sssamuelll/analog-modular-synthesizer/docs/superpowers/specs/2026-10-12-case-suelo-design.md

# El suelo: el case sin tabla

**Fecha**: 2026-10-12 · **Estado**: **firmado el 12-10** (versión 2, después de la junta) en el acta 4 (https://claude.ai/artifact/7PvsQ3aUfGtEdt7jj936kV):
- D-T1: **patas de 10, las de hoy**;
- D-T2: **los tornillos del suelo, desde abajo**;
- el papel: «Arma el plan».

**Implementado el 2026-10-12** en la rama `docs/case-suelo`, del plan
`docs/superpowers/plans/2026-10-12-case-suelo.md`. Las cifras del §3.2 y del §5
son las de la implementación (enmienda al final de cada sección).

**Sucede a**: la D-S4 del papel de la persiana (`2026-10-11-case-persiana-design.md` §8), firmada «quitar» el 11-10 a las 23:00 (ficha `quitar_tabla` del acta 3) ·
**Base**: `main` en `38d2ac4` (12-10): la persiana (#412), sus deudas (#419) y el aire con el plano neutro y la potencia de la v5 (#421) ·
**Se apoya en**:
- `2026-09-05-fuente-v5-ladrillo-design.md`: D-V1, la fuente afuera; §6.3, el suelo abierto; §7, *«No se reabre la cascada»*;
- `2026-09-03-fuente-v4-liston-design.md` §8, que le exige al case *«las dos placas dentro del mismo recinto de acero, porque R lleva 230 V y C lleva los tres tabs contra la pared»*;
- `2026-08-30-techo-macizo-chapas-empotradas`, por la nariz y el talón con su pie sobre la tabla;
- `2026-08-28-costilla-pletina`, por el anillo y sus tres M5 del canto inferior ·
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
