sssamuelll/analog-modular-synthesizer/docs/superpowers/specs/2026-10-11-case-persiana-design.md

# La persiana: el case sin piel, y el costado que respira

**Fecha**: 2026-10-11 · **Estado**: **firmado el 11-10** (versión 2, después de la junta): D-S1 en conversación (*«he decidido C · La persiana»*), y de D-S2 a D-S11 y el papel en el acta, todas en la opción recomendada. **D-S4 en espera**: Samuel la firmó con la nota *«pero ojo, estoy pensando en quitar la tabla, creo que es algo que nos puede beneficiar, que opinas tu?»* (§8). **Implementado el 2026-10-12** en la rama `feat/case-persiana`, del plan `docs/superpowers/plans/2026-10-11-case-persiana.md` (PR #412).
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
