sssamuelll/analog-modular-synthesizer/case/cad/kondor_lattice.png

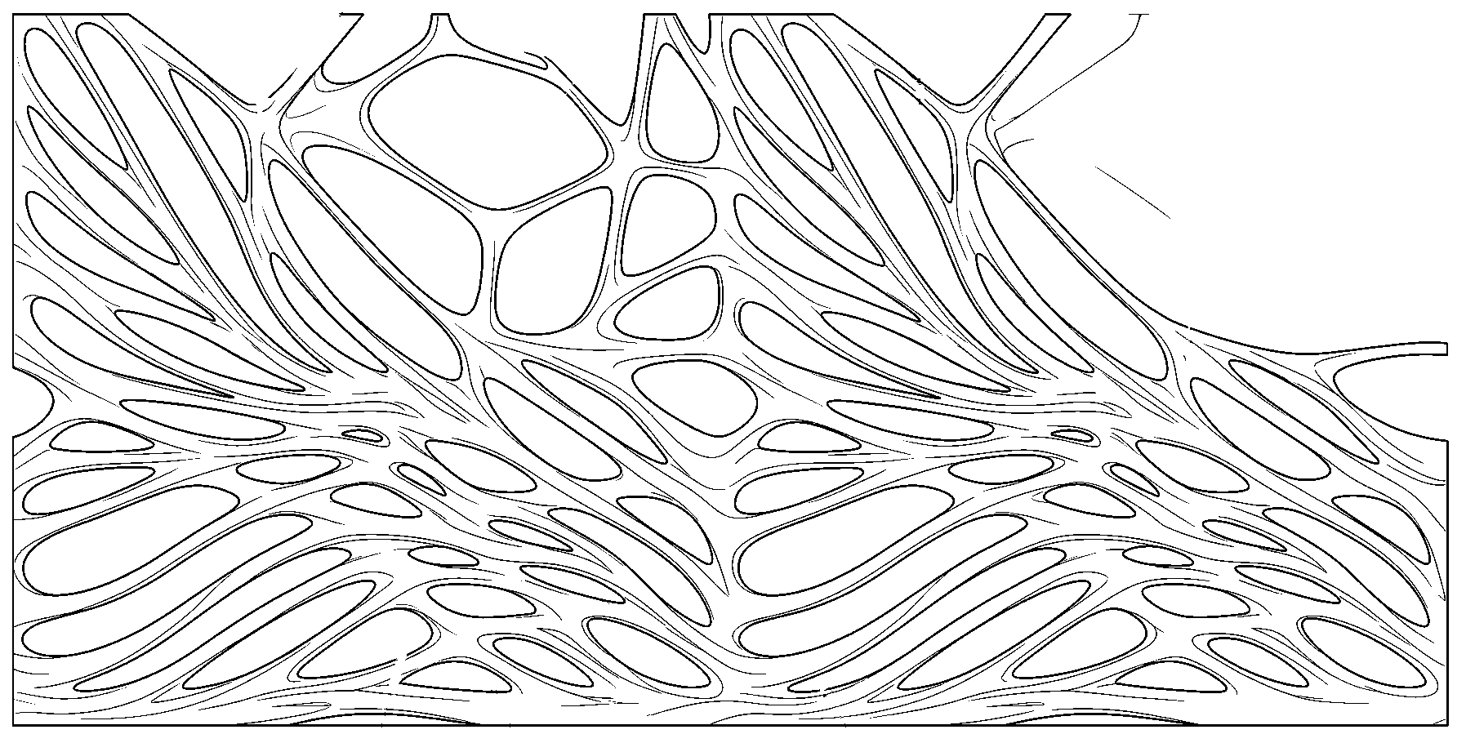
case/cad/kondor_lattice.png
