sssamuelll/analog-modular-synthesizer/case/renders/detalle-lateral.png

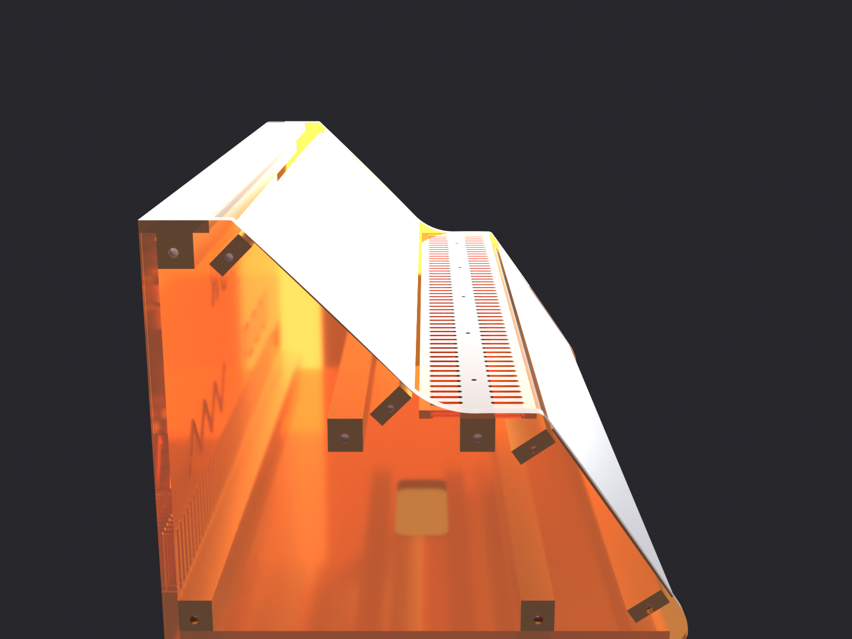
case/renders/detalle-lateral.png
