sssamuelll/analog-modular-synthesizer/case/renders/detalle-trasera-3q-izq.png

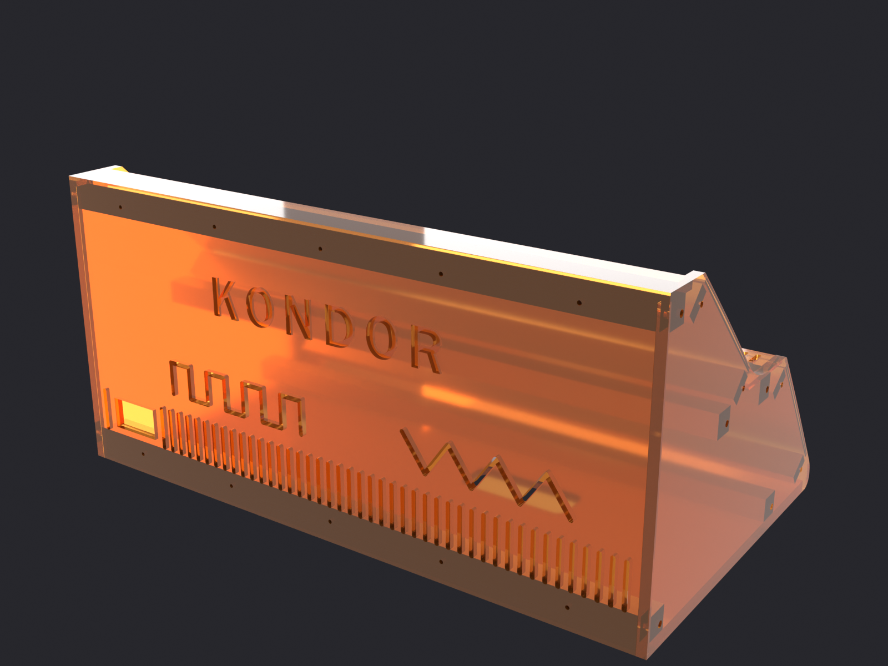
case/renders/detalle-trasera-3q-izq.png
