sssamuelll/analog-modular-synthesizer/case/renders/detalle-trasera-baja.png

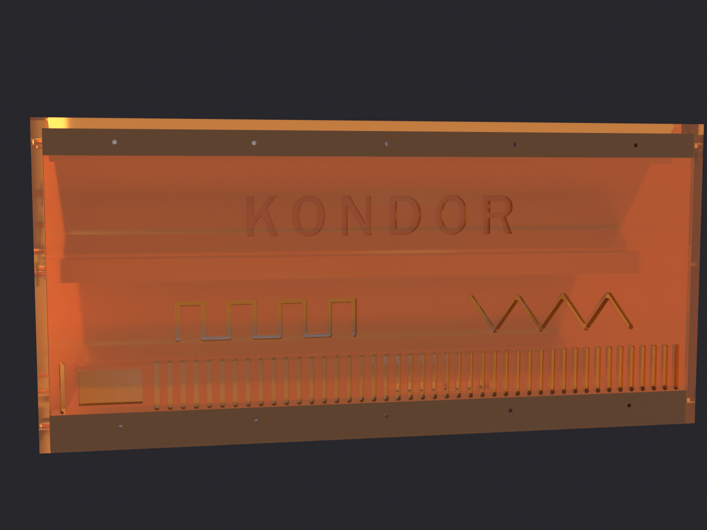
case/renders/detalle-trasera-baja.png
