sssamuelll/analog-modular-synthesizer/case/renders/detalle-trasera-centro.png

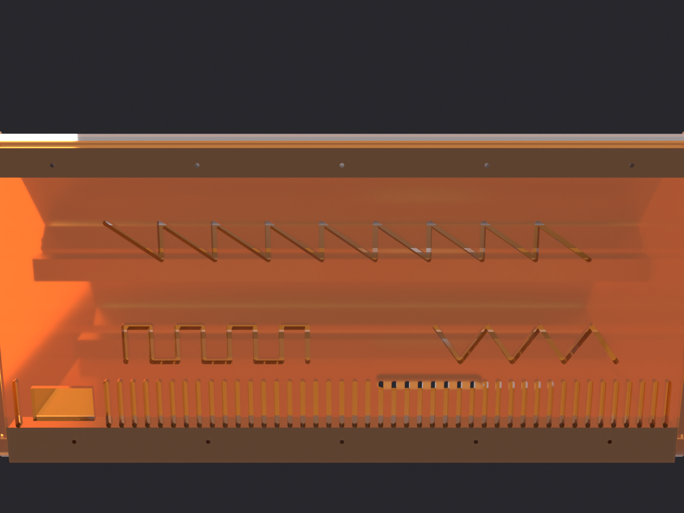
case/renders/detalle-trasera-centro.png
