sssamuelll/analog-modular-synthesizer/case/renders/detalle-trasera-elevada.png

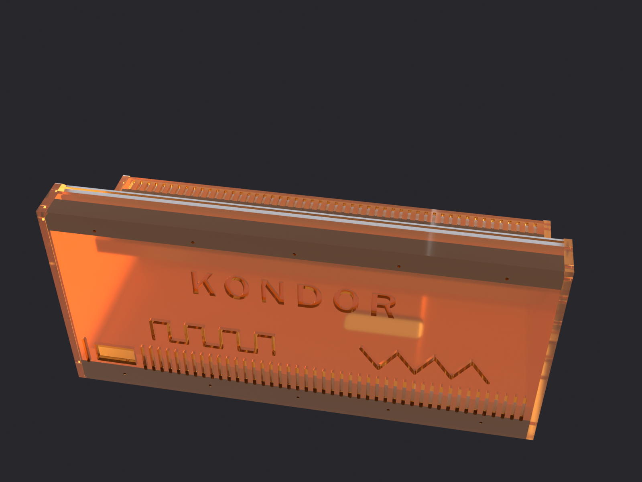
case/renders/detalle-trasera-elevada.png
