sssamuelll/analog-modular-synthesizer/case/renders/propuesta-diseno-2026-08-16.png

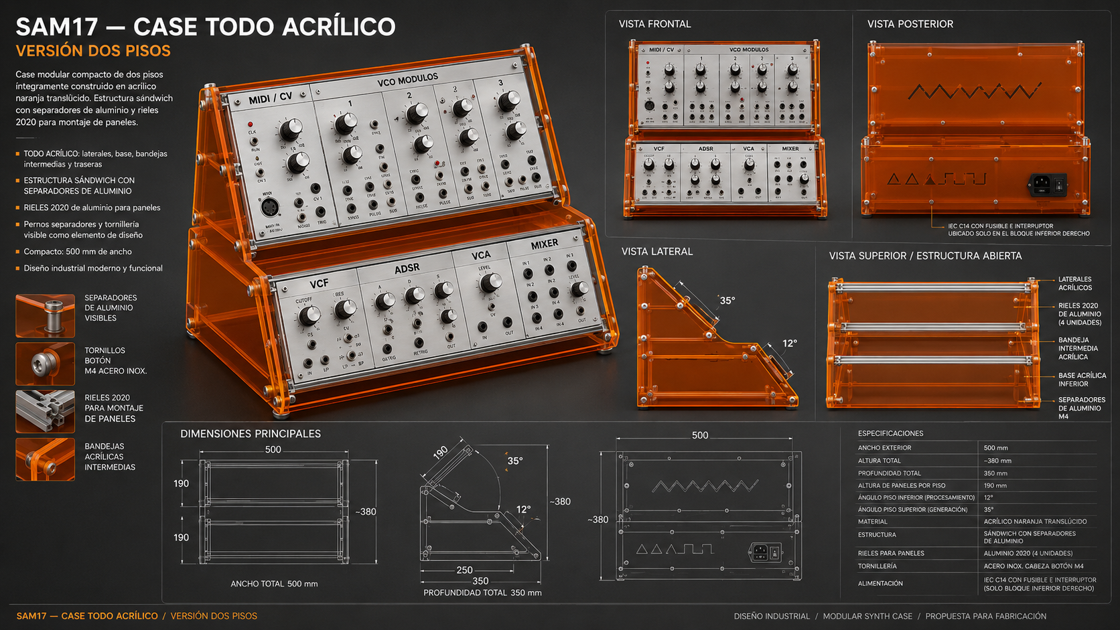
case/renders/propuesta-diseno-2026-08-16.png
