sssamuelll/analog-modular-synthesizer/case/renders/sam17-case-A.png

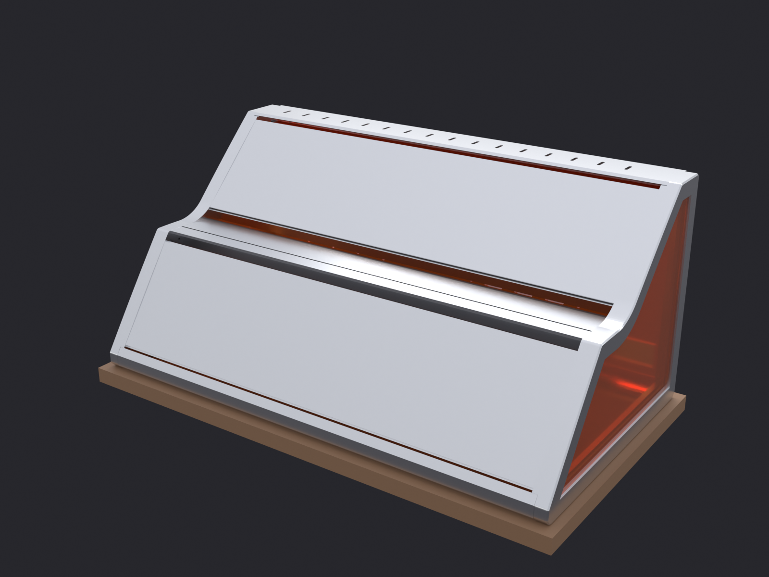
case/renders/sam17-case-A.png
