sssamuelll/analog-modular-synthesizer/case/renders/sam17-case-ahumado-trasera.png

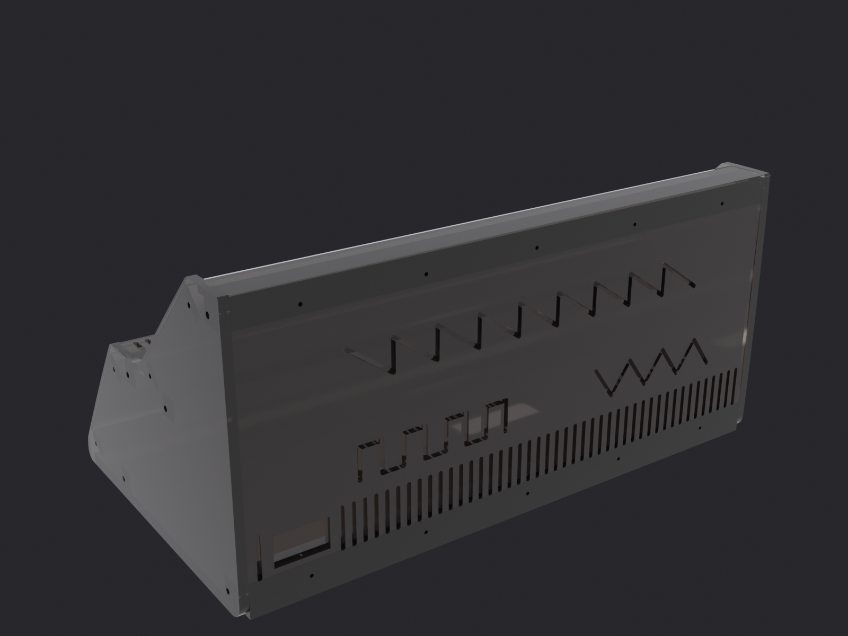
case/renders/sam17-case-ahumado-trasera.png
