sssamuelll/analog-modular-synthesizer/case/renders/sam17-case-ahumado.png

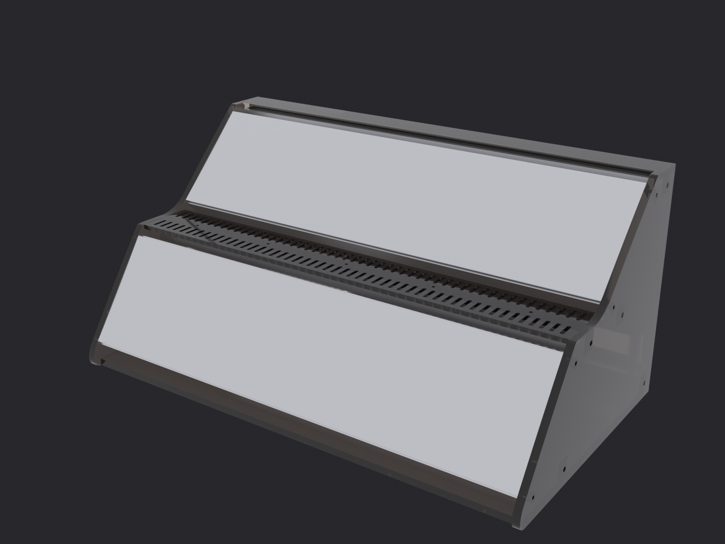
case/renders/sam17-case-ahumado.png
