sssamuelll/analog-modular-synthesizer/case/renders/sam17-case-trasera-A.png

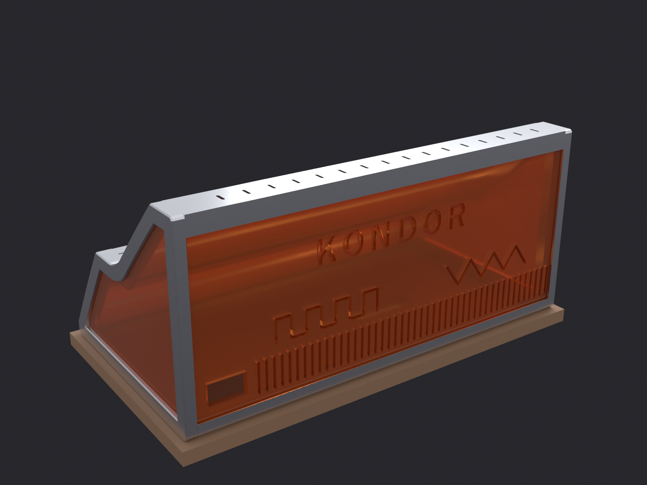
case/renders/sam17-case-trasera-A.png
