sssamuelll/analog-modular-synthesizer/case/renders/sam17-persiana-costado.png

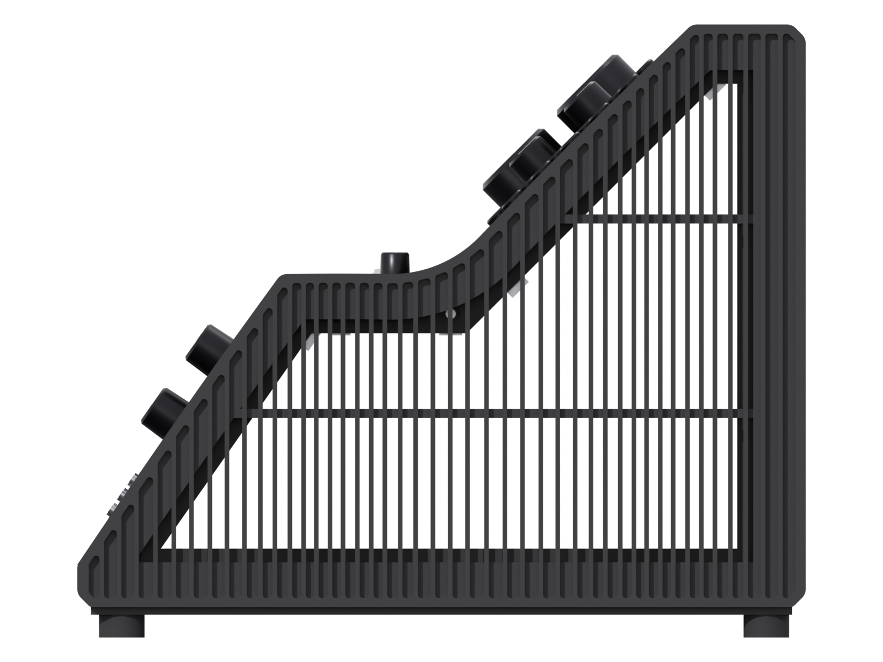
case/renders/sam17-persiana-costado.png
