sssamuelll/analog-modular-synthesizer/case/renders/sam17-persiana-lado.png

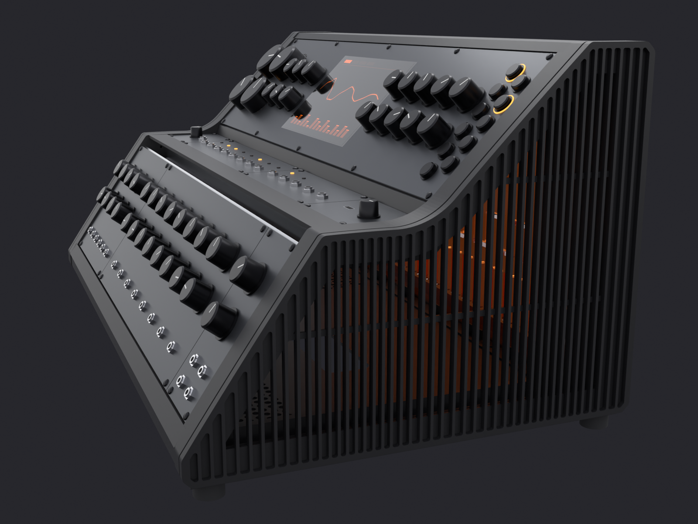
case/renders/sam17-persiana-lado.png
