sssamuelll/analog-modular-synthesizer/case/renders/sam17-persiana-noche.png

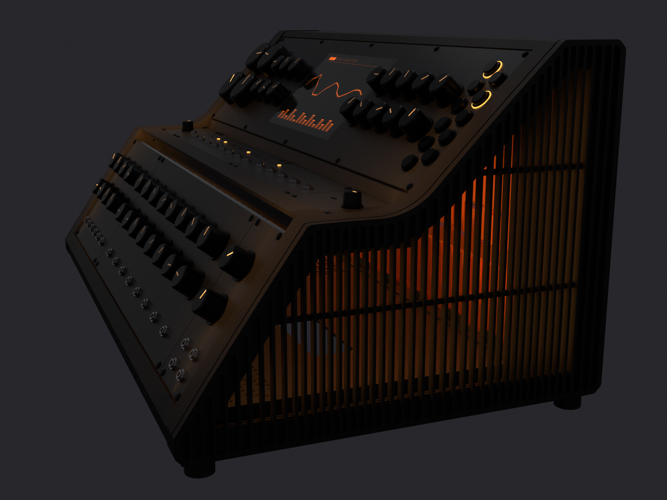
case/renders/sam17-persiana-noche.png
