sssamuelll/analog-modular-synthesizer/case/renders/sam17-persiana-trasera.png

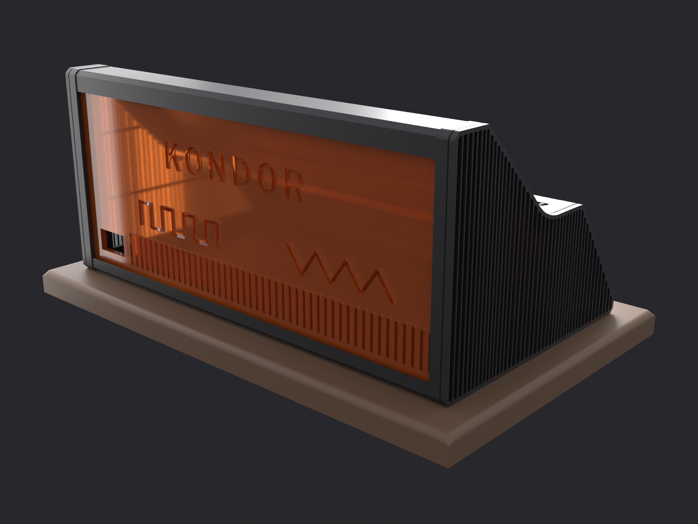
case/renders/sam17-persiana-trasera.png
