sssamuelll/analog-modular-synthesizer/case/renders/sam17-piel-cachete.png

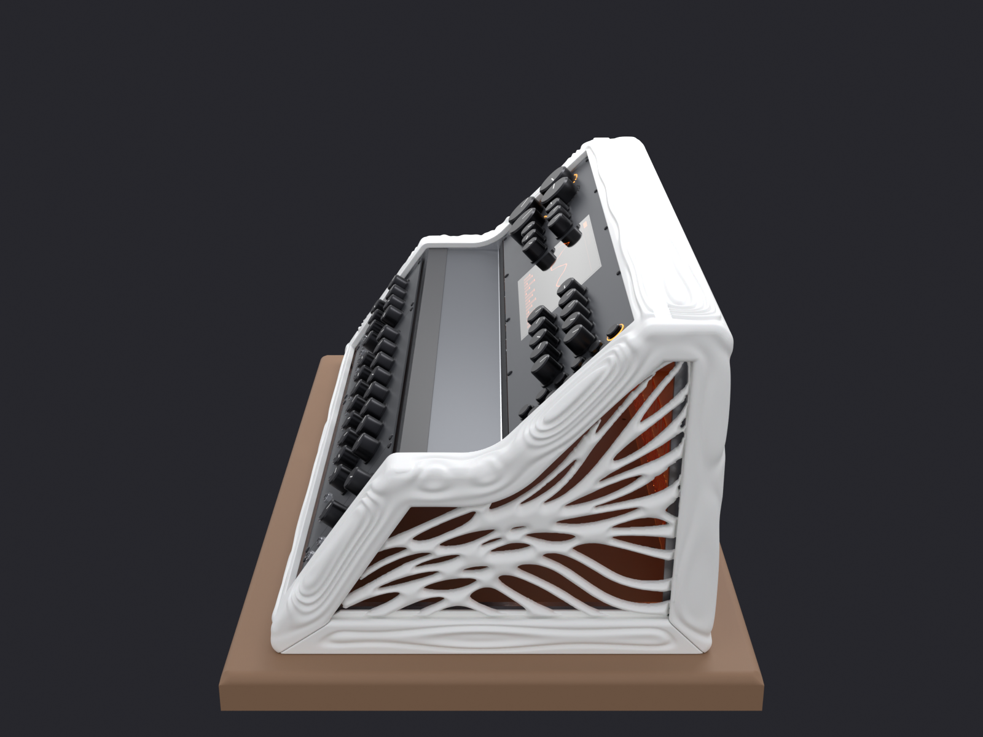
case/renders/sam17-piel-cachete.png
