sssamuelll/analog-modular-synthesizer/case/renders/sam17-piel-lado.png

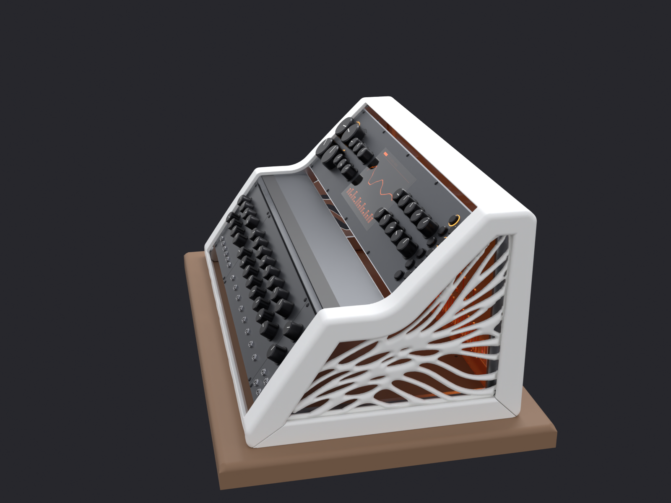
case/renders/sam17-piel-lado.png
