sssamuelll/analog-modular-synthesizer/case/renders/sam17-piel-trasera.png

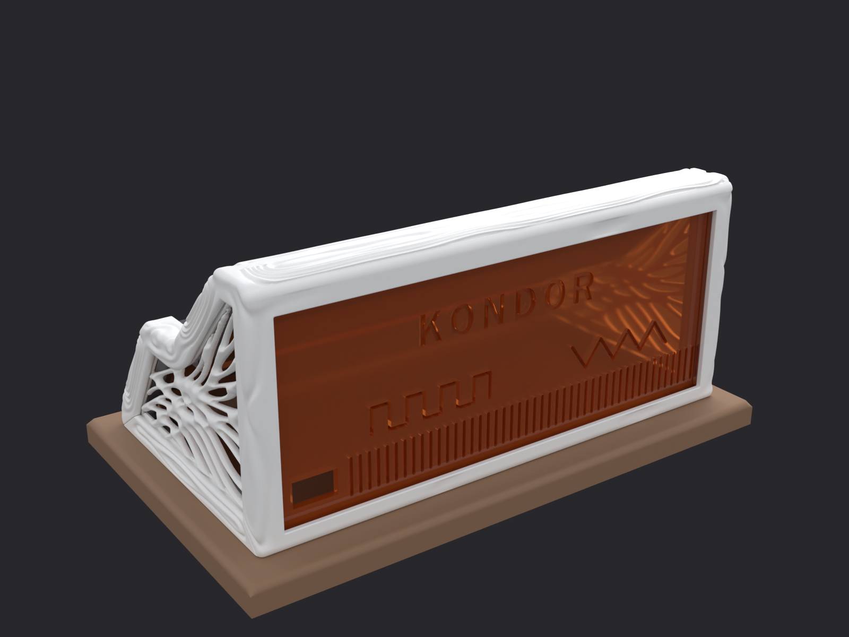
case/renders/sam17-piel-trasera.png
