sssamuelll/analog-modular-synthesizer/case/renders/sam17-piel.png

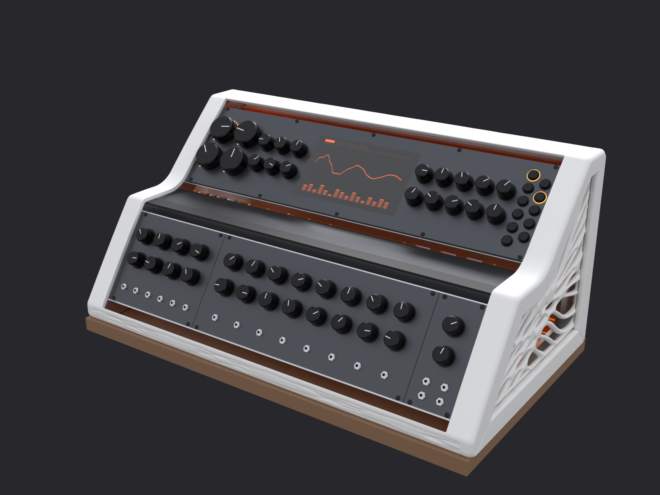
case/renders/sam17-piel.png
