sssamuelll/analog-modular-synthesizer/docs/images/case-piel-organica/concepto-1-ambar.jpg

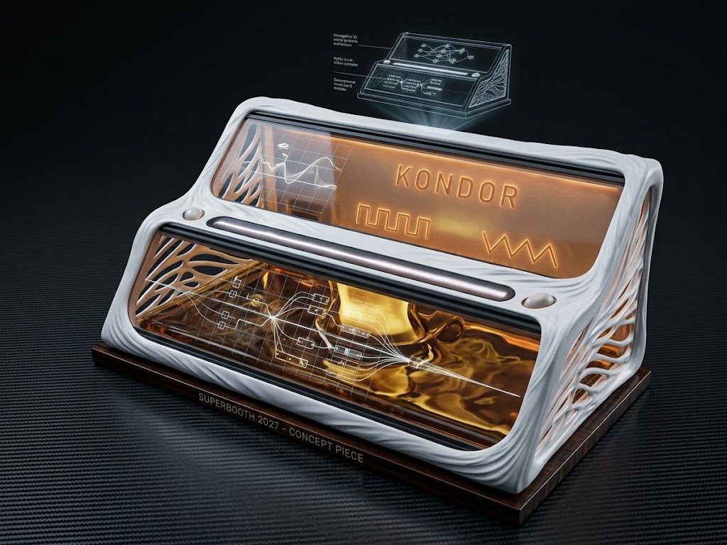
docs/images/case-piel-organica/concepto-1-ambar.jpg
