sssamuelll/analog-modular-synthesizer/docs/images/case-piel-organica/concepto-2-paneles.jpg

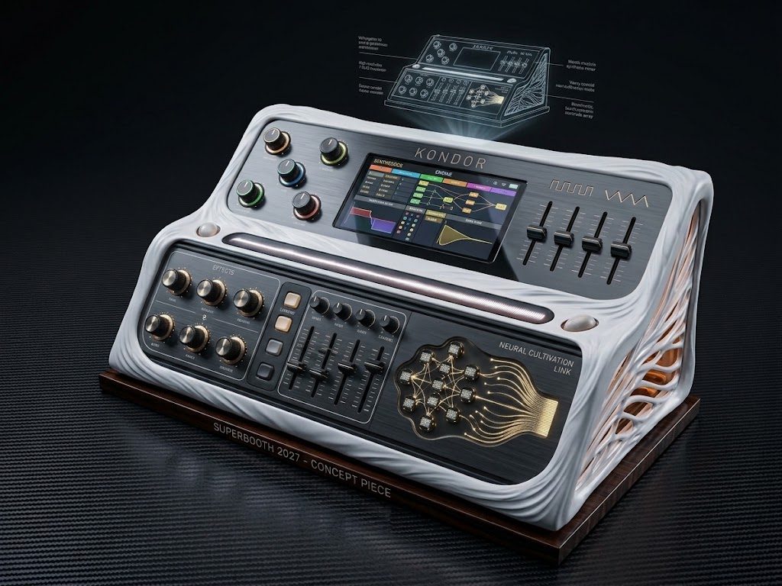
docs/images/case-piel-organica/concepto-2-paneles.jpg
