sssamuelll/analog-modular-synthesizer/docs/images/case-piel-organica/concepto-3-trasera.jpg

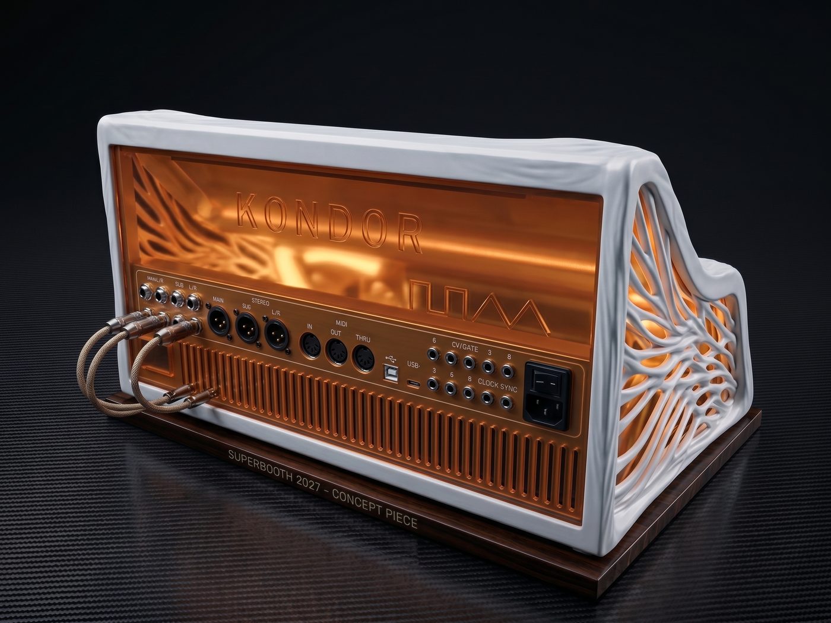
docs/images/case-piel-organica/concepto-3-trasera.jpg
