sssamuelll/analog-modular-synthesizer/docs/images/case-piel-organica/concepto-4-despiece.jpg

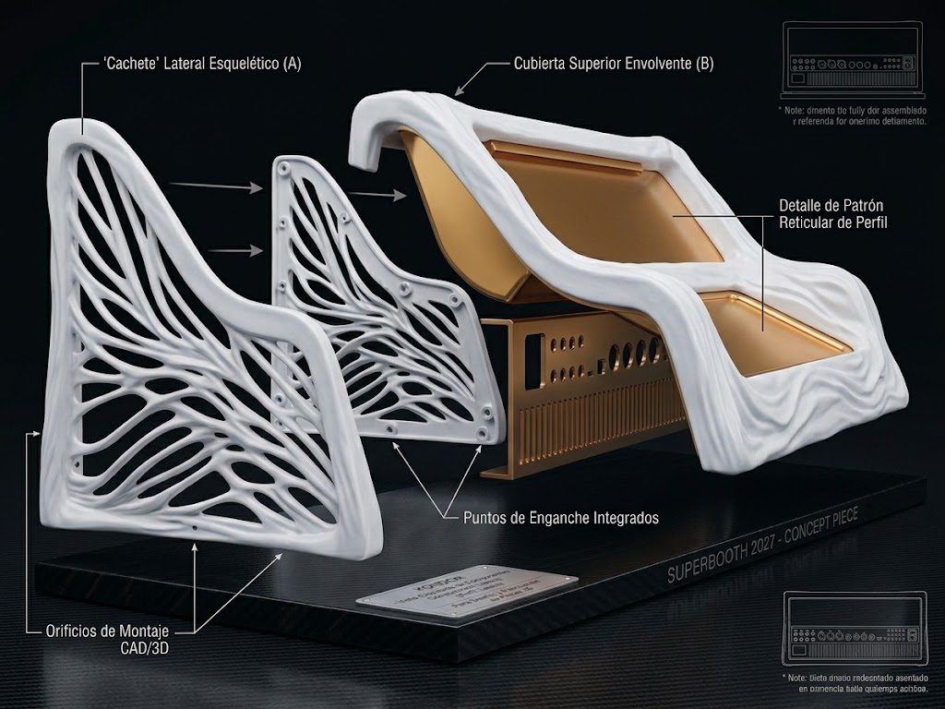
docs/images/case-piel-organica/concepto-4-despiece.jpg
