sssamuelll/analog-modular-synthesizer/docs/images/case-piel-organica/concepto-6-celosia-2d.jpg

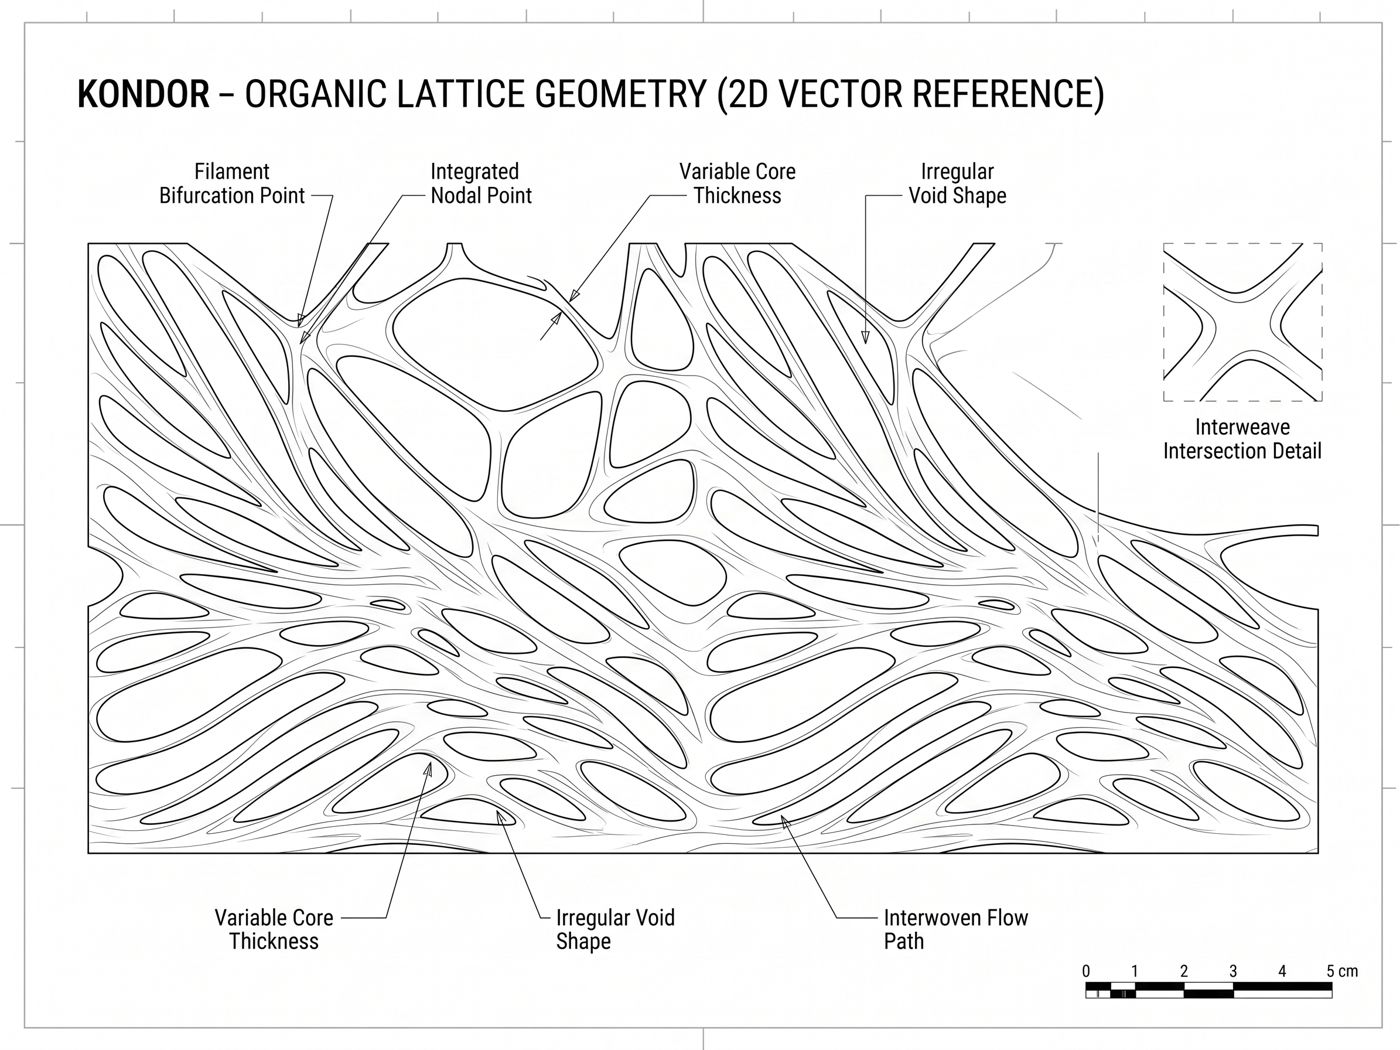
docs/images/case-piel-organica/concepto-6-celosia-2d.jpg
