sssamuelll/analog-modular-synthesizer/hardware/01-power-supply/pcb/sam17-power-3d-iso.png

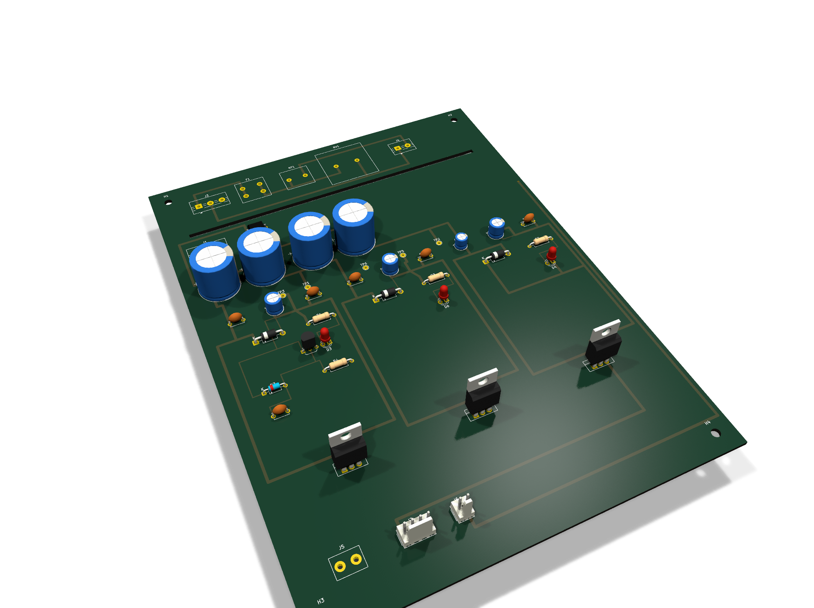
hardware/01-power-supply/pcb/sam17-power-3d-iso.png
