sssamuelll/analog-modular-synthesizer/hardware/03-vco/pcb/sam17-vco-3d-iso.png

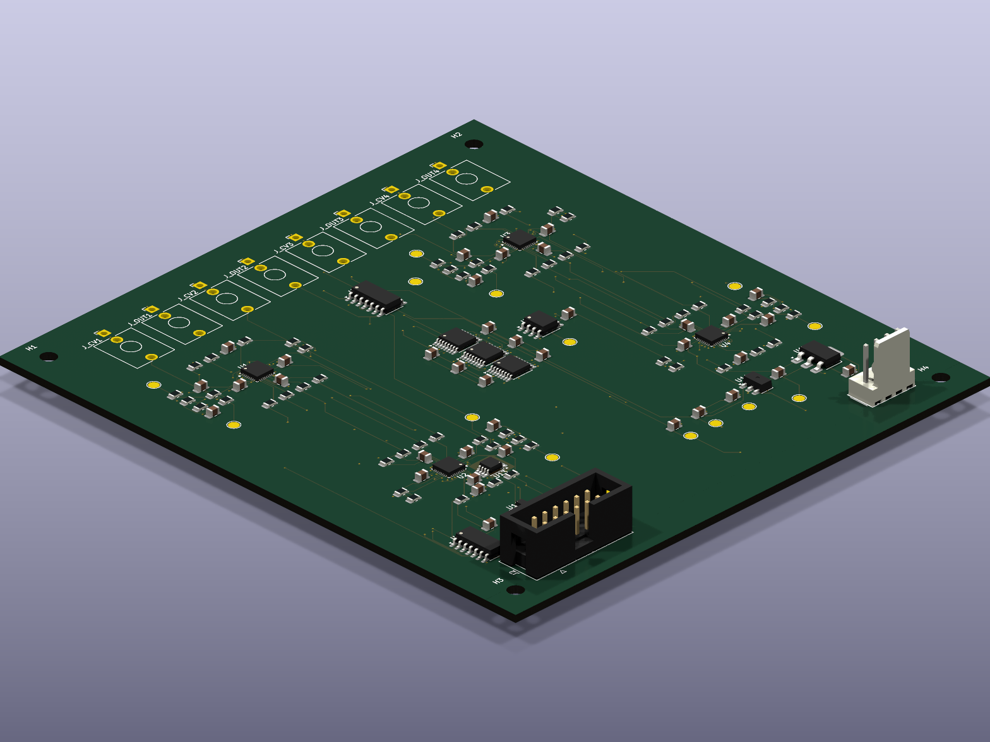
hardware/03-vco/pcb/sam17-vco-3d-iso.png
