sssamuelll/analog-modular-synthesizer/hardware/01-power-supply/v5/absmax.csv

victima | riel | fuente_fallo | v_pico_sin_tope_v | v_pico_con_tope_v | v_absmax_v | protector | hoja_victima | hoja_protector
U1 LT1963A (IN) | crudo +15.5V | THN 20-2413WI OVP (24.6V) o puente 36V | 38.59 | 18.11 | 20.0 | TI TPS26631 antes del LC (<=16.92V 14us) + Bourns SMBJ16A en U1 IN | docs/reference/datasheets/lt1963a-rev-g-2021-02.pdf p.2 | docs/reference/datasheets/tps2663.pdf p.6-8 + docs/reference/datasheets/bourns_smbj.pdf p.2
U2 LT3015 (IN) | crudo -15.5V | THN 20-2413WI OVP (-24.6V) | 24.60 | 24.60 | 33.0 | Margen nativo +-33V + Schottky inverso OUT-IN >= -0.3V | docs/reference/datasheets/lt3015-rev-b.pdf p.2 | docs/reference/datasheets/lt3015-rev-b.pdf p.2 Nota 10
U4,U5 LT3045 (IN) | cascada +13.1V | Fallo doble (THN+ en OVP y U1 en corto) | 24.60 | 18.11 | 22.0 | Tope M3 aguas arriba (TPS26631 + SMBJ16A) | docs/reference/datasheets/lt3045-rev-d.pdf p.2 | docs/reference/datasheets/tps2663.pdf p.6-8
U6,U7 LT3094 (IN) | cascada -12.9V | THN 20-2413WI- en OVP (-24.6V) con U2 regulando | 24.60 | 13.53 | 22.0 | Regulacion de U2 LT3015 (maximo del trim R7+RV3 sobre R8) | docs/reference/datasheets/lt3094-rev-b.pdf p.2 | docs/reference/datasheets/lt3015-rev-b.pdf p.1
U18 TPS709 (IN) | +24V_LDO | Transitorio de entrada recortado por D1 SMBJ26CA (V_C 42.1V) | 42.10 | 26.35 | 32.0 | R64 1k + D2 BZT52C24 (Vz max 25.6V y Zzt 70 ohm a 5 mA) | docs/reference/datasheets/tps709.pdf p.4 | docs/reference/datasheets/bourns_smbj.pdf p.2 + docs/reference/datasheets/diodes_bzt52.pdf p.2
Invitados rack +12V | rack+12 | THN 30-2422WI OVP (16.56V max) | 16.56 | 14.10 | 16.0 | Crowbar D-F6 (TL431BI -> MMBT3906 -> BT151-500R a 13.80V +-0.3V) | electrolitico 16V en modulo invitado | docs/reference/datasheets/nxp-bt151-500r.pdf p.2 + docs/reference/datasheets/tl431.pdf p.5
Invitados rack -12V | rack-12 | THN 30-2422WI OVP (16.56V max) | 16.56 | 14.10 | 16.0 | Crowbar D-F6 (TL431BI -> MMBT3906 -> BT151-500R a 13.80V +-0.3V) | electrolitico 16V en modulo invitado | docs/reference/datasheets/nxp-bt151-500r.pdf p.2 + docs/reference/datasheets/tl431.pdf p.5
Invitados rack +5V | rack+5 | Convertidor +5V rack en fallo | 6.75 | 6.11 | 6.3 | Crowbar D-F6 (TL431BI -> MMBT3906 -> BT151-500R a 5.81V +-0.3V) + Bourns SF-1206F | electrolitico 6.3V en modulo invitado | docs/reference/datasheets/nxp-bt151-500r.pdf p.2 + docs/reference/datasheets/bourns_sf1206f.pdf p.1
Cerebro digital +5V | digital+5 | URB2405YMD-20WR3 OVP (8.0V max) | 8.00 | 5.96 | 6.3 | Crowbar D-F6 digital (TL431BI -> MMBT3906 -> BT151-500R a 5.66V +-0.3V) | entrada 5V modulo 2 (electrolitico 6.3V / buck local) | docs/reference/datasheets/mornsun_urb_ymd20wr3.pdf p.2 + docs/reference/datasheets/tl431.pdf p.5
