sssamuelll/analog-modular-synthesizer/software/nucleo/fw/carga_j2.csv

fecha | firmware | placa | f_cpu_hz | cache | ciclos_por_giro | hilo_libre_permil | ranuras | periodo_us | transporte | regimen_cache | cuerpos_por_giro
2026-10-16 | b9f6d7d | NUCLEO-N657X0-Q | 64000000 | no | 21558 | 198 | 1 | 125 | ejecutor | caliente
2026-10-17 | 4b97dcf | NUCLEO-N657X0-Q | 64000000 | no | 20160 | 685 | 1 | 1000 | ejecutor | caliente
2026-10-17 | 4b97dcf | NUCLEO-N657X0-Q | 64000000 | icache | 16112 | 748 | 1 | 1000 | ejecutor | caliente
2026-10-20 | 1d62576 | NUCLEO-N657X0-Q | 800000000 | icache+dcache-mpu | 2354 |  | 3 | 125 | tic | caliente | 2307
2026-10-20 | 1d62576 | NUCLEO-N657X0-Q | 800000000 | icache+dcache-mpu | 2452 |  | 3 | 125 | tic | fria | 2353
2026-10-20 | 646a97a | NUCLEO-N657X0-Q | 800000000 | icache+dcache-mpu | 2354 |  | 3 | 125 | tic | caliente | 2307
2026-10-20 | 646a97a | NUCLEO-N657X0-Q | 800000000 | icache+dcache-mpu | 2419 |  | 3 | 125 | tic | fria | 2321
2026-10-20 | bba1b35 | NUCLEO-N657X0-Q | 800000000 | icache+dcache-mpu | 2331 |  | 3 | 125 | tic | caliente | 2285
2026-10-20 | bba1b35 | NUCLEO-N657X0-Q | 800000000 | icache+dcache-mpu | 2398 |  | 3 | 125 | tic | fria | 2300
