sssamuelll/analog-modular-synthesizer/case/renders/build/assembly_aluminio.stl

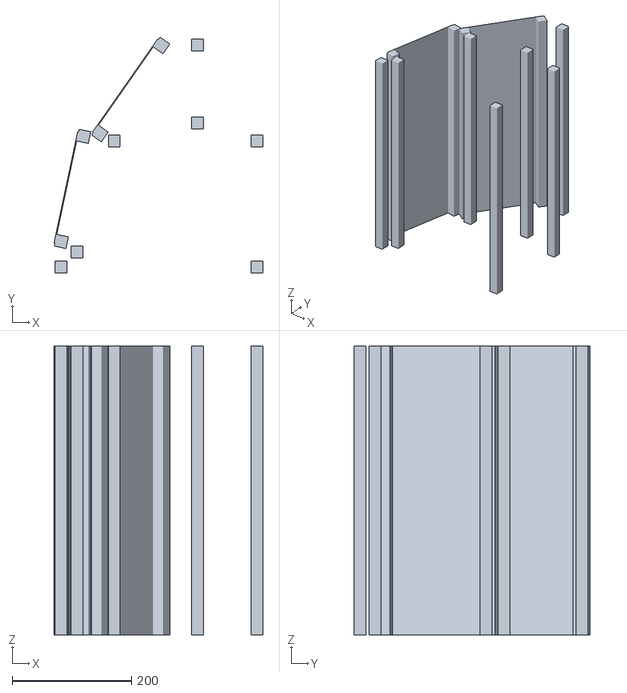
[picture p28: CAD file, 2026-08-16]
case/renders/build/assembly_aluminio.stl
350.0 x 394.7 x 484.0
