sssamuelll/analog-modular-synthesizer/case/plans/bandeja_base_2d.dxf

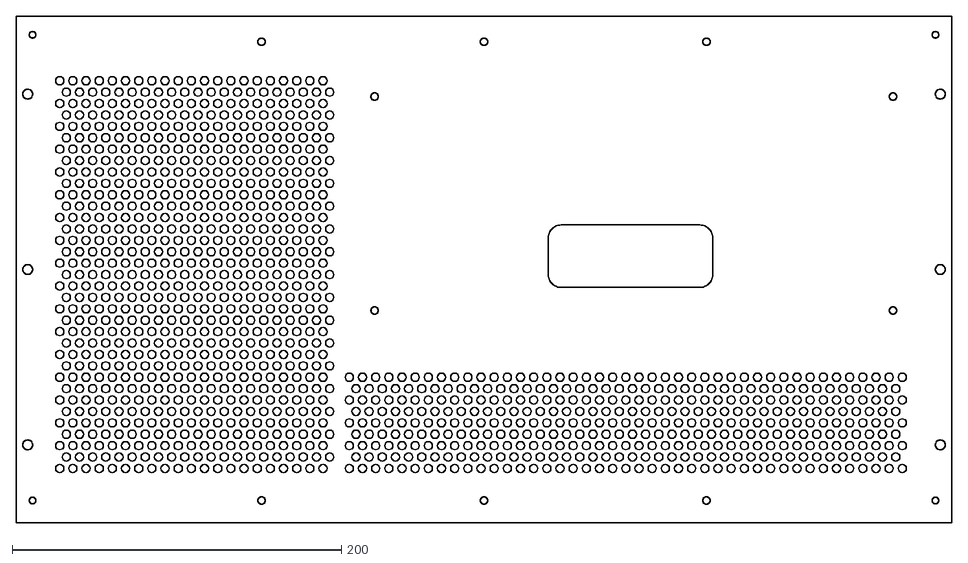
[picture p29: CAD file, 2026-10-12]
case/plans/bandeja_base_2d.dxf
568.6 x 307.8
