sssamuelll/analog-modular-synthesizer/case/plans/marco_ventana_2d.dxf

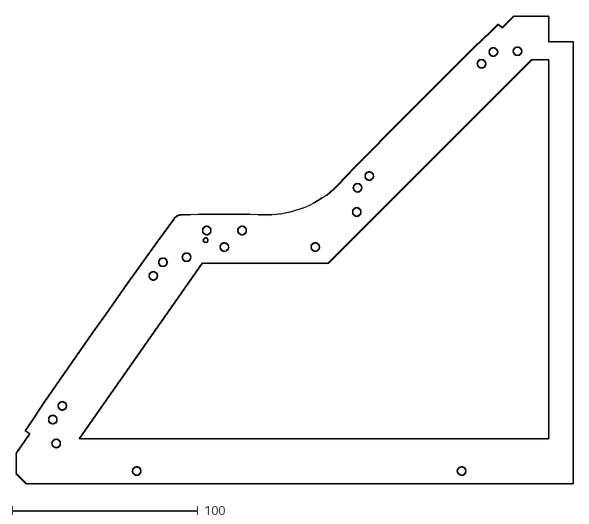
[picture p30: CAD file, 2026-10-12]
case/plans/marco_ventana_2d.dxf
300.1 x 251.9
