sssamuelll/analog-modular-synthesizer/case/plans/persiana_2d.dxf

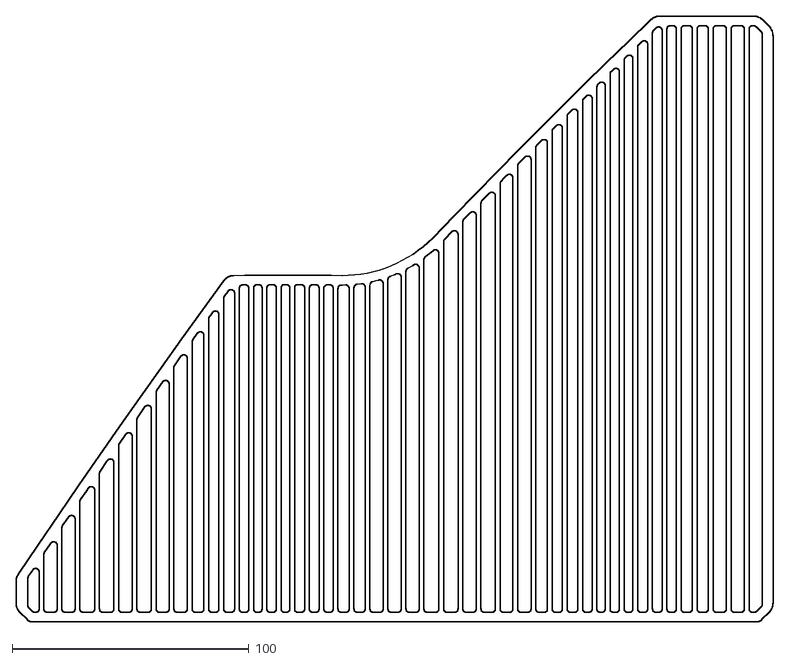
[picture p31: CAD file, 2026-10-12]
case/plans/persiana_2d.dxf
319.8 x 255.9
