sssamuelll/analog-modular-synthesizer/case/plans/costilla_dorso_2d.dxf

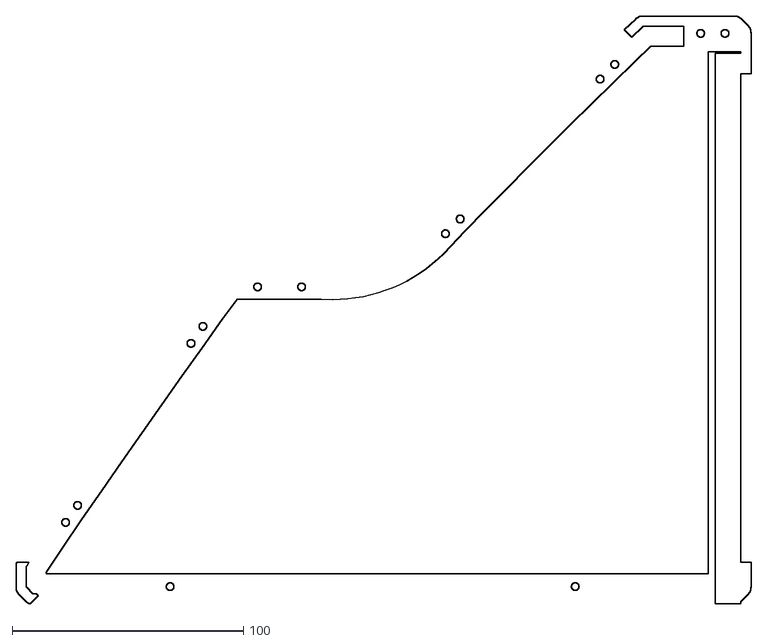
[picture p32: CAD file, 2026-10-12]
case/plans/costilla_dorso_2d.dxf
317.8 x 254.2
