sssamuelll/analog-modular-synthesizer/case/plans/persiana_dorso_2d.dxf

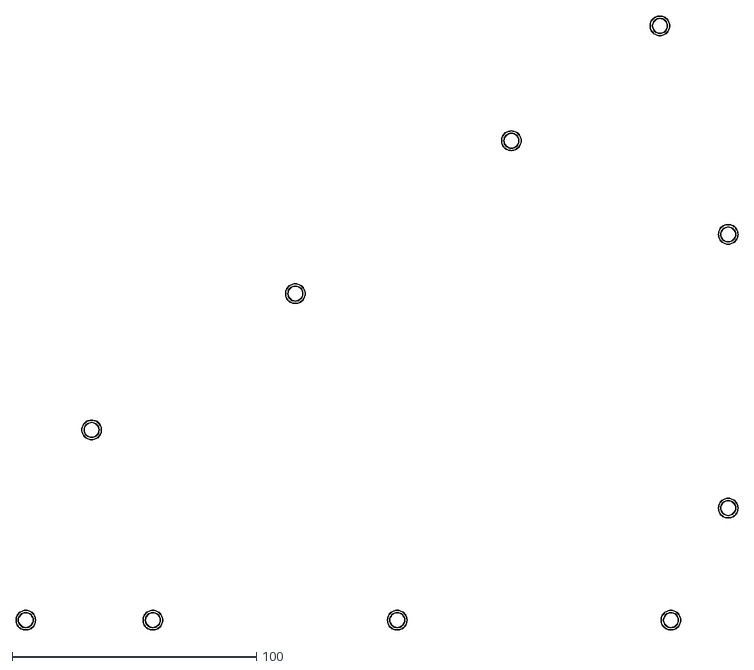
[picture p33: CAD file, 2026-10-12]
case/plans/persiana_dorso_2d.dxf
295.4 x 251.2
