sssamuelll/analog-modular-synthesizer/case/plans/nariz_2d.dxf

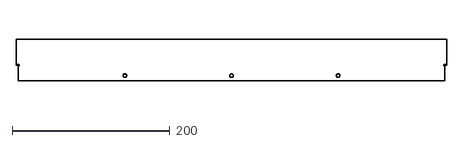
[picture p34: CAD file, 2026-10-12]
case/plans/nariz_2d.dxf
545.6 x 53.1
