sssamuelll/analog-modular-synthesizer/case/plans/miembro_alto_2d.dxf

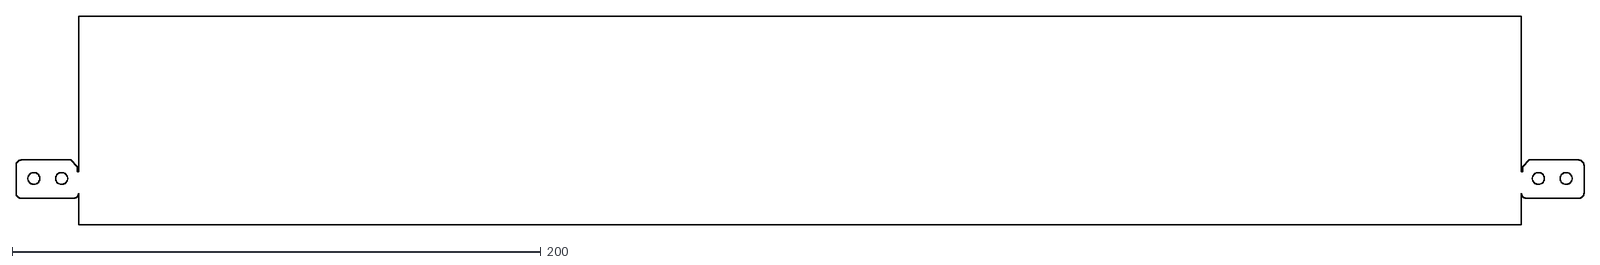
[picture p35: CAD file, 2026-10-12]
case/plans/miembro_alto_2d.dxf
593.0 x 78.9
