sssamuelll/analog-modular-synthesizer/case/plans/tapa_valle_2d.dxf

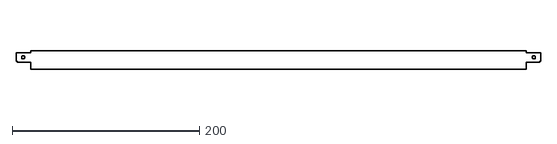
[picture p36: CAD file, 2026-09-01]
case/plans/tapa_valle_2d.dxf
560.0 x 20.0
