sssamuelll/analog-modular-synthesizer/case/plans/costado_2d.dxf

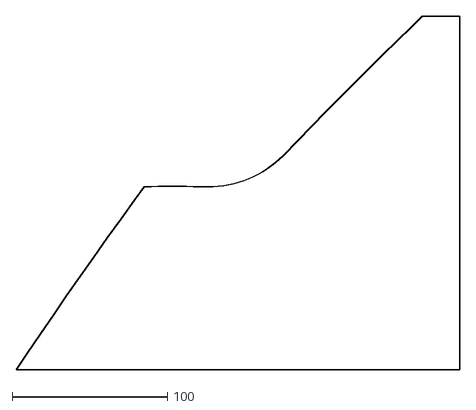
[picture p37: CAD file, 2026-09-01]
case/plans/costado_2d.dxf
285.3 x 227.2
