sssamuelll/analog-modular-synthesizer/case/plans/piel_trasera_2d.dxf

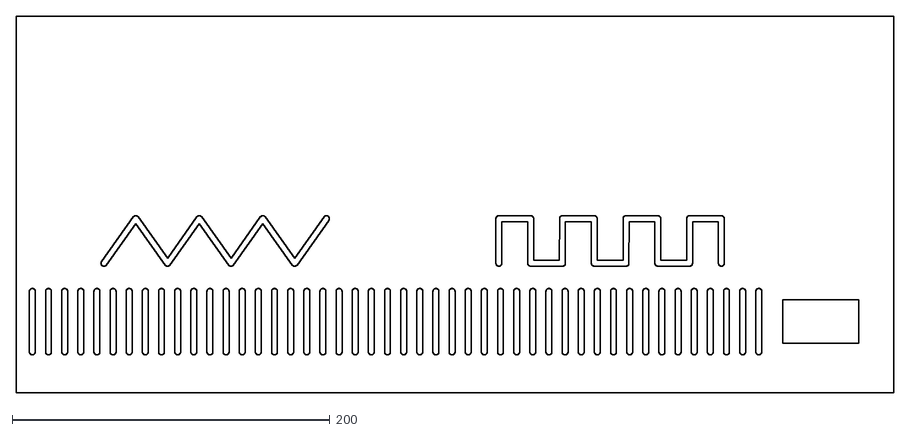
[picture p38: CAD file, 2026-08-31]
case/plans/piel_trasera_2d.dxf
552.3 x 237.2
