sssamuelll/analog-modular-synthesizer/case/plans/costilla_2d.dxf

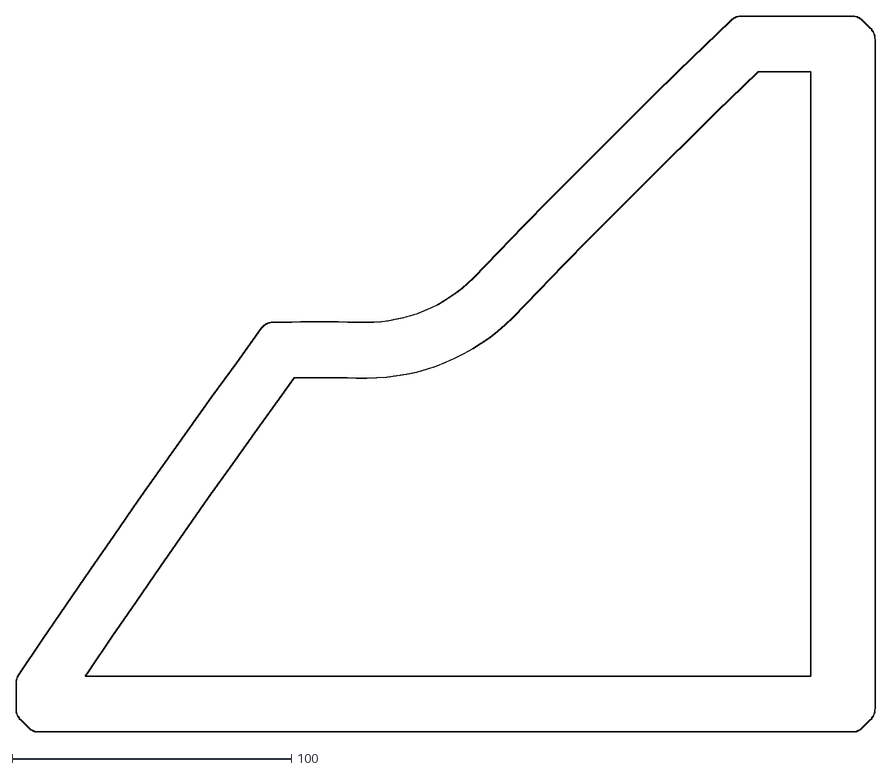
[picture p39: CAD file, 2026-08-31]
case/plans/costilla_2d.dxf
307.4 x 256.2
