sssamuelll/analog-modular-synthesizer/case/plans/kondor_cajeado_2d.dxf

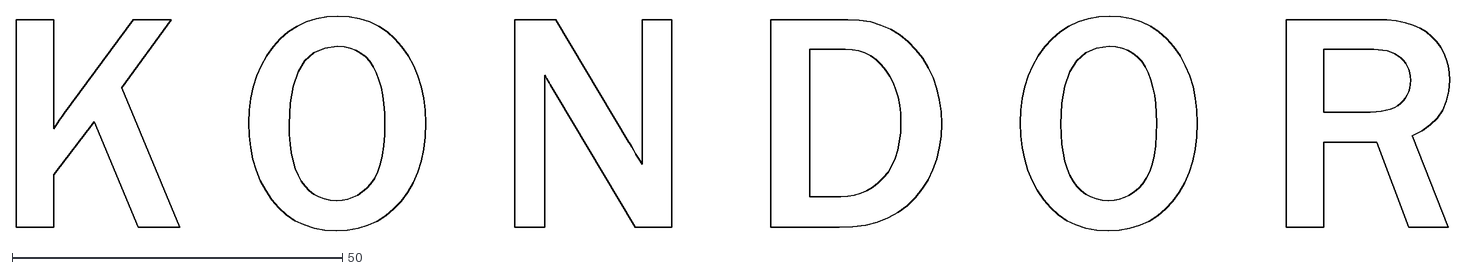
[picture p40: CAD file, 2026-08-30]
case/plans/kondor_cajeado_2d.dxf
216.9 x 32.4
