sssamuelll/analog-modular-synthesizer/case/plans/placa_cara_sup_2d.dxf

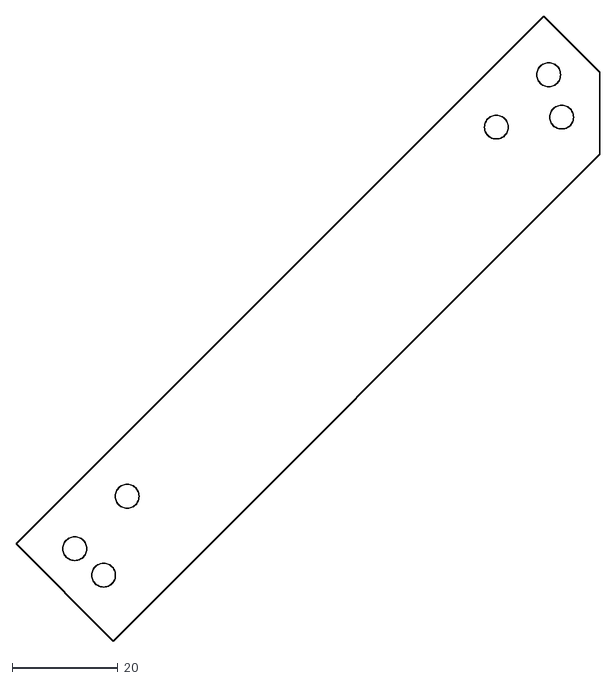
[picture p41: CAD file, 2026-08-29]
case/plans/placa_cara_sup_2d.dxf
110.4 x 118.2
