sssamuelll/analog-modular-synthesizer/case/plans/miembro_bajo_2d.dxf

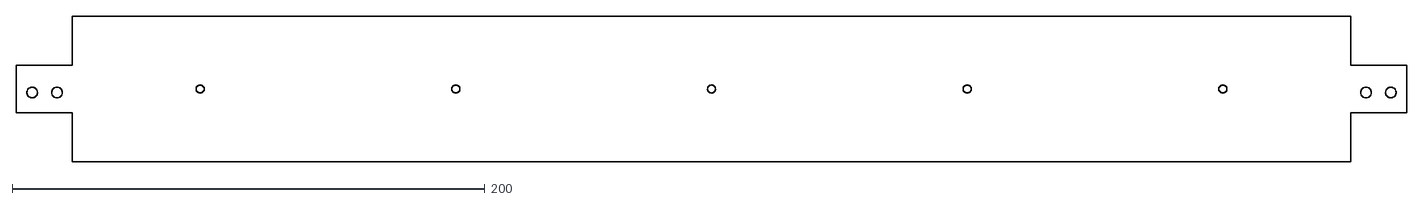
[picture p42: CAD file, 2026-08-29]
case/plans/miembro_bajo_2d.dxf
588.0 x 61.4
