sssamuelll/analog-modular-synthesizer/case/plans/escuadra_trasera_2d.dxf

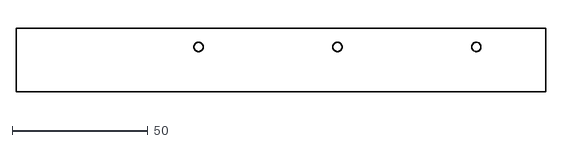
[picture p43: CAD file, 2026-08-29]
case/plans/escuadra_trasera_2d.dxf
194.7 x 23.2
