sssamuelll/analog-modular-synthesizer/case/plans/marco_trasera_sup_2d.dxf

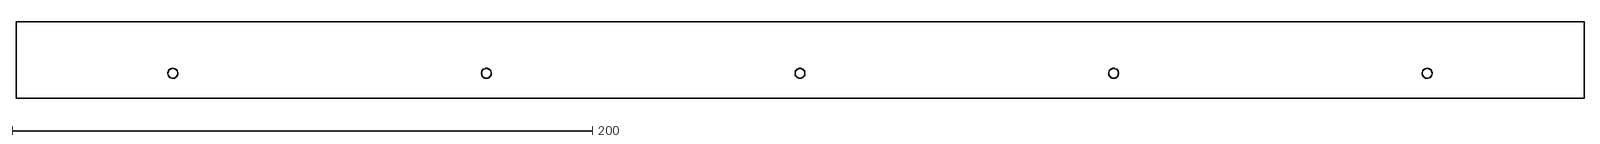
[picture p44: CAD file, 2026-08-29]
case/plans/marco_trasera_sup_2d.dxf
540.3 x 26.2
