sssamuelll/analog-modular-synthesizer/case/plans/chasis_cuerpo_2d.dxf

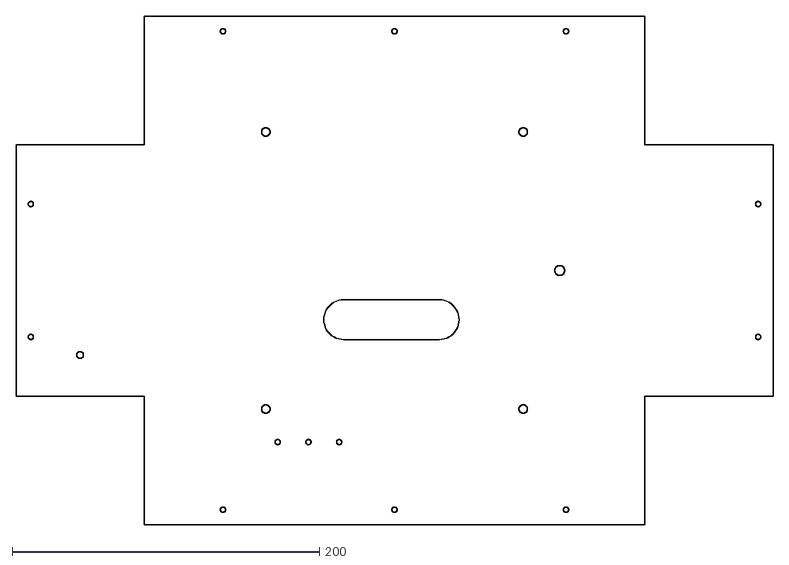
[picture p45: CAD file, 2026-08-21]
case/plans/chasis_cuerpo_2d.dxf
492.7 x 330.7
