sssamuelll/analog-modular-synthesizer/case/plans/chasis_tapa_2d.dxf

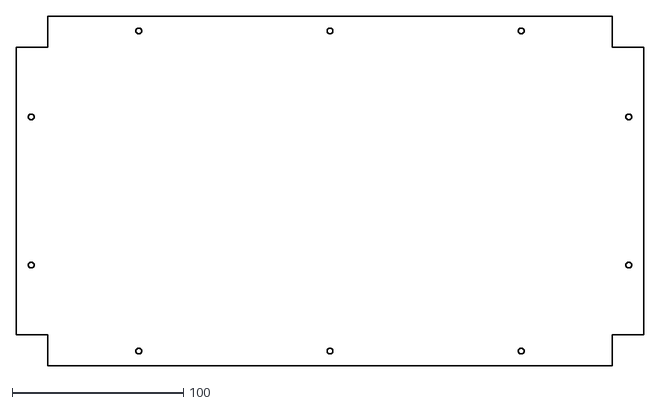
[picture p46: CAD file, 2026-08-19]
case/plans/chasis_tapa_2d.dxf
366.3 x 204.3
