sssamuelll/analog-modular-synthesizer/case/plans/piel_inferior_2d.dxf

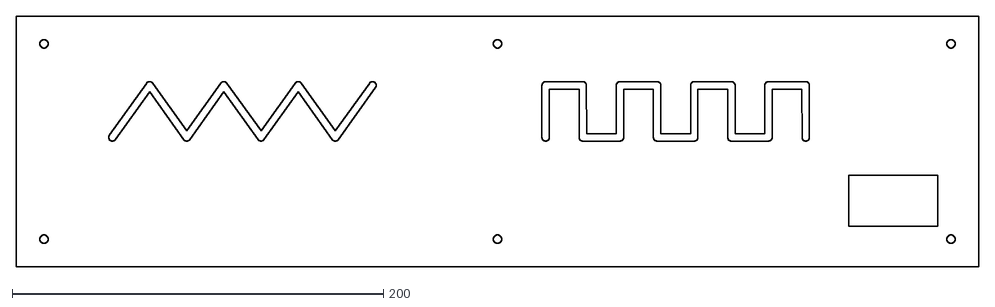
[picture p47: CAD file, 2026-08-18]
case/plans/piel_inferior_2d.dxf
518.3 x 135.1
