sssamuelll/analog-modular-synthesizer/case/plans/remate_sup_2d.dxf

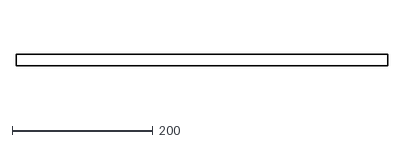
[picture p48: CAD file, 2026-08-18]
case/plans/remate_sup_2d.dxf
528.3 x 16.0
