sssamuelll/analog-modular-synthesizer/case/plans/bandeja_entrepiso_2d.dxf

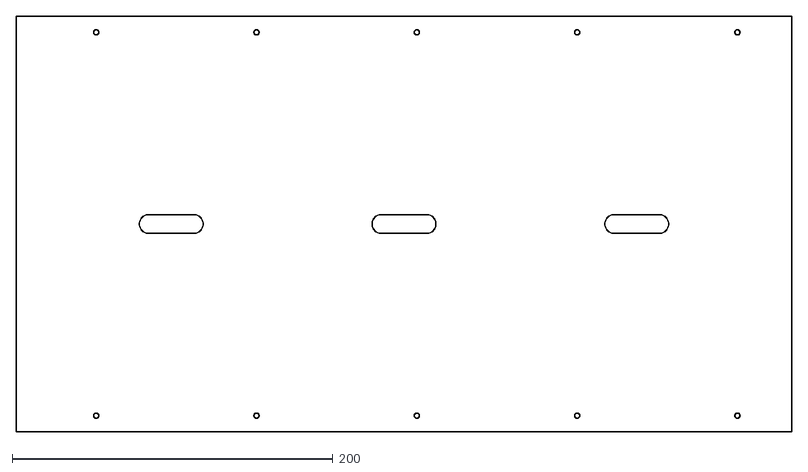
[picture p49: CAD file, 2026-08-16]
case/plans/bandeja_entrepiso_2d.dxf
484.0 x 259.1
