sssamuelll/analog-modular-synthesizer/case/plans/zocalo_2d.dxf

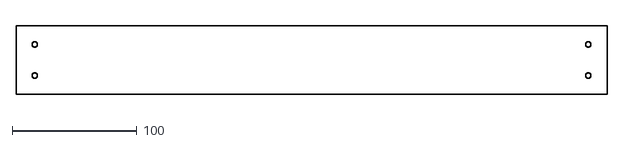
[picture p50: CAD file, 2026-08-16]
case/plans/zocalo_2d.dxf
474.0 x 55.0
