sssamuelll/analog-modular-synthesizer/case/plans/lienzo_2d.dxf

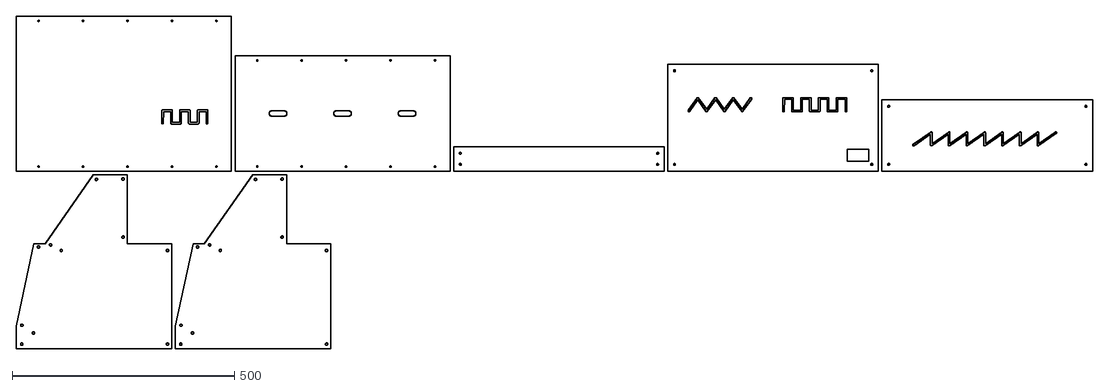
[picture p51: CAD file, 2026-08-16]
case/plans/lienzo_2d.dxf
2422.0 x 747.5
