sssamuelll/analog-modular-synthesizer/case/cad/piezas.scad

// Cada pieza del case por separado y con su NOMBRE, para el .blend de
// identificacion (renders/piezas.py). Samuel senala una pieza en Blender, lee su
// nombre en el Outliner y ese nombre es el del repo -- se acabo adivinar de que
// pieza habla una captura.
//
//   openscad -o build/piezas/<nombre>.stl -D 'PIEZA="<nombre>"' piezas.scad
//
// No es un artefacto de fabricacion: no lo exporta export.ps1 ni lo lee ninguna
// puerta. Los nombres son los de los modulos de sam17_case.scad.
include <params.scad>
use <sam17_case.scad>
PIEZA = "anillos";
au = ancho_total - 2*t_anillo;             // gemela de ancho_util (use<> no la exporta)

module rieles_3u() {
    cr = centros_rail();
    angs = [angulo_inferior, angulo_inferior, angulo_superior, angulo_superior];
    for (i = [0 : 3])
        translate([cr[i].x, cr[i].y, ancho_total/2])
            rotate([0, 0, -angs[i]]) rotate([90, 0, 0]) rail_er(au - 2*t_placa);
}
module rieles_1u() {
    for (c = centros_rail_1u())
        translate([c.x, c.y, ancho_total/2])
            rotate([0, 0, -90]) rotate([90, 0, 0]) rail_er(au - 2*t_placa);
}

if      (PIEZA == "anillos")           costillas();
else if (PIEZA == "rieles_3u")         rieles_3u();
else if (PIEZA == "rieles_1u")         rieles_1u();
else if (PIEZA == "paneles")           paneles();
else if (PIEZA == "placas_riel")       placas_riel();
else if (PIEZA == "clips_costado")     clips_costado();
else if (PIEZA == "escuadras_trasera") escuadras_trasera();
else if (PIEZA == "marcos_trasera")    marcos_trasera();
else if (PIEZA == "nariz")             nariz();
else if (PIEZA == "miembro_bajo")      miembro_bajo();
else if (PIEZA == "miembro_alto")      miembro_alto();
else if (PIEZA == "tapa_valle")        tapa_valle();
else if (PIEZA == "costados")          costados();
else if (PIEZA == "piel_trasera")      piel_trasera();
else if (PIEZA == "tabla")             bandeja_base();
else if (PIEZA == "paticas")           paticas();
else if (PIEZA == "chasis")            chasis();
else assert(false, str("PIEZA desconocida: ", PIEZA));
