sssamuelll/analog-modular-synthesizer/case/cad/sam17_case.scad

// sam17_case.scad — la consola del SAM17: anillos de aluminio, una persiana
// por costado y la trasera de acrilico (spec rev. 3 y la del 2026-10-11).
// Fuente de verdad dimensional: params.scad. Este fichero DIBUJA;
// clearance_budget.py DECIDE. Angulos desde la vertical.
//
//   openscad -o out.stl -D 'PART="assembly_persiana"' sam17_case.scad
//   openscad -o out.dxf -D 'PART="costilla_2d"'       sam17_case.scad

include <params.scad>
include <persiana_generada.scad>
PART = "assembly";
// $fn vive en params.scad: asi lo hereda TODO .scad que incluya params.
// Tenerlo aqui fue el bug del cupon pentagonal (ver nota en params.scad).

// ancho interior entre costados; Tasks 4-5 lo consumen como ancho_util.
// EL HUECO ENTRE COSTILLAS, no entre acrilicos, desde el 2026-08-26. Todo lo
// que vive dentro del case -- largueros, rieles, planchas -- va de cara interna
// a cara interna, y esas caras dejaron de ser el acrilico: son el ala de la
// costilla, que se le monta encima. Restar solo t_cheek dejaria 2*t_costilla de
// hueco fantasma y las planchas crecerian 6.3 mm para llenar un sitio ocupado.
//
// Y SE USA ESTA VARIABLE, no la resta a mano. Estuvo repetida en nueve sitios
// de este fichero, y con dos terminos la copia se desincroniza del original al
// primer cambio -- que es como esta cota llego a existir sin que nadie la
// mirara.
// LO QUE SE RESTA CAMBIO TRES VECES: el acrilico y la costilla hasta el
// 2026-08-27; el CASQUILLO y la costilla desde ese dia -- con el marco por
// fuera era el casquillo el que fijaba el hueco entre marco y riel --; y desde
// el 2026-08-28 SOLO EL ANILLO. El acrilico ya no aparece porque va DENTRO de
// la ventana: la pared del anillo es la unica pieza entre este hueco y el
// exterior.
//
// LA PLACA DE ANCLAJE SI ESTA DENTRO de este hueco, y por eso no se resta
// aqui: el riel mide ancho_util - 2*t_placa y muere contra ella.
//
// GEMELA de perfil()['ancho_util'] en clearance_budget.py -- si las dos se
// separan, la rejilla de agujeros del DXF se corre y lo canta
// agujeros_donde_toca().
ancho_util = ancho_total - 2*t_anillo;

// Las cotas visibles cuelgan de primitivas para que el empotramiento se mueva entero.
function rehundido_trasera() =
    rehundido_chapa + t_costilla + aire_labios - t_junta_asiento;
function ancho_bolsillo_trasera() = t_anillo - rehundido_acrilico;
function pared_trasera_u() = rehundido_trasera() + ancho_bolsillo_trasera();
function cara_anillo_trasera() =
    pared_trasera_u() + pared_rebaje_trasera + entrada_costado_trasero;
function radio_borde() = radio_chapa + rehundido_chapa;
function pie_z0() = t_anillo + hol_piel;
function muesca_pie() = rebaje_chapa - hol_chapa + hol_piel;
function chapa_z0() = pie_z0() - muesca_pie();
function chapa_largo_rebaje() = ancho_total - 2*chapa_z0();
function cajeado_brida_largo() = brida_largo + 2*hol_chapa;
function cajeado_brida_ancho() = brida_ancho + 2*hol_chapa;
function radio_cajeado_brida() = fresa_d/2;

// vertices del perfil lateral (X = fondo, Y = arriba) — misma numeracion
// que clearance_budget.perfil(): p0..p8
// Fondo del case. DERIVADO, no parametro: es la proyeccion de la hipotenusa
// mas el marco de remate (ver la nota larga en params.scad). Se calcula sin
// llamar a pts_perfil para no morderse la cola.
function fondo() = alto_cara_inf*sin(angulo_inferior) + paso_horizontal
                 + alto_cara_sup*sin(angulo_superior) + marco_remate;

function pts_perfil() =
    let (si = sin(angulo_inferior), ci = cos(angulo_inferior),
         ss = sin(angulo_superior), cs = cos(angulo_superior),
         ye = alto_frontal + alto_cara_inf*ci,        // y entrepiso
         x2 = alto_cara_inf*si,                       // fin cara inferior
         x3 = x2 + paso_horizontal,
         x4 = x3 + alto_cara_sup*ss,
         yt = ye + alto_cara_sup*cs,                  // alto total
         pf = fondo())
    [[0,0],[0,alto_frontal],[x2,ye],[x3,ye],[x4,yt],
     [pf,yt],[pf,0]];
// 7 puntos, no 9: el canto trasero es UN plano a plomo de toda la altura.
// La version anterior metia p5..p7 en una repisa escalonada entre
// prof_superior=250 y prof_inferior=350, y esa repisa era la que rompia la
// lectura de triangulo. Al colapsarla, p5=(fondo,yt) y p6=(fondo,0), o sea
// que el ANTIGUO P[8] (esquina trasera baja) es ahora P[6] -- ojo al leer
// codigo viejo. x4 = fin de la cara superior; de x4 a fondo() queda el
// marco de remate.

// puntos medios de riel por cara: centros sobre la cara a sus dos insets,
// retirados hacia dentro t_panel + rail_er_eje segun la normal.
//
// Los DOS insets de cada cara son distintos (ver la tabla de insets en
// params.scad): la punta redondeada del frente vacia 15 mm de cara y el pico
// del valle solo 2.6, asi que exigir el mismo inset en los dos extremos
// regalaria 12 mm de altura de piso sin comprar nada.
//
// SON CUATRO: dos por cara, como cualquier fila EUROrack. Los cuatro quedan
// fijos al marco por ambas puntas; ninguno funciona como eje o cierre manual.

// Semiextension del riel EUROrack ya girado con su cara. NO es un cuadrado:
// mide rail_er_alto a lo largo de la cara y rail_er_fondo hacia dentro, asi que
// cada eje del mundo recibe una mezcla distinta. Con el 2020 los dos daban lo
// mismo y bastaba r*(cos+sin) -- con la seccion real hay que separarlos, y ese
// atajo ya costo dos fallos en este case (x_ed en la Tarea 5, el techo del
// remate en el marco de 8).
function he_er_x(a) = rail_er_fondo/2*abs(cos(a)) + rail_er_alto/2*abs(sin(a));
function he_er_y(a) = rail_er_fondo/2*abs(sin(a)) + rail_er_alto/2*abs(cos(a));

function centros_rail() =
    let (P = pts_perfil(),
         // el eje del M5 de punta esta a rail_er_eje del panel, no a rail/2:
         // el riel es hondo y su taladro cae en su centroide
         off = rehundido_panel + t_panel + rail_er_eje,
         // [origen, fin, los s sobre la cara que llevan riel]
         caras = [[P[1], P[2], [inset_inf_frente,
                                alto_cara_inf - inset_inf_valle]],
                  [P[3], P[4], [inset_sup_valle,
                                alto_cara_sup - inset_sup_remate]]])
    [for (c = caras, s = c[2])
        let (d = (c[1]-c[0])/norm(c[1]-c[0]),      // unitario de la cara
             n = [d.y, -d.x])                       // normal hacia dentro
        c[0] + d*s + n*off];

// Los dos Z-Rails de la fila auxiliar KONDOR. Cruzan ancho_util exactamente como
// los cuatro 3U y se atornillan por sus puntas a la placa del valle. La
// separacion sale del panel, y el par va ARRIMADO AL FRENTE de la ventana del
// valle (2026-08-29): el primer riel recibe bajo su cara delantera los 2 mm de
// prolongacion maciza y la tira anti-ruido. Lo que sobre de ventana queda
// detras, bajo el vuelo de la cara de arriba, donde no se ve. Hasta hoy se
// centraban en la boca de la bahia, y la bahia murio ese dia (nota 1 de Samuel).
function centros_rail_1u() =
    let (P = pts_perfil(),
         xa = frente_kondor() + rail_er_alto/2,
         sep = alto_panel_1u - 2*inset_er,
         y = P[3].y - rehundido_panel - t_panel - rail_er_eje)
    [[xa, y], [xa + sep, y]];


// Tangente de la curva de un vertice: cuanto acrilico se come el redondeo a lo
// largo de cada arista. Es la misma cuenta que _arco hace por dentro, sacada
// aparte porque la tapa del valle necesita saber donde ACABA la curva del pico
// para no asomar por delante de ella.
function tangente(V, a, b, r) = _r_util(V, a, b, r) / tan(_ang(a, b) / 2);

// Extremos de la tapa del valle. DERIVADOS los dos:
//   delante  donde muere el redondeo del pico. Un milimetro mas y la plancha
//            asoma por delante de la curva del costado.
//   detras   holgura_rail por delante del riel del valle de la cara de arriba,
//            contra su ESQUINA girada (he_er_x), no contra su centro.
function x_valle() =
    let (P = pts_perfil(), cr = centros_rail(),
         dx_inf = rehundido_panel*cos(angulo_inferior),
         dx_sup = rehundido_panel*cos(angulo_superior))
    [P[2].x + tangente(P[2], P[1]-P[2], P[3]-P[2], radio_pico),
     cr[2].x - he_er_x(angulo_superior) - holgura_rail + dx_inf - dx_sup];

// largueros del esqueleto (2020) que no son railes de panel:
// base delantera, base trasera, valle, remate trasero.
// Centros [x, y]:
//
// JUNTO AL PLANO TRASERO QUEDAN DOS, no cinco (2026-08-21). Fueron creciendo
// uno por pieza: entrepiso trasero por la bandeja de entrepiso, repisa por la
// piel superior, remate superior por la tira de remate pegada de canto. Las
// tres piezas murieron, y los tres largueros sobrevivieron solo como filas de
// tornillo de la trasera. Con la trasera hecha UNA plancha de 8 esas filas no
// compran rigidez: una plancha continua atornillada arriba y abajo YA es el
// alma de cortante de esa cara, y mejor alma que cinco barras sueltas. Vano
// libre 211.73 mm sobre 8 mm de acrilico y 528 de ancho: 0.15 mm de flecha
// con 50 N en el centro. Quedan el de abajo (base trasera) y el de arriba
// (remate trasero).
//
// Y EL ENTREPISO DELANTERO SE RETIRA (2026-08-25). Era el CUARTO larguero
// -- centro [200.32, 131.58], holgura_rail detras de la esquina girada del
// riel del valle de la cara de arriba -- y el unico del case que no sostenia
// ninguna plancha: las seis filas de M3 van a base delantera, base trasera,
// valle y remate trasero. Su unico trabajo era atar los costados a media
// altura, y a esa MISMA altura (y = 131.58) ya esta el del valle, 75.14 mm
// por delante y encima con su tapa.
//
// Cruzaba el centro del volumen y se veia por el acrilico traslucido desde
// las dos ondas y desde el valle. Es lo mismo que ya tumbo tres largueros el
// 2026-08-21, aplicado al que quedaba: una barra que no es alma de nada.
//
// LO QUE CUESTA, medido sobre el contorno real de costado_2d y no estimado
// (placa circular empotrada de radio a, a = distancia del punto mas
// desasistido a su ancla mas cercana; D = E t^3/12(1-v^2), E = 3 GPa,
// v = 0.37, t = 8):
//
//   vano libre del costado      107.9 -> 119.2 mm  (solo M5; 111.3 contando
//                                                   los 4 M4 de riel)
//   flecha con 200 N             0.31 ->   0.38 mm
//   tension bajo la mano         6.35 ->   6.56 MPa   (fluencia 10, #106)
//   abrir los costados donde
//     estaba, con 200 N                     0.303 mm de separacion total
//
// El punto mas desasistido del costado NO era el suyo ni antes ni despues:
// esta en el canto trasero a media altura, donde ademas apoya la trasera.
// Se llevan 228 g y dos M5. Lo vigilo guarda_costado(), en check_dxf, hasta
// el 2026-10-11: la mejilla se fue con la persiana.
//
// LO QUE ESTE CALCULO NO CUBRE, y hay que decirlo: el racking del cajon
// entero. La spec §11 ya lista la rigidez del vano de 528 sin bulkhead
// central como HEURISTICA sin cerrar, y esto le quita una barra. Se cierra
// cargando el prototipo, no aqui.
//
// El SEPTIMO larguero, "zocalo superior", se retiro el 2026-08-17: Samuel
// pidio DOS nodos en la esquina de abajo y no tres -- uno para amarrar la
// estructura lateral con la vertical (base delantera) y otro solo para el
// riel del panel. Con el se fue la plancha del zocalo, que se habria quedado
// colgando de una sola fila de tornillos. El larguero habia nacido para dar
// a esa plancha un anclaje a rail DERECHO en vez de al de panel girado; sin
// plancha, el problema que resolvia deja de existir.
// centros_transversal() y sus tres accesores por nombre -- ct_base(),
// ct_valle() y ct_remate() -- MURIERON el 2026-08-28. Eran la lista de los
// TRES CENTROS de los 2020 comprados: un punto por larguero y nada mas. Los
// 2020 se sustituyeron por miembros de chapa el 2026-08-27, y desde ese dia la
// lista no la consumia ni el modelo ni un solo DXF -- solo sobrevivia porque
// bom() contaba sus elementos para decir "x3". Contar los miembros por el largo
// de una lista que ya no los describe es como contar sillas por las facturas
// viejas: el dia que entre o salga un miembro, el eco miente y nadie lo cantaba.
// Ahora los cuenta miembros_lista(), que son ellos mismos.
//
// LO QUE LLEVABA DENTRO Y NO SE PIERDE, porque sigue vivo unas lineas mas
// abajo: los DOS largueros traseros comparten X (miembro_x_trasera(), el plano
// trasero retirado t_piel) para que la trasera atornillada encima apoye en UN
// plano y no en dos parecidos -- si se separan, una de sus dos filas de M3 se
// atornilla al aire, y lo canta apoyo() en clearance_budget. La cadena del
// chasis del PSU (x_tr -> chasis -> lo que venga por delante) vive en
// _x_chasis_frente() del budget, con su propia nota. Y el larguero de `base
// delantera`, que era el cuarto punto de esta lista, se retiro el 2026-08-27.

// --- referencias de los tres miembros de chapa -------------------------
//
// Las cotas de los tres miembros de chapa, gemelas de _cajas_miembro() en
// clearance_budget.py. Sustituyeron a la geometria de los 2020 el 2026-08-27.
//
// Y LA LISTA DE LOS MIEMBROS, que es lo unico que puede contarlos. La consume
// bom() para decir cuantos hay: los nombres son los mismos que usan
// _cajas_miembro() en el budget y miembros() unas lineas mas abajo, o sea que
// anadir un cuarto miembro sin tocar esta lista deja los tres sitios en
// desacuerdo y el eco corto -- que es exactamente lo que pasaba mientras el
// numero salia de centros_transversal().
// DOS desde el 2026-08-29: la bahia -- la bandeja bajo la fila auxiliar que hacia de
// tercer miembro -- se fue por decision de Samuel ("en el valle solo irian los
// dos Z-rail de la fila"). Lo que ata los anillos a media altura son los seis
// rieles por sus placas, la tabla debajo y la trasera detras; el racking del
// conjunto sigue siendo #203 y se cierra cargando el prototipo.
function miembros_lista() = ["trasero alto", "talon"];
// LA CARA INTERIOR DE LA TRASERA. La trasera va DENTRO de las dos bandas
// (la del miembro alto arriba, la del talon abajo): su cara trasera contra la
// cara interior de las bandas, rehundida t_costilla del plano trasero -- como
// con el marco de la manana del 29, que es lo que la banda sustituye -- y de
// ahi t_piel hacia dentro. GEMELA de x_tr en clearance_budget.py.
function x_trasera_int() = trasera_x1() - t_piel;
function y_meseta() = pts_perfil()[5].y - marco_sup;

// LA VENTANA DEL VALLE: lo que queda libre entre los dos rieles 3U que miran al
// valle, y es donde vive la fila auxiliar KONDOR. Delante manda la envolvente
// CERRADA del riel inferior mas holgura: los paneles son fijos y se desmontan
// quitando tornillos, no giran sobre ellos. Detras manda la esquina cerrada del
// riel superior. GEMELA de _ventana_valle() en clearance_budget.py.
function ventana_valle() =
    [centros_rail()[1].x + he_er_x(angulo_inferior) + holgura_rail,
     x_valle()[1]];

// X historica del primer KONDOR. Rehundir el riel 3U inferior mueve el borde
// conservador de ventana_valle() en X, pero KONDOR solo baja: descontar esa
// componente evita arrastrar la fila y su apoyo lateralmente.
function frente_kondor() =
    ventana_valle()[0] - rehundido_panel*cos(angulo_inferior);

// EL TALON (2026-08-29, noche): la banda de abajo del plano trasero y su pie
// sobre la tabla. Sustituye al miembro trasero bajo: un angulo de la misma
// chapa, sin bridas ni rosca en el anillo -- se atornilla a la BASE por el
// pie, como la nariz --, que recibe la trasera en su banda y la asienta en
// su pie. GEMELO de _talon() en clearance_budget.py.
// EL TALON, la nariz de atras (2026-08-29, noche, 2): pie sobre la tabla del
// canto libre al pie del chaflan de P6, chaflan a 45 y labio vertical a ras
// del plano trasero. GEMELAS de _talon() en clearance_budget.py.
function talon_x_band()    = pts_perfil()[6].x - t_costilla;    // cara interior del labio
function talon_x_chaflan() = pts_perfil()[6].x - chaflan_nariz; // pie del chaflan
function talon_x_pie()     = talon_x_chaflan() - talon_pie;     // canto libre del pie
function talon_m4_x()      = talon_x_pie() + m4_pie_borde();
function centro_talon()    = [talon_x_chaflan() - talon_pie/2, talon_labio/2];
// Las pestanas lanzadas del pie: su cara hacia la trasera, y sus centros en
// z, a (2i+1)/2n del hueco entre anillos (los M4 van a 1/4, 1/2 y 3/4).
function talon_pestana_x() = x_trasera_int() - talon_pestana_aire;
function talon_pestana_z() =
    [for (i = [0 : talon_pestana_n - 1]) t_anillo + ancho_util*(2*i + 1)/(2*talon_pestana_n)];
// Bend deduction del doblez apretado de una pestana, y lo que su ventana
// mide en el desarrollo (alto + t - BD). GEMELAS de _bd_pestana().
function pestana_bd() = 2*(radio_doblez_pestana + t_costilla)
                        - PI/2*(radio_doblez_pestana + k_factor*t_costilla);
function talon_pestana_dev() = talon_pestana_alto + t_costilla - pestana_bd();
// Lo que mide una chapa que va entre las caras interiores de los anillos con
// hol_piel a cada lado: la nariz, el talon, el techo.
function entre_anillos() = ancho_util - 2*hol_piel;

// LA TRASERA CAPTURADA (2026-08-29, noche, 2). Como las mejillas: sus puntas
// dentro de un BOLSILLO fresado en la cara interior de cada anillo a lo largo
// del tramo trasero -- labio de rehundido_acrilico en el canto, rebaje_anillo
// de hondo, t_anillo - rehundido de ancho: los tres numeros del bolsillo del
// costado, girados --, su cara vista rehundida labio + junta, el canto de
// abajo sobre el pie del talon y el de arriba bajo la brida del techo. Sin un
// taladro. GEMELAS de _bolsillo_trasero(), _trasera() y _trasera_campo().
// DESDE EL TECHO MACIZO (2026-08-30) el labio ya NO es rehundido_acrilico: es
// rehundido_trasera(), derivado de la rendija del alero (4.5 contra 3). Es la
// unica cota de la trasera que deja de ser "la del costado, girada", y lo es
// porque la manda algo que el costado no tiene: por donde sale el aire. El
// bolsillo sigue midiendo 11 de ancho y 6 de hondo; solo se corre 1.5.
function trasera_x1() = pts_perfil()[6].x - rehundido_trasera() - t_junta_asiento;
function trasera_z0() = t_anillo - rebaje_anillo + hol_piel;
function trasera_au() = ancho_total - 2*trasera_z0();
function trasera_y0() = t_costilla;
// El canto de arriba muere 1.5 bajo la brida del techo: 0.5 de aire al fin
// del bolsillo, y el bolsillo se cierra 1.0 por debajo del canto de la brida
// (dos cosas en la misma cara del anillo no comparten arista).
function trasera_y1() = pts_perfil()[5].y - t_costilla - brida_ancho - 1.5;
function trasera_alto() = trasera_y1() - trasera_y0();
// El canto de abajo del labio (B) o de la banda (A) del techo: la coronacion
// de lo que se ve de la trasera por arriba.
function y_labio_techo() = remate_trasero_chaflan
    ? pts_perfil()[5].y - chaflan_nariz - techo_labio
    : pts_perfil()[5].y - banda_trasera;
// Lo que de la trasera se VE entre los dos labios: a esto se anclan la
// rejilla, las ondas, el IEC y KONDOR desde que no hay filas de M3.
function trasera_campo() = [chaflan_nariz + talon_labio, y_labio_techo()];
// El bolsillo, en x del mundo: [pared del fondo, cara interior del labio].
function bolsillo_trasero_x() =
    [pts_perfil()[6].x - pared_trasera_u(),
     pts_perfil()[6].x - rehundido_trasera()];
// Donde retrocede el rebaje del costado en el tramo trasero: la pared entre
// los dos bolsillos.
function rebaje_costado_trasero() = pared_trasera_u() + pared_rebaje_trasera;

// --- redondeo del contorno, radio POR VERTICE --------------------------
//
// Aqui estuvo un cierre morfologico global (`offset(-r) offset(2r) offset(-r)`)
// y no da la talla: un radio unico no puede a la vez COMERSE los 45 mm de
// cara frontal -- que Samuel quiere que se lean como punta redondeada -- y
// RESPETAR los 80 mm planos del valle. Con radio 14 el frente sigue siendo
// una cara recta; con el radio 31 que hace falta para borrarla, el valle se
// redondea entero y desaparece. Son requisitos opuestos sobre el mismo
// numero, asi que el numero tiene que dejar de ser uno.
//
// Esto emite el arco de cada esquina explicitamente. El radio pedido se
// RECORTA a lo que da de si la arista mas corta que llega al vertice, de
// modo que pedir un radio enorme no rompe nada: da el maximo redondeo
// posible, que es exactamente "punta redondeada".

// Angulo interior en V entre las aristas que van a los vecinos a y b.
function _ang(a, b) = let (u = a/norm(a), v = b/norm(b))
    acos(max(-1, min(1, u*v)));

// Radio efectivo: el pedido, o el que cabe si las dos tangentes no llegan a
// la mitad de su arista (si no, el arco de un vertice se comeria al vecino).
function _r_util(V, a, b, r) =
    let (g = _ang(a, b) / 2, lim = min(norm(a), norm(b)) / 2 * tan(g))
    min(r, lim * 0.999);

function _arco(V, a, b, r, n = 16) =
    let (u = a/norm(a), v = b/norm(b),
         g  = _ang(a, b) / 2,
         re = _r_util(V, a, b, r),
         t  = re / tan(g),                       // distancia tangente
         w  = (u + v) / norm(u + v),              // bisectriz interior
         C  = V + w * (re / sin(g)),              // centro del arco
         PA = V + u * t,
         aA = atan2(PA.y - C.y, PA.x - C.x),
         PB = V + v * t,
         aB = atan2(PB.y - C.y, PB.x - C.x),
         d  = ((aB - aA) + 540) % 360 - 180)      // giro corto, sirve para
    [for (i = [0:n]) C + re * [cos(aA + d*i/n),   // convexos y concavos
                               sin(aA + d*i/n)]];

// --- bombeo de las rectas (entasis) ------------------------------------
//
// "Las rectas no son completamente rectas, por poquito." Cada tramo recto
// entre dos arcos se cambia por una parabola muy plana que se abomba HACIA
// FUERA. La flecha es proporcional al largo del tramo (bombeo mm por cada
// 100 mm), no absoluta: una flecha fija se ve exagerada en un tramo corto y
// no se ve en uno largo.
//
// El "hacia fuera" se decide contra el CENTROIDE y no por el sentido de giro
// del poligono, que es una fuente de errores de signo silenciosos -- ya
// pasamos por uno con la rotacion de los railes.
function _suma(v, i = 0) = i >= len(v) ? [0, 0] : v[i] + _suma(v, i + 1);
function _centro(P) = _suma(P) / len(P);

function _bombear(A, B, C, n = 10) =
    let (d = B - A, L = norm(d))
    (bombeo <= 0 || L < 1) ? []
    : let (u = d / L,
           nl = [-u.y, u.x],
           M = (A + B) / 2,
           fuera = (nl * (M - C)) >= 0 ? nl : -nl,
           s = L / 100 * bombeo)                       // flecha en el centro
      [for (i = [1 : n-1])
          let (t = i / n)
          A + d*t + fuera * (s * 4*t*(1-t))];          // pico en t=0.5

// sin_bombeo = indices de vertice cuyo tramo SALIENTE se deja recto de
// verdad. El canto de abajo va aqui: es la cara de apoyo, y abombarla
// significa que el case descansa sobre el centro de cada costado en vez de
// sobre sus extremos.
function redondear(P, R, sin_bombeo = []) =
    let (n = len(P), C = _centro(P),
         arcos = [for (i = [0:n-1])
             R[i] <= 0 ? [P[i]]
                       : _arco(P[i], P[(i-1+n)%n] - P[i], P[(i+1)%n] - P[i],
                               R[i])])
    [for (i = [0:n-1]) each concat(
        arcos[i],
        search(i, sin_bombeo) != []
            ? []
            : _bombear(arcos[i][len(arcos[i]) - 1], arcos[(i+1)%n][0], C))];

// Radio por vertice del perfil, en el orden de pts_perfil(). Las dos esquinas
// del valle llevan radios DISTINTOS y opuestos a proposito (2026-08-17):
//
//   0 frente-abajo  PUNTA    1 arranque cara  PUNTA
//   2 valle-delante PICO     3 valle-detras   SUAVE
//   4 apex          REMATE   5 fondo-arriba   REMATE
//   6 fondo-abajo   normal
//
// El 2 es el vertice CONVEXO donde el tope del panel de abajo se encuentra
// con el valle: radio corto, para que se lea como pico. El 3 es el CONCAVO
// donde el valle arranca hacia la cara de arriba: radio largo, para que ese
// angulo entre blando. Son los dos extremos de la misma pieza y por eso no
// pueden compartir numero.
//
// radio_punta va deliberadamente sobredimensionado: _r_util lo recorta al
// maximo que permite la arista, y ese maximo ES la punta.
// Los vertices 4 y 5 compartieron radio_punta hasta el 2026-08-21. Ahi el radio
// efectivo no era el pedido sino el que cabia en la meseta (marco_remate/2), asi
// que ensanchar el techo lo volvia MAS redondo. Con radio_remate se pide un
// radio y sale ese: la punta de arriba se lee cuadrada a cualquier marco.
// Los vertices 5 y 6 -- los DOS del plano trasero -- pasan a radio_trasero = 0
// el 2026-08-24: esquina viva, para que la trasera y el remate del techo
// empotren a ras. OJO CON EL NOMBRE: desde el 2026-08-27 no hay tapa de remate
// -- esa plancha se integro como MESETA del miembro trasero alto --, asi que lo
// que empotra a ras contra esta esquina es esa meseta de chapa.
// Antes eran radio_remate (2) y radio_perfil (14), y ese 14 le
// dejaba a la trasera 14 mm de esquina colgando fuera de la silueta del
// costado. radio_perfil se quedo sin clientes y se borro. El porque completo,
// y que parte de la regla anti-fisura se sostiene y cual no, en params.scad.
//
// redondear() ya sabe tratar el 0: R[i] <= 0 devuelve el vertice pelado, sin
// arco. No hace falta tocarla.
// DESDE EL 2026-08-29 (nota 2 de Samuel: "en vez de una nariz curva, una nariz
// recta"): el vertice 0 no lleva radio sino CHAFLAN -- ver pts_contorno() --, y
// los vertices que llevan chapa empotrada usan radio_borde, concentrico con
// radio_chapa. Las salidas de los pies conservan radio_chapa. radio_punta
// y radio_remate murieron con esto; radio_trasero (0) murio la noche del 29,
// cuando el talon paso a doblar en P6 sobre la tabla.
function radios_perfil() = [0,            radio_borde(),
                            radio_pico,   radio_valle,
                            radio_borde(),
                            remate_trasero_chaflan ? 0 : radio_borde(),
                            0];

// EL CONTORNO DEL ANILLO NO ES pts_perfil(): el vertice 0 (frente-abajo) va
// CHAFLANADO a 45 -- chaflan_nariz sobre cada arista -- y un chaflan son dos
// vertices, cada uno con el radio de la chapa que dobla ahi. Se insertan AQUI
// y no en pts_perfil() porque medio fichero indexa P[1]..P[6] y correrlos uno
// es el mismo bug que costo el P[8] -> P[6]. Solo perfil_lateral() lo consume.
// GEMELO del chaflan que anillo_tiene_chaflan() relee del DXF en check_dxf.
// Y DESDE LA TRASERA CAPTURADA (2026-08-29, noche, 2) el vertice 6 (abajo-
// atras) va tambien a chaflan -- el talon es la nariz de atras -- y el 5
// (arriba-atras) con remate_trasero_chaflan. Cada chaflan son dos vertices
// con radio_chapa.
function pts_contorno() =
    let (P = pts_perfil(), c = chaflan_nariz, pf = P[6].x, yt = P[5].y)
    concat([[c, 0], [0, c]], [for (i = [1 : 4]) P[i]],
           remate_trasero_chaflan ? [[pf - c, yt], [pf, yt - c]] : [P[5]],
           [[pf, c], [pf - c, 0]]);
function radios_contorno() =
    concat([radio_chapa, radio_borde()],
           [for (i = [1 : 4]) radios_perfil()[i]],
           remate_trasero_chaflan ? [radio_borde(), radio_borde()] : [radios_perfil()[5]],
           [radio_borde(), radio_chapa]);
// Los tramos del contorno que van RECTOS: todos menos las tres caras de las
// filas ([2], [3], [4]), que conservan la entasis.
function tramos_rectos() = [for (i = [0 : len(pts_contorno()) - 1]) if (i < 2 || i > 4) i];

// Va DENTRO de perfil_lateral y no en cada pieza a proposito: las que salen de
// el (la costilla, la persiana; hasta el 2026-10-11 tambien costado_2d) restan
// sus agujeros DESPUES, de modo que el redondeo no toca los taladros.
// Si se aplicara al resultado de la resta, los M4 saldrian fuera de
// diametro -- el mismo tipo de fallo que el cupon pentagonal.
//
// Ningun otro modulo consume este contorno (las demas piezas usan
// pts_perfil() para coordenadas, no la silueta), asi que el radio no se
// propaga a bandejas ni pieles.
module perfil_lateral() {
    // TRES tramos van rectos de verdad, y la regla es una sola: EL CANTO QUE
    // APOYA CONTRA ALGO PLANO NO SE ABOMBA. Los que solo dibujan silueta
    // conservan la entasis, que es para lo que existe.
    //
    //   [6] canto de abajo   (P[6] -> P[0], 308.94 mm)  la cara de apoyo.
    //       Abombada, el aparato descansaria sobre el centro de cada costado
    //       en vez de sobre sus extremos, y con paticas en las esquinas eso
    //       es un balancin. Exento desde el principio.
    //   [5] canto trasero    (P[5] -> P[6], 256.18 mm)  contra la TRASERA.
    //   [4] meseta del techo (P[4] -> P[5],  50.00 mm)  contra la TAPA DE
    //       REMATE.
    //
    // Los dos ultimos entran el 2026-08-24, a peticion de Samuel: "siento que
    // no esta recta la linea de ese corte y preferiria que fuera recta para
    // que encaje a la perfeccion con la pieza trasera". Y no era percepcion.
    // Medido sobre el DXF que va al taller, el canto trasero SOBRESALIA
    // 1.1970 mm del plano trasero a media altura y enrasaba en las puntas
    // -- contra hol_piel = 0.15 mm de holgura de montaje de la trasera, o sea
    // OCHO VECES la junta. La meseta hacia lo mismo con 0.250 mm bajo la tapa
    // de remate.
    //
    // El canto trasero era ademas EL TRAMO MAS LARGO QUE TODAVIA SE ABOMBABA
    // (256.18 mm; el de abajo es mayor pero ya estaba exento), asi que se
    // llevaba la flecha mas grande del perfil. Lo que queda de entasis tras
    // esto es 0.779 mm en la cara del panel de abajo, que no apoya contra
    // nada.
    //
    // INDICES DEL CONTORNO, no del perfil (2026-08-29): el chaflan mete un
    // vertice antes, asi que los tres de arriba son [5], [6] y [7]. Y entran
    // dos mas: [0] el chaflan y [1] el frente vertical, que llevan encima la
    // NARIZ -- chapa plana, o sea "algo plano".
    polygon(redondear(pts_contorno(), radios_contorno(), tramos_rectos()));
}

// --- EL ANILLO DE PLETINA -------------------------------------------------
// La costilla es un anillo FRESADO desde el 2026-08-28: silueta por fuera,
// ventana por dentro, y por detras el rebaje donde asentaba el acrilico (vacio
// desde el 2026-10-11, que lo tapa la persiana). No
// tiene desarrollo, no tiene alivios, no tiene P3 que soldar: es una pieza.
//
// LO QUE SE FUE CON LA CHAPA, y conviene que quede escrito porque fueron dos
// dias de trabajo: la banda de ala_costilla (27) con su ventana, el ala de
// ala_doblez (16) doblada a 90 en los siete tramos, los seis alivios en V de
// los vertices convexos, el rip bisector de P3 y su soldadura, y el
// desarrollo plano que el DXF tenia que llevar porque un corte no dice de
// donde doblar. Nada de eso sobrevive a una pieza maciza: la cara vista sale
// del propio espesor y la esquina concava es un radio de fresa.
function retiro_rebaje() = cara_anillo - rebaje_anillo;

// La ventana se estrecha solo atras; la interseccion deja transiciones minimas.
// VISTA PREVIA: la spec no fija los puntos de enlace entre las caras de 20 y 22.
module ventana_anillo_2d(f = 0) {
    P = pts_perfil();
    intersection() {
        offset(delta = -cara_anillo + f) perfil_lateral();
        translate([-cara_anillo, -cara_anillo])
            square([P[6].x - cara_anillo_trasera() + f + cara_anillo,
                    P[5].y + 2*cara_anillo]);
    }
}

// Banda holgada alrededor de un tramo; el anillo redondeado recorta el resultado.
module mascara_tramo_rebaje(A, B, extra_a = -1, extra_b = -1) {
    d = (B - A)/norm(B - A);
    n = [d.y, -d.x];
    e = radio_borde() + rehundido_trasera();
    ea = extra_a < 0 ? e : extra_a;
    eb = extra_b < 0 ? e : extra_b;
    polygon([A - d*ea - n, B + d*eb - n,
             B + d*eb + n*(rehundido_trasera() + 1),
             A - d*ea + n*(rehundido_trasera() + 1)]);
}

// Solo se fresa donde una chapa queda a la vista.
module rebaje_chapa_2d() {
    P = pts_perfil();
    C = pts_contorno();
    d_sup = [sin(angulo_superior), cos(angulo_superior)];
    pf = P[6].x;
    yt = P[5].y;
    c = chaflan_nariz;
    intersection() {
        difference() {
            offset(delta = -rehundido_chapa) perfil_lateral();
            offset(delta = -rehundido_trasera()) perfil_lateral();
        }
        union() {
            mascara_tramo_rebaje(C[0], C[1], 0);                 // nariz, chaflan
            mascara_tramo_rebaje(C[1], P[1], -1, 0);             // nariz, frente
            mascara_tramo_rebaje(P[4] - d_sup*retorno_meseta, P[4], 0);
            mascara_tramo_rebaje(P[4], [pf - c, yt]);            // meseta
            mascara_tramo_rebaje([pf - c, yt], [pf, yt - c]);    // P5
            mascara_tramo_rebaje([pf, yt - c], [pf, y_labio_techo()], -1, 0);
            mascara_tramo_rebaje([pf, c + talon_labio], [pf, c], 0);
            mascara_tramo_rebaje([pf, c], [pf - c, 0], -1, 0);   // talon
        }
    }
}

module rect_redondeado_2d(w, h, r) {
    hull()
        for (x = [r, w - r], y = [r, h - r])
            translate([x, y]) circle(r = r);
}

// El cajeado da hol_chapa alrededor de la brida y usa el radio de la fresa.
module cajeado_brida_2d() {
    // hol_chapa alrededor de la huella: el canto de arriba del cajeado cae
    // en u = rehundido_chapa, justo donde muere el reborde, y el de abajo
    // 0.5 por encima del cierre del bolsillo (bolsillo_y_fin).
    // Y como la huella de la brida lleva su esquina de arriba-atras cortada a
    // 45 (paralela al chaflan de P5), el cajeado no pasa de u = rehundido_chapa
    // tampoco ahi: un rectangulo sin cortar se comia el reborde en el chaflan.
    intersection() {
        translate([brida_x_dob() - brida_largo - hol_chapa,
                   y_meseta() - brida_ancho - hol_chapa])
            rect_redondeado_2d(cajeado_brida_largo(), cajeado_brida_ancho(),
                               radio_cajeado_brida());
        offset(delta = -rehundido_chapa) perfil_lateral();
    }
}

// EL REBAJE DEL COSTADO, en planta: la silueta retirada cara - rebaje por
// los cuatro lados, salvo en el tramo trasero, donde retrocede a
// rebaje_costado_trasero (la pared con el bolsillo de la trasera). GEMELO de
// anillo_tiene_rebaje() en check_dxf.
module rebaje_2d() {
    P = pts_perfil();
    difference() {
        offset(delta = -retiro_rebaje()) perfil_lateral();
        translate([P[6].x - rebaje_costado_trasero(), -1]) square([100, 400]);
    }
}

// EL BOLSILLO DE LA TRASERA, en planta: CERRADO POR LOS DOS EXTREMOS. Abajo
// se cierra medio milimetro bajo el canto de la trasera (que apoya en el pie)
// y arriba medio milimetro sobre el otro canto, 1.0 por debajo de la brida
// del techo. La trasera entra al montar el segundo anillo, como los costados
// -- son las tres planchas que se montan una vez, con el case --: salir por
// el canto de arriba dejaba un agujero de 11 x 6 a la vista junto al techo, y
// salir por abajo obligaba a que toda la plancha pasara por la boca estrecha
// que deja el chaflan de P6 (el revisor del PR lo cazo con un booleano).
// Bajo bolsillo_y_paso (la coronacion de la pared de u = rehundido sobre el
// chaflan, mas 0.5) el bolsillo arranca en bolsillo_u_paso para no morder la
// cara del chaflan; la esquina de abajo-fuera de la plancha va a chaflan
// (chaflan_trasera_bajo) y libra ese escalon. Se fresa rebaje_anillo hondo
// desde la cara interior (profundidad en el pliego: la mitad de la del
// rebaje). GEMELO de _bolsillo_trasero() y de anillo_tiene_bolsillo_trasero().
function bolsillo_y_bot()  = trasera_y0() - 0.5;
function bolsillo_y_fin()  = trasera_y1() + 0.5;
function bolsillo_y_paso() = chaflan_nariz - rehundido_trasera() + 0.5;
function bolsillo_u_paso() = chaflan_nariz - bolsillo_y_bot() + 0.5;
module bolsillo_trasero_2d() {
    b = bolsillo_trasero_x();
    pf = pts_perfil()[6].x;
    polygon([[b[0], bolsillo_y_bot()], [pf - bolsillo_u_paso(), bolsillo_y_bot()],
             [pf - bolsillo_u_paso(), bolsillo_y_paso()], [b[1], bolsillo_y_paso()],
             [b[1], bolsillo_y_fin()], [b[0], bolsillo_y_fin()]]);
}

// EL CHAFLAN DE LA ARISTA DE ABAJO-FUERA DE LA TRASERA, a 45, por todo su
// largo: lo que hace falta para que su esquina libre el escalon del bolsillo
// con 0.5 (la pared de u = rehundido..bolsillo_u_paso bajo bolsillo_y_paso)
// EN EL PEOR SITIO DONDE LA PLANCHA PUEDE ESTAR: en el fondo del bolsillo
// (bolsillo_y_bot, donde descansa hasta que llega la tabla) y pegada al labio
// (u = rehundido, con la junta aplastada). El revisor del PR #244 cazo que la
// primera cuenta la media en su sitio nominal, donde no esta al montarla.
// No sale en el DXF (es una arista, no un contorno): va en el pliego. Escondido
// detras del labio del talon. GEMELO de la clave "chaflan_bajo" de _trasera().
function chaflan_trasera_bajo() =
    (bolsillo_u_paso() + 0.5 - rehundido_trasera())
    + (bolsillo_y_paso() - bolsillo_y_bot());

module anillo_2d() {
    difference() {
        perfil_lateral();
        ventana_anillo_2d();
    }
}

// El DXF de la CARA: contorno de la pieza y ventana. Va al corte del blank.
module costilla_2d() { anillo_2d(); }

// El DXF del DORSO: lo que se fresa por detras. El contorno del rebaje
// (profundidad t_anillo - rehundido, en el pliego) y los centros de las
// roscas ciegas a diametro de broca (profundidad en el pliego). Otro fichero
// porque un DXF 2D no sabe decir "a 11 mm" -- mismo caso que el cajeado
// KONDOR de la trasera.
// LAS DOS ROSCAS DE LA BRIDA VAN COMO AGUJERO, no como disco (2026-08-30). Las
// otras doce caen en cara lisa y se dibujan sumando un circulo, que es como se
// leen en una planta. Estas dos caen DENTRO del cajeado de la brida, y una
// union 2D se las traga: circulo lleno dentro de rectangulo lleno es el mismo
// rectangulo, y el DXF salia con doce agujeros donde el modelo pone catorce. Se
// restan, que ademas es lo que son -- un taladro en el SUELO del cajeado --, y
// asi su circunferencia queda dibujada y el taller la ve.
module costilla_dorso_2d() {
    difference() {
        union() {
            rebaje_2d();
            bolsillo_trasero_2d();
            rebaje_chapa_2d();
            cajeado_brida_2d();
            for (c = centros_rosca_ciega())
                translate(c[0]) circle(d = c[1]);
        }
        for (c = bridas_anillo())
            translate(c) circle(d = d_M4_rosca);
    }
}

// --- EL MARCO DE LA VENTANA Y LAS ROSCAS CIEGAS (2026-08-29, noche) -------
//
// El eje del M4 de cada riel cae a 15.90 de la silueta, o sea DENTRO del
// rebaje, donde el anillo solo tiene 3 mm de labio: por ahi el tornillo sale
// por la cara vista. Asi que el riel muere contra una pletina apoyada en la
// franja interior y es la pletina la que va al anillo, con dos M4 a rosca
// ciega por riel. Fueron TRES PLACAS por costado, una por fila -- "la placa
// es el marco de la fila" (Samuel, 28-08) -- mas dos clips en el suelo y una
// escuadra en la trasera para retener el acrilico hacia dentro donde no
// habia placa. Desde esta noche son UNA pieza: el MARCO DE LA VENTANA, la
// misma pletina de t_placa corrida por los siete tramos del anillo, con el
// contorno de la ventana por dentro (marco_fondo desde la silueta) y el
// canto exterior donde toca en cada tramo:
//
//   las tres filas          a la silueta: el canto visto de 6 que se lee
//                           como el borde de aluminio de la fila
//   frente, meseta y cola   retirados bajo la chapa empotrada
//   suelo                   retirado solo bajo los pies, que siguen a ras
//   trasera                 retirado t_anillo + 0.5: por debajo corre el
//                           bolsillo de la trasera (2026-08-29, noche, 2) y
//                           la pata apoya en la pared entre bolsillos; entra
//                           marco_fondo_trasera, no marco_fondo
//                           (guarda_trasera_capturada, guarda_marco_ventana)
//
// Y UNA MUESCA sobre la brida del miembro alto, en la esquina trasera-alta:
// la brida apoya en la cara del anillo y el marco vive en esa misma franja,
// asi que se aparta. Todo se comprueba en la envolvente estatica cerrada.
//
// TODO ESTO ES GEMELO de _marco_ventana(), _roscas_marco(), _bridas() y
// _centros_rosca_ciega() en clearance_budget.py, y quien las cruza es
// taladros_anillo() y taladros_marco_ventana() en check_dxf releyendo los DXF.

function retiro_marco_pie() = t_costilla + hol_piel;
function retiro_marco_chapa() = rehundido_chapa + t_costilla + hol_piel;
function retiro_marco() = retiro_marco_chapa();
// La pata trasera arranca sobre la pared entre bolsillos: t_anillo + 0.5
// (2026-08-29, noche, 2). Fue t_piel + t_costilla + tol + 0.5 con la trasera
// atornillada a la banda.
function retiro_marco_trasera() = pared_trasera_u() + hol_costado;

// Cuanto se retira una pata del vertice i: la TANGENTE de su redondeo si el
// vertice es convexo -- ahi el contorno se mete hacia dentro y una esquina
// apoyada en la recta se saldria de la silueta -- y CERO si es concavo. El
// perfil se recorre en sentido HORARIO: convexo es producto vectorial < 0.
function retiro_vertice(i) =
    let (P = pts_perfil(), m = len(P),
         A = P[(i + m - 1) % m], V = P[i], B = P[(i + 1) % m],
         cruz = (V.x - A.x)*(B.y - V.y) - (V.y - A.y)*(B.x - V.x))
    cruz < 0 ? tangente(V, A - V, B - V, radios_perfil()[i]) : 0;

// LAS TRES PATAS DE LAS FILAS, que son las que recogen rieles: [nombre, A, u,
// n, s0, s1, ejes]. A es el vertice de arranque del tramo; un punto de la
// pata es A + u*s + n*b. `ejes` lleva, por cada riel, [s del eje, punto, si
// lleva sus dos roscas ciegas]. La cara de abajo cede retiro_placa_inf en P1
// (ahi el canto exterior va retirado bajo la nariz y la pata sigue) y el
// valle se alarga hasta cubrir el cajeado de su segundo riel, pasado P3.
function patas_filas() =
    let (P = pts_perfil(), cr = centros_rail(), c1u = centros_rail_1u())
    [for (t = [["cara_inf", 1, 2, [0, 1], retiro_placa_inf],
               ["valle",    2, 3, [],     0],
               ["cara_sup", 3, 4, [2, 3], retiro_placa_sup]])
        let (A = P[t[1]], B = P[t[2]], L = norm(B - A),
             u = (B - A)/L, n = [u.y, -u.x],
             tres = len(t[3]) > 0,
             centros = tres ? [for (i = t[3]) cr[i]] : c1u,
             // EL SEGUNDO KONDOR NO LLEVA ROSCAS y no es un olvido: radio_valle
             // vale 54 y curva la franja del valle, y una broca puesta ahi
             // sale por la pared del rebaje.
             ejes = [for (k = [0 : len(centros) - 1])
                        [(centros[k] - A)*u, centros[k], tres || k == 0]],
             s0 = retiro_vertice(t[1]) + t[4],
             // EN CADA ESQUINA LA PATA ACABA DONDE MANDA LA MAS RETIRADA DE
             // LAS DOS: la tangente del redondeo, o el retiro de la pata
             // VECINA si es mayor. Gemelo de ini()/fin() en el budget, que lo
             // hacia desde siempre; aqui faltaba y no se notaba porque el
             // retiro del marco (1.65) era menor que la tangente de P4
             // (2.2782). Con la chapa empotrada el retiro sube a 2.65 y pasa a
             // mandar: sin esto, la pata de la cara de arriba seguia 0.37 mas
             // alla de donde empieza la franja retirada de la meseta, y las
             // dos roscas de su riel de arriba salian 0.37 corridas respecto
             // a lo que el presupuesto dice.
             vecino = t[0] == "cara_sup" ? retiro_marco_chapa() : 0,
             s1v = L - max(retiro_vertice(t[2]), vecino),
             s1 = tres ? s1v
                       : max(s1v, max([for (e = ejes) e[0]])
                                  + 2*d_M4_paso))
        [t[0], A, u, n, s0, s1, ejes]];
function pata(nombre) = [for (q = patas_filas()) if (q[0] == nombre) q][0];

// La pata del suelo del marco, de P6 al chaflan: [A, u, n, s0, s1]. Arranca
// donde manda la pata trasera (retiro_marco_trasera tras P6) y acaba en el
// retiro del chaflan. Lleva DOS roscas ciegas, a rosca_suelo_retiro de cada
// extremo: el trabajo que hacian las de los clips. GEMELA de la pata "suelo"
// de _marco_ventana() y de las "marco suelo" de _roscas_marco().
function pata_suelo() =
    let (P = pts_perfil(), A = P[6], B = [chaflan_nariz, 0], L = norm(B - A),
         u = (B - A)/L, n = [u.y, -u.x])
    [A, u, n, max(retiro_vertice(6), retiro_marco_trasera()),
     L - retiro_marco_pie()];
function roscas_suelo() =
    let (q = pata_suelo())
    [for (s = [q[3] + rosca_suelo_retiro, q[4] - rosca_suelo_retiro])
        q[0] + q[1]*s + q[2]*dist_rosca_ciega];

// Las dos roscas ciegas de cada riel quedan a no menos de sep_rosca_riel de su
// eje, a lo largo del tramo, y a dist_rosca_ciega de la silueta. Doce por
// anillo: diez de las filas y dos en la pata del suelo (roscas_suelo). Si el
// par a +-sep_rosca_riel no cabe a 1.6 D de un extremo, LAS DOS ROSCAS pasan
// al lado interior: la mas cercana conserva sep_rosca_riel y entre ambas
// quedan 2 D. Nunca se arriman al riel para salvar el canto (#242). GEMELA de
// _roscas_marco().
function ss_roscas_riel(q, e) =
    let (canto = 1.6*d_M4_paso,
         paso_par = 2*d_M4_paso,
         lo = q[4] + canto,
         hi = q[5] - canto,
         a = e[0] - sep_rosca_riel,
         b = e[0] + sep_rosca_riel)
    a < lo ? [b, b + paso_par]
           : b > hi ? [a - paso_par, a]
                    : [a, b];
function roscas_marco() =
    concat([for (q = patas_filas(), e = q[6], s = ss_roscas_riel(q, e))
                if (e[2]) q[1] + q[2]*s + q[3]*dist_rosca_ciega],
           roscas_suelo());
// Los seis pasos M4 de riel (con cajeado por el lado del anillo).
function ejes_marco() = [for (q = patas_filas(), e = q[6]) e[1]];

// La brida de extremo del miembro alto: sus dos M4 en el cajeado de la meseta.
// Regla de chapa: el agujero no entra en la zona del doblez (setback + 2t +
// radio). Dobla del EXTREMO DE LA BANDA, en el plano trasero, y apoya en el
// SUELO DEL CAJEADO (2026-08-30; apoyaba en la cara del anillo): queda fuera
// de la envolvente estática del panel fijo, con el marco muescado
// encima. En y no se mueve: dobla del extremo del labio, que muere donde la
// rendija manda, y su canto de arriba queda en y_meseta() como siempre.
function brida_raiz() = radio_doblez_costilla + 3*t_costilla + d_M4_paso/2;
// EL M4 DE DENTRO NO CAE SOBRE EL BOLSILLO DE LA TRASERA (2026-08-29, noche,
// 2): el bolsillo corre por la cara interior hasta u = t_anillo y la rosca
// quiere 1.6 D de broca de su pared (1.6 y no 1.5 para no vivir del
// redondeo). Manda la mayor de las dos reglas. GEMELA de _bridas().
// (Se probo max(raiz, t_anillo + 1.6 D - t) cuando el bolsillo pasaba por
// debajo de la brida; con el bolsillo cerrado arriba vuelve a ser la raiz.)
function brida_s_in() = brida_raiz();
function brida_x_dob() = pts_perfil()[6].x - rehundido_chapa - t_costilla;
function brida_xs() = [brida_x_dob() - brida_s_in(),
                       brida_x_dob() - brida_largo + 1.5*d_M4_paso];
function bridas_anillo() =
    let (P = pts_perfil()) [for (x = brida_xs()) [x, P[5].y - dist_rosca_ciega]];

// [centro, diametro de broca] de cada rosca ciega de la cara interior: CATORCE
// por anillo, doce del marco y dos de la brida. Las de la TABLA no estan: van
// en el CANTO inferior del anillo y un DXF de la cara no sabe dibujar un
// taladro que entra por el canto (pliego). La de la pestana del valle
// tampoco: se rosca en los 6 mm del marco (ruling R3).
function centros_rosca_ciega() =
    concat([for (c = roscas_marco()) [c, d_M4_rosca]],
           [for (c = bridas_anillo()) [c, d_M4_rosca]]);

// El M3 con el que la pestana de la banda del valle se atornilla al marco, a
// diametro de broca y de lado a lado -- 6 mm de pletina dan rosca de sobra.
function m3_pestana() = [pv_x(), pts_perfil()[3].y - pv_a()];
function roscas_marco_m3() = [[m3_pestana(), d_M3_rosca]];

// LA MUESCA DE LA BRIDA: [x_min, y_min]; todo lo que quede a x >= x_min e
// y >= y_min se corta del marco. GEMELA de _muesca_brida().
function muesca_brida() =
    [brida_x_dob() - brida_largo - hol_chapa,
     y_meseta() - brida_ancho - hol_chapa];

// Las bandas que retiran el canto exterior del marco de la silueta, una por
// tramo bajo chapa: [A, B, s0, s1, retiro], con s en mm desde A. Pasarse de
// largo por las puntas es a proposito: en una esquina entre dos tramos
// retirados manda el retiro mayor, y la banda que se pasa se lo come.
function bandas_marco() =
    let (P = pts_perfil(), C = pts_contorno(), r = retiro_marco_chapa(),
         rp = retiro_marco_pie(),
         s0_inf = retiro_vertice(1) + retiro_placa_inf,
         L_sup = norm(P[4] - P[3]))
    [[C[0], C[1], -5, norm(C[1] - C[0]) + 5, r],                 // chaflan
     [C[1], P[1], -5, norm(P[1] - C[1]), r],                      // frente
     [P[1], P[2], -5, s0_inf, r],                                 // cara de abajo, bajo la nariz
     [P[3], P[4], L_sup - (retorno_meseta + 1), L_sup + 5, r],    // cola, bajo el retorno
     [P[4], P[5], -5, norm(P[5] - P[4]) + 5, r],                  // meseta
     [P[5], P[6], -5, norm(P[6] - P[5]) + 5, retiro_marco_trasera()],  // trasera
     [P[6], C[0], -5, norm(C[0] - P[6]) + 5, rp]];                // suelo
module banda_marco_2d(b) {
    A = b[0]; B = b[1]; u = (B - A)/norm(B - A); n = [u.y, -u.x];
    polygon([A + u*b[2] - n*5, A + u*b[3] - n*5,
             A + u*b[3] + n*b[4], A + u*b[2] + n*b[4]]);
}

// La pletina sin taladros: la silueta menos las bandas de retiro, menos la
// ventana a marco_fondo, menos la muesca de la brida.
//
// EL CANTO INTERIOR ES RECTO: marco_fondo desde las ARISTAS del perfil
// (pts_perfil, sin redondear), no desde la silueta redondeada. Da lo mismo
// en las esquinas convexas -- el offset hacia dentro de un redondeo convexo
// es una esquina viva igual --, pero en P3, el rincon concavo de radio 54,
// el offset de la silueta sube en arco y dejaba el paso del segundo riel KONDOR
// a 6.26 del canto (check_dxf lo cazo). Con las aristas rectas el marco es
// mas hondo en ese rincon -- entra 9 mas alla de la ventana en vez de 6, sin
// consecuencia -- y el paso se queda a 10.
module marco_contorno_2d() {
    difference() {
        perfil_lateral();
        for (b = bandas_marco()) banda_marco_2d(b);
        // la ventana del marco: marco_fondo por dentro, salvo la pata trasera,
        // que entra marco_fondo_trasera (sin tornillo y mas estrecha desde el
        // bolsillo, necesita el ancho)
        difference() {
            offset(delta = -marco_fondo) polygon(pts_perfil());
            translate([pts_perfil()[6].x - marco_fondo_trasera, -1]) square([100, 400]);
        }
        translate(muesca_brida()) square([100, 100]);
    }
}

// EL DXF DEL MARCO: contorno y taladros de PASO. Doce M4 al anillo, seis M4
// de riel y la rosca M3 de la pestana. La brida del miembro alto NO lo
// atraviesa: ahi el marco lleva la muesca y la brida va directa al anillo.
// EL CAJEADO NO SE
// DIBUJA: un DXF 2D no sabe decir "a 2.5 mm de profundidad" -- va como NOTA
// DE MECANIZADO en el pliego (Ø8 x prof_cajeado_riel en cada paso M4 de
// riel, por la cara que mira al anillo: el lado espejado comparte contorno y
// se cajea por la otra cara). Lo relee taladros_marco_ventana() en check_dxf.
module marco_ventana_2d() {
    difference() {
        marco_contorno_2d();
        for (c = roscas_marco())  translate(c) circle(d = d_M4_paso + kerf);
        for (c = ejes_marco())    translate(c) circle(d = d_M4_paso + kerf);
        for (r = roscas_marco_m3()) translate(r[0]) circle(d = r[1]);
    }
}

// El marco en 3D, sobre la cara interior del anillo, con el cajeado de cada
// riel por el lado del anillo. ORDEN DE MONTAJE OBLIGADO: primero los seis
// rieles al marco (la cabeza queda en el cajeado, del lado que despues mira
// al anillo), despues el marco al anillo desde dentro. Al reves no se puede.
// (Hasta el 2026-10-11 el costado iba antes, asentado en el rebaje: el marco
// lo pisaba.)
module marco_ventana() {
    translate([0, 0, t_anillo]) difference() {
        linear_extrude(t_placa) marco_ventana_2d();
        for (c = ejes_marco())
            translate(concat(c, [-0.1]))
                cylinder(h = prof_cajeado_riel + 0.1, d = d_cajeado_riel);
    }
}

// Dos marcos: uno por costado, espejados.
module marcos_ventana() {
    for (m = [0, 1])
        translate([0, 0, m ? ancho_total : 0])
            mirror([0, 0, m])
                marco_ventana();
}

// --- LA NARIZ: la banda del frente (2026-08-29) --------------------------
//
// Lo que se veia desnudo por delante y por abajo era el riel del frente de la
// fila de abajo y el hueco abierto entre anillos, de la tabla al canto del
// panel: 19 mm de frente vertical mas los 12.5 de cara de abajo que quedan por
// debajo de la cara del riel, sin nada que los cierre (nota 2 de Samuel). La
// nariz es una banda de la MISMA chapa que los marcos de la trasera
// (t_costilla), doblada sobre la nariz del anillo -- que desde hoy es RECTA:
// chaflan a 45 abajo y esquina de radio_chapa arriba, como el marco lateral de
// la referencia de Samuel -- y con un pie hacia dentro sobre la tabla, por
// donde se atornilla desde dentro con tres M4. Ningun tornillo en la cara
// vista.
//
// HASTA DONDE SUBE lo manda la envolvente fija de la cara de abajo: en las
// puntas las dos viven en la misma rebanada de z, asi que la banda acaba
// hol_piel por debajo del arranque de la placa (que a su vez se retira
// retiro_placa_inf para dejarle sitio). DESDE EL 2026-10-11 (ficha 6) TAPA LA
// CARA DEL RIEL: retiro_placa_inf pasa a 11.9 y la nariz sube hasta pisar 1 mm
// de ella, a 1 mm del panel, y la rendija se cierra. Lo mide
// guarda_labio_chapas() en clearance_budget.py. Hasta entonces se quedaba
// debajo del riel, con una linea de sombra de ~2 mm: era la regla del barrido,
// de cuando las filas giraban.
//
// GEMELA de _nariz(), _cajas_nariz() y bbox_desarrollo_nariz() en
// clearance_budget.py; los taladros los cruza taladros_nariz() en check_dxf.
function nariz_s_top() = pata("cara_inf")[4] - hol_piel;
function nariz_largo() = ancho_util - 2*hol_piel;
// El contorno EXTERIOR en el plano del perfil, del pie hacia arriba: pie sobre
// la tabla, chaflan, frente vertical y el tramo de cara de abajo.
function nariz_contorno() =
    let (c = chaflan_nariz, P = pts_perfil(),
         d = [sin(angulo_inferior), cos(angulo_inferior)])
    [[c + nariz_pie, 0], [c, 0], [0, c], P[1], P[1] + d*nariz_s_top()];
// Desarrollo: cada tramo por su cara exterior menos un BD por doblez -- dos a
// 45 en el chaflan y uno de angulo_inferior en P1.
function nariz_desarrollo() =
    let (c = chaflan_nariz)
    nariz_pie + c*sqrt(2) + (alto_frontal - c) + nariz_s_top()
    - 2*doblez_bd(45) - doblez_bd(angulo_inferior);
// Los tres M4 del pie: a m4_pie_borde() del canto libre del pie (x del perfil)
// y a un cuarto, medio y tres cuartos del hueco entre anillos (z del mundo).
// Era 1.5 D; con D-T2 (papel del suelo) el M4 rosca en una tuerca CLS prensada
// en el pie, y la tuerca pide pem_borde al canto. GEMELA de _m4_pie_borde().
function m4_pie_borde() = max(1.5*d_M4_paso, pem_borde);
function nariz_m4_x() = chaflan_nariz + nariz_pie - m4_pie_borde();
function nariz_m4_z() = [for (f = [0.25, 0.5, 0.75]) t_anillo + ancho_util*f];

// Un tramo de chapa entre dos puntos del contorno, con el espesor hacia
// DENTRO: el perfil se recorre en sentido horario y el interior queda a la
// derecha de cada arista.
module tramo_chapa(A, B) {
    d = (B - A)/norm(B - A);
    r = [d.y, -d.x];
    polygon([A, B, B + r*t_costilla, A + r*t_costilla]);
}

function cruz_2d(a, b) = a.x*b.y - a.y*b.x;
function normal_derecha(A, B) =
    let (d = (B - A)/norm(B - A)) [d.y, -d.x];
function cruce_rectas(P, d, Q, e) =
    abs(cruz_2d(d, e)) < 0.000001
    ? (P + Q)/2
    : P + d*(cruz_2d(Q - P, e)/cruz_2d(d, e));
function polilinea_rehundida(C, u) =
    [for (i = [0 : len(C) - 1])
        i == 0
        ? C[i] + normal_derecha(C[i], C[i + 1])*u
        : i == len(C) - 1
          ? C[i] + normal_derecha(C[i - 1], C[i])*u
          : let (d0 = (C[i] - C[i - 1])/norm(C[i] - C[i - 1]),
                 d1 = (C[i + 1] - C[i])/norm(C[i + 1] - C[i]),
                 q0 = C[i] + normal_derecha(C[i - 1], C[i])*u,
                 q1 = C[i] + normal_derecha(C[i], C[i + 1])*u)
            cruce_rectas(q0, d0, q1, d1)];

module chapa_polilinea_3d(C, retiro, z0, largo) {
    R = polilinea_rehundida(C, retiro);
    translate([0, 0, z0])
        linear_extrude(largo)
            for (i = [0 : len(R) - 2]) tramo_chapa(R[i], R[i + 1]);
}

module nariz() {
    C = nariz_contorno();
    difference() {
        union() {
            // El pie queda a ras; la muesca nace del salto axial hasta el rebaje.
            chapa_polilinea_3d([C[0], C[1]], 0, pie_z0(), entre_anillos());
            chapa_polilinea_3d([C[1], C[2], C[3]], rehundido_chapa,
                               chapa_z0(), chapa_largo_rebaje());
            // La cola bajo el panel no se ve ni entra en el rebaje del anillo.
            chapa_polilinea_3d([C[3], C[4]], 0, pie_z0(), entre_anillos());
        }
        for (z = nariz_m4_z())
            translate([nariz_m4_x(), -0.1, z])
                rotate([-90, 0, 0])
                    cylinder(d = d_M4_paso + kerf, h = t_costilla + 0.2);
    }
}

// El DXF: el desarrollo plano, con el CANTO LIBRE DEL PIE en y = 0 -- un canto
// libre no se mueve al plegar, asi que los M4 caen a 1.5 D de el sin que los
// dobleces entren en la cuenta. Las lineas de plegado van en el pliego.
// LA MUESCA DEL PIE, en el desarrollo (2026-08-30). El blank mide lo que entra
// en rebaje; el PIE tiene que salir de el mas estrecho, porque apoya a ras en
// la tabla entre las caras de los anillos. Asi que se corta muesca_pie() en
// cada punta, desde el canto libre del pie hasta la LINEA DE DOBLEZ -- que no
// esta a "largo del pie" del canto sino a largo - BD/2, la misma linea que ya
// cota el PLIEGO --, con un alivio de Ø2 a caballo de esa linea en la esquina
// interior, como el de las pestanas: sin el, el doblez rasga desde la esquina.
// El parametro s dice hacia donde crece el desarrollo desde el canto del pie:
// +1 en la nariz (el pie en y = 0), -1 en el talon (el pie en y = d).
module muesca_pie_2d(largo, y_pie, s, largo_pie_local) {
    m = muesca_pie();
    y_doblez = y_pie + s*(largo_pie_local - doblez_bd(45)/2);
    for (x0 = [0, largo - m]) {
        // el rectangulo, del canto libre a la linea de doblez
        translate([x0, min(y_pie, y_doblez)]) square([m, abs(y_doblez - y_pie)]);
        // y el alivio, centrado en la esquina interior sobre esa linea
        translate([x0 == 0 ? m : largo - m, y_doblez])
            circle(d = alivio_pestana + kerf, $fn = 24);
    }
}

module nariz_2d() {
    largo = chapa_largo_rebaje();
    difference() {
        square([largo, nariz_desarrollo()]);
        // el pie va en y = 0 y el desarrollo crece hacia +y
        muesca_pie_2d(largo, 0, +1, nariz_pie);
        // D-T2 (papel del suelo): tuerca CLS-M4 prensada en el pie; el M4 entra desde abajo.
        for (z = nariz_m4_z())
            translate([z - chapa_z0(), m4_pie_borde()])
                circle(d = pem_cls_m4 + kerf);
    }
}

// --- LA SECCION DEL ANILLO, y el cupon que se corta de ella --------------
// EL UNICO PLANO QUE DICE LAS PROFUNDIDADES (#237). Los dos ficheros del anillo
// son vistas de planta: costilla_2d lleva la silueta y la ventana, y
// costilla_dorso_2d el contorno del rebaje. Entre los dos cierran las cotas EN
// EL PLANO -- cara_anillo y rebaje_anillo, y las cruzan anillo_tiene_ventana()
// y anillo_tiene_rebaje() releyendo los ficheros --, pero ninguno de los dos
// sabe decir "14 de pletina", "11 de profundidad de rebaje" ni "1.5 x 45": eso
// es justamente lo que un DXF de planta no puede escribir. Hasta hoy esas tres
// cotas solo vivian en params.scad y en la prosa del pliego.
//
// Se dibuja con la CARA VISTA ABAJO (y = 0) y la pletina creciendo hacia y+,
// que es como se lee montada: lo que se ve del case es el canto de abajo.
//
// LAS DOS ARISTAS DE LA CARA VAN CHAFLANADAS, no una: costilla() aplica sus
// seis rodajas con offset(-f) sobre la silueta Y offset(-cara + f) sobre la
// ventana. Dibujar una sola aqui mandaria fresar un cupon que no es el perfil.
// EL CUPON GANA EL REBAJE DE CHAPA Y SU REBORDE (2026-08-30). Hasta hoy la
// seccion tenia ocho vertices y describia el anillo de antes; el PLIEGO y el
// RFQ ya prometen que la muestra valida el rebaje de 4.5 x 3 y el reborde de
// 1 x 3, que es LA COTA DELICADA de la pieza entera -- una pared de 1 mm de
// ancho por 3 de alto, y la unica que se ve. Un hold point que no puede medir
// lo que dice medir es peor que no tenerlo: aprueba una muestra que no prueba
// nada. Doce vertices: los ocho de siempre mas la muesca del rebaje, que deja
// el reborde entre ella y el canto.
module seccion_anillo_2d() {
    c = chaflan_anillo;
    W = cara_anillo;
    T = t_anillo;
    R = rehundido_acrilico;
    B = rebaje_anillo;
    u0 = rehundido_chapa;          // donde muere el reborde
    u1 = rehundido_trasera();      // el suelo del rebaje
    z0 = T - rebaje_chapa;         // el fondo del rebaje, desde la cara vista
    polygon([[c, 0], [W - c, 0], [W, c], [W, R], [W - B, R], [W - B, T],
             [u1, T], [u1, z0], [u0, z0], [u0, T],
             [0, T], [0, c]]);
}

// LOS BOLSILLOS DE LA PERSIANA (2026-10-11): por la cara de FUERA del anillo,
// que ahora tapa la persiana, uno por taco. El localizador a d_taco (H7, en el
// pliego); la colisa, alargada en x; los demas con holgura. Debajo, el asiento
// del iman (fino en el tramo de atras: detras esta el bolsillo de la trasera).
// Lo vigilan guarda_tacos_persiana() (cotas) y anillo_tiene_bolsillos() (DXF).
function alto_iman_anillo_de(tipo) = tipo == "fino" ? alto_iman_fino : alto_iman_anillo;
module bolsillo_taco_2d(tipo)
    if (tipo == "colisa")
        hull() for (dx = [-(colisa_taco - d_taco)/2, (colisa_taco - d_taco)/2])
            translate([dx, 0]) circle(d = d_taco, $fn = 48);
    else circle(d = tipo == "loc" ? d_taco : d_bolsillo_taco, $fn = 48);
module bolsillo_taco(tipo) {
    translate([0, 0, -0.1]) linear_extrude(hondo_bolsillo_taco + 0.1) bolsillo_taco_2d(tipo);
    translate([0, 0, hondo_bolsillo_taco - 0.01])
        cylinder(d = d_iman + 0.1, h = alto_iman_anillo_de(tipo) + 0.11, $fn = 32);
}
// El DXF de la CARA DE FUERA: lo que se fresa por delante. Cada bolsillo con
// el asiento del iman dibujado dentro (como agujero, para que su circunferencia
// salga en el fichero); las profundidades van en el pliego.
module costilla_bolsillos_2d()
    for (t = tacos_persiana) translate([t[0], t[1]]) difference() {
        bolsillo_taco_2d(t[2]);
        circle(d = d_iman + 0.1, $fn = 32);
    }

module costilla() {
    n = 6;
    difference() {
        union() {
            for (i = [0 : n-1])
                let (f = chaflan_anillo * (1 - (i + 0.5)/n))
                translate([0, 0, i*chaflan_anillo/n])
                    linear_extrude(chaflan_anillo/n + 0.01)
                        difference() {
                            offset(delta = -f) perfil_lateral();
                            ventana_anillo_2d(f);
                        }
            translate([0, 0, chaflan_anillo])
                linear_extrude(t_anillo - chaflan_anillo) anillo_2d();
        }
        // el rebaje, por detras
        translate([0, 0, rehundido_acrilico])
            linear_extrude(t_anillo) rebaje_2d();
        // EL BOLSILLO DE LA TRASERA (2026-08-29, noche, 2), por detras, en el
        // tramo trasero: rebaje_anillo de hondo desde la cara interior,
        // cerrado por los dos extremos.
        translate([0, 0, t_anillo - rebaje_anillo])
            linear_extrude(rebaje_anillo + 0.1)
                bolsillo_trasero_2d();
        // El rebaje de chapa y el cajeado comparten suelo a 3 de la cara interior.
        translate([0, 0, t_anillo - rebaje_chapa])
            linear_extrude(rebaje_chapa + 0.1) {
                rebaje_chapa_2d();
                cajeado_brida_2d();
            }
        // los bolsillos de la persiana, por la cara de fuera (z = 0)
        for (t = tacos_persiana) translate([t[0], t[1], 0]) bolsillo_taco(t[2]);
    }
}

// El plegado de la chapa de LOS TRES MIEMBROS. Se llamo cost_bd() hasta el
// 2026-08-28 y la formula es la MISMA -- setback por dos menos el arco de la
// fibra neutra --, con los mismos parametros: es el mismo material y el mismo
// radio. Cambia el nombre y nada mas, porque la costilla dejo de plegarse y el
// nombre viejo prometia una pieza que ya no se dobla.
function miembro_bd() = 2*(radio_doblez_costilla + t_costilla)
                        - PI/2*(radio_doblez_costilla + k_factor*t_costilla);

// --- LA BRIDA DE EXTREMO, en el desarrollo ------------------------------
// Lo que la lengueta sobresale del recorte una vez descontado su doblez, y
// donde cae en el blank un punto que en la pieza montada esta a profundidad d
// del pliegue. Misma pareja de cuentas que pv_vuelo()/pv_desarrollo() para la
// pestana del valle, con los parametros de ESTA chapa.
// Bend deduction de un doblez a cualquier angulo (grados) en esta chapa. A 90
// da lo mismo que miembro_bd(): SB = (r + t)*tan(a/2), BA = a*(r + k*t).
// GEMELA de _bd_angulo() en clearance_budget.py.
function doblez_bd(a) = 2*(radio_doblez_costilla + t_costilla)*tan(a/2)
                        - a*PI/180*(radio_doblez_costilla + k_factor*t_costilla);
function brida_vuelo_dsr() = brida_largo - miembro_bd();
function brida_dsr(d) = miembro_bd() - d;

// La lengueta tumbada: un rectangulo pegado a cada punta del recorte, dentro
// de la banda del alma. Se dobla sobre una linea PERPENDICULAR al canto del
// anillo -- por eso su largo corre a lo largo del canto -- y lleva relieve en
// las dos esquinas, que en el desarrollo es el propio hueco entre bandas.
module brida_2d(y_centro, ancho, vuelo = 0) {
    v = vuelo > 0 ? vuelo : brida_vuelo_dsr();
    for (lado = [0, 1])
        translate([lado ? chapa_largo_rebaje() : -v, y_centro - ancho/2])
            rect_redondeado_2d(v, ancho, min(radio_brida, v/2));
}

// Sus dos M4 de paso: uno a brida_raiz() del pliegue (regla de chapa) y otro
// a 1.5 D del canto libre. dy desplaza la fila respecto al centro de la banda.
module brida_agujeros_2d(y_centro, dy) {
    for (lado = [0, 1], d = [brida_s_in(), brida_largo - 1.5*d_M4_paso])
        translate([lado ? chapa_largo_rebaje() - brida_dsr(d) : brida_dsr(d),
                   y_centro + dy])
            circle(d = d_M4_paso + kerf);
}

// El solido de una brida: chapa plana contra la cara que la recibe.
module brida_3d(x0, y0, ancho_x, ancho_y, z0, largo) {
    for (z = [z0, z0 + largo - t_costilla])
        translate([x0, y0, z])
            linear_extrude(t_costilla)
                rect_redondeado_2d(ancho_x, ancho_y, radio_brida);
}

// --- EL TECHO Y EL TALON (2026-08-29, noche, 2) -------------------------
//
// El TECHO (miembro alto) es la meseta del pico al canto con su retorno en
// el pico, y por detras baja de dos maneras, que se escogieron mirando --
// B, el 2026-08-30 -- (remate_trasero_chaflan): A, la banda plana de banda_trasera sobre una
// esquina de radio_chapa (la de #241); B, un chaflan de chaflan_nariz sobre
// P6... sobre P5, a chaflan como P0 y P6, y un labio vertical de techo_labio.
// Sin canal: en una sola chapa el labio no puede tapar el canto del
// acrilico Y tener un retorno detras, y el bolsillo de los anillos ya
// retiene la trasera en las dos direcciones por los lados. Sus dos bridas
// doblan del extremo del labio (o de la banda) como siempre; en B suben junto
// a la tira del chaflan y llevan un RELIEVE (un corte en la linea del
// doblez). Lo que aguanta solo lo mide guarda_miembro_alto(): es lo que puso
// techo_labio en 18.
//
// El TALON es la nariz de atras: pie sobre la tabla (tres M4 desde dentro),
// chaflan a 45 sobre P6 y labio vertical de talon_labio a ras del plano
// trasero, que tapa el canto de abajo de la trasera. Y talon_pestana_n
// PESTANAS lanzadas del pie, dobladas hacia arriba detras de la trasera: su
// tope hacia dentro, y estructura (guarda_trasera_flexion).
// Ni bridas ni rosca en el anillo. Lo mide guarda_talon().
//
// Los desarrollos son para el taller; los solidos, para colisiones y render.

// Desarrollo del techo, tumbado y macizo: el labio (o la banda) abajo con su canto
// libre en y = 0, el chaflan (B), la meseta y el retorno arriba, con un BD
// por doblez. Las bridas salen de las puntas del labio, con su relieve. La
// salida de aire queda bajo el alero, no atraviesa la meseta.
function techo_cara_alto() = remate_trasero_chaflan ? techo_labio + chaflan_nariz
                                                    : banda_trasera;
function techo_y_meseta0() = remate_trasero_chaflan
    ? techo_labio + chaflan_nariz*sqrt(2) - 2*doblez_bd(45)
    : banda_trasera - miembro_bd();
function techo_meseta_dev() = remate_trasero_chaflan ? prof_sup - chaflan_nariz : prof_sup;
module miembro_alto_2d() {
    retorno = retorno_meseta - doblez_bd(90 - angulo_superior);
    y_meseta0 = techo_y_meseta0();
    desarrollo = y_meseta0 + techo_meseta_dev() + retorno;
    largo = chapa_largo_rebaje();
    vuelo = brida_vuelo_dsr();
    y_brida = techo_cara_alto() - t_costilla - brida_ancho;
    difference() {
        union() {
            square([largo, desarrollo]);
            for (lado = [0, 1])
                translate([lado ? largo : -vuelo, y_brida])
                    rect_redondeado_2d(vuelo, brida_ancho,
                                       min(radio_brida, vuelo/2));
        }
        brida_agujeros_2d(techo_cara_alto(), -dist_rosca_ciega);
        // EL RELIEVE de la brida (B): la brida sube por encima del labio, junto
        // a la tira del chaflan, y un corte de corte_pestana en la linea del
        // doblez la suelta de ella para que no la arrastre al plegar. Y SU
        // ESQUINA DE ARRIBA VA A CHAFLAN: apoya en la cara del anillo, que en
        // P5 esta cortada a 45 (u + v = chaflan), y lo que quede fuera de esa
        // linea seria brida en el aire. Gemelo del poligono de _bridas().
        if (remate_trasero_chaflan)
            for (lado = [0, 1]) {
                s = lado ? 1 : -1;
                x0 = lado ? largo : 0;
                translate([x0 - (lado ? 0 : corte_pestana), techo_labio])
                    square([corte_pestana, chaflan_nariz - t_costilla + corte_pestana]);
                polygon([[x0, techo_cara_alto() - chaflan_nariz + t_costilla],
                         [x0, techo_cara_alto() - t_costilla + 0.01],
                         [x0 + s*(chaflan_nariz - 2*t_costilla), techo_cara_alto() - t_costilla + 0.01]]);
            }
    }
}

// El contorno exterior del talon en el plano del perfil, del labio hacia el
// pie -- en ese orden el interior queda a la derecha de cada tramo, que es
// lo que tramo_chapa() necesita. GEMELO del contorno de _talon().
function talon_contorno() =
    let (c = chaflan_nariz, pf = pts_perfil()[6].x)
    [[pf, c + talon_labio], [pf, c], [pf - c, 0], [pf - c - talon_pie, 0]];
// Desarrollo: labio + chaflan + pie menos los dos dobleces a 45.
function talon_desarrollo() =
    talon_labio + chaflan_nariz*sqrt(2) + talon_pie - 2*doblez_bd(45);

// Desarrollo del talon: el labio abajo (su canto libre en y = 0), el chaflan,
// el pie arriba con su canto libre en y = desarrollo. Los tres M4 del pie a
// 1.5 D de ese canto, en las mismas z que los de la nariz, y las ventanas de
// las pestanas: un corte en U (tres lados de kerf) que deja la linea del
// doblez sin cortar, hacia el canto libre del pie, con un taladro de alivio
// en cada esquina del corte, a caballo de la linea del doblez.
module talon_2d() {
    d = talon_desarrollo();
    largo = chapa_largo_rebaje();
    difference() {
        square([largo, d]);
        // el pie va en y = d y el desarrollo crece hacia -y
        muesca_pie_2d(largo, d, -1, talon_pie);
        // D-T2 (papel del suelo): tuerca CLS-M4 prensada en el pie; el M4 entra desde abajo.
        for (z = nariz_m4_z())
            translate([z - chapa_z0(), d - m4_pie_borde()])
                circle(d = pem_cls_m4 + kerf);
        // el corte en U, de corte_pestana de ancho, POR FUERA de la pestana:
        // la pestana mide talon_pestana_ancho x su desarrollo, y el corte la
        // rodea por los dos lados y por el fondo, dejando el doblez sin cortar
        for (zc = talon_pestana_z()) {
            zb = zc - chapa_z0();       // el blank arranca en el rebaje, no en la cara
            ym = d - (talon_pestana_x() - talon_x_pie());
            dv = talon_pestana_dev();
            w  = talon_pestana_ancho;
            k  = corte_pestana;
            translate([zb - w/2 - k, ym]) square([k, dv + k]);
            translate([zb + w/2, ym]) square([k, dv + k]);
            translate([zb - w/2 - k, ym + dv]) square([w + 2*k, k]);
            // el alivio: un taladro a caballo de la linea del doblez en cada
            // esquina del corte, centrado en el propio corte
            for (s = [-1, 1])
                translate([zb + s*(w/2 + k/2), ym])
                    circle(d = alivio_pestana + kerf, $fn = 24);
        }
    }
}

function miembros_z0() = chapa_z0();
function techo_contorno() =
    let (P = pts_perfil(), d = [sin(angulo_superior), cos(angulo_superior)],
         pf = P[6].x, yt = P[5].y, c = chaflan_nariz)
    remate_trasero_chaflan
    ? [P[4] - d*retorno_meseta, P[4], [pf - c, yt],
       [pf, yt - c], [pf, y_labio_techo()]]
    : [P[4] - d*retorno_meseta, P[4], P[5],
       [pf, yt - banda_trasera]];
function techo_contorno_rehundido() =
    polilinea_rehundida(techo_contorno(), rehundido_chapa);

module miembro_alto() {
    P = pts_perfil();
    y1 = y_meseta();
    z0 = miembros_z0();
    pf = P[6].x;
    yt = P[5].y;
    c = chaflan_nariz;
    // Retorno, meseta, chaflan y labio forman una sola piel, retirada 1 mm.
    chapa_polilinea_3d(techo_contorno(), rehundido_chapa,
                       z0, chapa_largo_rebaje());
    // las dos bridas, planas contra la franja de la MESETA del anillo, de
    // t_costilla bajo la meseta hacia abajo. Con el techo en chaflan (B) su
    // esquina de arriba-atras va cortada a 45 como la del anillo: lo que
    // quedara fuera de u + v = chaflan seria brida en el aire (y asomaba por
    // el chaflan en el render). Gemelo del poligono de _bridas().
    // En y la brida NO se mueve con el rehundido: dobla del extremo del labio,
    // que sigue muriendo en y_labio_techo(), y su canto de arriba queda donde
    // hoy (y_meseta). Subirla hol_chapa metia el cajeado en el reborde.
    // EN z LA BRIDA ARRANCA DONDE ARRANCA EL TECHO, no en el suelo del
    // cajeado: es el MISMO BLANK -- la brida es el vuelo de la punta, doblado
    // 90 sobre el canto --, asi que su cara exterior y el canto del techo son
    // el mismo plano por construccion. Con z0 en el suelo del cajeado (11) y
    // el canto del techo en 11.5, la brida asomaba 0.5 mm por fuera de su
    // propia chapa, y se veia en el primer plano de la esquina. Dentro del
    // cajeado sigue: 11.5..13 contra un cajeado de 11..14. No apoya en el
    // suelo, y no tiene que hacerlo -- la posicionan sus dos M4, como el
    // rebaje posiciona al techo (§4.1: "el suelo no posiciona").
    difference() {
        brida_3d(brida_x_dob() - brida_largo, y1 - brida_ancho,
                 brida_largo,
                 brida_ancho, chapa_z0(), chapa_largo_rebaje());
        // El corte a 45 sigue al chaflan de la CHAPA, no al del anillo: la
        // brida muere hol_chapa dentro de la pared del cajeado (u = 1.5). Con
        // el corte en el contorno del anillo asomaba una lasca en el chaflan.
        if (remate_trasero_chaflan)
            translate([0, 0, -1])
                linear_extrude(ancho_total + 2)
                    difference() {
                        translate([-10, -10]) square([pf + 20, yt + 20]);
                        offset(delta = -(rehundido_chapa + hol_chapa))
                            perfil_lateral();
                    }
    }
}

module talon() {
    C = talon_contorno();
    difference() {
        union() {
            chapa_polilinea_3d([C[0], C[1], C[2]], rehundido_chapa,
                               chapa_z0(), chapa_largo_rebaje());
            chapa_polilinea_3d([C[2], C[3]], 0, pie_z0(), entre_anillos());
        }
        for (z = nariz_m4_z())
            translate([talon_m4_x(), -0.1, z])
                rotate([-90, 0, 0])
                    cylinder(h = t_costilla + 0.2, d = d_M4_paso + kerf);
        // las ventanas de las pestanas, en el pie
        for (zc = talon_pestana_z())
            translate([talon_pestana_x() - talon_pestana_dev(), -0.1,
                       zc - talon_pestana_ancho/2])
                cube([talon_pestana_dev(), t_costilla + 0.2, talon_pestana_ancho]);
    }
    // las pestanas, de pie detras de la trasera
    for (zc = talon_pestana_z())
        translate([talon_pestana_x() - t_costilla, t_costilla,
                   zc - talon_pestana_ancho/2])
            cube([t_costilla, talon_pestana_alto, talon_pestana_ancho]);
}

module miembros() {
    miembro_alto();
    talon();
}

module rail_2020(largo) { cube([rail, largo, rail], center = true); }

// Riel EUROrack. Los ejes locales no son intercambiables como en el 2020: tras
// el rotate([0,0,-a]) rotate([90,0,0]) de rails(), la X local acaba sobre la
// NORMAL INTERIOR de la cara (o sea el fondo del riel) y la Z local sobre la
// direccion de la cara (su alto). Verificado con las dos matrices a mano.
module rail_er(largo) { cube([rail_er_fondo, largo, rail_er_alto], center = true); }

// --- planchas rectangulares del cuerpo (cada una con SU espesor) ------
// Agujeros M3 contra la RETICULA de los miembros de chapa, repartidos a ~paso.
// Fueron tuercas T en la ranura de los largueros 2020 hasta el 2026-08-27:
// alli el reparto daba igual porque la ranura era corrida. Ahora no.
//
// IBA DESCENTRADA y nadie la miraba: arrancaba en paso/2 y avanzaba de paso en
// paso hasta donde llegara, o sea que sobre 528.32 dejaba 50.00 de orilla a la
// izquierda y 78.32 a la derecha. 28 mm de diferencia en la pieza que carga el
// transformador. El paso ahora se estira para caber un numero entero de veces,
// que es lo que el codigo viejo QUERIA decir con ese paso/2 de arranque:
// orillas iguales y valiendo medio paso.
// Cuantos tornillos caben en un largo con el paso nominal. Se saca aparte
// porque la tabla la necesita para su propia fila y no puede usar
// fila_agujeros(): sus agujeros van ALARGADOS, no redondos.
// Sin largo, la fila de M5 de la tabla, que se reparte en el fondo del CUERPO
// y no en el de la tabla (10-10): el vuelo es cota de mirar, y medida en la
// tabla un vuelo de 40 subia la fila de 3 a 4 tornillos y movia las roscas
// ciegas del anillo.
function n_agujeros(largo = 0, paso = reticula_paso) =
    max(1, round((largo == 0 ? fondo() : largo)/paso));

module fila_agujeros(largo, y, paso = reticula_paso, d = d_M3_paso) {
    n = max(1, round(largo/paso));
    e = largo/n;                       // paso real, <= paso pedido + pico
    for (i = [0 : n-1])
        translate([e*(i + 0.5), y]) circle(d = d + kerf);
}

module plancha(l, a) square([l, a]);   // l = ancho_util, a = fondo local
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
