sssamuelll/analog-modular-synthesizer/hardware/01-power-supply/schematics/sam17-power.pdf

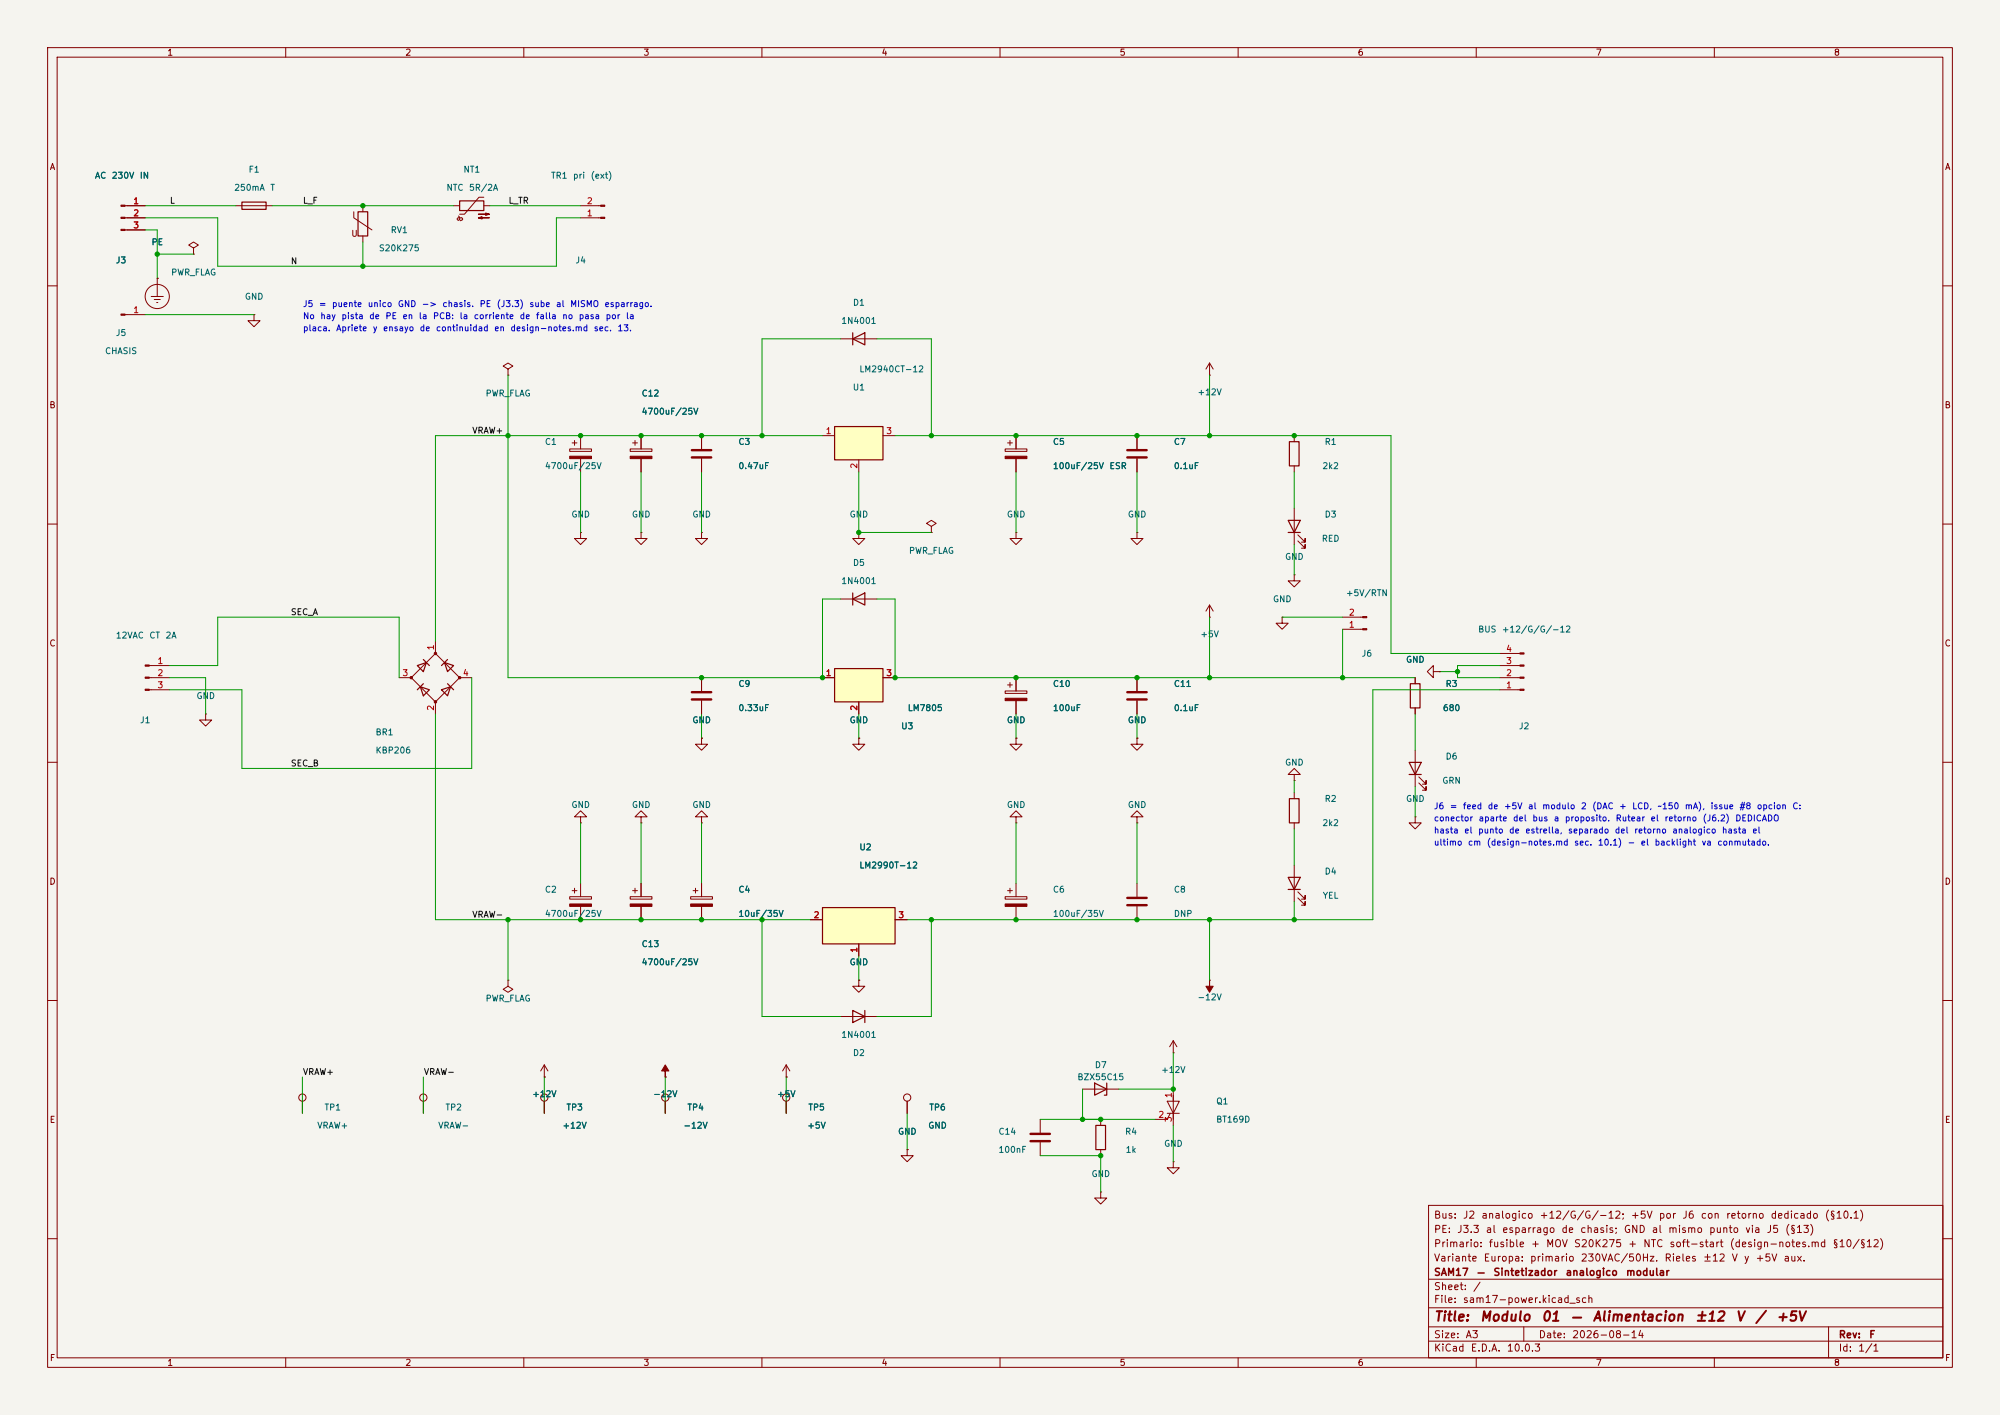
[picture p52: page 1]

No hay pista de PE en la PCB: la corriente de falla no pasa por la

J6 = feed de +5V al modulo 2 (DAC + LCD, ~150 mA), issue #8 opcion C:
conector aparte del bus a proposito. Rutear el retorno (J6.2) DEDICADO

Bus: J2 analogico +12/G/G/-12; +5V por J6 con retorno dedicado (§10.1)
PE: J3.3 al esparrago de chasis; GND al mismo punto via J5 (§13)
Variante Europa: primario 230VAC/50Hz. Rieles ±12 V y +5V aux. Primario: fusible + MOV S20K275 + NTC soft-start (design-notes.md §10/§12)

Size: A3 | Rev: F | F Date: 2026-08-14
KiCad E.D.A. 10.0.3 | Id: 1/1
