sssamuelll/analog-modular-synthesizer/hardware/01-power-supply/v5/schematics/sam17-power-v5.pdf

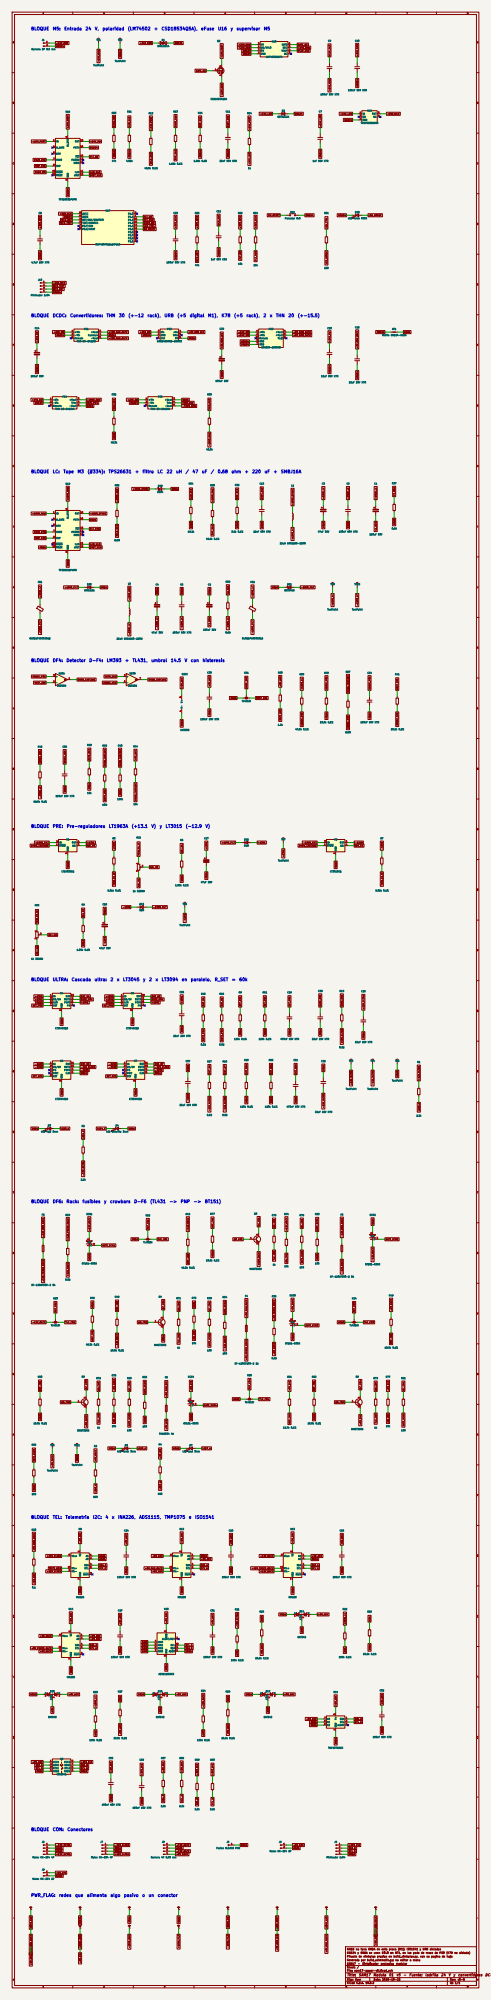
[picture p53: page 1]

FLT 15 PGTH 16 PGOOD 17 OUT 18 U16

dVdT 10 ILIM 11 MODE 12 SHDN 13

FLT 15 PGTH 16 PGOOD 17 OUT 18 U19

BLOQUE PRE: Pre-reguladores LT1963A (+13.1 V) y LT3015 (-12.9 V)

BLOQUE DF6: Rack: fusibles y crowbars D-F6 (TL431 -> PNP -> BT151)

PWR_FLAG: redes que alimenta algo pasivo o un conector

GNDD no toca GNDA en esta placa (M1): ISO1541 y URB aislados
GND24 y GNDA se unen SOLO en NT1, en los pads de masa de PS3 (K78 no aislado)
Generado por build_schematic.py: no editar a mano Pinouts de simbolos propios en build_simbolos.py, con su pagina de hoja

SAM17 - Sintetizador analogico modular
Sheet: /
File: sam17-power-v5.kicad_sch
Title: SAM17 Modulo 01 v5 - Fuente: ladrillo 24 V y convertidores DC-DC

Size: User | Rev: v5-B
