sssamuelll/analog-modular-synthesizer/hardware/01-power-supply/pcb/sam17-power.pdf

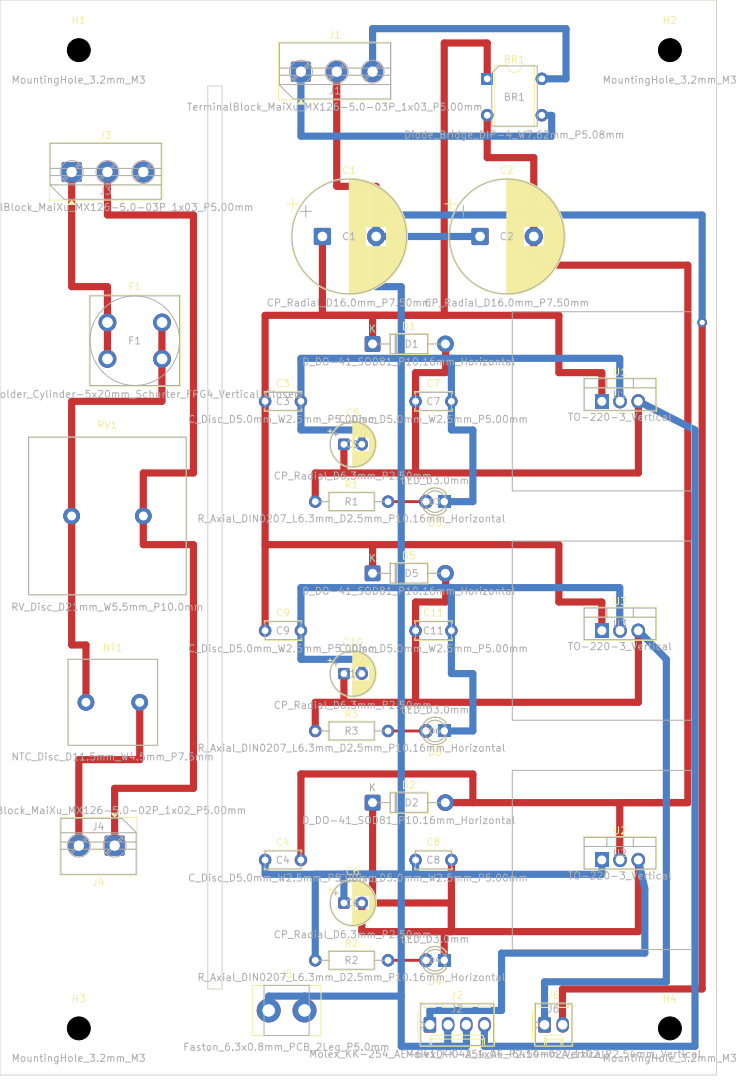
[picture p60: page 1]
