sssamuelll/analog-modular-synthesizer/hardware/01-power-supply/v3/schematics/sam17-power-v3.pdf

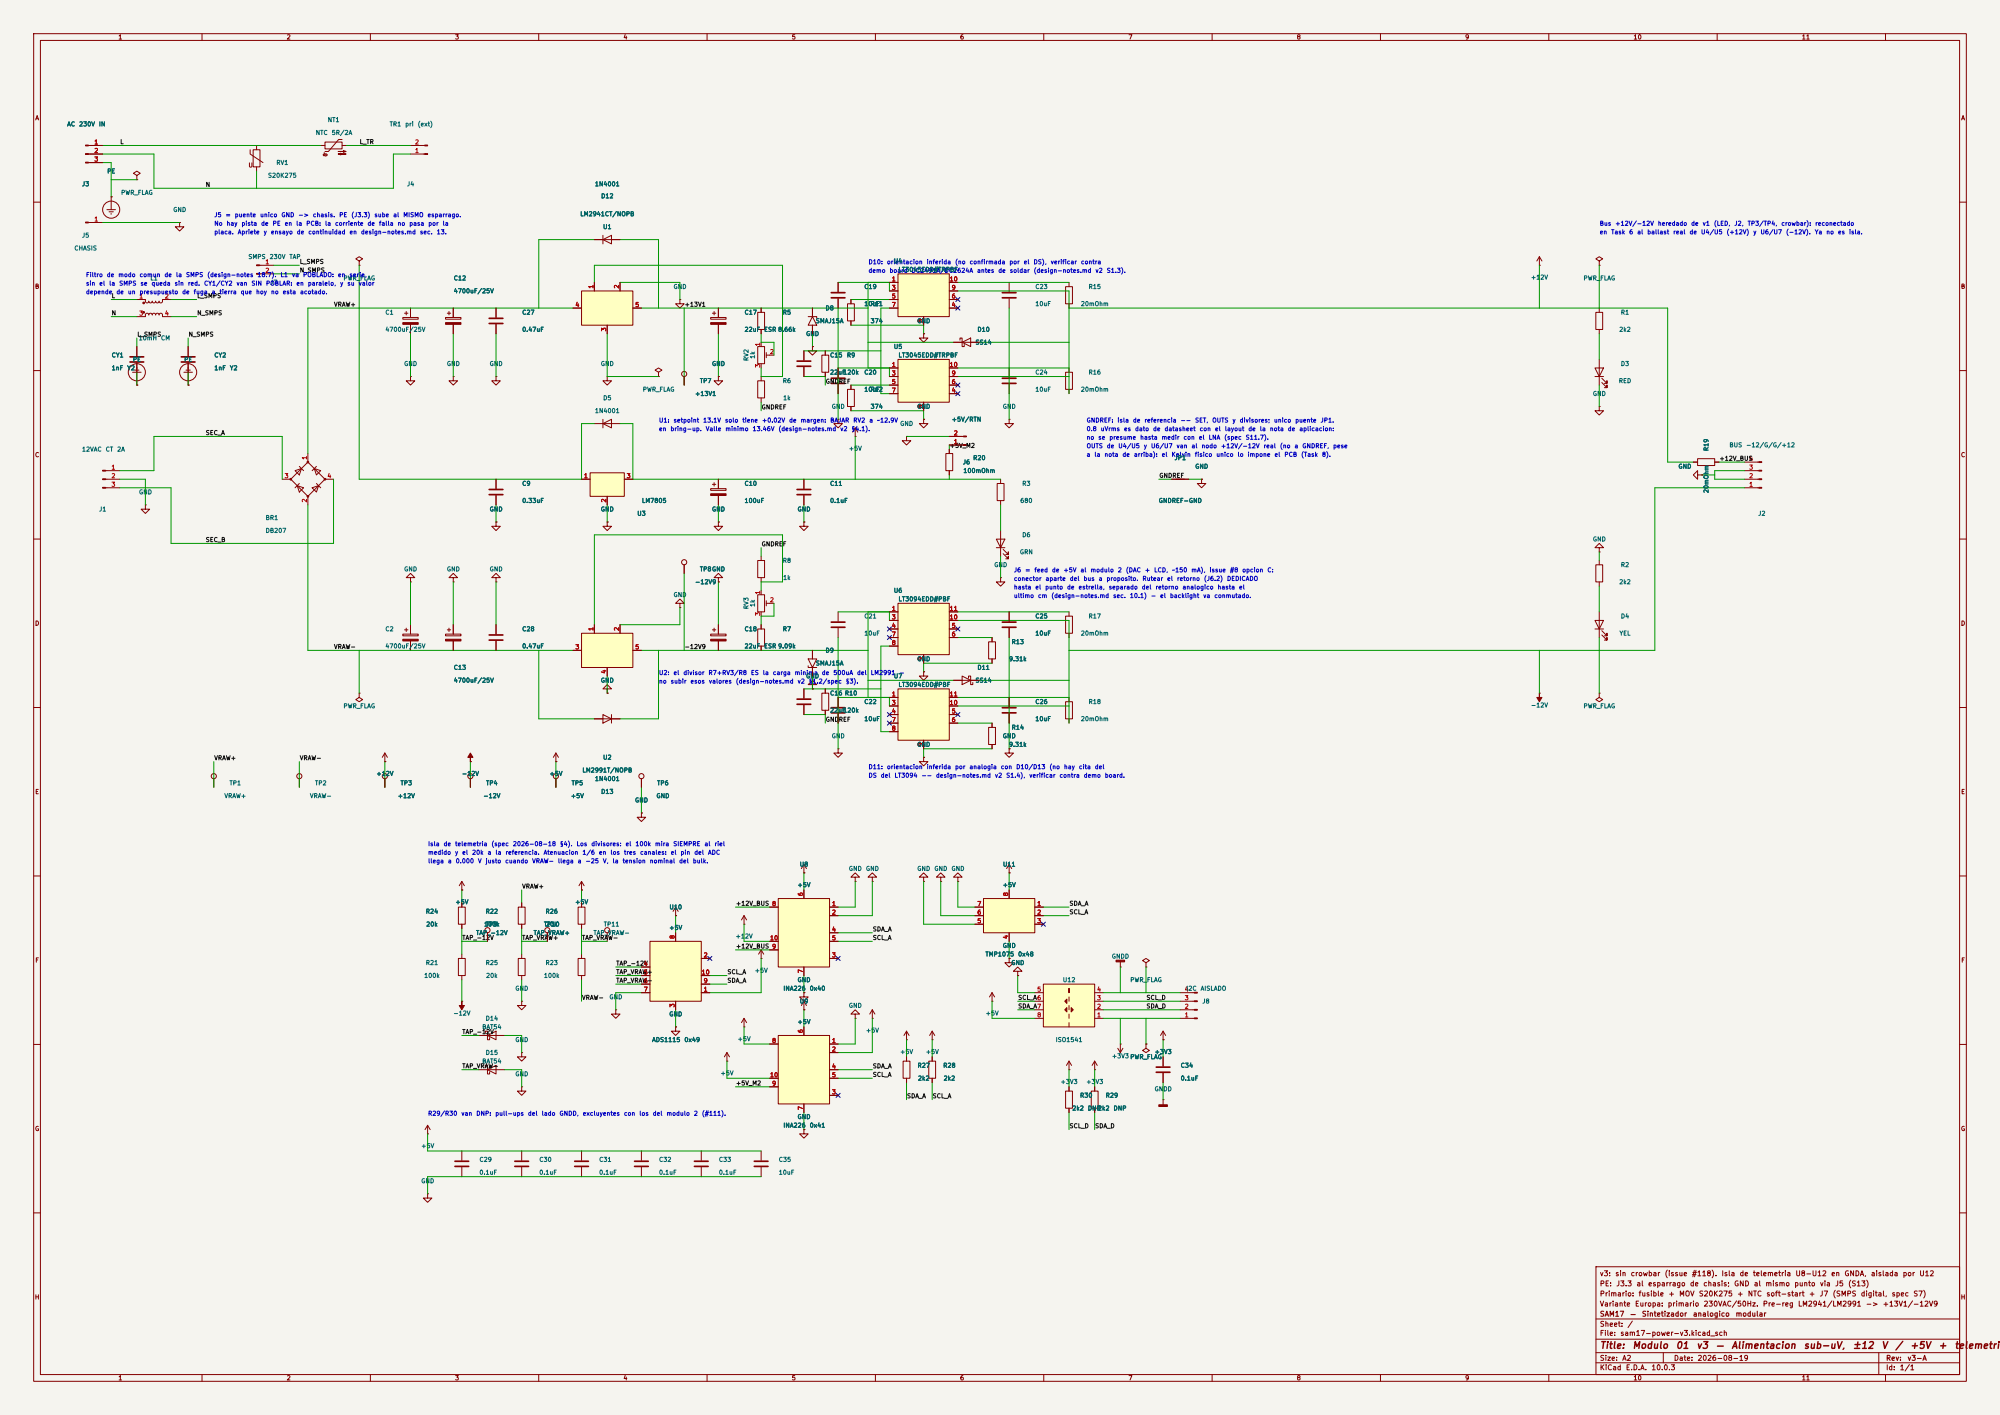
[picture p68: page 1]

ultimo cm (design-notes.md sec. 10.1) - el backlight va conmutado. OUTS de U4/U5 y U6/U7 van al nodo +12V/-12V real (no a GNDREF, pese No hay pista de PE en la PCB: la corriente de falla no pasa por la

depende de un presupuesto de fuga a tierra que hoy no esta acotado.

U1: setpoint 13.1V solo tiene +0.02V de margen: BAJAR RV2 a ~12.9V

0.8 uVrms es dato de datasheet con el layout de la nota de aplicacion: J6 = feed de +5V al modulo 2 (DAC + LCD, ~150 mA), issue #8 opcion C: DS del LT3094 -- design-notes.md v2 S1.4), verificar contra demo board.

conector aparte del bus a proposito. Rutear el retorno (J6.2) DEDICADO

no subir esos valores (design-notes.md v2 §1.2/spec §3).

D11: orientacion inferida por analogia con D10/D13 (no hay cita del

Isla de telemetria (spec 2026-08-18 §4). Los divisores: el 100k mira SIEMPRE al riel medido y el 20k a la referencia. Atenuacion 1/6 en los tres canales: el pin del ADC

llega a 0.000 V justo cuando VRAW- llega a -25 V, la tension nominal del bulk.

R29/R30 van DNP: pull-ups del lado GNDD, excluyentes con los del modulo 2 (#111).

v3: sin crowbar (issue #118). Isla de telemetria U8-U12 en GNDA, aislada por U12
PE: J3.3 al esparrago de chasis; GND al mismo punto via J5 (S13)
Primario: fusible + MOV S20K275 + NTC soft-start + J7 (SMPS digital, spec S7)
Variante Europa: primario 230VAC/50Hz. Pre-reg LM2941/LM2991 -> +13V1/-12V9
SAM17 — Sintetizador analogico modular
Sheet: /
File: sam17-power-v3.kicad_sch
Title: Modulo 01 v3 — Alimentacion sub-uV, ±12 V / +5V + telemetria

Size: A2 | Rev: v3-A
KiCad E.D.A. 10.0.3 | Id: 1/1
