sssamuelll/analog-modular-synthesizer/hardware/03-vco/kicad/sam17-vco.kicad_pcb

## KiCad design hardware/03-vco/kicad/sam17-vco.kicad_pcb (2026-08-22)

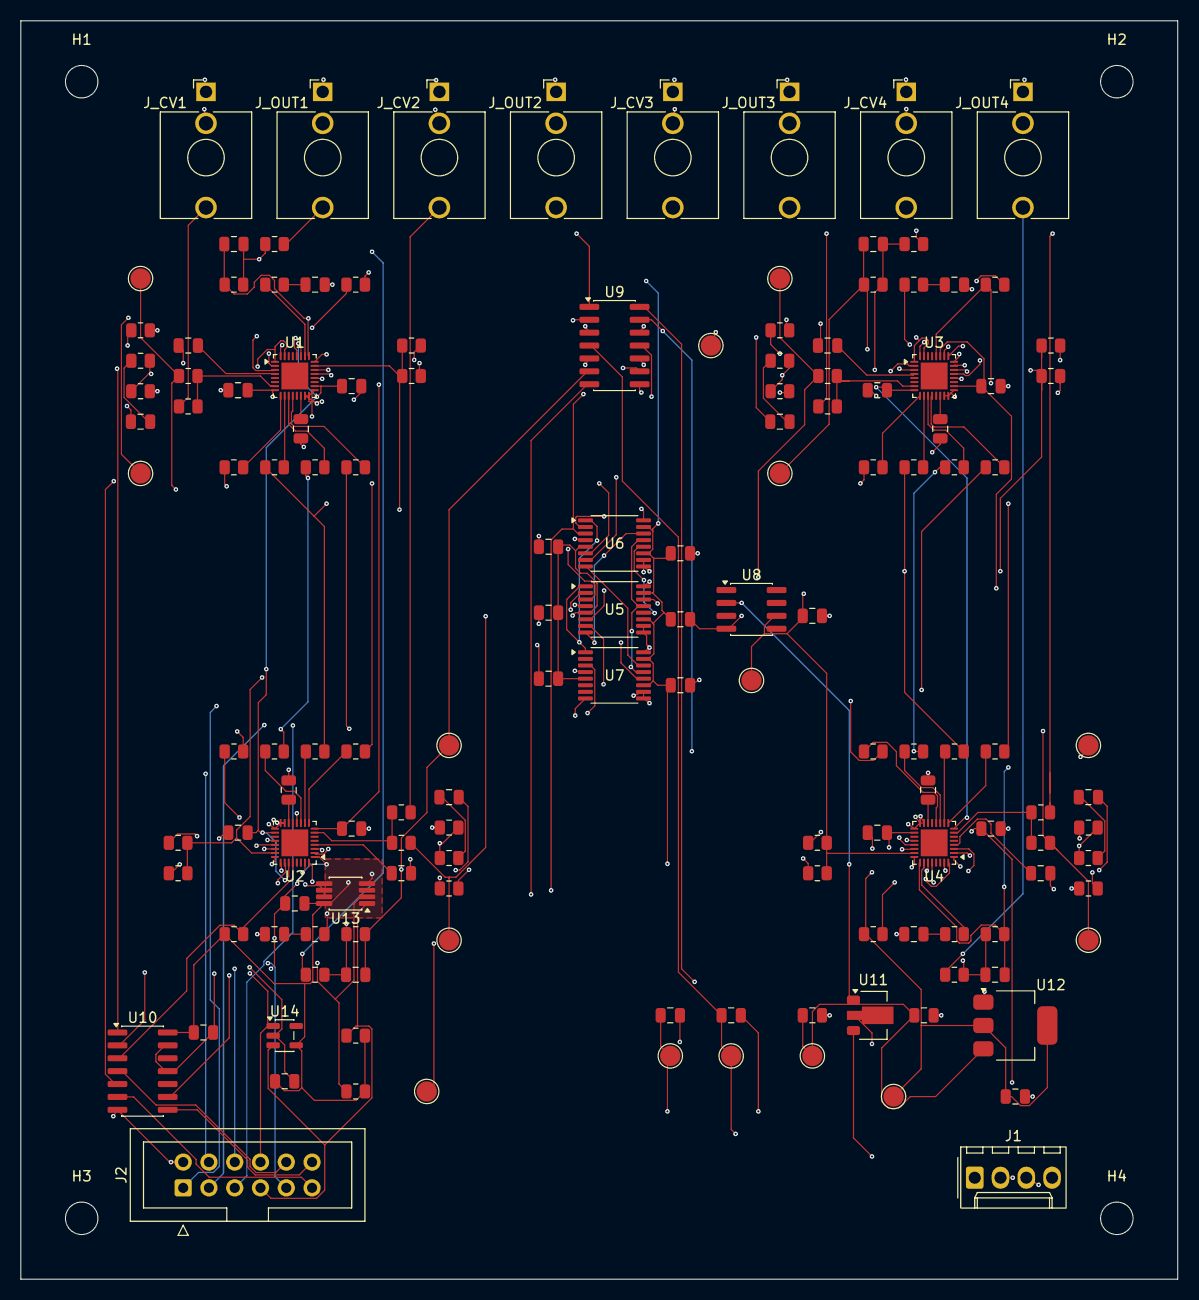
[picture p69: board sam17-vco.kicad_pcb from above]

Board: 4 copper layers, 114.0 x 124.0 mm, 148 parts (0 on the bottom side), 112 nets.

Parts:
C8, C9, C10, C11, C12, C13, C14, C15, C16, C17, C18, C19, C20, C21, C22, C23, C24, C25, C26, C27, C28, C29, C30: C_0805_2012Metric
C_AC1A, C_AC1B, C_AC2A, C_AC2B, C_AC3A, C_AC3B, C_AC4A, C_AC4B: C_0805_2012Metric
C_BW1, C_BW2, C_BW3, C_BW4: C_0805_2012Metric
C_IV1, C_IV2, C_IV3, C_IV4: C_0805_2012Metric
C_TCAP1, C_TCAP2, C_TCAP3, C_TCAP4: C_0805_2012Metric
H1, H2, H3, H4: MountingHole_3.2mm_M3
J1: Molex_KK-254_AE-6410-04A_1x04_P2.54mm_Vertical
J2: IDC-Header_2x06_P2.54mm_Vertical
J_CV1, J_CV2, J_CV3, J_CV4: Jack_3.5mm_QingPu_WQP-PJ398SM_Vertical_CircularHo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; Jack_3.5mm_QingPu_WQP-PJ398SM_Vertical_CircularHoles
J_OUT1, J_OUT2, J_OUT3, J_OUT4: Jack_3.5mm_QingPu_WQP-PJ398SM_Vertical_CircularHo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; Jack_3.5mm_QingPu_WQP-PJ398SM_Vertical_CircularHoles
R_BW1, R_BW2, R_BW3, R_BW4: R_0805_2012Metric
R_CVIN1, R_CVIN2, R_CVIN3, R_CVIN4: R_0805_2012Metric
R_I2C1, R_I2C2: R_0805_2012Metric
R_IV1, R_IV2, R_IV3, R_IV4: R_0805_2012Metric
R_LIN1, R_LIN2, R_LIN3, R_LIN4: R_0805_2012Metric
R_MIX1A, R_MIX1B, R_MIX1C, R_MIX1D, R_MIX2A, R_MIX2B, R_MIX2C, R_MIX2D, R_MIX3A, R_MIX3B, R_MIX3C, R_MIX3D, R_MIX4A, R_MIX4B, R_MIX4C, R_MIX4D: R_0805_2012Metric
R_OUT1, R_OUT2, R_OUT3, R_OUT4: R_0805_2012Metric
R_PITCH1, R_PITCH2, R_PITCH3, R_PITCH4: R_0805_2012Metric
R_SCALE1, R_SCALE2, R_SCALE3, R_SCALE4: R_0805_2012Metric
R_SIN402_1, R_SIN402_2, R_SIN402_3, R_SIN402_4, R_SIN475A_1, R_SIN475A_2, R_SIN475A_3, R_SIN475A_4, R_SIN475B_1, R_SIN475B_2, R_SIN475B_3, R_SIN475B_4: R_0805_2012Metric
R_SQ1, R_SQ2, R_SQ3, R_SQ4: R_0805_2012Metric
TP1, TP2, TP3, TP4, TP5, TP6, TP7, TP8, TP9, TP10, TP11, TP12, TP13, TP14, TP15: TestPoint_Pad_D2.0mm
U1, U2, U3, U4: QFN-32-1EP_4x4mm_P0.4mm_EP2.65x2.65mm
U5, U6, U7: TSSOP-16_4.4x5mm_P0.65mm
U8: SOIC-8_3.9x4.9mm_P1.27mm
U9, U10: SOIC-14_3.9x8.7mm_P1.27mm
U11: SOT-89-3
U12: SOT-223-3_TabPin2
U13: VSSOP-8_3x3mm_P0.65mm
U14: SOT-23-5

Connections:
+3V3_LOC: C9.1, C13.1, C15.1, C17.1, C18.1, C19.1, C20.1, R_I2C1.2, R_I2C2.2, R_SQ1.2, R_SQ2.2, R_SQ3.2, R_SQ4.2, TP4.1, U5.11, U5.15, U6.11, U6.15, U7.11, U7.15, U10.14, U12.2, U13.8, U14.4
+5V_LOC: C8.1, C10.1, C12.1, C14.1, C16.1, C21.1, C22.1, C23.1, C24.1, TP3.1, U1.18, U1.27, U2.18, U2.27, U3.18, U3.27, U4.18, U4.27, U5.5, U6.5, U7.5, U8.2, U11.1, U12.3
+12V: C25.1, J1.1, TP1.1, U9.4, U11.3
-12V: C26.1, C27.1, C28.1, C29.1, C30.1, J1.4, TP2.1, U1.8, U2.8, U3.8, U4.8, U9.11
CVIN_1: J_CV1.T, R_CVIN1.1
CVIN_2: J_CV2.T, R_CVIN2.1
CVIN_3: J_CV3.T, R_CVIN3.1
CVIN_4: J_CV4.T, R_CVIN4.1
CV_PITCH_1: R_PITCH1.1, TP6.1, U5.3
CV_PITCH_2: R_PITCH2.1, TP7.1, U5.2
CV_PITCH_3: R_PITCH3.1, TP8.1, U5.6
CV_PITCH_4: R_PITCH4.1, TP9.1, U5.7
DAC_LINK_12: U5.8, U6.14
DAC_LINK_23: U6.8, U7.14
GNDA: C8.2, C9.2, C10.2, C11.2, C12.2, C13.2, C14.2, C15.2, C16.2, C17.2, C21.2, C22.2, C23.2, C24.2, C25.2, C26.2, C27.2, C28.2, C29.2, C30.2, C_BW1.2, C_BW2.2, C_BW3.2, C_BW4.2, C_TCAP1.2, C_TCAP2.2, C_TCAP3.2, C_TCAP4.2, J1.2, J1.3, J_CV1.S, J_CV1.TN, J_CV2.S, J_CV2.TN, J_CV3.S, J_CV3.TN, J_CV4.S, J_CV4.TN, J_OUT1.S, J_OUT2.S, J_OUT3.S, J_OUT4.S, R_SIN475A_1.2, R_SIN475A_2.2, R_SIN475A_3.2, R_SIN475A_4.2, R_SIN475B_1.2, R_SIN475B_2.2, R_SIN475B_3.2, R_SIN475B_4.2, TP14.1, U1.15, U1.16, U1.17, U1.20, U2.15, U2.16, U2.17, U2.20, U3.15, U3.16, U3.17, U3.20, U4.15, U4.16, U4.17, U4.20, U5.4, U5.9, U5.10, U5.16, U6.4, U6.9, U6.10, U6.16, U7.4, U7.9, U7.10, U7.16, U8.4, U9.3, U9.5, U9.10, U9.12, U11.2, U12.1
GNDD: C18.2, C19.2, C20.2, J2.2, J2.6, TP15.1, U10.7, U10.11, U10.13, U13.4, U13.5, U13.6, U13.7, U14.2
I2C_SCL: J2.8, R_I2C2.1, U13.2, U14.1
I2C_SDA: J2.7, R_I2C1.1, U13.1, U14.3
IVO_1: C_IV1.2, R_IV1.2, R_OUT1.1, U9.1
IVO_2: C_IV2.2, R_IV2.2, R_OUT2.1, U9.7
IVO_3: C_IV3.2, R_IV3.2, R_OUT3.1, U9.8
IVO_4: C_IV4.2, R_IV4.2, R_OUT4.1, U9.14
MIXO_1: C_IV1.1, R_IV1.1, TP10.1, U1.25, U9.2
MIXO_2: C_IV2.1, R_IV2.1, TP11.1, U2.25, U9.6
MIXO_3: C_IV3.1, R_IV3.1, TP12.1, U3.25, U9.9
MIXO_4: C_IV4.1, R_IV4.1, TP13.1, U4.25, U9.13
MIX_PULSE: R_MIX1C.1, R_MIX2C.1, R_MIX3C.1, R_MIX4C.1, U6.7
MIX_SAW: R_MIX1B.1, R_MIX2B.1, R_MIX3B.1, R_MIX4B.1, U6.2
MIX_SINE: R_MIX1D.1, R_MIX2D.1, R_MIX3D.1, R_MIX4D.1, U7.3
MIX_TRI: R_MIX1A.1, R_MIX2A.1, R_MIX3A.1, R_MIX4A.1, U6.6
N2M_1: C_AC1A.2, R_SIN402_1.1
N2M_2: C_AC2A.2, R_SIN402_2.1
N2M_3: C_AC3A.2, R_SIN402_3.1
N2M_4: C_AC4A.2, R_SIN402_4.1
N2_1: R_SIN402_1.2, R_SIN475A_1.1, U1.2
N2_2: R_SIN402_2.2, R_SIN475A_2.1, U2.2
N2_3: R_SIN402_3.2, R_SIN475A_3.1, U3.2
N2_4: R_SIN402_4.2, R_SIN475A_4.1, U4.2
N3_1: R_SIN475B_1.1, U1.3
N3_2: R_SIN475B_2.1, U2.3
N3_3: R_SIN475B_3.1, U3.3
N3_4: R_SIN475B_4.1, U4.3
N4_1: C_AC1B.2, U1.4
N4_2: C_AC2B.2, U2.4
N4_3: C_AC3B.2, U3.4
N4_4: C_AC4B.2, U4.4
N7_1: R_CVIN1.2, R_PITCH1.2, U1.7
N7_2: R_CVIN2.2, R_PITCH2.2, U2.7
N7_3: R_CVIN3.2, R_PITCH3.2, U3.7
N7_4: R_CVIN4.2, R_PITCH4.2, U4.7
N9_1: R_MIX1A.2, U1.9
N9_2: R_MIX2A.2, U2.9
N9_3: R_MIX3A.2, U3.9
N9_4: R_MIX4A.2, U4.9
N10_1: R_MIX1B.2, U1.10
N10_2: R_MIX2B.2, U2.10
N10_3: R_MIX3B.2, U3.10
N10_4: R_MIX4B.2, U4.10
N11_1: R_MIX1C.2, U1.11
N11_2: R_MIX2C.2, U2.11
N11_3: R_MIX3C.2, U3.11
N11_4: R_MIX4C.2, U4.11
N12_1: R_MIX1D.2, U1.12
N12_2: R_MIX2D.2, U2.12
N12_3: R_MIX3D.2, U3.12
N12_4: R_MIX4D.2, U4.12
N14_1: C_TCAP1.1, U1.14
N14_2: C_TCAP2.1, U2.14
N14_3: C_TCAP3.1, U3.14
N14_4: C_TCAP4.1, U4.14
N21_1: R_LIN1.2, U1.21
N21_2: R_LIN2.2, U2.21
N21_3: R_LIN3.2, U3.21
N21_4: R_LIN4.2, U4.21
N22_1: R_SCALE1.2, U1.22
N22_2: R_SCALE2.2, U2.22
N22_3: R_SCALE3.2, U3.22
N22_4: R_SCALE4.2, U4.22
N26M_1: C_BW1.1, R_BW1.2
N26M_2: C_BW2.1, R_BW2.2
N26M_3: C_BW3.1, R_BW3.2
N26M_4: C_BW4.1, R_BW4.2
N26_1: R_BW1.1, U1.26
N26_2: R_BW2.1, U2.26
N26_3: R_BW3.1, U3.26
N26_4: R_BW4.1, U4.26
PWM_CV: U1.32, U2.32, U3.32, U4.32, U6.3
SINEO_1: C_AC1B.1, U1.24
SINEO_2: C_AC2B.1, U2.24
SINEO_3: C_AC3B.1, U3.24
SINEO_4: C_AC4B.1, U4.24
SPI_CS3: J2.5, U5.13, U6.13, U7.13
SPI_MISO: J2.4, U7.8
SPI_MOSI: J2.3, U5.14
SPI_SCLK: J2.1, U5.12, U6.12, U7.12
SQ_1: R_SQ1.1, U1.28, U10.1
SQ_2: R_SQ2.1, U2.28, U10.3
SQ_3: R_SQ3.1, U3.28, U10.5
SQ_4: R_SQ4.1, U4.28, U10.9
TRI_1: C_AC1A.1, U1.1, U1.31
TRI_2: C_AC2A.1, U2.1, U2.31
TRI_3: C_AC3A.1, U3.1, U3.31
TRI_4: C_AC4A.1, U4.1, U4.31
TUNE_OUT_1: J2.9, U10.2
TUNE_OUT_2: J2.10, U10.4
TUNE_OUT_3: J2.11, U10.6
TUNE_OUT_4: J2.12, U10.8
VOICE_OUT_1: J_OUT1.T, R_OUT1.2
VOICE_OUT_2: J_OUT2.T, R_OUT2.2
VOICE_OUT_3: J_OUT3.T, R_OUT3.2
VOICE_OUT_4: J_OUT4.T, R_OUT4.2
VREF_2V5: C11.1, R_LIN1.1, R_LIN2.1, R_LIN3.1, R_LIN4.1, R_SCALE1.1, R_SCALE2.1, R_SCALE3.1, R_SCALE4.1, TP5.1, U1.23, U2.23, U3.23, U4.23, U5.1, U6.1, U7.1, U8.6
