sssamuelll/analog-modular-synthesizer/hardware/02-midi-cv/kicad/sam17-midicv.kicad_pcb

## KiCad design hardware/02-midi-cv/kicad/sam17-midicv.kicad_pcb (2026-08-15)

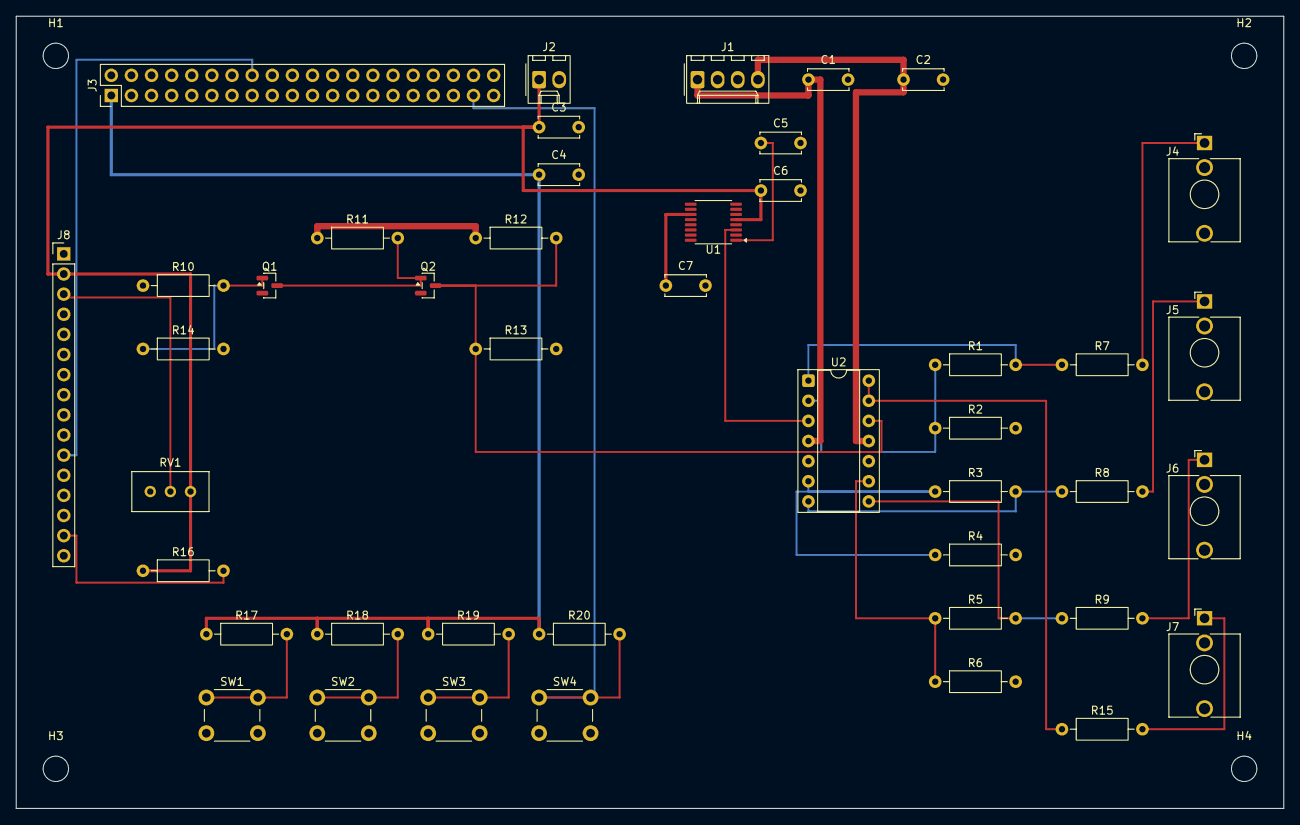
[picture p70: board sam17-midicv.kicad_pcb from above]

Board: 2 copper layers, 160.0 x 100.0 mm, 48 parts (0 on the bottom side), 41 nets.

Parts:
C1, C2, C3, C4, C5, C6, C7: C_Disc_D5.0mm_W2.5mm_P5.00mm
H1, H2, H3, H4: MountingHole_3.2mm_M3
J1: Molex_KK-254_AE-6410-04A_1x04_P2.54mm_Vertical
J2: Molex_KK-254_AE-6410-02A_1x02_P2.54mm_Vertical
J3: PinHeader_2x20_P2.54mm_Vertical
J4, J5, J6, J7: Jack_3.5mm_QingPu_WQP-PJ398SM_Vertical_CircularHo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; Jack_3.5mm_QingPu_WQP-PJ398SM_Vertical_CircularHoles
J8: PinHeader_1x16_P2.54mm_Vertical
Q1, Q2: SOT-23
R1, R2, R3, R4, R5, R6, R7, R8, R9, R10, R11, R12, R13, R14, R15, R16, R17, R18, R19, R20: R_Axial_DIN0207_L6.3mm_D2.5mm_P10.16mm_Horizontal
RV1: Potentiometer_Bourns_3296W_Vertical
SW1, SW2, SW3, SW4: SW_PUSH_6mm
U1: TSSOP-16_4.4x5mm_P0.65mm
U2: DIP-14_W7.62mm_Socket

Connections:
+3V3: C4.1, C7.1, J3.1, R17.1, R18.1, R19.1, R20.1, U1.11
+5V: C3.1, C6.1, J2.1, J8.2, R16.1, RV1.1, U1.5
+12V: C1.1, J1.1, R11.1, R12.1, U2.4
-12V: C2.1, J1.4, U2.11
BTN_BACK: J3.36, R19.2, SW3.1
BTN_DOWN: J3.11, R18.2, SW2.1
BTN_ENTER: J3.37, R20.2, SW4.1
BTN_UP: J3.7, R17.2, SW1.1
CV1: J4.S, R7.2
CV2: J5.S, R8.2
CV3: J6.S, R9.2
DAC_A: U1.3, U2.3
DAC_B: U1.2, U2.5
DAC_C: U1.6, U2.10
DAC_RESET: J3.31, U1.15
GATE_12: Q2.3, R12.2, R13.1, U2.12
GATE_G: Q1.1, R10.2, R14.1
GATE_INV: Q1.3, Q2.1, R11.2
GATE_IO: J3.13, R10.1
GATE_OUT: J7.S, R15.2
GATE_OUT_B: R15.1, U2.13, U2.14
GNDA: C1.2, C2.2, C5.2, C6.2, C7.2, J1.2, J1.3, J4.T, J5.T, J6.T, J7.T, R2.2, R4.2, R6.2, U1.4, U1.9, U1.10, U1.16
GNDD: C3.2, C4.2, J2.2, J3.6, J3.9, J3.14, J3.20, J3.25, J3.30, J3.34, J3.39, J8.1, J8.5, J8.16, Q1.2, Q2.2, R13.2, R14.2, RV1.3, SW1.2, SW2.2, SW3.2, SW4.2
LCD_BLA: J8.15, R16.2
LCD_D4: J3.16, J8.11
LCD_D5: J3.12, J8.12
LCD_D6: J3.10, J8.13
LCD_D7: J3.8, J8.14
LCD_EN: J3.18, J8.6
LCD_RS: J3.22, J8.4
LCD_VO: J8.3, RV1.2
unnamed: R1.2, R7.1, U2.1
unnamed: R3.2, R8.1, U2.7
unnamed: R5.2, R9.1, U2.8
unnamed: R1.1, R2.1, U2.2
unnamed: R3.1, R4.1, U2.6
unnamed: R5.1, R6.1, U2.9
SCLK: J3.23, U1.12
SDIN: J3.19, U1.14
SPI_CE1: J3.26, U1.13
VREF: C5.1, U1.1
