sssamuelll/analog-modular-synthesizer/hardware/01-power-supply/kicad/sam17-power.kicad_pcb

## KiCad design hardware/01-power-supply/kicad/sam17-power.kicad_pcb (2026-08-14)

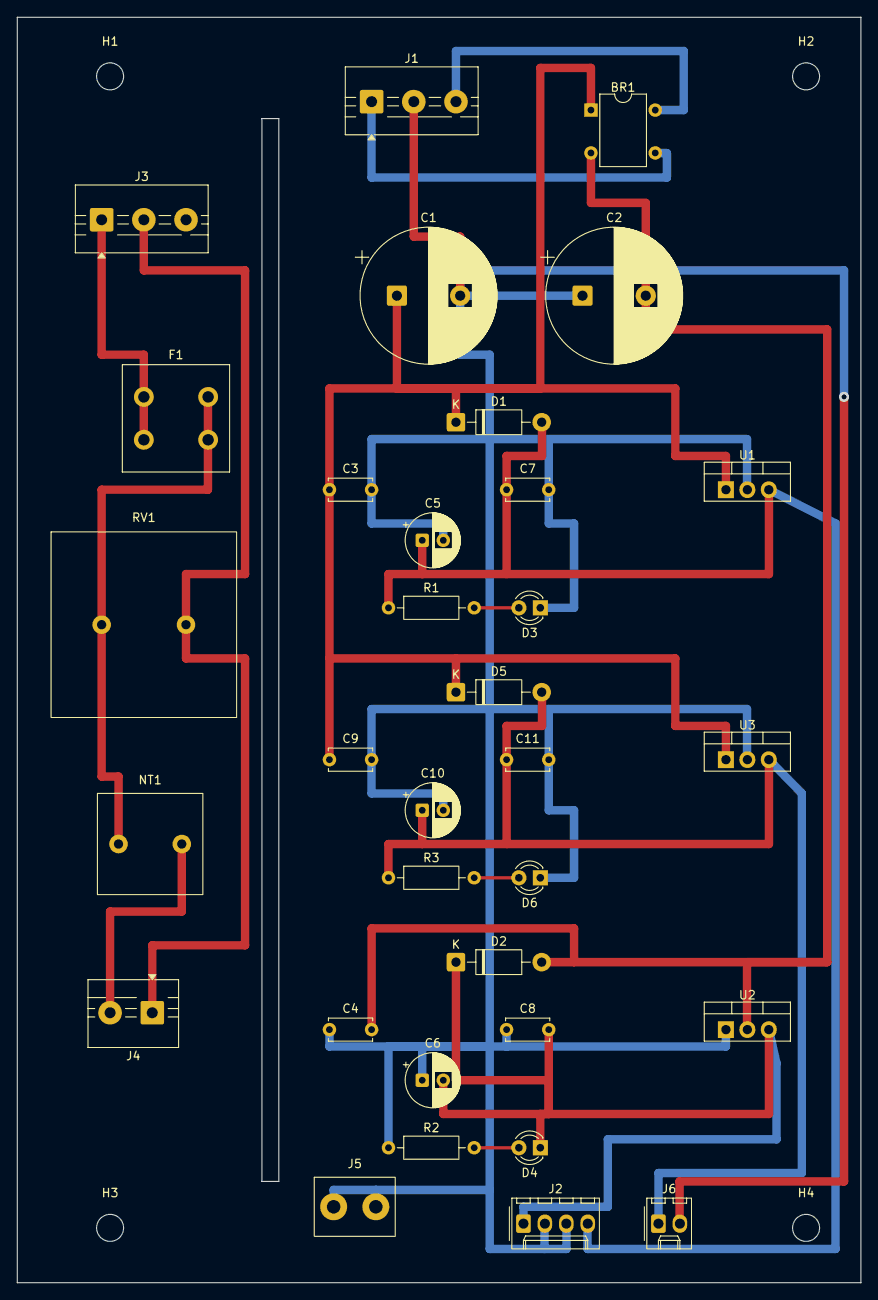
[picture p71: board sam17-power.kicad_pcb from above]

Board: 2 copper layers, 100.0 x 150.0 mm, 37 parts (0 on the bottom side), 15 nets.

Parts:
BR1: Diode_Bridge_DIP-4_W7.62mm_P5.08mm
C1, C2: CP_Radial_D16.0mm_P7.50mm
C3, C4, C7, C8, C9, C11: C_Disc_D5.0mm_W2.5mm_P5.00mm
C5, C6, C10: CP_Radial_D6.3mm_P2.50mm
D1, D2, D5: D_DO-41_SOD81_P10.16mm_Horizontal
D3, D4, D6: LED_D3.0mm
F1: Fuseholder_Cylinder-5x20mm_Schurter_FPG4_Vertical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; Fuseholder_Cylinder-5x20mm_Schurter_FPG4_Vertical_Closed
H1, H2, H3, H4: MountingHole_3.2mm_M3
J1, J3: TerminalBlock_MaiXu_MX126-5.0-03P_1x03_P5.00mm
J2: Molex_KK-254_AE-6410-04A_1x04_P2.54mm_Vertical
J4: TerminalBlock_MaiXu_MX126-5.0-02P_1x02_P5.00mm
J5: Faston_6.3x0.8mm_PCB_2Leg_P5.0mm
J6: Molex_KK-254_AE-6410-02A_1x02_P2.54mm_Vertical
NT1: NTC_Disc_D11.5mm_W4.5mm_P7.5mm
R1, R2, R3: R_Axial_DIN0207_L6.3mm_D2.5mm_P10.16mm_Horizontal
RV1: RV_Disc_D21mm_W5.5mm_P10.0mm
U1, U2, U3: TO-220-3_Vertical

Connections:
+5V: C10.1, C11.1, D5.2, J6.1, R3.1, U3.3
+12V: C5.1, C7.1, D1.2, J2.4, R1.1, U1.3
-12V: C6.2, C8.2, D2.1, D4.1, J2.1, U2.3
/L: F1.1, J3.1
/L_F: F1.2, NT1.1, RV1.1
/L_TR: J4.2, NT1.2
/N: J3.2, J4.1, RV1.2
/SEC_A: BR1.3, J1.1
/SEC_B: BR1.4, J1.3
/VRAW+: BR1.1, C1.1, C3.1, C9.1, D1.1, D5.1, U1.1, U3.1
/VRAW-: BR1.2, C2.2, C4.2, D2.2, U2.2
GND: C1.2, C2.1, C3.2, C4.1, C5.2, C6.1, C7.2, C8.1, C9.2, C10.2, C11.2, D3.1, D6.1, J1.2, J2.2, J2.3, J5.1, J6.2, R2.1, U1.2, U2.1, U3.2
unnamed: D3.2, R1.2
unnamed: D4.2, R2.2
unnamed: D6.2, R3.2
