sssamuelll/analog-modular-synthesizer/hardware/01-power-supply/v5/kicad/sam17-power-v5.kicad_pcb

## KiCad design hardware/01-power-supply/v5/kicad/sam17-power-v5.kicad_pcb (2026-10-23)

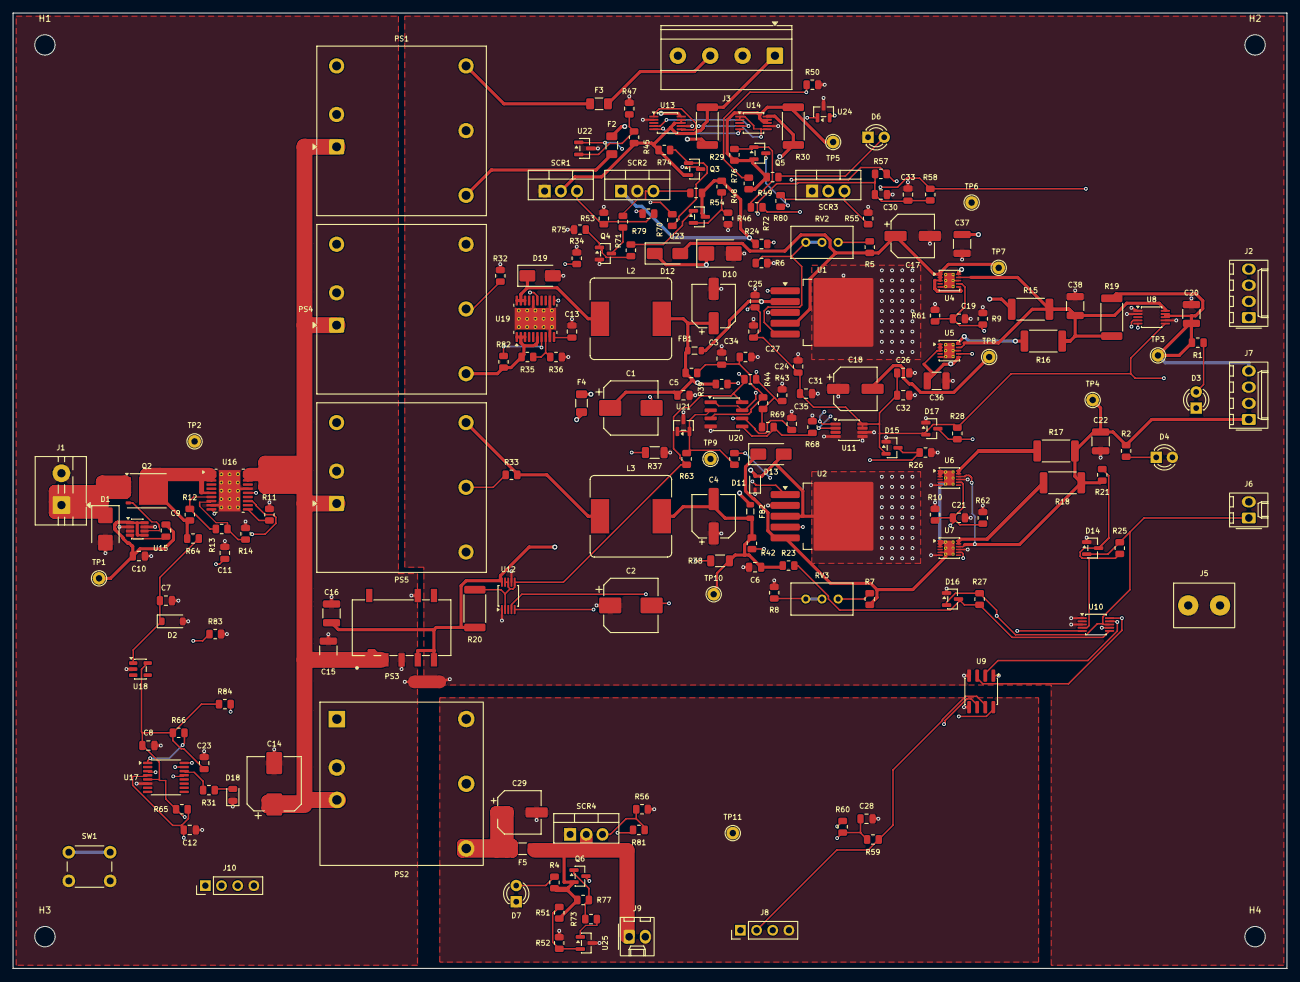
[picture p72: board sam17-power-v5.kicad_pcb from above]

Board: 4 copper layers, 200.0 x 150.0 mm, 212 parts (0 on the bottom side), 101 nets.

Parts:
C1, C2: 220uF 35V; CP_Elec_8x10
C3, C4, C17, C18: 47uF 35V; CP_Elec_6.3x7.7
C5, C6, C9, C10, C23, C24, C25, C26, C27, C28, C30, C31, C32, C33, C34, C35: 100nF 50V X7R; C_0805_2012Metric
C7: 1uF 50V X7R; C_0805_2012Metric
C8: 4.7uF 25V X7R; C_0805_2012Metric
C11, C13: 22nF 50V X7R; C_0805_2012Metric
C12: 1nF 50V C0G; C_0805_2012Metric
C14: 100uF 50V; CP_Elec_8x10
C15: 10uF 50V X7R; C_1210_3225Metric
C16, C20, C22, C36, C37, C38: 22uF 25V X7R; C_1210_3225Metric
C19, C21: 470nF 50V X7R; C_0805_2012Metric
C29: 100uF 25V; CP_Elec_6.3x7.7
D1: SMBJ26CA; D_SMB
D2: BZT52C24; D_SOD-123
D3: LED rojo 3mm; LED_D3.0mm
D4: LED amarillo 3mm; LED_D3.0mm
D6: LED verde 3mm; LED_D3.0mm
D7: LED azul 3mm; LED_D3.0mm
D10: SMBJ16A; D_SMB
D11: BAT54WS; D_SOD-323
D12, D13: S1M; D_SMA
D14, D15, D16, D17: BAT54S; SOT-23
D18: LED verde 0805; LED_0805_2012Metric
D19: SS34; D_SMA
F2, F3: SF-1206F300-2 3A; Fuse_1206_3216Metric
F4: SF-1206F200-2 2A; Fuse_1206_3216Metric
F5: 0466004 4A; Fuse_1206_3216Metric
FB1, FB2: BLM21PG600SN1D; L_0805_2012Metric
H1, H2, H3, H4: MountingHole_3.2mm_M3
J1: Bornera 2P 5.0 mm; TerminalBlock_MaiXu_MX126-5.0-02P_1x02_P5.00mm
J2, J7: Molex KK-254 4P; Molex_KK-254_AE-6410-04A_1x04_P2.54mm_Vertical
J3: Bornera 4P 5.08 mm; TerminalBlock_Phoenix_MKDS-1,5-4-5.08_1x04_P5.08mm_Horizont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
J5: Faston 6.3x0.8 PCB; Faston_6.3x0.8mm_PCB_2Leg_P5.0mm
J6, J9: Molex KK-254 2P; Molex_KK-254_AE-6410-02A_1x02_P2.54mm_Vertical
J8, J10: PinHeader 1x04; PinHeader_1x04_P2.54mm_Vertical
L2, L3: 22uH SRR1260-220M; L_Bourns_SRR1260
NT1: NetTie GND24-GNDA; NetTie-2_SMD_Pad2.0mm
PS1: THN 30-2422WI; Converter_DCDC_TRACO_THL30-xxxxWI_THT
PS2: URB2405YMD-20WR3; Converter_DCDC_Mornsun_URB_YMD-20WR3_Horizontal_THT
PS3: K7805T-1000R3; Converter_DCDC_Mornsun_K78_T-1000R3_SMD
PS4, PS5: THN 20-2413WI; Converter_DCDC_TRACO_THL30-xxxxWI_THT
Q2: CSD18534Q5A; TDSON-8-1
Q3, Q4, Q5, Q6: MMBT3906; SOT-23
R1, R2, R57, R58, R59, R60: 2.2k; R_0805_2012Metric
R3, R4: 680; R_0805_2012Metric
R5: 9.31k 0.1%; R_0805_2012Metric
R6, R8: 1.00k 0.1%; R_0805_2012Metric
R7: 9.09k 0.1%; R_0805_2012Metric
R9, R10, R61, R62: 120k 0.1%; R_0805_2012Metric
R11: 4.02k; R_0805_2012Metric
R12, R35: 49.9k 0.1%; R_0805_2012Metric
R13: 1.62k 0.1%; R_0805_2012Metric
R14: 1.96k 0.1%; R_0805_2012Metric
R15, R16, R17, R18, R19, R29, R30: 0.02; R_2512_6332Metric
R20: 0.1; R_2512_6332Metric
R21, R22, R23, R24: 100k 0.1%; R_0805_2012Metric
R25, R26, R27, R28: 20.0k 0.1%; R_0805_2012Metric
R31: 220; R_0805_2012Metric
R32, R33: 45.3k; R_0805_2012Metric
R34: 18.2k; R_0805_2012Metric
R36: 3.9k 0.1%; R_0805_2012Metric
R37, R38: 0.68; R_1206_3216Metric
R39: 47.5k 0.1%; R_0805_2012Metric
R40, R47, R48, R50, R52: 10.0k 0.1%; R_0805_2012Metric
R41: 10.2k 0.1%; R_0805_2012Metric
R42: 59.0k 0.1%; R_0805_2012Metric
R43: 100k; R_0805_2012Metric
R44, R66, R68, R74, R75, R76, R77, R84: 10k; R_0805_2012Metric
R45, R46: 45.3k 0.1%; R_0805_2012Metric
R49: 13.3k 0.1%; R_0805_2012Metric
R51: 12.7k 0.1%; R_0805_2012Metric
R53, R54, R55, R56, R78, R79, R80, R81: 100; R_0805_2012Metric
R63: 1.2k; R_0805_2012Metric
R64, R70, R71, R72, R73: 1k; R_0805_2012Metric
R65, R83: 47k; R_0805_2012Metric
R67, R82: 6.8M; R_0805_2012Metric
R69: 10M; R_0805_2012Metric
RV2, RV3: 1k 3296W; Potentiometer_Bourns_3296W_Vertical
SCR1, SCR2, SCR3, SCR4: BT151-500R; TO-220-3_Vertical
SW1: Pulsador 6x6; SW_PUSH_6mm
TP1, TP2, TP3, TP4, TP5, TP6, TP7, TP8, TP9, TP10, TP11: TestPoint; TestPoint_THTPad_D2.0mm_Drill1.0mm
U1: LT1963AEQ; TO-263-5_TabPin3
U2: LT3015EQ; TO-263-5_TabPin3
U4, U5: LT3045EDD; DFN-10-1EP_3x3mm_P0.5mm_EP1.65x2.38mm_ThermalVias
U6, U7: LT3094EDD; DFN-12-1EP_3x3mm_P0.45mm_EP1.65x2.38mm_ThermalVias
U8, U12, U13, U14: INA226; TSSOP-10_3x3mm_P0.5mm
U9: ISO1541; SOIC-8_3.9x4.9mm_P1.27mm
U10: ADS1115IDGS; TSSOP-10_3x3mm_P0.5mm
U11: TMP1075DGK; VSSOP-8_3x3mm_P0.65mm
U15: LM74502DDFR; SOT-23-8
U16, U19: TPS26631PWPR; HTSSOP-20-1EP_4.4x6.5mm_P0.65mm_EP3.4x6.5mm_Mask2.96x2.96mm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
U17: MSP430FR2111IPW16; TSSOP-16_4.4x5mm_P0.65mm
U18: TPS70933DBVR; SOT-23-5
U20: LM393B; SOIC-8_3.9x4.9mm_P1.27mm
U21, U22, U23, U24, U25: TL431BI; SOT-23

Connections:
+3V3_DIG: C28.1, J8.1, R59.1, R60.1, U9.8
+3V3_MCU: C8.1, C23.1, J10.1, R65.1, R66.1, R84.1, U17.5, U18.5
+5V_AUX: C24.1, C25.1, C26.1, C27.1, C30.1, C31.1, C32.1, C33.1, D14.2, D15.2, D16.2, D17.2, J6.1, R20.2, R25.2, R27.2, R28.2, R44.1, R57.1, R58.1, R63.1, U8.6, U9.1, U10.8, U11.7, U11.8, U12.2, U12.6, U12.8, U12.9, U13.1, U13.6, U14.1, U14.2, U14.6, U20.8
+5V_DIG: F5.2, J9.1, Q6.2, R4.1, R51.1, R77.1, SCR4.2
+5V_FUSED_RACK: F4.2, R30.1, U14.10
+5V_RACK: J3.4, Q5.2, R3.1, R30.2, R49.1, R76.1, SCR3.2, TP5.1, U14.8, U14.9
+5V_RAW_DIG: C29.1, F5.1, PS2.4
+5V_RAW_RACK: C16.1, F4.1, PS3.4, PS3.5, R20.1, U12.10
+12V_FUSED_RACK: F2.2, R29.1, U13.10
+12V_RACK: J3.1, Q3.2, R29.2, R45.1, R74.1, SCR1.2, U13.8, U13.9
+12V_RAW_RACK: F2.1, PS1.3
+12V_ULTRA: C20.1, J2.4, J7.4, R1.1, R19.2, TP3.1, U8.8, U8.9
+13V1: C17.1, C36.1, D12.2, R5.1, TP7.1, U1.4, U4.1, U4.2, U4.3, U4.6, U5.1, U5.2, U5.3, U5.6
+15V5_EFUSE: D19.1, L2.1, U19.18, U19.19, U19.20
+15V5_FILT: D10.1, D12.1, FB1.2, U1.2
+15V5_LC: C1.1, C3.1, C5.1, FB1.1, L2.2, R22.1, R39.1, TP9.1
+15V5_RAW: PS4.3, R35.1, R82.1, U19.1, U19.2, U19.3, U19.6
+24V_LDO: C7.1, D2.1, R64.2, U18.1
+24V_PROT: Q2.5, R12.1, R64.1, U16.1, U16.2, U16.3, U16.6
+24V_RAW: C9.2, C10.1, D1.1, J1.1, Q2.1, Q2.2, Q2.3, TP1.1, U15.1, U15.5, U15.8
+24V_SW: C14.1, C15.1, PS1.1, PS2.3, PS3.1, PS3.2, PS4.1, PS5.1, U16.18, U16.19, U16.20
-12V9: C18.2, C37.2, D13.1, R7.1, TP8.1, U2.5, U6.1, U6.2, U6.3, U6.5, U6.13, U7.1, U7.2, U7.3, U7.5, U7.13
-12V_RACK: F3.2, J3.3, R24.1, R48.2, R54.2, SCR2.1, U23.3
-12V_RAW_RACK: F3.1, PS1.5
-12V_ULTRA: C22.2, J2.1, J7.1, R2.2, R17.2, R18.2, R21.1, TP4.1, U6.10, U7.10
-15V5_FILT: D11.2, D13.2, FB2.2, U2.3
-15V5_LC: C4.2, C6.2, FB2.1, L3.2, R23.1, R38.2, R42.2, TP10.1
-15V5_RAW: L3.1, PS5.5, R33.2
ADJ_U1: R6.1, RV2.2, RV2.3, U1.5
ADJ_U2: R8.1, RV3.2, RV3.3, U2.4
AIN0: D14.3, R21.2, R25.1, U10.4
AIN1: D15.3, R22.2, R26.1, U10.5
AIN2: D16.3, R23.2, R27.1, U10.6
AIN3: D17.3, R24.2, R28.1, U10.7
C1_NEG: C1.2, R37.1
C2_NEG: C2.2, R38.1
DVDT_U16: C11.1, U16.10
DVDT_U19: C13.1, U19.10
FLT_M5: R66.2, U16.15, U17.1
FLT_U19: R84.2, U17.16, U19.15
GATE_Q2: Q2.4, U15.6
GATE_SCR1: R53.1, R78.2, SCR1.3
GATE_SCR2: R54.1, R79.2, SCR2.3
GATE_SCR3: R55.1, R80.2, SCR3.3
GATE_SCR4: R56.1, R81.2, SCR4.3
GND24: C7.2, C8.2, C10.2, C11.2, C12.2, C14.2, C15.2, C16.2, C23.2, D1.2, D2.2, D18.1, J1.2, J10.4, NT1.1, PS1.2, PS2.2, PS3.3, PS3.7, PS4.2, PS5.2, R11.2, R14.2, R83.2, SW1.2, TP2.1, U15.2, U15.7, U16.9, U16.16, U16.21, U17.6, U18.2
GNDA: C2.1, C3.2, C4.1, C5.2, C6.1, C13.2, C17.2, C18.1, C19.2, C20.2, C21.2, C22.1, C24.2, C25.2, C26.2, C27.2, C30.2, C31.2, C32.2, C33.2, C34.2, C35.2, C36.2, C37.1, C38.2, D3.1, D4.2, D6.1, D10.2, D11.1, D14.1, D15.1, D16.1, D17.1, D19.2, J2.2, J2.3, J3.2, J5.1, J6.2, J7.2, J7.3, NT1.2, PS1.4, PS4.5, PS5.3, Q4.2, R6.2, R8.2, R9.2, R10.2, R26.2, R32.2, R34.2, R36.2, R37.2, R40.2, R43.2, R46.1, R47.2, R50.2, R53.2, R55.2, R61.2, R62.2, R68.2, R75.1, SCR1.1, SCR2.2, SCR3.1, TP6.1, U1.3, U2.2, U4.5, U4.8, U4.11, U5.5, U5.8, U5.11, U6.6, U6.9, U7.6, U7.9, U8.1, U8.2, U8.7, U9.4, U10.1, U10.3, U11.4, U11.5, U11.6, U12.1, U12.7, U13.2, U13.7, U14.7, U19.9, U19.12, U19.16, U19.21, U20.4, U21.3, U22.3, U24.3
GNDD: C28.2, C29.2, D7.1, J8.4, J9.2, PS2.6, R52.2, R56.2, SCR4.1, TP11.1, U9.5, U25.3
ILIM_U16: R11.1, U16.11
ILIM_U19: R34.1, U19.11
LED3_A: D3.2, R1.2
LED4_K: D4.1, R2.1
LED6_A: D6.2, R3.2
LED7_A: D7.2, R4.2
LED_ANODE: D18.2, R31.2
LED_CTRL: R31.1, U17.14
MCU_RST: C12.1, J10.3, R65.2, U17.4
MCU_TEST: J10.2, U17.3
OUTS_POS: C38.1, R15.2, R16.2, R19.1, U4.9, U5.9, U8.10
OUT_U4: R15.1, U4.10
OUT_U5: R16.1, U5.10
OUT_U6: R17.1, U6.11, U6.12
OUT_U7: R18.1, U7.11, U7.12
OVP_U16: R13.2, R14.1, U16.8
OVP_U19: R35.2, R36.1, U19.8
QB_CB1: Q3.1, R70.1, R74.2
QB_CB2: Q4.1, R71.1, R75.2
QB_CB3: Q5.1, R72.1, R76.2
QB_CB4: Q6.1, R73.1, R77.2
QC_CB1: Q3.3, R78.1
QC_CB2: Q4.3, R79.1
QC_CB3: Q5.3, R80.1
QC_CB4: Q6.3, R81.1
REF0_NEG: R68.1, R69.2, U20.5
REF_CB1: R45.2, R47.1, U22.2
REF_CB2: R46.2, R48.1, U23.2
REF_CB3: R49.2, R50.1, U24.2
REF_CB4: R51.2, R52.1, U25.2
SCL_A: R58.2, U8.5, U9.3, U10.10, U11.2, U12.5, U13.5, U14.5
SCL_D: J8.3, R60.2, U9.6
SDA_A: R57.2, U8.4, U9.2, U10.9, U11.1, U12.4, U13.4, U14.4
SDA_D: J8.2, R59.2, U9.7
SENSE_NEG: C35.1, R41.2, R42.1, U20.6
SENSE_POS: C34.1, R39.2, R40.1, R67.2, U20.3
SET_NEG: C21.1, R10.1, R62.1, U6.8, U7.8
SET_POS: C19.1, R9.1, R61.1, U4.7, U5.7
SHDN_CASCADE: R43.1, R44.2, R67.1, R69.1, U1.1, U2.1, U20.1, U20.7
SHDN_M5: R83.1, U16.13, U17.15
SW_RESET: SW1.1, U17.13
TLK_CB1: R70.2, U22.1
TLK_CB2: R71.2, U23.1
TLK_CB3: R72.2, U24.1
TLK_CB4: R73.2, U25.1
TRIM_PS4: PS4.4, R32.1
TRIM_PS5: PS5.4, R33.1
TRIM_U1_HI: R5.2, RV2.1
TRIM_U2_HI: R7.2, RV3.1
UVLO_U16: R12.2, R13.1, U16.7
UVLO_U19: R82.2, U19.7
VCAP_U15: C9.1, U15.4
VREF_2V5: R41.1, R63.2, U20.2, U21.1, U21.2
