sssamuelll/analog-modular-synthesizer/hardware/01-power-supply/v3/kicad/sam17-power-v3.kicad_pcb

## KiCad design hardware/01-power-supply/v3/kicad/sam17-power-v3.kicad_pcb (2026-09-03, an earlier design)

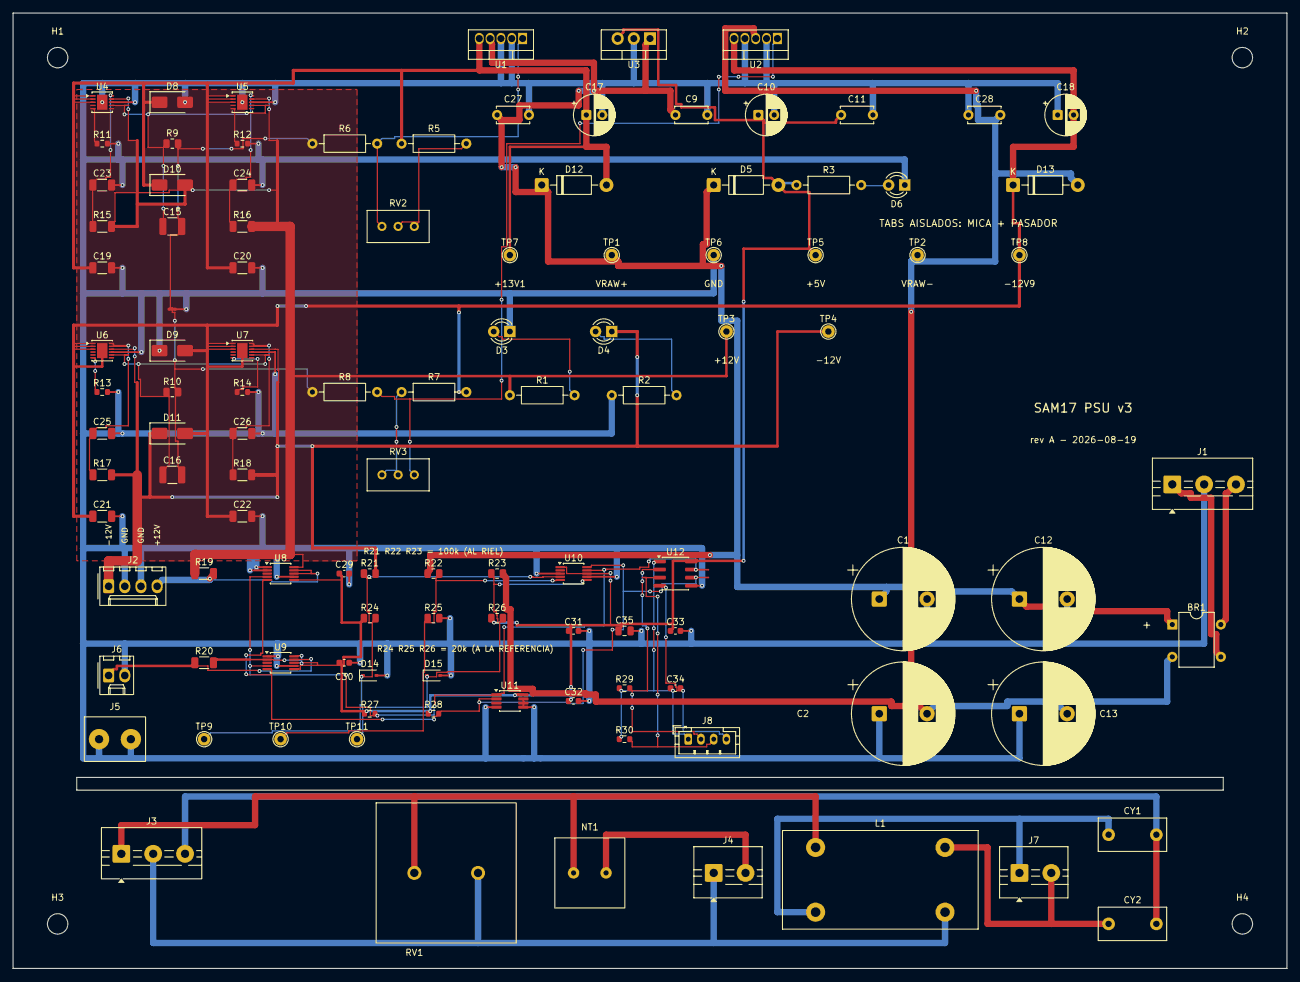
[picture p73: board sam17-power-v3.kicad_pcb from above]

Board: 2 copper layers, 200.0 x 150.0 mm, 113 parts (0 on the bottom side), 45 nets.

Parts:
BR1: DB207; Diode_Bridge_DIP-4_W7.62mm_P5.08mm
C1, C2, C12, C13: 4700uF/25V electrolitico; CP_Radial_D16.0mm_P7.50mm
C9: 0.33uF ceramico; C_Disc_D5.0mm_W2.5mm_P5.00mm
C10: 100uF/25V electrolitico; CP_Radial_D6.3mm_P2.50mm
C11: 0.1uF ceramico; C_Disc_D5.0mm_W2.5mm_P5.00mm
C15, C16: 22 uF X7R baja fuga 25 V 1210; C_1210_3225Metric
C17, C18: 22 uF; CP_Radial_D6.3mm_P2.50mm
C19, C20, C21, C22, C23, C24, C25, C26: 10 uF X7R 50 V; C_1206_3216Metric
C27, C28: 0.47 uF ceramico; C_Disc_D5.0mm_W2.5mm_P5.00mm
C29, C30, C31, C32, C33, C34: 0.1uF X7R 50V; C_0603_1608Metric
C35: 10uF X7R 25V; C_0805_2012Metric
CY1, CY2: 1 nF clase Y2; C_Disc_D10.5mm_W5.0mm_P7.50mm
D3: LED rojo 3mm; LED_D3.0mm
D4: LED amarillo 3mm; LED_D3.0mm
D5, D12, D13: 1N4001; D_DO-41_SOD81_P10.16mm_Horizontal
D6: LED verde 3mm; LED_D3.0mm
D8, D9: SMAJ15A; D_SMA
D10, D11: SS14; D_SMA
D14, D15: BAT54; D_SOD-323
H1, H2, H3, H4: MountingHole_3.2mm_M3
J1, J3: Barrier block 3 pos; TerminalBlock_MaiXu_MX126-5.0-03P_1x03_P5.00mm
J2: Molex KK-254 4 pos; Molex_KK-254_AE-6410-04A_1x04_P2.54mm_Vertical
J4, J7: Barrier block 2 pos; TerminalBlock_MaiXu_MX126-5.0-02P_1x02_P5.00mm
J5: Vogt 3866A.68 faston 6.3x0.8 PCB; Faston_6.3x0.8mm_PCB_2Leg_P5.0mm
J6: Molex KK-254 2 pos; Molex_KK-254_AE-6410-02A_1x02_P2.54mm_Vertical
J8: JST-PH 4 pos; JST_PH_B4B-PH-K_1x04_P2.00mm_Vertical
JP1: Net tie GNDREF<->GND; NetTie-2_SMD_Pad0.5mm
L1: Choke de modo comun 10 mH / >=0.5 A / 250 VAC; L_CommonMode_Toroid_Vertical_L30.5mm_W15.2mm_Px10.16mm_Py20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
NT1: Ametherm SL10 5R002; NTC_Disc_D10.0mm_W4.0mm_P5.1mm
R1, R2: 2.2k 1/4W; R_Axial_DIN0207_L6.3mm_D2.5mm_P10.16mm_Horizontal
R3: 680R 1/4W; R_Axial_DIN0207_L6.3mm_D2.5mm_P10.16mm_Horizontal
R5: 8.66k 1% 1/4W; R_Axial_DIN0207_L6.3mm_D2.5mm_P10.16mm_Horizontal
R6, R8: 1k 1% 1/4W; R_Axial_DIN0207_L6.3mm_D2.5mm_P10.16mm_Horizontal
R7: 9.09k 1% 1/4W; R_Axial_DIN0207_L6.3mm_D2.5mm_P10.16mm_Horizontal
R9, R10: 120k 1% 100ppm 0805; R_0805_2012Metric
R11, R12: 374 ohm 1%; R_0603_1608Metric
R13, R14: 9.31k 1%; R_0603_1608Metric
R15, R16, R17, R18, R19: 20 mOhm 1%; R_1206_3216Metric
R20: 100 mOhm 1%; R_1206_3216Metric
R21, R22, R23: 100k 0.1% 25 ppm/°C; R_0805_2012Metric
R24, R25, R26: 20k 0.1% 25 ppm/°C; R_0805_2012Metric
R27, R28: 2.2k 1/4W; R_0603_1608Metric
R29, R30: 2.2k 1/4W — DNP; R_0603_1608Metric
RV1: S20K275 / V275LA20A; RV_Disc_D21mm_W5.5mm_P10.0mm
RV2, RV3: 3296W-1-102; Potentiometer_Bourns_3296W_Vertical
TP1, TP2, TP3, TP4, TP5, TP6, TP7, TP8, TP9, TP10, TP11: Punto de prueba; TestPoint_THTPad_D2.0mm_Drill1.0mm
U1: LM2941CT/NOPB; TO-220-5_Vertical
U2: LM2991T/NOPB; TO-220-5_Vertical
U3: LM7805; TO-220-3_Vertical
U4, U5: LT3045EDD#TRPBF; DFN-10-1EP_3x3mm_P0.5mm_EP1.65x2.38mm
U6, U7: LT3094EDD#PBF; DFN-12-1EP_3x3mm_P0.45mm_EP1.65x2.38mm
U8, U9: INA226AIDGSR — monitor I/V I2C 16 bits; MSOP-10_3x3mm_P0.5mm
U10: ADS1115IDGSR — ADC 16 bits 4 canales I2C; MSOP-10_3x3mm_P0.5mm
U11: TMP1075DGKR — sensor de temperatura I2C; VSSOP-8_3x3mm_P0.65mm
U12: ISO1541D — aislador I2C bidireccional; SOIC-8_3.9x4.9mm_P1.27mm

Connections:
+3V3: C34.1, J8.1, R29.1, R30.1, U12.1
+5V: C10.1, C11.1, C29.1, C30.1, C31.1, C32.1, C33.1, C35.1, D5.2, R3.1, R20.2, R24.1, R26.1, R27.1, R28.1, TP5.1, U3.3, U8.6, U9.2, U9.6, U9.8, U9.10, U10.1, U10.8, U11.8, U12.8
+12V: D10.2, R1.1, R15.2, R16.2, R19.1, TP3.1, U4.9, U5.9, U8.10
-12V: D4.1, D11.1, J2.1, R17.2, R18.2, R21.2, TP4.1, U6.10, U7.10
/+5V_M2: J6.1, R20.1, U9.9
/+12V_BUS: J2.4, R19.2, U8.8, U8.9
/+13V1: C17.1, C19.1, C20.1, D8.1, D10.1, D12.2, R5.1, TP7.1, U1.5, U4.1, U4.2, U4.3, U5.1, U5.2, U5.3
/-12V9: C18.2, C21.1, C22.1, D9.2, D11.2, D13.1, R7.2, TP8.1, U2.5, U6.1, U6.2, U6.3, U6.13, U7.1, U7.2, U7.3, U7.13
/GNDREF: C15.2, C16.2, JP1.1, R6.1, R8.1, R9.2, R10.2
/L: J3.1, L1.1, NT1.1, RV1.1
/L_SMPS: CY1.1, J7.1, L1.2
/L_TR: J4.2, NT1.2
/N: J3.2, J4.1, L1.3, RV1.2
/N_SMPS: CY2.1, J7.2, L1.4
/SCL_A: R28.2, U8.5, U9.5, U10.10, U11.2, U12.6
/SCL_D: J8.3, R30.2, U12.3
/SDA_A: R27.2, U8.4, U9.4, U10.9, U11.1, U12.7
/SDA_D: J8.2, R29.2, U12.2
/SEC_A: BR1.3, J1.1
/SEC_B: BR1.4, J1.3
/TAP_-12V: D14.1, R21.1, R24.2, TP9.1, U10.4
/TAP_VRAW+: R22.2, R25.1, TP10.1, U10.5
/TAP_VRAW-: D15.1, R23.1, R26.2, TP11.1, U10.6
/VRAW+: BR1.1, C1.1, C9.1, C12.1, C27.1, D5.1, D12.1, R22.1, TP1.1, U1.4, U3.1
/VRAW-: BR1.2, C2.2, C13.2, C28.2, D13.2, R23.2, TP2.1, U2.3
GND: C1.2, C2.1, C9.2, C10.2, C11.2, C12.2, C13.1, C17.2, C18.1, C19.2, C20.2, C21.2, C22.2, C23.2, C24.2, C25.2, C26.2, C27.2, C28.1, C29.2, C30.2, C31.2, C32.2, C33.2, C35.2, D3.1, D6.1, D8.2, D9.1, D14.2, D15.2, J1.2, J2.2, J2.3, J5.1, J6.2, JP1.2, R2.1, R11.2, R12.2, R13.2, R14.2, R25.2, TP6.1, U1.2, U1.3, U2.2, U2.4, U3.2, U4.8, U4.11, U5.8, U5.11, U6.9, U7.9, U8.1, U8.2, U8.7, U9.1, U9.7, U10.3, U10.7, U11.4, U11.5, U11.6, U11.7, U12.5
GNDD: C34.2, J8.4, U12.4
unnamed: C25.1, R17.1, U6.11, U6.12
unnamed: C26.1, R18.1, U7.11, U7.12
unnamed: D3.2, R1.2
unnamed: D4.2, R2.2
unnamed: D6.2, R3.2
unnamed: R5.2, RV2.1, RV2.2
unnamed: R7.1, RV3.2, RV3.3
unnamed: R6.2, RV2.3, U1.1
unnamed: R8.2, RV3.1, U2.1
unnamed: R11.1, U4.5
unnamed: C23.1, R15.1, U4.10
unnamed: C15.1, R9.1, U4.7, U5.7
unnamed: R12.1, U5.5
unnamed: C24.1, R16.1, U5.10
unnamed: R13.1, U6.6
unnamed: C16.1, R10.1, U6.8, U7.8
unnamed: R14.1, U7.6
PE: CY1.2, CY2.2, J3.3
