sssamuelll/analog-modular-synthesizer/software/nucleo/modelo/src/motor.rs

//! Motor de eventos del transporte por tic sobre la maquina REAL de `core`.
//!
//! Una CPU con prioridades de NVIC (menor numero = mas urgente) y pasos atomicos (secciones
//! PRIMASK); seis ranuras con `Transporte`, `Triple`, `Anillo<8>`, `Subida` y la politica
//! `maestro_j2::Ranura` sin tocar. El hardware (SPI, GPDMA, TIM7) es un modelo con las cifras
//! medidas de `fw/EN-PLACA.md`; lo ESTIMADO se dice donde se usa.
//!
//! Portado de `docs/superpowers/juntas/2026-10-17-j2-transporte/sim/junta3/src/motor.rs` sin
//! las candidatas del papel v3 que la tercera pasada rompio (el permiso de escalada por
//! ranura, el reloj que redondeaba el intervalo entre entradas, `SUCIA` como fila de
//! `Vencida`) ni el supervisor: aqui el tic, el planificador y la recuperacion hacen lo que
//! hacen hoy en `fw/src/j2_tic.rs`.

use sam17_nucleo_core::buzones_j2::{codigo, Anillo, Lectura as LecSubida, Subida, Triple};
use sam17_nucleo_core::escaladas_j2::Presupuesto;
use sam17_nucleo_core::maestro_j2::{
    plazo_us, Accion, Evento, Ranura as Politica, Tsize, Umbrales,
};
use sam17_nucleo_core::supervisor_j2::{Supervisor, Vista};
use sam17_nucleo_core::transporte_j2::{
    tics_de_plazo, Aviso, Entrada, Estado, Lectura, Reloj64, RelojDelTic, Salida, Transporte,
};
use std::cmp::Reverse;
use std::collections::{BinaryHeap, VecDeque};

pub const N: usize = 6;
/// Golpes de P2: cada uno, una lista de tramos (ns, atomico).
pub type Golpes = Vec<Vec<(u64, bool)>>;
pub const PERIODO_NS: u64 = 125_000;
/// Ciclos del nucleo a 800 MHz por cuenta del TIM7, que cuenta microsegundos (`lanzar`).
const CICLOS_POR_CUENTA: u32 = 800;

/// ciclos de CPU a 800 MHz -> ns
pub fn cy(c: u64) -> u64 {
    (c as f64 * 1.25).round() as u64
}

pub fn ms(x: u64) -> u64 {
    x * 1_000_000
}

/// Quien autoriza la escalada del GPDMA1.
#[derive(Clone, Copy, Debug, PartialEq)]
pub enum Escaladas {
    /// Escala siempre, como `fw` antes de K1.
    Siempre,
    /// K1: `e` escaladas como mucho en `ventana_ns` del reloj del tic.
    K1 { e: usize, ventana_ns: u64 },
    /// El presupuesto retirado, de referencia: `e` en `ventana` entradas del tic.
    V2 { e: usize, ventana: u64 },
}

#[derive(Clone)]
pub struct Cfg {
    pub f_sck: u64,
    pub eps_ns: u64,
    pub msg: [u16; N],
    pub active: [bool; N],
    pub cold: bool,
    pub t_canal_ns: u64,
    /// Las cotas de `Vencida` y `Reiniciando`, en periodos del tic.
    pub cotas: (u16, u16),
    pub susp_ns: u64,
    pub pat: Option<fn(usize, u64) -> u16>,
    pub gap_ns: u64,
    pub plan_extra_ns: u64,
    /// El supervisor del hub (K5): su ventana `W`, su periodo `P_s` y el IWDG. ESTIMADOS.
    pub sup_w_ns: u64,
    pub feed_period_ns: u64,
    pub iwdg_ns: u64,
    pub escaladas: Escaladas,
    /// Parar la corrida cuando el IWDG reinicia el chip: lo de despues no existe.
    pub para_al_reiniciar: bool,
}

impl Cfg {
    pub fn base() -> Cfg {
        Cfg {
            f_sck: 6_250_000,
            eps_ns: 1_500, // ESTIMADO: arranque del SPI + latencia de DMA; nadie lo ha medido
            msg: [25; N],
            active: [true; N],
            cold: false,
            t_canal_ns: 25_000,
            cotas: (200, 100), // papel v3: 25 ms + 12,5 ms, ESTIMADO
            susp_ns: 600,
            pat: None,
            gap_ns: 2_000,
            plan_extra_ns: 0,
            sup_w_ns: 55_000_000, // mayor que el mayor hueco de sello, ~50 ms (papel v3, §2.11)
            feed_period_ns: 5_000_000,
            iwdg_ns: 60_000_000,
            // ESTIMADOS: el barrido los recorre.
            escaladas: Escaladas::K1 {
                e: 3,
                ventana_ns: 1_000_000_000,
            },
            para_al_reiniciar: false,
        }
    }
}

#[derive(Default, Clone)]
pub struct HwSlot {
    pub in_flight: bool,
    pub frame_end: Option<u64>,
    pub hung: bool,
    pub gen: u64,
    pub chan_stuck: bool,
    pub bad: bool,
    pub poison_next: bool,
    pub stuck_next: Option<bool>,
    pub suspf_at: Option<u64>,
    pub cstart: u64,
    /// CR.EN del canal (IDLEF cuando es false)
    pub ch_en: bool,
    /// el SPI quedo esperando datos: solo lo limpia su reset por RCC
    pub spi_hung: bool,
}

pub struct SlotW {
    pub on: bool,
    pub tic: Transporte,
    pub rx_actual: u8,
    pub largo: u16,
    pub hw: HwSlot,
    pub pol: Politica,
    pub buzon: Triple,
    pub meta: [(u8, u16); 3],
    pub anillo: Anillo<8>,
    pub ring_occ: usize,
    pub ring_max: usize,
    pub ring_lost: u32,
    pub subida: Subida,
    pub largo_subida: u16,
    pub rec_pedida: bool,
    pub rec_en_curso: bool,
    pub rec_hecha: bool,
    pub rec_t_hecha: u64,
    /// El incidente que pide el planificador, y el de la recuperacion en curso o hecha (K4).
    pub rec_inc_pedido: u32,
    pub rec_inc: u32,
    pub sucia: bool,
    pub sellos: u64,
    pub sin_bajada: u32,
    pub errores_dma: u32,
    pub muertas: u32,
    pub recuperaciones: u32,
    pub giros: u32,
    pub plazos: u32,
    /// Plazos ajenos que declaro la escalada de otra ranura.
    pub colateral: u32,
    pub composes: u64,
    pub last_valid: u64,
    pub max_gap: u64,
    pub inicio_susp: u64,
    pub scratch: Option<(Estado, Salida)>,
    pub prog_ok: bool,
    pub arm_sin_prog: u32,
    pub last_seal_t: u64,
    pub t_venc: u64,
    /// Una `HECHA` de antes del ultimo vencimiento devolvio la ranura (K4 no esta).
    pub hecho_rancio: u32,
    pub identidad: bool,
    pub id_pend: Option<bool>,
}

#[derive(Clone, Copy, Debug)]
pub enum Fx {
    None,
    TicEntry,
    TicRead(usize),
    TicClose(usize),
    TicArm(usize),
    TicPost(usize),
    TicEnd,
    PlanEntry,
    PlanDrain(usize),
    PlanCompose(usize),
    PlanEnd,
    RecEntry,
    RecScan(usize),
    RecStart(usize),
    RecSusp(usize),
    RecPoll(usize),
    RecResetCh(usize),
    RecDecide(usize),
    EscPrep(usize),
    EscCrit(usize),
    EscProg(usize, usize),
    EscEnd(usize),
    SpiReset(usize),
    RecProg(usize),
    RecDone(usize),
    RecDeny(usize),
    Feeder,
    P2End,
}

#[derive(Clone, Copy, Debug)]
pub struct Step {
    pub ns: u64,
    pub atomic: bool,
    pub fx: Fx,
}

pub struct Job {
    pub prio: u8,
    pub name: &'static str,
    pub steps: VecDeque<Step>,
    pub rem: u64,
    pub started: bool,
}

impl Job {
    fn new(prio: u8, name: &'static str) -> Job {
        Job {
            prio,
            name,
            steps: VecDeque::new(),
            rem: 0,
            started: false,
        }
    }
    fn push_back(&mut self, ns: u64, atomic: bool, fx: Fx) {
        self.steps.push_back(Step { ns, atomic, fx });
    }
    fn push_front(&mut self, ns: u64, atomic: bool, fx: Fx) {
        self.steps.push_front(Step { ns, atomic, fx });
        self.started = false;
    }
}

#[derive(Clone, Copy, Debug)]
pub enum HwEv {
    Uev,
    P2 { dur: u64, atomic: bool },
    P2Seq { id: usize },
    Inject { slot: usize, kind: Inj },
    StallStart { until: u64 },
    P0 { dur: u64 },
    Ident { slot: usize, present: bool },
    FrameDone { slot: usize, gen: u64 },
    FeedTimer,
    IwdgExpire { deadline: u64 },
    Stop,
}

#[derive(Clone, Copy, Debug)]
pub enum Inj {
    /// SPI envenenado: la proxima armada no acaba; el canal para bien; lo cura el reset del SPI
    Hang,
    /// canal GPDMA atascado: no llega a SUSPF; lo cura el reset del GPDMA1 (`persistente` = no lo cura)
    Stuck { persistente: bool },
}

#[derive(Clone, Debug)]
pub struct Mark {
    pub t: u64,
    pub slot: i32,
    pub what: &'static str,
    pub x: i64,
}

pub struct Sim {
    pub cfg: Cfg,
    pub now: u64,
    pub running: Option<Job>,
    pub stack: Vec<Job>,
    pub pend_tic: bool,
    pub pend_plan: bool,
    pub pend_rec: bool,
    pub pend_feed: bool,
    pub pend_p2: VecDeque<Vec<(u64, bool)>>,
    pub pend_p0: VecDeque<u64>,
    /// Periodos que una entrada del tic trajo de mas (testigo `periodos_saltados`).
    pub periodos_saltados: u64,
    /// Entradas en las que `RelojDelTic` conto uno por no poder contar limpio.
    pub reloj_anomalo: u32,
    pub entradas: u64,
    pub cur_periodos: u16,
    heap: BinaryHeap<Reverse<(u64, u64)>>,
    evs: Vec<Option<HwEv>>,
    /// El contador de periodos del tic (`TICS` de `fw`).
    pub tics: u32,
    /// Actualizaciones del TIM7 desde el arranque, y cuantas habia en la ultima entrada del tic:
    /// el reloj es exacto si `tics` es siempre esta ultima.
    pub uevs: u32,
    pub uevs_en_entrada: u32,
    pub reloj_tic: RelojDelTic,
    pub last_uev: u64,
    pub tic_t0: u64,
    pub tics_tard: u32,
    pub retraso_max_us: u32,
    pub uev_merged: u32,
    pub reloj: Reloj64,
    pub plan_now_us: u64,
    pub escaladas: u32,
    pub presupuesto: Presupuesto,
    pub denegadas: u32,
    pub esc_times: Vec<u64>,
    pub stall_until: u64,
    pub s: Vec<SlotW>,
    pub marks: Vec<Mark>,
    pub busy: [u64; 6],
    pub stop: bool,
    pub preempt_count: u64,
    pub max_concurrent_esc: u32,
    pub in_esc: u32,
    /// (ranura, golpes en ns): al emitir el tic el primer `PlazoVencido` de esa ranura, hace
    /// pendientes estos golpes de P2 (como `acapara::si_toca_en_vencida` del banco).
    pub hold_on_vencida: Option<(usize, Golpes)>,
    pub p2seqs: Vec<Vec<(u64, bool)>>,
    pub hold_on_escalada: Option<Vec<Vec<(u64, bool)>>>,
    pub hold_on_rec: Option<(usize, Golpes)>,
    pub plan_since: Option<u64>,
    pub rec_since: Option<u64>,
    pub plan_lat_max: u64,
    pub rec_lat_max: u64,
    pub trace_arm: Option<usize>,
    pub ring_hist_max: usize,
    pub supervisor: Supervisor<N>,
    pub feed_since: Option<u64>,
    pub feed_lat_max: u64,
    pub deadline: u64,
    /// Cuando el supervisor dejo de alimentar, y cuando el IWDG reinicio el chip.
    pub first_refusal: Option<u64>,
    pub iwdg_reset_at: Option<u64>,
}

impl Sim {
    pub fn new(cfg: Cfg) -> Sim {
        let mut s = Vec::new();
        for n in 0..N {
            let mut pol = Politica::nueva(Umbrales::POR_DEFECTO);
            if cfg.active[n] {
                let _ = pol.paso(Evento::Identidad(true), 0);
            }
            s.push(SlotW {
                on: cfg.active[n],
                tic: Transporte::con_cotas(cfg.cotas.0, cfg.cotas.1),
                rx_actual: 0,
                largo: 0,
                hw: HwSlot::default(),
                pol,
                buzon: Triple::nuevo(),
                meta: [(1, 0); 3],
                anillo: Anillo::<8>::nuevo(),
                ring_occ: 0,
                ring_max: 0,
                ring_lost: 0,
                subida: Subida::nueva(),
                largo_subida: 0,
                rec_pedida: false,
                rec_en_curso: false,
                rec_hecha: false,
                rec_t_hecha: 0,
                rec_inc_pedido: 0,
                rec_inc: 0,
                sucia: false,
                sellos: 0,
                sin_bajada: 0,
                errores_dma: 0,
                muertas: 0,
                recuperaciones: 0,
                giros: 0,
                plazos: 0,
                colateral: 0,
                composes: 0,
                last_valid: 0,
                max_gap: 0,
                inicio_susp: 0,
                scratch: None,
                prog_ok: true,
                arm_sin_prog: 0,
                last_seal_t: 0,
                t_venc: 0,
                hecho_rancio: 0,
                identidad: cfg.active[n],
                id_pend: None,
            });
        }
        let mut sim = Sim {
            cfg,
            now: 0,
            running: None,
            stack: Vec::new(),
            pend_tic: false,
            pend_plan: false,
            pend_rec: false,
            pend_feed: false,
            pend_p2: VecDeque::new(),
            pend_p0: VecDeque::new(),
            periodos_saltados: 0,
            reloj_anomalo: 0,
            entradas: 0,
            cur_periodos: 1,
            heap: BinaryHeap::new(),
            evs: Vec::new(),
            tics: 0,
            uevs: 0,
            uevs_en_entrada: 0,
            // Como `lanzar`: la tolerancia son dos cuentas del TIM7 (ESTIMADO).
            reloj_tic: RelojDelTic::nuevo(
                (PERIODO_NS * 4 / 5) as u32,
                CICLOS_POR_CUENTA,
                2 * CICLOS_POR_CUENTA,
            ),
            last_uev: 0,
            tic_t0: 0,
            tics_tard: 0,
            retraso_max_us: 0,
            uev_merged: 0,
            reloj: Reloj64::nuevo(),
            plan_now_us: 0,
            escaladas: 0,
            presupuesto: Presupuesto::nuevo(0, 0),
            denegadas: 0,
            esc_times: Vec::new(),
            stall_until: 0,
            s,
            marks: Vec::new(),
            busy: [0; 6],
            stop: false,
            preempt_count: 0,
            max_concurrent_esc: 0,
            in_esc: 0,
            hold_on_vencida: None,
            p2seqs: Vec::new(),
            hold_on_escalada: None,
            hold_on_rec: None,
            plan_since: None,
            rec_since: None,
            plan_lat_max: 0,
            rec_lat_max: 0,
            trace_arm: None,
            ring_hist_max: 0,
            supervisor: Supervisor::nuevo(0),
            feed_since: None,
            feed_lat_max: 0,
            deadline: 0,
            first_refusal: None,
            iwdg_reset_at: None,
        };
        sim.supervisor = Supervisor::nuevo(sim.cfg.sup_w_ns / 1000);
        sim.presupuesto = match sim.cfg.escaladas {
            Escaladas::Siempre => Presupuesto::nuevo(0, 0),
            Escaladas::K1 { e, ventana_ns } => Presupuesto::nuevo(e, ventana_ns / 1000),
            Escaladas::V2 { e, ventana } => Presupuesto::nuevo(e, ventana),
        };
        // `lanzar`: la primera trama ya esta en el buzon cuando llega el primer tic.
        for n in 0..N {
            if sim.s[n].on {
                sim.plan_compose(n);
            }
        }
        sim.hw_at(PERIODO_NS, HwEv::Uev);
        let fp = sim.cfg.feed_period_ns;
        sim.hw_at(fp, HwEv::FeedTimer);
        sim.deadline = sim.cfg.iwdg_ns;
        let d = sim.deadline;
        sim.hw_at(d, HwEv::IwdgExpire { deadline: d });
        sim
    }

    pub fn hw_at(&mut self, t: u64, ev: HwEv) {
        let id = self.evs.len() as u64;
        self.evs.push(Some(ev));
        self.heap.push(Reverse((t, id)));
    }

    pub fn mark(&mut self, slot: i32, what: &'static str, x: i64) {
        self.marks.push(Mark {
            t: self.now,
            slot,
            what,
            x,
        });
    }

    /// El instante de la primera marca `what` de la ranura `slot` (`-1`: de cualquiera).
    pub fn primera(&self, what: &str, slot: i32) -> Option<u64> {
        self.primera_desde(what, slot, 0)
    }

    /// Cuantas marcas `what` de la ranura `slot` hay desde `t`.
    pub fn cuenta_desde(&self, what: &str, slot: i32, t: u64) -> usize {
        self.marks
            .iter()
            .filter(|m| m.what == what && (slot < 0 || m.slot == slot) && m.t >= t)
            .count()
    }

    pub fn primera_desde(&self, what: &str, slot: i32, t: u64) -> Option<u64> {
        self.marks
            .iter()
            .find(|m| m.what == what && (slot < 0 || m.slot == slot) && m.t >= t)
            .map(|m| m.t)
    }

    // ------------------------------------------------------------------------------
    // Hardware
    // ------------------------------------------------------------------------------

    fn bytes_for(&self, n: usize, k: u64) -> u16 {
        match self.cfg.pat {
            Some(f) => f(n, k),
            None => self.cfg.msg[n],
        }
    }

    pub fn frame_ns(&self, bytes: u16) -> u64 {
        bytes as u64 * 8 * 1_000_000_000 / self.cfg.f_sck + self.cfg.eps_ns
    }

    pub fn plazo_tics(&self, bytes: u16) -> u8 {
        let t = Tsize::nuevo(bytes).unwrap();
        tics_de_plazo(
            plazo_us(t, self.cfg.f_sck as u32, &Umbrales::POR_DEFECTO),
            125,
        )
    }

    fn lee(&self, n: usize) -> Lectura {
        let h = &self.s[n].hw;
        let done = !h.hung && h.frame_end.is_some_and(|e| self.now >= e);
        Lectura {
            eot: done,
            tcf_rx: done,
            tcf_tx: done,
            error_dma: false,
        }
    }

    fn hw_cierra(&mut self, n: usize) {
        let h = &mut self.s[n].hw;
        h.ch_en = false;
        h.in_flight = false;
        h.frame_end = None;
        h.hung = false;
        h.gen += 1;
    }

    fn hw_arma(&mut self, n: usize, bytes: u16) {
        let now = self.now;
        let stall = now < self.stall_until;
        let dur = self.frame_ns(bytes);
        let h = &mut self.s[n].hw;
        h.gen += 1;
        h.in_flight = true;
        h.ch_en = true;
        h.cstart = now;
        let poisoned = std::mem::take(&mut h.poison_next);
        let stuck = h.stuck_next.take();
        if let Some(p) = stuck {
            h.chan_stuck = true;
            if p {
                h.bad = true;
            }
        }
        if h.bad {
            h.chan_stuck = true;
        }
        let hang = poisoned || stuck.is_some() || h.bad || stall || h.spi_hung;
        if hang {
            h.spi_hung = true;
            h.hung = true;
            h.frame_end = None;
        } else {
            h.hung = false;
            h.frame_end = Some(now + dur);
            let gen = h.gen;
            self.hw_at(now + dur, HwEv::FrameDone { slot: n, gen });
        }
        if poisoned || stuck.is_some() {
            self.mark(n as i32, "cstart_veneno", 0);
        }
    }

    fn hw_spi_reset(&mut self, n: usize) {
        let h = &mut self.s[n].hw;
        h.spi_hung = false;
        h.in_flight = false;
        h.frame_end = None;
        h.hung = false;
        h.gen += 1;
    }

    fn hw_gpdma_reset(&mut self) {
        for n in 0..N {
            let h = &mut self.s[n].hw;
            if h.in_flight {
                h.gen += 1;
                h.frame_end = None;
                h.hung = true;
                h.spi_hung = true;
            }
            h.ch_en = false;
            if !h.bad {
                h.chan_stuck = false;
            }
            self.s[n].prog_ok = false;
        }
    }

    fn chan_stuck_now(&self, n: usize) -> bool {
        let h = &self.s[n].hw;
        // IDLEF: un canal con EN = 0 (tras el RESET de una escalada, o cerrado) para siempre.
        h.ch_en && (h.chan_stuck || self.now < self.stall_until)
    }

    // ------------------------------------------------------------------------------
    // Planificador de la CPU
    // ------------------------------------------------------------------------------

    fn best_pending(&self) -> Option<(u8, u8)> {
        // (prio, kind) kind: 0 tic, 1 p2, 2 plan, 3 rec, 5 p0
        let mut best: Option<(u8, u8)> = None;
        let mut consider = |p: u8, k: u8| {
            if best.is_none_or(|(bp, _)| p < bp) {
                best = Some((p, k));
            }
        };
        if !self.pend_p0.is_empty() {
            consider(0, 5);
        }
        if self.pend_tic {
            consider(1, 0);
        }
        if !self.pend_p2.is_empty() {
            consider(2, 1);
        }
        if self.pend_plan {
            consider(3, 2);
        }
        if self.pend_rec {
            consider(4, 3);
        }
        if self.pend_feed {
            consider(5, 4);
        }
        best
    }

    fn start_pending(&mut self, kind: u8) -> Job {
        match kind {
            0 => {
                self.pend_tic = false;
                let mut j = Job::new(1, "tic");
                j.push_back(cy(125), false, Fx::TicEntry);
                j
            }
            1 => {
                let seq = self.pend_p2.pop_front().unwrap();
                let mut j = Job::new(2, "p2");
                for (dur, atomic) in seq {
                    j.push_back(dur, atomic, Fx::P2End);
                }
                j
            }
            2 => {
                if let Some(t) = self.plan_since.take() {
                    self.plan_lat_max = self.plan_lat_max.max(self.now - t);
                }
                self.pend_plan = false;
                let mut j = Job::new(3, "plan");
                j.push_back(cy(100), false, Fx::PlanEntry);
                j
            }
            3 => {
                if let Some(t) = self.rec_since.take() {
                    self.rec_lat_max = self.rec_lat_max.max(self.now - t);
                }
                self.pend_rec = false;
                let mut j = Job::new(4, "rec");
                j.push_back(cy(100), false, Fx::RecEntry);
                j
            }
            4 => {
                if let Some(t) = self.feed_since.take() {
                    self.feed_lat_max = self.feed_lat_max.max(self.now - t);
                }
                self.pend_feed = false;
                let mut j = Job::new(5, "feed");
                j.push_back(5_000, false, Fx::Feeder);
                j
            }
            _ => {
                let d = self.pend_p0.pop_front().unwrap();
                let mut j = Job::new(0, "p0");
                j.push_back(d, false, Fx::P2End);
                j
            }
        }
    }

    fn running_atomic(&self) -> bool {
        self.running
            .as_ref()
            .is_some_and(|r| r.steps.front().is_some_and(|s| s.atomic))
    }

    fn schedule(&mut self) {
        if self.pend_plan && self.plan_since.is_none() {
            self.plan_since = Some(self.now);
        }
        if self.pend_rec && self.rec_since.is_none() {
            self.rec_since = Some(self.now);
        }
        loop {
            let bp = self.best_pending();
            if self.running.is_none() {
                let top = self.stack.last().map(|j| j.prio);
                if let Some((p, k)) = bp {
                    if top.is_none_or(|tp| p < tp) {
                        let j = self.start_pending(k);
                        self.running = Some(j);
                        continue;
                    }
                }
                if let Some(j) = self.stack.pop() {
                    self.running = Some(j);
                }
                break;
            } else {
                if self.running_atomic() {
                    break;
                }
                let rp = self.running.as_ref().unwrap().prio;
                if let Some((p, k)) = bp {
                    if p < rp {
                        let r = self.running.take().unwrap();
                        self.stack.push(r);
                        self.preempt_count += 1;
                        let j = self.start_pending(k);
                        self.running = Some(j);
                        continue;
                    }
                }
                break;
            }
        }
        if let Some(r) = self.running.as_mut() {
            if !r.started {
                if let Some(s) = r.steps.front() {
                    r.rem = s.ns;
                    r.started = true;
                }
            }
        }
    }

    pub fn run_until(&mut self, t_end: u64) {
        loop {
            self.schedule();
            if self.stop {
                break;
            }
            // 1. un paso de duracion cero (o ya acabado) se completa en el acto
            let zero = self
                .running
                .as_ref()
                .is_some_and(|r| r.started && r.rem == 0);
            if zero {
                self.complete_front();
                continue;
            }
            // 2. eventos de hardware con hora <= ahora
            if let Some(&Reverse((th, id))) = self.heap.peek() {
                if th <= self.now {
                    self.heap.pop();
                    if let Some(ev) = self.evs[id as usize].take() {
                        self.hw_event(ev);
                    }
                    continue;
                }
            }
            if self.now >= t_end {
                break;
            }
            // 3. avanzar el reloj
            let t_hw = self
                .heap
                .peek()
                .map(|Reverse((t, _))| *t)
                .unwrap_or(u64::MAX);
            let t_cpu = self.running.as_ref().map_or(u64::MAX, |r| self.now + r.rem);
            let t = t_hw.min(t_cpu).min(t_end);
            let dt = t - self.now;
            if let Some(r) = self.running.as_mut() {
                r.rem -= dt;
                let idx = (r.prio as usize).min(5);
                self.busy[idx] += dt;
            }
            self.now = t;
        }
    }

    fn complete_front(&mut self) {
        let mut job = self.running.take().unwrap();
        let st = job.steps.pop_front().unwrap();
        job.started = false;
        self.apply(st.fx, &mut job);
        if !job.steps.is_empty() {
            self.running = Some(job);
        }
    }

    fn hw_event(&mut self, ev: HwEv) {
        match ev {
            HwEv::Uev => {
                self.last_uev = self.now;
                self.uevs += 1;
                if self.pend_tic {
                    self.uev_merged += 1;
                }
                self.pend_tic = true;
                self.hw_at(self.now + PERIODO_NS, HwEv::Uev);
            }
            HwEv::P2 { dur, atomic } => self.pend_p2.push_back(vec![(dur, atomic)]),
            HwEv::P0 { dur } => self.pend_p0.push_back(dur),
            HwEv::Ident { slot, present } => self.s[slot].id_pend = Some(present),
            HwEv::P2Seq { id } => {
                let q = self.p2seqs[id].clone();
                self.pend_p2.push_back(q);
            }
            HwEv::Inject { slot, kind } => match kind {
                Inj::Hang => self.s[slot].hw.poison_next = true,
                Inj::Stuck { persistente } => self.s[slot].hw.stuck_next = Some(persistente),
            },
            HwEv::StallStart { until } => {
                self.stall_until = until;
                let now = self.now;
                for n in 0..N {
                    let h = &mut self.s[n].hw;
                    if h.in_flight && !h.hung && h.frame_end.is_some_and(|e| e > now) {
                        h.hung = true;
                        h.frame_end = None;
                        h.gen += 1;
                    }
                }
                self.mark(-1, "stall_inicio", (until - now) as i64);
            }
            HwEv::FrameDone { slot, gen } => {
                let now = self.now;
                let s = &mut self.s[slot];
                if s.hw.gen == gen && s.hw.frame_end.is_some() {
                    let gap = now.saturating_sub(s.last_valid);
                    if s.last_valid != 0 && gap > s.max_gap {
                        s.max_gap = gap;
                    }
                    s.last_valid = now;
                }
            }
            HwEv::FeedTimer => {
                if self.feed_since.is_none() {
                    self.feed_since = Some(self.now);
                }
                self.pend_feed = true;
                self.hw_at(self.now + self.cfg.feed_period_ns, HwEv::FeedTimer);
            }
            HwEv::IwdgExpire { deadline } => {
                if deadline == self.deadline && self.iwdg_reset_at.is_none() {
                    self.iwdg_reset_at = Some(self.now);
                    self.mark(-1, "iwdg_reset", 0);
                    self.stop = self.cfg.para_al_reiniciar;
                }
            }
            HwEv::Stop => self.stop = true,
        }
    }

    // ------------------------------------------------------------------------------
    // Efectos de cada paso
    // ------------------------------------------------------------------------------

    fn costs(&self) -> (u64, u64, u64, u64, u64) {
        // (read, pre, close, arm, post) en ciclos. EN-PLACA.md: leer 139, cerrar 10, armar 617,
        // resto ~410 con caches calientes; leer 268, cerrar 31, armar 605, total 1 528 con la
        // D-cache desalojada.
        if self.cfg.cold {
            (268, 312, 31, 605, 312)
        } else {
            (139, 205, 10, 617, 205)
        }
    }

    fn tic_next_slot(&mut self, from: usize, job: &mut Job) {
        let mut n = from;
        while n < N && !self.s[n].on {
            n += 1;
        }
        if n >= N {
            job.push_back(cy(50), false, Fx::TicEnd);
            return;
        }
        let (read, pre, _, _, _) = self.costs();
        let armada = matches!(self.s[n].tic.estado(), Estado::Armada { .. });
        let c = if self.s[n].sucia {
            40
        } else if armada {
            read + pre
        } else {
            30 + pre
        };
        job.push_back(cy(c), false, Fx::TicRead(n));
    }

    fn ring_push(&mut self, n: usize, e: Evento) {
        let ok = self.s[n].anillo.empujar(e);
        if ok {
            let s = &mut self.s[n];
            s.ring_occ += 1;
            if s.ring_occ > s.ring_max {
                s.ring_max = s.ring_occ;
            }
            let o = s.ring_occ;
            if o > self.ring_hist_max {
                self.ring_hist_max = o;
            }
        } else {
            self.s[n].ring_lost += 1;
            self.mark(n as i32, "ANILLO_LLENO_descarta", codigo(e) as i64);
        }
    }

    fn apply(&mut self, fx: Fx, job: &mut Job) {
        let now = self.now;
        match fx {
            Fx::None | Fx::P2End | Fx::PlanEnd => {}
            // ---------------- el tic ----------------
            Fx::TicEntry => {
                self.tic_t0 = now;
                self.uevs_en_entrada = self.uevs;
                // `TIM7.CNT`: microsegundos desde la ultima actualizacion.
                let retraso = ((now - self.last_uev) / 1000) as u32;
                if retraso > 10 {
                    self.tics_tard += 1;
                }
                if retraso > self.retraso_max_us {
                    self.retraso_max_us = retraso;
                }
                // `DWT_CYCCNT` a 800 MHz, de 32 bits.
                let ciclos = (now * 4 / 5) as u32;
                let p = self.reloj_tic.entrada(retraso, ciclos);
                if p.anomalo {
                    self.reloj_anomalo += 1;
                }
                self.entradas += 1;
                if p.n == 0 {
                    // Una reentrada por la misma actualizacion: `fw` sale sin tocar nada.
                    return;
                }
                self.periodos_saltados += u64::from(p.n - 1);
                self.cur_periodos = p.n.min(u32::from(u16::MAX)) as u16;
                self.tics = self.tics.wrapping_add(p.n);
                self.tic_next_slot(0, job);
            }
            Fx::TicRead(n) => {
                let antes = self.s[n].tic.estado();
                let lectura = if matches!(antes, Estado::Armada { .. }) && !self.s[n].sucia {
                    self.lee(n)
                } else {
                    Lectura::default()
                };
                let gap = self.cfg.gap_ns;
                let t0 = self.tic_t0;
                let per = self.cur_periodos;
                let s = &mut self.s[n];
                let bajada = s.buzon.fresca().map(|c| s.meta[c].0);
                let (en_curso, hecho) =
                    if matches!(antes, Estado::Vencida { .. } | Estado::Reiniciando { .. }) {
                        (
                            s.rec_en_curso,
                            s.rec_hecha && t0.wrapping_sub(s.rec_t_hecha) >= gap,
                        )
                    } else {
                        (false, false)
                    };
                let rancio = hecho && s.rec_t_hecha < s.t_venc;
                let sal = s.tic.avanza(
                    Entrada {
                        lectura,
                        identidad: s.identidad,
                        bajada,
                        reinicio_en_curso: en_curso,
                        reinicio_hecho: hecho,
                        sucia: s.sucia,
                        incidente: s.rec_inc,
                    },
                    per,
                );
                s.scratch = Some((antes, sal));
                let sale = matches!(s.tic.estado(), Estado::Libre | Estado::Armada { .. });
                if rancio && sale {
                    s.hecho_rancio += 1;
                    self.mark(n as i32, "HECHA_RANCIA_rearma", 0);
                }
                let (_, _, close, arm, post) = self.costs();
                if sal.cerrar {
                    job.push_back(cy(close), false, Fx::TicClose(n));
                }
                if sal.armar {
                    job.push_back(cy(arm), false, Fx::TicArm(n));
                }
                let any =
                    sal.cerrar || sal.armar || sal.eventos[0].is_some() || sal.aviso.is_some();
                job.push_back(cy(if any { post } else { 65 }), false, Fx::TicPost(n));
            }
            Fx::TicClose(n) => {
                self.hw_cierra(n);
                let (_, sal) = self.s[n].scratch.unwrap();
                if sal.eventos[0] == Some(Evento::GiroOk) {
                    let s = &mut self.s[n];
                    s.largo_subida = s.largo;
                    s.subida.publicar(s.rx_actual as usize);
                    s.rx_actual ^= 1;
                    s.giros += 1;
                }
            }
            Fx::TicArm(n) => {
                if let Some(c) = self.s[n].buzon.consumir() {
                    let (_, largo) = self.s[n].meta[c];
                    self.s[n].largo = largo;
                    self.hw_arma(n, largo);
                    self.s[n].sellos += 1;
                    self.s[n].last_seal_t = now;
                    if !self.s[n].prog_ok {
                        self.s[n].arm_sin_prog += 1;
                        self.mark(n as i32, "ARMA_SIN_PROGRAMA", 0);
                    }
                    if self.trace_arm == Some(n) {
                        self.mark(n as i32, "cstart", 0);
                    }
                }
            }
            Fx::TicPost(n) => {
                if let Some((antes, sal)) = self.s[n].scratch.take() {
                    for e in sal.eventos.into_iter().flatten() {
                        if e == Evento::PlazoVencido {
                            self.s[n].t_venc = now;
                            self.s[n].plazos += 1;
                            self.mark(n as i32, "tic_vencida", 0);
                            if let Some((hn, durs)) = self.hold_on_vencida.clone() {
                                if hn == n {
                                    self.hold_on_vencida = None;
                                    for d in durs {
                                        self.pend_p2.push_back(d);
                                    }
                                }
                            }
                        }
                        self.ring_push(n, e);
                    }
                    let s = &mut self.s[n];
                    match sal.aviso {
                        Some(Aviso::SinBajada) => s.sin_bajada += 1,
                        Some(Aviso::ErrorDma) => s.errores_dma += 1,
                        Some(Aviso::RanuraMuerta) => {
                            s.muertas += 1;
                            self.mark(n as i32, "muerta", 0);
                        }
                        None => {}
                    }
                    let fuera = |e: Estado| {
                        matches!(e, Estado::Vencida { .. } | Estado::Reiniciando { .. })
                    };
                    let s = &mut self.s[n];
                    if fuera(antes) && !fuera(s.tic.estado()) {
                        s.rec_hecha = false;
                        s.rec_en_curso = false;
                    }
                }
                self.tic_next_slot(n + 1, job);
            }
            Fx::TicEnd => {
                self.pend_plan = true;
            }
            // ---------------- el planificador ----------------
            Fx::PlanEntry => {
                let tics = self.reloj.extiende(self.tics);
                self.plan_now_us = tics * PERIODO_NS / 1000;
                self.plan_next(0, job);
            }
            Fx::PlanDrain(n) => {
                self.plan_drain(n);
                let fresca = self.s[n].buzon.fresca().is_some();
                let costo = if fresca { 538 } else { 823 };
                let extra = if fresca { 0 } else { self.cfg.plan_extra_ns };
                job.push_back(cy(costo) + extra, false, Fx::PlanCompose(n));
            }
            Fx::PlanCompose(n) => {
                self.plan_compose(n);
                self.plan_next(n + 1, job);
            }
            // ---------------- la recuperacion ----------------
            Fx::RecEntry => {
                job.push_back(cy(20), false, Fx::RecScan(0));
            }
            Fx::RecScan(n) => {
                if self.s[n].rec_pedida {
                    self.s[n].rec_pedida = false;
                    if n + 1 < N {
                        job.push_front(cy(20), false, Fx::RecScan(n + 1));
                    }
                    job.push_front(0, false, Fx::RecStart(n));
                } else if n + 1 < N {
                    job.push_back(cy(20), false, Fx::RecScan(n + 1));
                }
            }
            Fx::RecStart(n) => {
                if self.s[n].muertas > 0 {
                    // H5: la pidio viva y murio antes de que la recuperacion corriera.
                    self.mark(n as i32, "rec_saltada_muerta", 0);
                    return;
                }
                self.s[n].rec_inc = self.s[n].rec_inc_pedido;
                self.s[n].rec_en_curso = true;
                self.mark(n as i32, "rec_inicio", 0);
                if let Some((hn, durs)) = self.hold_on_rec.clone() {
                    if hn == n {
                        self.hold_on_rec = None;
                        for d in durs {
                            self.pend_p2.push_back(d);
                        }
                    }
                }
                job.push_front(cy(100), false, Fx::RecSusp(n));
            }
            Fx::RecSusp(n) => {
                let susp = self.cfg.susp_ns;
                let s = &mut self.s[n];
                s.inicio_susp = now;
                s.hw.suspf_at = Some(now + susp);
                job.push_front(cy(180), false, Fx::RecPoll(n));
            }
            Fx::RecPoll(n) => {
                let paradas =
                    !self.chan_stuck_now(n) && self.s[n].hw.suspf_at.is_some_and(|t| now >= t);
                let elapsed = now - self.s[n].inicio_susp;
                if paradas {
                    job.push_front(cy(100), false, Fx::RecResetCh(n));
                } else if elapsed >= self.cfg.t_canal_ns {
                    // la ultima lectura antes de rendirse (hallazgo 6): mismo instante, mismo resultado
                    self.mark(n as i32, "rec_canal_no_para", elapsed as i64);
                    job.push_front(cy(50), false, Fx::RecDecide(n));
                } else {
                    job.push_front(cy(180), false, Fx::RecPoll(n));
                }
            }
            Fx::RecResetCh(n) => {
                job.push_front(1_200, true, Fx::SpiReset(n));
            }
            Fx::RecDecide(n) => {
                let concede = match self.cfg.escaladas {
                    Escaladas::Siempre => true,
                    // El reloj del tic, en us.
                    Escaladas::K1 { .. } => self.presupuesto.pide(u64::from(self.tics) * 125),
                    Escaladas::V2 { .. } => self.presupuesto.pide(self.entradas),
                };
                if concede {
                    job.push_front(cy(100), false, Fx::EscPrep(n));
                } else {
                    self.denegadas += 1;
                    self.mark(n as i32, "escalada_DENEGADA", 0);
                    job.push_front(cy(100), false, Fx::RecDeny(n));
                }
            }
            Fx::RecDeny(n) => {
                // K1: el RESET por canal y nada mas; la ranura muere por la cota de
                // `Reiniciando`.
                self.s[n].hw.ch_en = false;
            }
            Fx::EscPrep(n) => {
                self.escaladas += 1;
                self.esc_times.push(now);
                self.mark(n as i32, "escalada", self.escaladas as i64);
                self.in_esc += 1;
                if self.in_esc > self.max_concurrent_esc {
                    self.max_concurrent_esc = self.in_esc;
                }
                job.push_front(770, true, Fx::EscCrit(n));
            }
            Fx::EscCrit(n) => {
                self.hw_gpdma_reset();
                for k in 0..N {
                    if !self.s[k].on {
                        continue;
                    }
                    self.s[k].sucia = true;
                    // `escala()`: las vecinas en vuelo reciben un `PlazoAjeno`.
                    if let Some(ev) = self.s[k].tic.declarar_vencida() {
                        self.s[k].colateral += 1;
                        self.s[k].t_venc = now;
                        self.mark(k as i32, "plazo_ajeno", n as i64);
                        self.ring_push(k, ev);
                    }
                }
                if let Some(jobs) = self.hold_on_escalada.take() {
                    for j in jobs {
                        self.pend_p2.push_back(j);
                    }
                }
                // las reprogramaciones, una tras otra, en el orden de `escala()`
                for k in (0..N).rev() {
                    if self.s[k].on {
                        job.push_front(1_900, false, Fx::EscProg(n, k));
                    }
                }
            }
            Fx::EscProg(n, k) => {
                // programa(): CR.RESET primero; si el tic armo el canal antes, la transferencia
                // muere aqui
                if self.s[k].hw.in_flight {
                    let h = &mut self.s[k].hw;
                    h.gen += 1;
                    h.frame_end = None;
                    h.hung = true;
                    h.spi_hung = true;
                    h.ch_en = false;
                    self.mark(k as i32, "programa_aborta_en_vuelo", 0);
                }
                self.s[k].prog_ok = true;
                self.s[k].sucia = false;
                if (k + 1..N).all(|j| !self.s[j].on) {
                    job.push_front(cy(20), false, Fx::EscEnd(n));
                }
            }
            Fx::EscEnd(n) => {
                self.in_esc -= 1;
                self.pend_plan = true;
                job.push_front(1_200, true, Fx::SpiReset(n));
            }
            Fx::SpiReset(n) => {
                self.hw_spi_reset(n);
                self.mark(n as i32, "spi_reset", 0);
                job.push_front(3_800, false, Fx::RecProg(n));
            }
            Fx::RecProg(n) => {
                self.s[n].prog_ok = true;
                job.push_front(cy(100), false, Fx::RecDone(n));
            }
            Fx::RecDone(n) => {
                let s = &mut self.s[n];
                s.rec_t_hecha = now;
                s.rec_hecha = true;
                s.recuperaciones += 1;
                self.mark(n as i32, "rec_hecha", 0);
            }
            // ---------------- el supervisor del hub (hilo) ----------------
            Fx::Feeder => {
                let mut vistas = [Vista::default(); N];
                for (v, s) in vistas.iter_mut().zip(&self.s) {
                    v.identidad = s.on && s.identidad;
                    v.ultimo_sello_us = s.last_seal_t / 1000;
                }
                if self.supervisor.mira(now / 1000, &vistas) {
                    self.deadline = now + self.cfg.iwdg_ns;
                    let d = self.deadline;
                    self.hw_at(d, HwEv::IwdgExpire { deadline: d });
                } else if self.first_refusal.is_none() {
                    self.first_refusal = Some(now);
                    let causa = self.supervisor.causa().map_or(-1, |c| c as i64);
                    self.mark(-1, "supervisor_deja_de_alimentar", causa);
                }
            }
        }
    }

    fn plan_next(&mut self, from: usize, job: &mut Job) {
        let mut n = from;
        while n < N && !self.s[n].on {
            n += 1;
        }
        if n >= N {
            job.push_back(0, false, Fx::PlanEnd);
        } else {
            job.push_back(0, false, Fx::PlanDrain(n));
        }
    }

    fn plan_drain(&mut self, n: usize) {
        let ahora = self.plan_now_us;
        let mut hubo = false;
        if let Some(p) = self.s[n].id_pend.take() {
            // ponytail: sin la limpieza por identidad de §2.2 (K4); solo la politica y la marca.
            let _ = self.s[n].pol.paso(Evento::Identidad(p), ahora);
            self.s[n].identidad = p;
        }
        while let Some(ev) = self.s[n].anillo.sacar() {
            self.s[n].ring_occ = self.s[n].ring_occ.saturating_sub(1);
            hubo = true;
            match ev {
                Evento::GiroOk => {
                    let _ = self.s[n].pol.paso(Evento::GiroOk, ahora);
                    let lect = self.s[n].subida.leer(|_c| {});
                    if let LecSubida::Nueva(_) = lect {
                        let _ = self.s[n].pol.paso(Evento::SubidaOk, ahora);
                    }
                }
                Evento::PlazoVencido | Evento::PlazoAjeno => {
                    // La politica es la unica autoridad sobre «reiniciar»; un plazo ajeno pide
                    // la limpieza sin puntuar.
                    // H5: `muertas` es lo que publica el tic; una ranura muerta no se recupera.
                    if self.s[n].pol.paso(ev, ahora) == Accion::Reiniciar && self.s[n].muertas == 0
                    {
                        self.s[n].rec_inc_pedido = self.s[n].tic.incidente();
                        self.s[n].rec_pedida = true;
                        self.pend_rec = true;
                        self.mark(n as i32, "plan_pide_rec", 0);
                    }
                }
                otro => {
                    let _ = self.s[n].pol.paso(otro, ahora);
                }
            }
        }
        if !hubo {
            let _ = self.s[n].pol.paso(Evento::Tick, ahora);
        }
    }

    fn plan_compose(&mut self, n: usize) {
        if self.s[n].buzon.fresca().is_some() || !self.s[n].identidad {
            return;
        }
        let k = self.s[n].composes;
        let bytes = self.bytes_for(n, k);
        let plazo = self.plazo_tics(bytes);
        let s = &mut self.s[n];
        let c = s.buzon.casilla_escritura();
        s.meta[c] = (plazo, bytes);
        s.buzon.publicar();
        s.composes += 1;
    }
}
