sssamuelll/analog-modular-synthesizer/software/nucleo/fw/src/bin/carga_j2.rs

#![no_std]
#![no_main]

//! **Cuanta CPU gasta un giro del J2, y cuanta le deja al hilo.**
//!
//! Herramienta de medida del banco, no un punto del orden del dia: es la que
//! produce el numero que el papel del maestro pide como criterio de aceptacion
//! de la CPU (spec D5.1, enmienda del 2026-10-16) y la que hay que correr antes
//! y despues de tocar el camino caliente del driver.
//!
//! Gira **el maestro solo** -- sin el esclavo del banco, que en el mismo nucleo
//! le comeria la CPU y falsearia la cuenta. El periodo depende del reloj: a 800
//! MHz (`reloj-hub`) es el del instrumento, [`PERIODO_GIRO_US`] (125 us); a 64
//! MHz son 1 ms, porque a 125 us el giro llega siempre tarde, el calendario
//! (`core::maestro_j2::Calendario`) deja un periodo de hueco y la medida es la
//! de un lazo saturado, que no se parece al del hub. Lo que se mide es el coste
//! del giro y lo que sobra para el hilo.
//!
//! Con `--features ranuras-2` o `ranuras-3` giran ademas una o dos ranuras de
//! relleno (SPI1 y SPI2, sin modulo detras; pines en `j2_banco`): el coste por
//! giro es el total entre todos los giros de todas las ranuras, y asi se ve que
//! parte es de cada ranura y cual se reparte (la ISR del reloj, la entrada del
//! ejecutor). Con `ranuras-3` a 64 MHz el periodo sube a 2 ms para que ninguna
//! ranura llegue tarde. Dos
//! pasadas: sin cache y con la I-cache encendida; con `--features reloj-hub` (el
//! nucleo a 800 MHz) hay una tercera con tambien la D-cache, **sin la region MPU
//! de los buferes del DMA** (R-MJ7): es de exploracion, los datos de los buferes
//! salen incoherentes y esa fila no sirve para la puerta. Se marca
//! `icache+dcache-sin-mpu`.
//!
//! **Una base por estado de cache.** El medidor del hilo cuenta vueltas y las compara
//! con las de la CPU entera, y con la I-cache el hilo da mas vueltas por segundo que
//! sin ella. Antes de arrancar el J2 se calibra una base con cada estado (encendiendo
//! las caches de a una y apagandolas al final); la pasada compara contra la suya. Con
//! una sola base, la de sin cache, el 17-10 salio 889 permil libres con un ejecutor
//! que ya gastaba el 22 % de la CPU: el J2 salia menor que su propio manejador.
//!
//! Por cada pasada, dos lineas:
//!
//! ```text
//! carga_j2,cache=<no|icache>,ranuras=,periodo_us=,ciclo_us=,giros_en_5s=,hilo_libre_permil=,atrasos=,plazos_vencidos=,base_por_s=
//! carga_j2,cache=<no|icache>,previo=,armado=,espera=,cierre=,posterior=,isr_spi=,ejecutor=
//! ```
//!
//! La segunda son **ciclos de CPU por giro** (`perfil`): hay que compilar con
//! `--features perfil`, o salen en cero y lo dice. `ejecutor` es todo el
//! manejador del ejecutor del J2, sin la ISR del SPI; `previo`, `armado`,
//! `cierre` y `posterior` son el codigo de la tarea, y la diferencia con
//! `ejecutor` es la maquinaria de futuros y el despacho. `espera` es tiempo de
//! reloj, no CPU. `hilo_libre_permil` es la CPU libre para el hilo, medida por
//! el propio hilo (`carga`).
//!
//! ```bash
//! cargo run --release --features perfil --bin carga_j2
//! cargo run --release --features perfil,reloj-hub --bin carga_j2   # a 800 MHz
//! ```
//!
//! La cabecera trae el reloj pedido (`f_cpu`) y el medido (`f_cpu_medido`, los
//! ciclos del `DWT` en 100 ms de `embassy_time`): si no coinciden, la cuenta de
//! ciclos por giro sale con un reloj que no es el que se cree.

use defmt::info;
use embassy_executor::Spawner;
#[cfg(not(any(feature = "transporte-isr", feature = "transporte-tic")))]
use embassy_stm32::interrupt;
use embassy_time::Timer;
use sam17_nucleo_core::maestro_j2::RANURAS_SPI;
use sam17_nucleo_fw::carga::{vueltas_del_hilo, Medidor};
#[cfg_attr(not(feature = "transporte-tic"), allow(unused_imports))]
use sam17_nucleo_fw::j2_banco::bajada_quieta;
use sam17_nucleo_fw::j2_banco::{
    bajada_del_banco, juez_del_banco, PERIODO_DE_MEDIDA_US, RANURAS_DE_MEDIDA,
};
use sam17_nucleo_fw::j2_ejecutor::cuentas;
#[cfg(not(any(feature = "transporte-isr", feature = "transporte-tic")))]
use sam17_nucleo_fw::j2_ejecutor::{iniciar_ejecutor, lanzar_ranuras};
use sam17_nucleo_fw::j2_spi::Config;
use sam17_nucleo_fw::perfil::{self, Promedios};
use sam17_nucleo_fw::ranuras_de_medida;
use sam17_nucleo_fw::usb;
use {defmt_rtt as _, panic_probe as _};

/// Cuanto dura cada muestra.
const MUESTRA_S: u64 = 5;

#[cfg(all(feature = "transporte-isr", feature = "ranuras-2"))]
compile_error!("transporte-isr solo mueve la ranura 0: sin ranuras-2 ni ranuras-3");
#[cfg(all(feature = "transporte-isr", feature = "transporte-tic"))]
compile_error!("transporte-isr y transporte-tic son dos transportes: uno solo");

/// La bajada que el planificador pide: con `sin-componer`, la que no compone nada. Es la
/// mitad de la medida de la ficha 1 del acta del 17-10 (el enlace sin componer la trama).
#[cfg(feature = "transporte-tic")]
const BAJADA: sam17_nucleo_fw::j2_ejecutor::Bajada = if cfg!(feature = "sin-componer") {
    bajada_quieta
} else {
    bajada_del_banco
};

/// Una tarea de hilo que recorre 64 KB -- el doble de la D-cache del M55 -- a razon de una
/// lectura por linea de 32 bytes, y cede el turno. Con ella el hilo se parece a un hub que
/// hace otras cosas: lo que el J2 necesita de la cache se lo desaloja cada pasada.
#[cfg(feature = "contaminador")]
#[embassy_executor::task]
async fn contaminador() -> ! {
    static mut AREA: [u32; 16_384] = [0; 16_384];
    // Palabras que recorre por vuelta: 64 KB, o menos con `contaminador-8k|16k|32k`.
    const BARRIDO: usize = if cfg!(feature = "contaminador-8k") {
        2_048
    } else if cfg!(feature = "contaminador-16k") {
        4_096
    } else if cfg!(feature = "contaminador-32k") {
        8_192
    } else {
        16_384
    };
    loop {
        let mut suma = 0u32;
        for i in (0..BARRIDO).step_by(8) {
            // SAFETY: nadie mas toca `AREA`, y `i` esta en rango.
            suma = suma.wrapping_add(unsafe {
                core::ptr::read_volatile((core::ptr::addr_of!(AREA) as *const u32).add(i))
            });
        }
        core::hint::black_box(suma);
        #[cfg(feature = "contaminador-icache")]
        perfil::invalida_icache();
        embassy_futures::yield_now().await;
    }
}

const RANURAS_ACTIVAS: u32 = RANURAS_DE_MEDIDA;
const PERIODO_US: u32 = PERIODO_DE_MEDIDA_US;

/// Enciende las caches que pide la pasada, sin apagar las de la anterior: `icache` la
/// I-cache; `icache+dcache-sin-mpu` e `icache+dcache-mpu`, ademas la D-cache (la segunda,
/// con la region de los bufferes del transporte por tic ya en la MPU).
fn encender_cache(cache: &str) {
    // SAFETY: nadie mas toca el SCB. La D-cache solo se enciende en la pasada de
    // exploracion, sin la region MPU (R-MJ7): `nueva` asevera que estaba apagada al
    // construir la ranura, y las ranuras ya estan construidas.
    unsafe {
        let mut p = cortex_m::Peripherals::steal();
        match cache {
            "icache" => p.SCB.enable_icache(),
            "icache+dcache-sin-mpu" | "icache+dcache-mpu" => p.SCB.enable_dcache(&mut p.CPUID),
            _ => {}
        }
    }
}

/// Deja las caches apagadas, como las encuentra el J2 al arrancar.
fn apagar_caches() {
    // SAFETY: igual, y sin DMA en vuelo: el J2 todavia no ha arrancado.
    unsafe {
        let mut p = cortex_m::Peripherals::steal();
        p.SCB.disable_dcache(&mut p.CPUID);
        p.SCB.disable_icache();
    }
}

/// Lo que se midio en la segunda muestra de una pasada. Se guarda y se imprime al
/// final: un `info!` mantiene las interrupciones apagadas mientras escribe -- a
/// 800 MHz, 174 us sin caches, 87 con la I-cache y ~11 con las dos --, mas que un
/// periodo del J2 en los dos primeros casos, y retrasaria el tic o el ejecutor
/// justo donde se mide.
#[derive(Clone, Copy)]
struct Pasada {
    cache: &'static str,
    ciclo_us: u32,
    giros: u32,
    libre: u32,
    atrasos: u32,
    plazos: u32,
    base: u32,
    #[cfg_attr(feature = "transporte-tic", allow(dead_code))]
    m: [u32; perfil::FASES],
    /// Los giros que el transporte por ISR no cerro, sus errores del DMA y como
    /// estaba el ultimo que un tic encontro sin cerrar.
    #[cfg(feature = "transporte-isr")]
    isr: (u32, u32, [u32; 5]),
    /// Ciclos por giro de cada nivel del transporte por tic (tic, planificador,
    /// recuperacion, componer) y los testigos al cerrar la pasada.
    #[cfg(feature = "transporte-tic")]
    tic: ([u32; 7], sam17_nucleo_fw::j2_tic::Testigos),
    /// Lo que dura cada entrada del tic, en ciclos (media y maximo de la muestra), sin la
    /// entrada ni la salida de la excepcion. Con `perfil`.
    #[cfg(feature = "transporte-tic")]
    isr_tic: (u32, u32),
    /// La entrada de la excepcion del tic, en ciclos (media y maximo). Con `tic-fino` y `perfil`.
    #[cfg(feature = "transporte-tic")]
    entrada_tic: (u32, u32),
    /// El encadenado del tic al planificador, en ciclos (media y maximo). Con `tic-fino` y `perfil`.
    #[cfg(feature = "transporte-tic")]
    cadena_tic: (u32, u32),
    /// f_cpu en MHz (ciclos por microsegundo), para pasar los ciclos de arriba a nanosegundos.
    #[cfg(feature = "transporte-tic")]
    f_cpu_mhz: u32,
}

impl Pasada {
    fn imprime(&self) {
        info!(
            "carga_j2,cache={=str},ranuras={},periodo_us={},ciclo_us={},giros_en_5s={},hilo_libre_permil={},atrasos={},plazos_vencidos={},base_por_s={}",
            self.cache,
            RANURAS_ACTIVAS,
            PERIODO_US,
            self.ciclo_us,
            self.giros,
            self.libre,
            self.atrasos,
            self.plazos,
            self.base
        );
        #[cfg(feature = "transporte-tic")]
        {
            let (c, t) = &self.tic;
            info!(
                "carga_j2,cache={=str},tic,ciclos_por_giro: tic={},planificador={},recuperacion={},componer={}",
                self.cache, c[0], c[1], c[2], c[3]
            );
            info!(
                "carga_j2,cache={=str},tic,detalle_del_tic: lee={},cierra={},arma={}",
                self.cache, c[4], c[5], c[6]
            );
            info!("carga_j2,cache={=str},tic,{}", self.cache, t);
            let (media, max) = self.isr_tic;
            let mhz = self.f_cpu_mhz.max(1);
            info!(
                "carga_j2,cache={=str},tic,isr_tic: media={} ciclos ({} ns), max={} ciclos ({} ns)",
                self.cache,
                media,
                media * 1000 / mhz,
                max,
                max * 1000 / mhz
            );
            let (em, ex) = self.entrada_tic;
            info!(
                "carga_j2,cache={=str},tic,entrada_tic: media={} ciclos, max={} ciclos",
                self.cache,
                em,
                ex
            );
            let (cm, cx) = self.cadena_tic;
            info!(
                "carga_j2,cache={=str},tic,cadena_tic: media={} ciclos, max={} ciclos",
                self.cache,
                cm,
                cx
            );
        }
        #[cfg(not(feature = "transporte-tic"))]
        {
            let m = &self.m;
            if m.iter().all(|x| *x == 0) {
                info!("carga_j2,cache={=str}: compilado sin `--features perfil`, los tramos salen en cero", self.cache);
            } else {
                info!(
                    "carga_j2,cache={=str},previo={},armado={},espera={},cierre={},posterior={},isr_spi={},ejecutor={}",
                    self.cache, m[0], m[1], m[2], m[3], m[4], m[5], m[7]
                );
            }
        }
        #[cfg(feature = "transporte-isr")]
        {
            let (sin_cerrar, errores_dma, d) = self.isr;
            info!(
                "carga_j2,cache={=str},isr,sin_cerrar={},errores_dma={}",
                self.cache, sin_cerrar, errores_dma
            );
            if sin_cerrar != 0 {
                info!(
                    "carga_j2,isr,diag: desde_el_armado_us={},sr={:#x},rx_br1={:#x},tx_br1={:#x},en_us={}",
                    d[0], d[1], d[2], d[3], d[4]
                );
            }
        }
    }
}

/// Invalida la I-cache y limpia e invalida la D-cache. Cada una en su funcion, fuera de
/// linea: inlinada en un `main` grande, la constante de `ICIALLU` no ensambla (literal fuera
/// de rango).
#[cfg(all(feature = "tic-fino", feature = "transporte-tic"))]
#[inline(never)]
fn invalida_icache() {
    // SAFETY: nadie mas toca el SCB mientras gira esta pasada.
    unsafe { cortex_m::Peripherals::steal() }.SCB.invalidate_icache();
}

#[cfg(all(feature = "tic-fino", feature = "transporte-tic"))]
#[inline(never)]
fn limpia_invalida_dcache() {
    // SAFETY: igual.
    let mut p = unsafe { cortex_m::Peripherals::steal() };
    p.SCB.clean_invalidate_dcache(&mut p.CPUID);
}

/// Lo que midio una pasada de la salida y el hueco (`mide_salida`).
#[cfg(all(feature = "tic-fino", feature = "transporte-tic"))]
#[derive(Clone, Copy)]
struct Salida {
    fria: bool,
    huecos: u32,
    otros: u32,
    paso_min: u32,
    entrada: (u32, u32),
    tic: u32,
    cadena: (u32, u32),
    plan: u32,
    /// Salida: media, maximo y minimo.
    salida: (u32, u32, u32),
    /// Hueco: media y maximo.
    hueco: (u32, u32),
}

#[cfg(all(feature = "tic-fino", feature = "transporte-tic"))]
impl Salida {
    fn imprime(&self) {
        info!(
            "carga_j2,salida,frio={=bool},gaps={},otros={},paso_min={},entrada=({},{}),tic={},cadena=({},{}),plan={},salida=({},{},{}),hueco=({},{})",
            self.fria,
            self.huecos,
            self.otros,
            self.paso_min,
            self.entrada.0,
            self.entrada.1,
            self.tic,
            self.cadena.0,
            self.cadena.1,
            self.plan,
            self.salida.0,
            self.salida.1,
            self.salida.2,
            self.hueco.0,
            self.hueco.1
        );
    }
}

/// Un hueco es un salto del contador entre dos lecturas seguidas mayor que esto, en ciclos.
#[cfg(all(feature = "tic-fino", feature = "transporte-tic"))]
const UMBRAL: u32 = 200;
#[cfg(all(feature = "tic-fino", feature = "transporte-tic"))]
const HUECOS: u32 = 8_000;

/// El hilo gira en un lazo cerrado sin esperar nada y mide cada hueco que le deja el J2: la
/// salida de la excepcion (del final del planificador a la primera lectura del hilo) y el hueco
/// entero. No imprime nada: un `info!` apaga las interrupciones y retrasaria el tic.
#[cfg(all(feature = "tic-fino", feature = "transporte-tic"))]
#[inline(never)]
fn mide_salida(fria: bool) -> Salida {
    use cortex_m::peripheral::DWT;
    use sam17_nucleo_fw::j2_tic::{cadena_ciclos, ciclos, entrada_ciclos, fin_del_planificador, testigos};
    let _ = (entrada_ciclos(), cadena_ciclos());
    let (c0, tics0) = (ciclos(), testigos().tics);
    let mut prev = DWT::cycle_count();
    let (mut n_plan, _) = fin_del_planificador();
    let (mut huecos, mut otros, mut registrados) = (0u32, 0u32, 0u32);
    let (mut paso_min, mut s_sum, mut s_max, mut s_min) = (u32::MAX, 0u32, 0u32, u32::MAX);
    let (mut h_sum, mut h_max) = (0u32, 0u32);
    while huecos < HUECOS {
        let t = DWT::cycle_count();
        let d = t.wrapping_sub(prev);
        if d > UMBRAL {
            let (p, fin) = fin_del_planificador();
            if p == n_plan {
                // Sin planificador no es del J2: otra interrupcion, o el hilo trayendo su propio
                // codigo despues de invalidar. No cuenta ni invalida otra vez; si invalidara, el
                // hilo frio se mediria a si mismo en cada vuelta (con `368d1ac`, 7 061 de 8 000).
                otros += 1;
                prev = t;
                continue;
            }
            huecos += 1;
            if p.wrapping_sub(n_plan) == 1 {
                let s = t.wrapping_sub(fin);
                registrados += 1;
                s_sum = s_sum.wrapping_add(s);
                s_max = s_max.max(s);
                s_min = s_min.min(s);
                h_sum = h_sum.wrapping_add(d);
                h_max = h_max.max(d);
            } else {
                otros += 1;
            }
            n_plan = p;
            if fria {
                invalida_icache();
                limpia_invalida_dcache();
            }
            prev = DWT::cycle_count();
        } else {
            paso_min = paso_min.min(d);
            prev = t;
        }
    }
    let entrada = entrada_ciclos();
    let cadena = cadena_ciclos();
    let (c1, tics1) = (ciclos(), testigos().tics);
    let dt = tics1.wrapping_sub(tics0).max(1);
    let n = registrados.max(1);
    Salida {
        fria,
        huecos,
        otros,
        paso_min,
        entrada,
        tic: c1[0].wrapping_sub(c0[0]) / dt,
        cadena,
        plan: c1[1].wrapping_sub(c0[1]) / dt,
        salida: (s_sum / n, s_max, if registrados == 0 { 0 } else { s_min }),
        hueco: (h_sum / n, h_max),
    }
}

#[embassy_executor::main]
async fn main(spawner: Spawner) {
    #[cfg(feature = "reloj-hub")]
    let config = usb::configuracion_hub();
    #[cfg(not(feature = "reloj-hub"))]
    let config = usb::configuracion();
    let f_cpu = usb::f_cpu_hz(&config);
    let p = usb::iniciar(config);
    let cfg = Config {
        f_sck_hz: 10_000_000,
        f_cpu_hz: f_cpu,
        retardo_tsck_cuartos: 4,
    };
    let ranuras = ranuras_de_medida!(p, cfg);
    // La imagen de las TCM se copio en `pre_init`; aqui se comprueba.
    #[cfg(feature = "j2-tcm")]
    sam17_nucleo_fw::j2_tcm::comprueba();

    perfil::iniciar();
    let f_cpu_medido = perfil::f_cpu_medido_hz().await;
    spawner.spawn(defmt::unwrap!(vueltas_del_hilo()));
    #[cfg(feature = "contaminador")]
    spawner.spawn(defmt::unwrap!(contaminador()));
    let pasadas: &[&'static str] = if cfg!(feature = "reloj-hub") {
        if cfg!(feature = "transporte-tic") {
            &["no", "icache", "icache+dcache-mpu"]
        } else {
            &["no", "icache", "icache+dcache-sin-mpu"]
        }
    } else {
        &["no", "icache"]
    };
    // Una base por estado de cache, con el J2 sin arrancar: la CPU entera en cada uno.
    let mut medidores: [Option<Medidor>; 3] = [None, None, None];
    for (i, &cache) in pasadas.iter().enumerate() {
        encender_cache(cache);
        medidores[i] = Some(Medidor::calibrar(500).await);
    }
    apagar_caches();
    info!(
        "carga_j2: firmware {}, f_cpu {} Hz, f_cpu_medido {} Hz, periodo {} us, base {} vueltas/s, transporte {=str}",
        env!("SAM17_GIT"),
        f_cpu,
        f_cpu_medido,
        PERIODO_US,
        medidores[0].as_ref().map_or(0, |m| m.base_por_s()),
        if cfg!(feature = "transporte-isr") {
            "isr"
        } else if cfg!(feature = "transporte-tic") {
            match (cfg!(feature = "sin-componer"), cfg!(feature = "contaminador")) {
                (false, false) => "tic",
                (true, false) => "tic-sin-componer",
                (false, true) => "tic-contaminado",
                (true, true) => "tic-sin-componer-contaminado",
            }
        } else {
            "ejecutor"
        }
    );

    #[cfg(not(any(feature = "transporte-isr", feature = "transporte-tic")))]
    lanzar_ranuras(
        iniciar_ejecutor(interrupt::GFXTIM),
        ranuras,
        bajada_del_banco,
        juez_del_banco,
        PERIODO_US,
    );
    // Con `con-usb`, el USB del instrumento (el mismo `atender` de `main.rs`, con su lazo de 1 ms)
    // gira junto al J2: lo que le impone al tic se ve en los testigos (#443).
    #[cfg(feature = "con-usb")]
    {
        use sam17_nucleo_core::partes::{Parte, Partes, Repartidor};
        use sam17_nucleo_core::servidor::Instrumento;
        static INSTRUMENTO: static_cell::StaticCell<Instrumento> = static_cell::StaticCell::new();
        const PARTE: [Parte; 1] = [Parte {
            canal: 0,
            nota_min: 0,
            nota_max: 127,
            voces: 4,
            primera_voz: 0,
            preset: 0,
        }];
        let partes = Partes::from_slice(&PARTE).expect("la parte no cabe");
        let instrumento = INSTRUMENTO
            .init(Instrumento::con_medidas().con_partes(partes, Repartidor::nueva(4)));
        let puertos = usb::montar(usb::driver(p.USB1_OTG_HS));
        spawner.spawn(defmt::unwrap!(usb::correr_usb(puertos.dispositivo)));
        spawner.spawn(defmt::unwrap!(usb::atender(puertos.midi, instrumento)));
        // `atender` imprime cuando el PC configura el dispositivo, y un `info!` apaga las
        // interrupciones: el J2 arranca cuando el PC ya ha tenido tiempo de enumerarlo, para que
        // esa linea no caiga en los testigos.
        Timer::after_secs(5).await;
    }
    #[cfg(feature = "transporte-tic")]
    {
        let (base, largo) = sam17_nucleo_fw::j2_tic::region();
        info!("carga_j2: region no cacheable {:#x}, {} bytes", base, largo);
        // El juez: el de verdad con `crc-sobre`; si no, el del banco, o el mismo con el CRC del
        // sobre de la subida calculado aparte (`crc-bits`, `crc-tabla`, `crc-unidad`).
        #[cfg(feature = "crc-unidad")]
        {
            sam17_nucleo_fw::j2_banco::prepara_crc_unidad();
            info!("carga_j2: la unidad CRC da el CRC-16/CCITT-FALSE (0x29B1 y largos 0 a 71)");
        }
        #[cfg(feature = "crc-sobre")]
        {
            sam17_nucleo_fw::j2_banco::prepara_registro_banco();
            info!("carga_j2: el juez decodifica el sobre de un registro de 24 bytes");
        }
        let juez: fn(usize, &[u8]) -> bool = if cfg!(feature = "crc-sobre") {
            sam17_nucleo_fw::j2_banco::juez_sobre_sin_modulo
        } else if cfg!(feature = "crc-bits") {
            sam17_nucleo_fw::j2_banco::juez_crc_bits
        } else if cfg!(feature = "crc-tabla") {
            sam17_nucleo_fw::j2_banco::juez_crc_tabla
        } else if cfg!(feature = "crc-unidad") {
            sam17_nucleo_fw::j2_banco::juez_crc_unidad
        } else {
            juez_del_banco
        };
        sam17_nucleo_fw::j2_tic::lanzar(ranuras, p.TIM7, PERIODO_US, f_cpu, BAJADA, juez);
    }
    #[cfg(feature = "transporte-isr")]
    {
        let [r0, ..] = ranuras;
        sam17_nucleo_fw::j2_isr::lanzar(
            defmt::unwrap!(r0),
            p.TIM7,
            PERIODO_US,
            bajada_del_banco,
            juez_del_banco,
        );
    }

    // R-H2: cuanto dura cada seccion critica y quien la abre, en la muestra que vale de cada
    // pasada; 5 us es el tope.
    #[cfg(feature = "secciones")]
    let mut secciones: [Option<sam17_nucleo_core::secciones::Tabla>; 3] = [None; 3];

    let mut promedios = Promedios::nuevo();
    let mut giros_antes = 0u32;
    #[cfg(feature = "transporte-tic")]
    let mut ciclos_antes = sam17_nucleo_fw::j2_tic::ciclos();
    #[cfg(feature = "transporte-tic")]
    let mut tics_antes = 0u32;
    let mut guardadas: [Option<Pasada>; 3] = [None; 3];
    for (i, &cache) in pasadas.iter().enumerate() {
        encender_cache(cache);
        let medidor = defmt::unwrap!(medidores[i].as_mut());
        // La primera muestra de cada pasada absorbe el arranque o el cambio de
        // cache; la segunda es la que vale.
        for muestra in 0..2 {
            #[cfg(feature = "secciones")]
            if muestra == 1 {
                sam17_nucleo_fw::secciones::reinicia(5 * (f_cpu / 1_000_000));
            }
            Timer::after_secs(MUESTRA_S).await;
            #[cfg(feature = "secciones")]
            if muestra == 1 {
                secciones[i] = Some(sam17_nucleo_fw::secciones::toma());
            }
            let (mut giros, mut atrasos, mut plazos) = (0u32, 0u32, 0u32);
            for n in 0..RANURAS_SPI {
                let c = cuentas(n);
                giros = giros.wrapping_add(c.giros);
                atrasos = atrasos.wrapping_add(c.atrasos);
                plazos = plazos.wrapping_add(c.plazos_vencidos);
            }
            // El transporte por ISR no alimenta los contadores de la politica con sus
            // fallos: los giros que no cerro y los errores del DMA cuentan como plazos.
            #[cfg(feature = "transporte-isr")]
            let (sin_cerrar, errores_dma) = sam17_nucleo_fw::j2_isr::fallos();
            #[cfg(feature = "transporte-isr")]
            {
                plazos = plazos.wrapping_add(sin_cerrar).wrapping_add(errores_dma);
            }
            let libre = medidor.libre_por_mil();
            let dg = giros.wrapping_sub(giros_antes);
            giros_antes = giros;
            let (m, _) = promedios.tomar(giros);
            #[cfg(feature = "transporte-tic")]
            let (tic, isr_tic) = {
                let ahora = sam17_nucleo_fw::j2_tic::ciclos();
                let t = sam17_nucleo_fw::j2_tic::testigos();
                let dt = t.tics.wrapping_sub(tics_antes).max(1);
                tics_antes = t.tics;
                let mut c = [0u32; 7];
                for k in 0..7 {
                    c[k] = ahora[k].wrapping_sub(ciclos_antes[k]) / dg.max(1);
                }
                let media = ahora[0].wrapping_sub(ciclos_antes[0]) / dt;
                ciclos_antes = ahora;
                ((c, t), (media, sam17_nucleo_fw::j2_tic::tic_max_ciclos()))
            };
            if muestra == 0 {
                continue;
            }
            guardadas[i] = Some(Pasada {
                cache,
                ciclo_us: (MUESTRA_S * 1_000_000) as u32 * RANURAS_ACTIVAS / dg.max(1),
                giros: dg,
                libre,
                atrasos,
                plazos,
                base: medidor.base_por_s(),
                m,
                #[cfg(feature = "transporte-isr")]
                isr: (sin_cerrar, errores_dma, sam17_nucleo_fw::j2_isr::diagnostico()),
                #[cfg(feature = "transporte-tic")]
                tic,
                #[cfg(feature = "transporte-tic")]
                isr_tic,
                #[cfg(feature = "transporte-tic")]
                entrada_tic: sam17_nucleo_fw::j2_tic::entrada_ciclos(),
                #[cfg(feature = "transporte-tic")]
                cadena_tic: sam17_nucleo_fw::j2_tic::cadena_ciclos(),
                #[cfg(feature = "transporte-tic")]
                f_cpu_mhz: f_cpu / 1_000_000,
            });
        }
    }
    // La pasada de la salida y el hueco, en el regimen que dejo la ultima pasada (la ultima de
    // `pasadas`: con `reloj-hub` y `transporte-tic`, `icache+dcache-mpu`). Nada se imprime
    // hasta que acaban las dos.
    #[cfg(all(feature = "tic-fino", feature = "transporte-tic"))]
    let salidas = [mide_salida(false), mide_salida(true)];
    for pasada in guardadas.into_iter().flatten() {
        pasada.imprime();
    }
    #[cfg(all(feature = "tic-fino", feature = "transporte-tic"))]
    for r in salidas {
        r.imprime();
    }
    #[cfg(feature = "secciones")]
    for (t, cache) in secciones.iter().zip(pasadas) {
        if let Some(t) = t {
            sam17_nucleo_fw::secciones::imprime(t, cache, f_cpu / 1_000_000);
        }
    }
    // Lo que dijo el juez en toda la corrida: que la politica recorrio el camino que se cree.
    for n in 0..RANURAS_SPI {
        let c = cuentas(n);
        info!(
            "carga_j2: ranura {} subidas_ok={} subidas_malas={}",
            n, c.subidas_ok, c.subidas_malas
        );
    }
    info!("carga_j2: fin");
    // Un `bkpt` para que `probe-rs run` termine solo y suelte la sonda.
    cortex_m::asm::bkpt();
    loop {
        Timer::after_secs(60).await;
    }
}
