sssamuelll/analog-modular-synthesizer/software/nucleo/fw/src/main.rs

#![no_std]
#![no_main]

//! El firmware del cerebro del SAM17 sobre STM32N657.
//!
//! Capa DELGADA a proposito: si una funcion de aqui merece un test, es que
//! vive en la caja equivocada y se muda a `sam17-nucleo-core`. Todo lo que se
//! puede probar sin placa ya viene probado de alla.

use defmt::info;
use embassy_executor::Spawner;
use sam17_nucleo_core::descubrimiento::{placa_de, voces_del_instrumento, TIPO_VCO4};
use sam17_nucleo_core::partes::{Parte, Partes, Repartidor};
use sam17_nucleo_core::pinout::{N_PINES_USADOS, PINOUT};
use sam17_nucleo_core::servidor::{Instrumento, VERSION_PROTOCOLO};
use sam17_nucleo_fw::usb;
use static_cell::StaticCell;
use {defmt_rtt as _, panic_probe as _};

static INSTRUMENTO: StaticCell<Instrumento> = StaticCell::new();

/// HUECO: tabla mínima de partes mientras no existe el descubrimiento real.
/// `docs/architecture-poly.md:567` declara cuatro canales SSI2130 y el catálogo
/// de `core/src/descubrimiento.rs:111-138` los identifica con `TIPO_VCO4`; al
/// aplicar la regla del mínimo de la cadena, esa única placa da cuatro voces.
/// El papel no fija canal, rango ni preset, así que se declara una sola parte
/// operativa: canal 0, todo el rango MIDI y preset 0.
///
/// La sustituye el descubrimiento por EEPROM (#175). Borrar esta constante
/// cuando ese descubrimiento exista.
const TABLA_DE_PARTES_PROVISIONAL_HASTA_DESCUBRIMIENTO_EEPROM_175: [Parte; 1] = [Parte {
    canal: 0,
    nota_min: 0,
    nota_max: 127,
    voces: 4,
    primera_voz: 0,
    preset: 0,
}];

#[embassy_executor::main]
async fn main(spawner: Spawner) {
    // El N657 no arranca con la configuracion por defecto: el reloj de
    // referencia del PHY de USB y el modo de alimentacion se eligen ANTES de
    // `init`. Los dos viven en `usb.rs` con su cita, porque los dos son del
    // borde de USB.
    let p = embassy_stm32::init(usb::configuracion());

    info!(
        "SAM17: el cerebro arranco, protocolo v{}",
        VERSION_PROTOCOLO
    );
    info!("{} pines en el mapa", N_PINES_USADOS);
    for pin in PINOUT.iter() {
        defmt::debug!("GPIO{}: {}", pin.gpio, pin.para);
    }

    let vco = placa_de(TIPO_VCO4).expect("TIPO_VCO4 no está en el catálogo");
    let n_voces = voces_del_instrumento(&[vco]);
    assert_eq!(
        n_voces, TABLA_DE_PARTES_PROVISIONAL_HASTA_DESCUBRIMIENTO_EEPROM_175[0].voces,
        "la tabla provisional y el catálogo discrepan"
    );
    let partes = Partes::from_slice(&TABLA_DE_PARTES_PROVISIONAL_HASTA_DESCUBRIMIENTO_EEPROM_175)
        .expect("la tabla provisional de partes no cabe");
    info!(
        "HUECO: tabla de partes provisional declarada: {} parte, {} voces; la sustituye EEPROM #175",
        partes.len(),
        n_voces
    );

    let instrumento =
        INSTRUMENTO.init(Instrumento::con_medidas().con_partes(partes, Repartidor::nueva(n_voces)));
    info!(
        "sin descubrimiento todavia: {} parametros, todos de medida",
        instrumento.modelo().len()
    );

    let puertos = usb::montar(usb::driver(p.USB1_OTG_HS));
    spawner.spawn(usb::correr_usb(puertos.dispositivo).unwrap());
    spawner.spawn(usb::atender(puertos.midi, instrumento).unwrap());
}
