sssamuelll/analog-modular-synthesizer/hardware/02-midi-cv/pio_budget.py

"""Que cabe en el cerebro: maquinas de PIO, memoria de instrucciones, canales
de DMA, pines — y el reloj que el host USB le puede robar al afinado.

    python pio_budget.py

POR QUE ESTE GUION EXISTE

  Este proyecto tiene presupuestos ejecutables para el ancho del panel, los
  umbrales de sync, la corriente por riel, el flanco del enlace, la afinacion y
  las masas. No tenia ninguno para **lo unico que de verdad va a escasear en el
  cerebro**: las doce maquinas de estado del PIO, los pines, y el reloj de
  sistema.

  Y lo que lo hace urgente no es el conteo. Es que `clk_sys` tiene dos duenos
  que no se conocen:

    * `autotune_budget.py` fija F_PIO = 150 MHz y **todo el presupuesto de
      afinacion cuelga de ahi**: el sellado de un tick del PIO son 6.67 ns, y de
      ahi salen los 131 ns que el 74HC14 tiene permitido temblar.
    * Pico-PIO-USB bit-banguea el host USB y **puede imponer el reloj de
      sistema** para cumplir el temporizado de USB.

  Dos funciones, un solo `clk_sys`, y cada spec asume que es suyo. El dia que el
  host fije otro reloj, los 131 ns se mueven **sin que nadie haya tocado el
  afinado** — el presupuesto del que mas orgulloso esta este diseno, invalidado
  por una decision tomada en otro documento. Este guion pone esa colision en un
  assert.

  Issue #150. La spec del cerebro lo declara en su sec.11 con este nombre.

  ENMIENDA 2026-08-26 -- Y PASO ALGO QUE NADIE HABIA PREVISTO: el assert salto,
  pero no porque el host cambiara el reloj. Salto porque **el afinado se fue a
  otro chip**. Los dieciseis cronometros son hoy capturas de TIM del STM32N657
  del modulo de Voz (motor-digital §7), no PIO del cerebro.

  Asi que la colision del #150 no se resolvio: **se disolvio**. Dos relojes en
  dos silicios distintos no pelean por nada. El guion sigue vivo y sigue
  midiendo el cerebro, pero esa comparacion concreta pasa a HUECO declarado —
  aseverar los 150 MHz del host contra si mismos seria un verde de mentira
  (Principio VIII). Lo que sobrevive del #150 esta escrito en el bloque del
  reloj, mas abajo, y no es poco: el requisito real de Pico-PIO-USB sigue sin
  leerse.

  Y hay una moraleja para el repo, porque el import hizo su trabajo: la spec
  del cerebro sec.11 exigio "ninguno reescribe autotune_budget.py: lo importa,
  para que los 131 ns se enteren si algo se mueve". Se movio algo MAS GRANDE
  que un numero, y el import lo caso igual.

POR QUE LOS PINES ESTAN AQUI Y NO EN SU PROPIO GUION

  Porque **la ventana de 32 GPIO ata las dos cosas a la vez**. Un programa de
  PIO no falla por pedir demasiadas maquinas: falla porque sus pines cayeron a
  los dos lados de la frontera del GPIO 32, y entonces la maquina no alcanza el
  pin. Ese fallo no se ve censando maquinas ni censando pines por separado —
  solo se ve mirando las dos cosas juntas.

  Asi que este guion cubre tres de las cuatro comprobaciones que sec.11.1 le
  pide a `check_pinout.py`: capacidad, ventana de PIO y GPIO libres. La cuarta
  —que cada pin pueda hacer lo que se le pide, contra la tabla de funciones por
  GPIO del datasheet— NO esta aqui, y queda dicha abajo en lo que NO cubre.

  **Lo que este guion NO es: no es `pines_budget.py`.** Conviene decirlo porque
  el nombre invita a confundirlos y estuvo a punto de pasar. Ese otro guion sale
  de dieciseis sec.15 y presupuesta **los dos micros del modulo de Voz** — su
  propia ficha lo delata con la cifra: *«16 de 24 maquinas de PIO»*, y 24 son
  2 x 12, o sea dos chips. Aquel reparto y este no comparten ni pines, ni reloj,
  ni inquilinos: son dos RP2350B distintos. Fundirlos habria metido el reparto
  de dos silicios en un solo censo, y el primero que lo leyera habria tenido que
  deshacerlo. Los dos guiones hacen falta y son hermanos, no duplicados.

  El del micro de Voz esta mandado en papel (enlace sin jefe sec.9, y el riesgo
  4 de dieciseis) y su censo esta **mas apretado que este**: issue #205.

LO QUE MIDE, Y CONTRA QUE

  Mide el **artefacto**, no la intencion: los pines los lee de
  `software/nucleo/core/src/pinout.rs`, no de una copia en Python. Si alguien
  anade un pin alli, este guion se entera. Esa es la leccion del #139 y la razon
  por la que sec.11.1 insiste en que una puerta que compara la propuesta consigo
  misma no es una puerta.

  Lo que no puede leer de ningun artefacto —cuantas instrucciones ocupa cada
  programa de PIO, y que reloj exige Pico-PIO-USB— se DECLARA con su fuente o
  se marca ESTIMADO, y se asevera contra el valor declarado. Asi el guion falla
  el dia que alguien lo cambie sin mirar el resto.
"""
from __future__ import annotations

import os
import re
import sys

_AQUI = os.path.dirname(os.path.abspath(__file__))
sys.path.insert(0, _AQUI)
import autotune_budget as ab  # noqa: E402
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
