sssamuelll/analog-modular-synthesizer/(commit log)

2026-04-16 Build project skeleton from thesis
    Bootstraps the SAM17 modular synthesizer project around the documents that
    arrived in the initial commit. The thesis (docs/thesis.pdf) is parsed into a
    reproducible structure that lets the seven modules (Power, MIDI/CV, VCO,
    Mixer, VCF, ADSR, VCA) be developed and improved in isolation while sharing
    a common architecture.
    - Documentation: summary, references, user manual, architecture and a
    per-module deep-dive under docs/modules/.
    - Hardware: directory per module with README, BOM (preliminary, sourced from
    the thesis cost tables) and placeholders for KiCad/schematics/PCB/notes.
    - Firmware (software/midi-cv/): modern Python rewrite of the original Pi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
    [bom.csv]
2026-04-16 Add design notes for power supply module
    Deep-dive on module 1 (power supply) before the KiCad capture step. Fixes
    reference numbers and gotchas the original thesis glosses over.
    - Current budget per rail derived from each chip's datasheet (TI LM13700,
    ADI AD5686R, CEM3340 community references, Pi 3B+ measurements).
    - Architecture decision: keep the thesis approach of a dedicated 5V USB
    adapter for the Pi so analog rails stay clean. Two alternatives
    (all-in-one, Eurorack-compatible) explicitly ruled out here for scope.
    - Thermal math on the 7812/7912: ~1.5 W dissipation at 300 mA, Tj ~ 60 °C
    with a standard TO-220 heatsink.
    - Incremental safety improvements over the thesis: primary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
    [bom.csv]
2026-04-16 Resolve power supply open questions: keep +5V, add NTC and MOV
    Closes the three open questions from §10 of the design notes:
    1. +5V rail is kept on the analog PCB. Even with the Pi powered separately,
    the AD5686R (DAC) and the 16x2 LCD still need 5V. Budget: ~150 mA worst
    case (LCD backlight dominant). 7805 dissipates ~1.8 W from the +17 V
    bulk; Tj ~ 70 C with a standard heatsink. Layout note added: keep the
    +5V return separate from the analog return until the star ground point
    so backlight current does not bounce into the audio plane.
    2. Soft-start NTC included. SL10-5R020 (5 ohm cold, 2 A continuous) in
    series with the AC primary. Limits the inrush from ~9.4 mF of bulk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
    [bom.csv]
2026-08-12 Recover MIDI/CV firmware behavior from the thesis PDF
    The software skeleton shipped with stub modes and an empty tuning.json —
    main() returned "hardware bring-up not implemented" and the DAC had no
    calibration to send. Extracted the thesis's software chapter (pages 50-69,
    plain text, no code appendix) plus the VCO voltage table (Table 11) to
    reconstruct what the PDF never showed in full: the main loop, the tune
    mode's up/down/enter handling, and a 1V/oct calibration curve derived from
    the thesis's note_res=460 constant.
    docs/thesis-software.md tracks what was recovered verbatim vs. rebuilt,
    including four original bugs intentionally not replicated.
2026-08-12 Add module 1 (power supply) KiCad schematic
    Generates the ±12V rail schematic (rectifier, LM7812/LM7912, DC
    protection, rail LEDs) as a real KiCad 10 project via KiCAD-MCP-Server,
    wired with actual pin-to-pin wires rather than net labels so the sheet
    reads like a hand-drawn schematic. Reproducible: build_schematic.py
    regenerates the .kicad_sch from scratch, and hardware/tools/ documents
    the local MCP server setup it depends on.
    ERC clean (0 violations), netlist verified against design-notes.md's
    topology. Known gap, called out in the module README: the +5V rail
    (7805), NTC soft-start, and primary MOV from design-notes.md §10 are
    resolved decisions but not yet drawn on this sheet.
2026-08-12 Add +5V rail, primary-side protection, and EU 230V variant to module 1
    Three additions to the power supply schematic, bundled together:
    - +5V rail (LM7805) for the MIDI/CV module's DAC and LCD, matching
    design-notes.md §10.1.
    - Primary-side fuse/MOV/NTC soft-start protection (§10.2/§10.3), moved
    F1 to where it actually belongs (primary, not secondary — protects
    against a fault reflected from the secondary, per the design note).
    - Adapted the primary stage for European mains (230VAC/50Hz) instead
    of the thesis's original Venezuelan 110VAC/60Hz: MOV swapped from
    V150LA20A (150V, fails on 230V mains) to S20K275 (275V, verified
    against the actual voltage-vs-part-number relation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
2026-08-14 Add protective earth to module 1 and make the BOM verifiable
    Closes the two documented gaps in the power-supply module, plus several
    defects found while closing them.
    Protective earth (design-notes.md section 13). J3 becomes a 3-position
    block (L/N/PE); pin 3 drives an Earth_Protective symbol and stops there.
    J5 is a new faston that carries circuit 0 V to the same chassis stud. PE
    and GND stay separate nets on purpose - they meet in metal, off the
    board, so fault current never runs through PCB copper.
    The bond is hard rather than a ground-lift network because the panels are
    galvanized sheet and the ~40 metal-bushing jacks already tie chassis to
    GND at 40 points; a lift network would be sho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
2026-08-14 Route +5V off the board via a dedicated J6 feed (closes the bus interface)
    Resuelve issue #8 con la opcion C: J2 queda intacto como bus analogico
    (+12/GND/GND/-12, igual para los modulos 2-7) y el +5V sale por J6, un
    conector de 2 posiciones fisicamente distinto, solo hacia el modulo 2
    (AD5686R + LCD, ~150 mA).
    Por que C y no el header 2x5 del BOM viejo (design-notes.md 10.4):
    - 10.1 ya exigia retorno del +5V dedicado hasta el punto de estrella,
    porque el backlight va conmutado por PWM: ~100 mA de flancos sobre un
    retorno compartido son mV de rebote en la referencia del DAC (a 1 V/oct,
    1 mV ~ 1.2 cents en el CV). Con conector propio la separacion es el
    conector, no una convencion d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
2026-08-14 Assign footprints to module 1 and pin down the PCB ground rules
    Fase 1 de la placa: sin huella no hay placa que crear. Los 33 componentes
    quedan mapeados y verificados contra disco en cada build.
    Tres huellas no las trae KiCad 10 y van en kicad/sam17.pretty:
    - RV_Disc_D21mm_W5.5mm_P10.0mm: Varistor.pretty llega a D12 y el S20K275
    es un disco de 20 mm.
    - NTC_Disc_D11.5mm_W4.5mm_P7.5mm: no hay libreria de termistores THT.
    - Faston_6.3x0.8mm_PCB_2Leg_P5.0mm: no hay ningun faston de PCB. Lleva las
    dos patillas como el MISMO pad 1 — el simbolo de J5 tiene un pin, pero
    eso conduce corriente de falla (sec.13) y necesita las dos por resistencia
    mecanica y seccion de cobre. Es el truco qu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
2026-08-14 Validate footprints before truncating the schematic
    El commit anterior se llevo un sam17-power.kicad_sch VACIO (711 bytes, cero
    componentes) sin que nada avisara.
    Causa: create_schematic trunca el fichero nada mas empezar, y mis dos asserts
    de huellas corrian despues. Al probar la comprobacion rompiendo un nombre a
    proposito, el run aborto con la hoja ya truncada y ese fue el fichero que
    entro en el commit. Una hoja vacia ademas pasa el ERC con 0 avisos, asi que
    tampoco chilla por ahi.
    Arreglo: las dos comprobaciones son Python puro y no necesitan servidor, asi
    que se van a check_footprints(), que corre ANTES de tocar el fichero. Probado:
    con un nombre de huella roto el script sale con cod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
2026-08-14 Place module 1 PCB with a measured mains isolation barrier
    Fase 2: contorno, ranura de barrera, redes, reglas y colocacion. La placa
    queda en 100 x 150 mm y dos capas — el ancho es el borde del tier barato de
    fabricacion, el alto salio de la colocacion.
    build_pcb.py va con pcbnew DIRECTO, al reves que build_schematic.py. El
    sync_schematic_to_board del MCP solo resuelve redes de etiquetas locales: de
    las 16 de esta hoja sacaba 9 y dejaba sin asignar GND, +12V, -12V, +5V y PE,
    que son las que vienen de simbolos de potencia. Una placa sin GND no hay por
    donde rutearla. El netlist de kicad-cli si sale entero, asi que se parsea.
    El script comprueba y aborta antes de guardar: pads sin red, pie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
2026-08-14 Drop the stray _probe project file from the PCB commit
    _probe.kicad_pro lo dejo una prueba de la API de pcbnew y entro en el commit
    anterior por un git add -A. No es del diseno. Al .gitignore van tambien los
    informes .rpt de ERC/DRC, que son salida de herramienta.
2026-08-14 Route module 1 PCB as a verified star ground, no copper pour
    Fase 3: la placa queda ruteada entera. DRC de KiCad 0 infracciones y 0 pads
    sin conectar. Dos capas, F para carriles y lado de red, B para el arbol de
    masa y los bajantes, una sola via en toda la placa.
    NO HAY PLANO DE MASA y es a proposito. Un pour une todo con todo por el camino
    mas corto, o sea lo contrario de la estrella de sec.7 y del retorno dedicado
    de sec.10.1. GND es un arbol que sale de C1.2 (el bulk del riel positivo) y
    cada rama muere en su grupo funcional. El retorno del +5V (J6.2) sube por el
    canto derecho, la unica columna sin ramas, y entra a la estrella por su propia
    via sin tocar ninguna otra.
    Que la masa sea un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
2026-08-14 Export fab files for module 1 with the mains slot verified
    Fase 4: gerbers y taladros en fab/, mas la nota para quien mande a fabricar.
    Solo las seis capas que hace falta mandar. La primera exportacion sacaba 27
    ficheros, casi todos capas vacias (adhesivo, pasta, patios, User_1..4) que en
    una placa de agujero pasante no son mas que ruido para el fabricante.
    Comprobado que la ranura de la barrera SI esta en el Edge_Cuts: el gerber
    tiene vertices en x = 0, 29, 31 y 100, o sea el contorno exterior y el
    contorno cerrado de la fresa. Si eso no viaja, el fabricante entrega una placa
    sin barrera y con 230 V a un lado.
    fab/README.md abre con el aviso de BR1 porque es una puerta antes de pedir la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
2026-08-14 Simulate module 1 dropout margin and pin down the transformer spec
    Responde a "¿ya se simulo?": no se habia simulado nada — simulations/power
    tenia solo un .gitkeep. Lo unico que existia eran cuentas a mano.
    Es la unica cuenta del modulo que no se cierra a mano: con filtro de entrada
    capacitiva la corriente por el secundario circula en picos estrechos de 2-3
    veces la continua, asi que la caida en la resistencia del devanado es mucho
    peor que corriente media por resistencia.
    EL RESULTADO. A red nominal sobra margen (+1.6 a +2.5 V). A 207 V — la red al
    -10%, dentro de la tolerancia europea — y a plena carga de diseno, hace falta
    un transformador con regulacion >= 10.7%. Por debajo, el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
2026-08-14 Decide the 650 mA/rail architecture: LDO, not a higher secondary
    Objetivo: 650 mA por riel, la corriente de la Doepfer A-100NT12 (su generacion
    lineal), con mejor ruido que su PSU3 actual — que es conmutada y arrastra
    quejas de ruido de alta frecuencia en los foros de modular.
    El diseno actual NO llega: a 650 mA y 207 V el margen es -1.00 V y pediria un
    transformador con 40.7% de regulacion, que no existe. Agrandar el bulk de 4700
    a 15000 uF solo recupera 0.44 V y sigue negativo.
    EL RESULTADO CONTRAINTUITIVO: subir el secundario a 15-0-15 da margen de sobra
    (+2.66 V) pero casi DUPLICA el calor, 6.34 W contra 3.76, y obliga a
    disipadores de 4 C/W. Bajar el dropout hace lo contrario: mismo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
2026-08-14 Add architecture comparison with thermal model to the PSU simulation
    Compara fuentes enteras — transformador, reguladores y carga — en las tres
    esquinas que importan: red baja (dropout), red alta (calor) y nominal. Una
    arquitectura puede ganar en una y perder en otra, que es justo lo que paso con
    el secundario de 15-0-15: daba margen de sobra y casi duplicaba la disipacion.
    La termica incluye ahora 1 C/W de la mica aislante, que antes faltaba. El tab
    de un regulador negativo no esta a masa, asi que hay que aislarlo del
    disipador y eso suma resistencia termica.
    Con eso la tabla queda:
    HOY 12-0-12 2A, 78xx @207V +0.08V 1.83W Tj 73C (20 C/W)
    650 12-0-12 3A, 78xx @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
2026-08-14 Verify the 650 mA part selection against primary datasheets
    Doce agentes en paralelo sobre datasheets primarios, con refutacion
    adversarial de los tres pinouts — que son lo unico que destruye piezas si sale
    mal. Reescribe la sec.16 entera y anade la sec.17 con lo que NO se confirmo.
    LA CORRECCION QUE CASI SE CUELA: el criterio no es el dropout. El LM2940-12
    especifica VIN >= 13.6 V garantizado sobre temperatura (TI SNVS769J), que no
    es lo mismo que 12 + dropout = 13.0 V. Yo estaba disenando contra 13.0 y la
    simulacion daba 13.53: fallaba por 70 mV sin que se notara. 13,5 y 13,6
    parecen el mismo numero y no lo son.
    Los dos reguladores salen sustitucion DIRECTA, contra lo que yo temia:
    - U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
2026-08-14 Respin module 1 schematic to LDO regulators at 650 mA/rail
    Esquematico de 33 a 45 componentes. ERC 0/0, 109/109 cables con extremo
    exacto, check_bom.py cuadra (45 en hoja / 52 designadores).
    REGULADORES. U1 pasa a LM2940CT-12 y U2 a LM2990T-12, los dos sustitucion
    directa: mismo pinout y mismo encapsulado. U1 ni siquiera cambia de simbolo —
    el del LM2940 no existe en KiCad pero el del 7812 tiene el mismo mapeo.
    Lo que si cambio fue la GEOMETRIA del simbolo del LM2990: misma numeracion de
    pines que el 7912 pero dibujado distinto — los de potencia a +-10.16 del ancla
    en vez de +-7.62, y el de masa DEBAJO del cuerpo en vez de encima. La
    comprobacion de extremos exactos lo canto en el prim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
2026-08-14 Re-lay out module 1 PCB for the LDO respin: 150x200, rail columns
    La placa pasa de 100x150 a 150x200. No es capricho: los disipadores pasan de
    25x25 a 42x38 (Fischer SK 129/38,1) y tres en fila piden 136 mm de ancho.
    DOS DECISIONES DE MAQUETA:
    1) La franja de red pasa de columna VERTICAL a la izquierda a fila HORIZONTAL
    arriba, y la barrera con ella. Con la franja vertical harian falta 175 mm de
    ancho (27 de franja + 6 de barrera + 136 de disipadores); en horizontal
    caben en 150.
    2) Los tres carriles pasan de filas horizontales a COLUMNAS VERTICALES, cada
    una justo encima de su regulador. En filas, el carril de -12 V tenia que
    cruzar la placa entera para llegar a su regulad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
2026-08-14 Route the 650 mA PCB: 226 segments, star ground, DRC clean
    DRC de KiCad: 0 infracciones, 0 pads sin conectar, 0 errores de huella. Y los
    verificadores propios en cero: cruces, pistas sobre pads ajenos, bucles de
    masa, solapes, piezas fuera de margen y piezas sobre la ranura.
    226 segmentos, 85 tramos, UNA sola via en toda la placa. La via es la del
    retorno dedicado del +5 V, que sube por el canto derecho — la unica columna sin
    ramas de masa — y entra a la estrella sin haber tocado ninguna otra rama.
    Sigue sin haber plano de masa, y sigue siendo a proposito: un pour une todo con
    todo por el camino mas corto, que es lo contrario de la estrella de sec.7. GND
    es un arbol de tres ramas (una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
2026-08-15 Bus board a 1.21 cents y frente de zumbido cuantificado
    Cierra los frentes 3 y 4 del plan de mejoras.
    FRENTE 3 — bus board (hardware/bus-board/)
    Placa nueva, 320x60 mm, 2 capas, dos segmentos identicos de 6 slots.
    Sustituye al daisy-chain con jumpers de la tesis.
    El problema no era de corriente sino de AFINACION: a 1 V/octava, 1 mV de
    diferencia de masa entre dos modulos son 1.2 cents de error de tono.
    Objetivo <=2 cents en la cadena MIDI/CV + VCO1..3.
    ground_budget.py lo calcula y se rompe en voz alta si alguien toca un
    ancho de cobre o una longitud de cable. Resultado: 1.21 cents.
    Lo que destapo el calculo y no era la intuicion de partida:
    * El plano de masa aporta 0.20 cents. Ca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
2026-08-15 Modulo 2 MIDI/CV: esquematico a 1.68 cents
    Siguiente paso del epic #2 despues de cerrar la fuente y el bus board.
    Esta tanda cierra el ESQUEMATICO; la PCB es el paso siguiente.
    LA DISTINCION QUE ORGANIZA EL MODULO
    El firmware guarda una tabla de afinacion por nota. Esa tabla absorbe
    cualquier error ESTATICO: offset, ganancia, no linealidad del DAC. Lo que
    no puede absorber es lo que cambia DESPUES de calibrar: deriva termica,
    ruido, y el error de masa, que depende de lo que consuman los otros
    modulos en ese instante.
    tuning_budget.py separa las dos columnas y solo una es el presupuesto:
    estaticos (se calibran, no cuentan) ... 103.00 cents
    deriva de la referencia ............... 0.3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
2026-08-15 Módulo 1: BR1 fijado en DB207, pinout verificado contra fuente primaria
    Cierra la puerta de §14.6 (issue #11). El KBP206 del BOM no encajaba en
    la huella: su case KBP es SIP de 4 patas en línea (Diodes DS21205
    Rev. 12), no DIP-4. La pieza real es el DB207 (2 A/1000 V, case DB-1,
    el único puente de 2 A en DIP-4 W7.62/P5.08; en RS ref. 923-5485 o TME
    — Reichelt no tiene ninguno).
    Pinout de dos datasheets primarios independientes que coinciden (HY
    Electronic DB201-DB207 Rev. 11 y TSC HDBL101G, el que referencia la
    propia huella de KiCad): fila superior − +, inferior ~ ~. Montado a 90°
    cae + en pad 1, − en pad 2, ~ en pads 3/4 — exactamente lo que codifica
    D_Bridge_+-AA y lo que es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
2026-08-15 Módulo 1: renders 3D de la placa (kicad-cli pcb render)
    Vista isométrica con sombras y vista cenital, generadas con el
    raytracer de kicad-cli a calidad alta. Los componentes del frente de
    red (F1, RV1, NT1, borneros, faston) salen como huellas vacías porque
    sus huellas locales de sam17.pretty no tienen modelo 3D asociado —
    cosmético, el cobre y la ranura de la barrera son reales.
2026-08-15 Modulo 2: colocacion y masas partidas de la PCB (17 redes sin rutear)
    TANDA INCOMPLETA A PROPOSITO, y marcada como tal: build_pcb.py sale con
    codigo 2 mientras queden redes sin rutear, para que nadie confunda esto
    con una placa fabricable.
    LO QUE SI ESTA CERRADO Y VERIFICADO
    colocacion .............. 44 huellas, nada fuera de placa, sin solapes
    frontera de masas ....... 4.00 mm de hueco MEDIDO sobre el cobre relleno
    plano analogico ......... una sola isla, ninguna pista lo parte
    cada pieza en su lado ... verificado pad a pad
    DRC ..................... 0 infracciones sobre lo ruteado
    ruteado ................. 134 segmentos, 26 vias
    LO QUE FALTA: 17 redes, casi todas del lado dig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
2026-08-15 Ruteador de laberinto sobre rejilla, probado pero SIN integrar
    Herramienta nueva en hardware/tools/maze.py. NO esta enganchada a ninguna
    placa: integrarla en el modulo 2 empeoro el resultado y se revirtio.
    QUE ES
    BFS de Lee sobre rejilla de 0.25 mm, con un mapa de ocupacion por ANCHO de
    pista — marcar todo con el margen del riel mas gordo bloquea el TSSOP
    entero, y marcarlo con el de la pista mas fina deja cortos. Primero busca
    por una capa; solo si no hay paso reintenta con las dos, que da el mismo
    efecto que penalizar la via sin necesitar cola de prioridad.
    Autocomprobacion incluida: rodea una pared con un hueco, y cuando no hay
    paso lo DICE en vez de inventarse un camino.
    POR QUE NO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
2026-08-15 El SAM17 pasa a polifonico de 4 voces
    Decision de arquitectura, no de un modulo. Cambia los cuatro modulos que
    todavia no estan dibujados, asi que se escribe ANTES de dibujarlos.
    docs/architecture-poly.md sustituye al diagrama monofonico como diseno
    vigente; architecture.md se queda como referencia de lo que hace la tesis.
    EL PRINCIPIO QUE LO ORDENA
    Los mandos se comparten; los circuitos se replican. Un filtro de 4 voces
    no son cuatro paneles: es UN panel con un juego de perillas y cuatro
    circuitos identicos detras. El panel no crece con las voces, la PCB si —
    por eso pasar de 4 a 6 voces no pide mas sitio en el cajon.
    EL MIXER SE MUEVE AL FINAL
    En el diseno monofonico sumaba los tres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
2026-08-15 Spec del case: consola inclinada de acrilico naranja
    Diseño aprobado del case definitivo: cheeks de madera, cuerpo
    estructural de acrilico naranja translucido con finger joints
    cementados y parametricos (espesor + kerf), paneles de modulo como
    PCB de aluminio sobre railes 2020, tapa trasera de servicio y
    ventilacion con forma de ondas. Incluye postmortem del intento
    anterior con acrilico y el cupon de calibracion obligatorio.
2026-08-15 Spec-kit y la constitucion del proyecto
    Se adopta github/spec-kit (v0.16.4) para amarrar el proceso ahora que el
    rumbo esta fijado. Adopcion SELECTIVA, no en bloque: spec-kit esta hecho
    para software y este proyecto es mayormente hardware.
    DONDE ENCAJA Y DONDE NO
    * La CONSTITUCION encaja en todo. Es la pieza que mas valia aqui.
    * El flujo specify -> plan -> tasks -> implement encaja en el FIRMWARE,
    que con la polifonia pasa a ser un proyecto de verdad: asignacion de
    voces con robo, rutina de autoafinado, GUI tactil, MIDI DIN.
    * NO encaja en las placas. /implement escribe codigo y tests, no rutea
    una PCB, y el repo ya tiene una convencion mejor para eso: notas
    numerada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
2026-08-15 La spec del case se pone al dia con la polifonia y la constitucion
    La spec original se escribio contra el diagrama monofonico y sin
    constitucion (ambos cambiaron esta misma noche en PRs #24 y #26):
    - El case se dimensiona por paneles, no por voces: mandos compartidos,
    circuitos replicados. El orden logico pasa a MIDI/CV, VCO, VCF, ADSR,
    VCA, MIXER (el mixer se mezcla despues de los VCAs).
    - La pantalla tactil de 7" del modulo 2 entra al frontal: recorte en su
    panel y holgura de fondo en el budget.
    - Las holguras dejan de ser prosa: case/clearance_budget.py con
    aserciones (Principio II), en verde antes de cortar (Principio III).
    - Seccion de lo que NO esta confirmado (Principio I): e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
2026-08-15 Dos caminos de senal separados, afinado digital y patch bay normalizado
    Resuelve la tension entre "instrumento totalmente modular" y "que se afine
    solo". Parecian incompatibles hasta ver que son DOS CAMINOS distintos que
    casualmente son los dos audio analogico.
    * El camino de SONIDO: VCO -> VCF -> VCA -> mixer. Ahi vive la
    modularidad y ahi va el patch bay.
    * El camino de AFINACION: el cerebro escucha al oscilador para medirle la
    frecuencia. Eso no es sonido, es INSTRUMENTACION — como el cable de un
    afinador. Va antes del filtro siempre (con el filtro cerrado no hay nada
    que medir) y no se patchea nunca.
    No comparten un solo cable. Esa separacion es lo que permite pat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
2026-08-15 Rev. 2 de la spec del case: dos pisos, todo acrilico, sandwich modernista
    Revision de requisitos del propietario del proyecto, no correccion:
    - El case pasa a consola de dos pisos (generacion arriba, procesamiento
    abajo), integramente de acrilico naranja translucido, estilo
    modernista de placas planas.
    - La estructura cambia de finger joints cementados a sandwich con
    standoffs de aluminio M4: el problema de los dientes no se mitiga,
    se elimina — la geometria critica pasa a ser posiciones y diametros
    de agujero, independientes del espesor de la plancha.
    - Desaparecen la madera y la pantalla tactil de 7": la interfaz del
    modulo 2 sera una app web servida por el propio Pi (punto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
2026-08-15 Arquitectura de computo: micro en Rust + maquina x86 + agente
    DDR5 y NVMe como requisitos descartan Raspberry por hoja de datos, no por
    opinion: el Pi 5 y el CM5 usan LPDDR4X-4267, soldada y no ampliable.
    NINGUN Raspberry tiene DDR5.
    EL CEREBRO VA PARTIDO EN DOS
    Dos trabajos con requisitos opuestos:
    CV/gates/afinado ..... temporizacion determinista de microsegundos
    Linux es MALO en esto
    secuenciador/UI/agente CPU, RAM, disco, pantalla
    un micro es MALISIMO en esto
    RP2350 en Rust bare-metal <--MIDI/serie--> x86 con Linux
    Tres cosas que compra, y las tres importan:
    * El instrumento TOCA aunque el Linux este arrancando o colgado.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
2026-08-15 Ryzen 9 movil de ultima generacion y Rust en el kernel
    DOS DECISIONES.
    1) EL PROCESADOR: Ryzen AI 9 HX 470 (Gorgon Point, Zen 5)
    La maquina de desarrollo de Samuel es un Ryzen 9 5900X: 12 nucleos, 24
    hilos... y 105 W. El HX 470 da los MISMOS 12/24, con arquitectura dos
    generaciones mas nueva, a 15-54 W configurables (base 28). DDR5-5600
    SO-DIMM hasta 128 GB y 2x NVMe PCIe 4.
    EL CRITERIO NO ES EL CONSUMO, ES EL CALOR.
    Todo el sistema de autoafinado existe porque el convertidor exponencial del
    VCO se desvia -0.33 % por grado. Un procesador de escritorio de 105 W dentro
    de la misma caja no es que no quepa: SABOTEA EL INSTRUMENTO, peleando contra
    lo que se diseño para corregirlo.
    De ahi la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
2026-08-15 La computadora se va FUERA: el instrumento cabe entero en el micro
    Simplificacion grande, y deja mejor el diseno que lo que sustituye. El
    commit anterior de esta rama (Ryzen 9, DDR5, modulo de kernel) queda
    superado; se conserva en el historial porque documenta por que se
    considero y por que no.
    LA DECISION
    El instrumento entero vive en un RP2350. La computadora es OPCIONAL,
    EXTERNA, y puede ser cualquiera: se enchufa por USB MIDI y trae TU DAW y
    TUS plugins.
    Cuatro voces, secuenciador, arpegiador, autoafinado y USB caben en el
    micro. Todo lo demas es lujo, no requisito. Y si enchufas una computadora
    y se cae en mitad de un concierto, el instrumento sigue sonando porque
    nunca dependio de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
2026-08-15 Los mandos salen del camino de audio: presets de verdad
    Decision estructural del lado analogico, y la que hace posibles los presets.
    EL PROBLEMA: un potenciometro es su propia memoria. Su posicion fisica ES el
    valor. Cargas un preset y la perilla sigue donde la dejaste. Por eso el
    Minimoog no tiene presets — no es que no quisieran.
    LA SALIDA: las perillas dejan de controlar y pasan a ser SENSORES. Van a un
    ADC, el micro las lee, y el voltaje de control lo genera un DAC. El audio
    sigue siendo 100% analogico; lo que se digitaliza es el MANDO, no el sonido.
    Un preset pasa a ser una lista de numeros.
    Y NO ES UN INJERTO. Mira como se llaman los modulos: VCO, VCF, VCA —
    Voltage Controlled.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
2026-08-15 Spec de la fuente v2: rieles sub-µV con pre-reg + LT3045/LT3094
    Diseño aprobado por secciones con Samuel (2026-08-15/16): respin v2
    integrado, ensamblaje SMD en JLCPCB, la v1 se pide de mula de medidas,
    650 mA/riel. Topología LM2941/LM2991 ajustables → LT3045×2/LT3094×2 en
    paralelo con SET compartido, sense Kelvin e ILIM programado. Incluye
    térmica, protecciones (TVS de nodo intermedio, capa física de
    conectores, regla de polaridad inversa para módulos), layout de ruido,
    los dominios de alimentación post-pivote (computadora fuera, +5 V
    digital con SMPS encapsulada para RP2350+WS2812), censo poly estimado,
    plan de validación con LNA y la lista honesta de lo no confirmado.
    Co-Auth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
2026-08-16 Rev. 3 de la spec del case: pivote de computo, fuente v2 y el board de diseno
    - El cerebro ya no es un Pi: el instrumento entero vive en un RP2350 y
    la computadora es externa y opcional (PR #30). Muere la app web
    servida por el Pi; el companero pasa a ser un plugin VST/CLAP y el
    panel del modulo 2 conserva boton AFINAR + LED. Los conectores de
    enlace (USB MIDI class-compliant, MIDI DIN) los ubica el modulo 2.
    - La fuente v2 (PR #32) pasa a ser la fuente de verdad para
    transformador, termica y el dominio +5V digital (RP2350 + WS2812);
    la iluminacion WS2812 queda citada como fuera de alcance con paso
    de cableado previsto.
    - Los angulos se miden DESDE LA VERTICAL: la rev. 2 era am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
2026-08-16 Plan de implementacion del case: del board de diseno a archivos de corte
    Diez tasks con ciclo de prueba propio: toolchain + params como fuente
    unica, clearance_budget en rojo-verde, modelo OpenSCAD por planchas,
    cupon, export con puerta de budget, plantilla KiCad de panel, render
    Blender, documentacion y cierre de tanda con PR e issues.
2026-08-16 params del case como fuente unica y enmienda del esqueleto a 2020
2026-08-16 Plan de implementacion de la fuente v2: 10 tareas en 4 fases con puertas
    Claude-Session: https://claude.ai/code/session_01Xqa4XDcufx4ptQE2gEAZoo
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2026-08-16 Los DAC viven en los módulos: el bus no crece nunca y el suelo baja a 0.58
    El margen de expansión no era comprar más DAC para el cerebro: era mover
    el DAC al módulo que lo consume. Por el cableado viajan números (enlace
    serie), no voltajes — un módulo nuevo o pasar de 4 a 8 voces suma cero
    hilos.
    Y el premio que no se buscaba: el CV de tono ya no cruza el bus, así que
    el término de masa de 1.21 cents desaparece del pitch y queda el plano
    local del módulo (0.08 pesimista). Suelo: 1.71 -> 0.58 cents, y pasa a
    mandar la medida del autoafinado, no la masa. El CV patcheado sigue
    viendo el bus: ground_budget.py no pierde ni una regla.
    La condición va al BOM: AD5686R grado B (2 ppm/C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
2026-08-16 clearance_budget: las holguras del case dejan de ser prosa
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2026-08-16 Puertas de datasheet v2: LM2941/LM2991 contra primarios, GO/NO-GO cerrado
    Cierra spec §11.1 (dropout garantizado a 650 mA) y §11.2 (tab del pre-reg):
    LM2941 dropout max 1.0 V @ 1A/temp completa (TI SNVS770I p.5-6), tab = GND;
    LM2991 dropout max 1.0 V @ 1A/temp completa (TI SNVS099I p.5), tab = IN
    (muerde, mica obligatoria, confirmado). Corrige la formula de VOUT del
    LM2941 (es 1+R2/R1, no 1+R1/R2 como decia el brief). GO/NO-GO recomputado
    con dropout garantizado (no tipico): riel positivo pasa por 0.02 V (antes
    se creia 0.22 V con el numero tipico), riel negativo por 0.22 V.
    LT3045/LT3094 quedan BLOQUEADOS: analog.com resetea la conexion desde este
    entorno con los seis metodos de descarga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
2026-08-16 Cierra §1.3/§1.4 (LT3045/LT3094) del gate de datasheets v2
    analog.com y Wayback Machine inalcanzables desde este entorno (503
    persistente incluso para PDFs de ti.com ya confirmados accesibles);
    se usaron copias verbatim ADI/Linear vía distribuidor (Farnell para
    LT3045 rev. 3045f, DigiKey para LT3094 Rev 0), verificadas como PDF
    nativo con pie de página de revisión.
    R_ILIM, ILIM per-chip, red SET+ballast, fuga de C_SET, dropout
    garantizado, V_IN abs max, EP, PG y EN/UV quedan cerrados con cita de
    página para ambos chips, incluida una asimetría real entre ambos que
    el brief asumía simétrica (EP del LT3094 va a IN, no a GND) y un gap
    honesto sin dato primario (Schottky de protección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
2026-08-16 Spec del módulo 3: VCO x4 con el DAC adentro, mezcla por VCA y telemetría
    Diseño validado con Samuel: mezcla de ondas por VCA con mando compartido
    (2x AD5686RB en cadena, 8 canales justos), ni FM ni sync, 8 jacks (CV-IN
    sumando + salida por voz), enlace serie híbrido que cierra el issue #34
    (CS por módulo, cadena soldada en placa), y telemetría de serie como
    patrón de instrumento: sensor de temperatura I2C pegado a los CEM3340,
    EEPROM de identidad con la calibración viajando en la placa, y test
    points en los nodos clave — el lazo temperatura/correcciones del
    autoafinado es el instrumento de mejora.
    Claude-Session: https://clau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
2026-08-16 Fix round 1: orientacion D10 como inferencia, colision de referencia U2
    Hallazgo 1 (critico): D10 respondia la pregunta del Schottky out-in
    (nodos OUT/IN) citando el clamp OUTS-SET, que es un diodo distinto en
    otros pines. El LT3045 (p.22) solo documenta proteccion inversa
    integrada en el chip para la trayectoria OUT->IN; no hay guia
    explicita de orientacion para un Schottky externo entre esos pines.
    D10 queda marcado como inferencia de ingenieria (mismo formato que
    D11 en Sec 1.4): anodo en OUT, catodo en IN, con recomendacion de
    verificar contra el demo board DC2491A. La cita OUTS/SET se deja
    aparte, con nota de que es informacion real pero de otro diodo.
    Hallazgo 2 (importante): "el LT30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
2026-08-16 El módulo 3 salta a 2026: SSI2130, trimless, y media placa desaparece
    Decisión con Samuel tras verificar el datasheet del SSI2130: deriva
    200 ppm/C compensada en chip (la R tempco muere), mezclador VCA de 5
    canales dentro del chip (los 6 LM13700 y sus redes mueren), seno de
    0.76% THD de regalo (cuarto sabor de mezcla), y el amplificador x2.8
    tampoco sobrevive — el expo es un nodo de corriente y la escala la
    fijan resistencias.
    Cascada: 3 DAC en cadena (9 canales + 3 reserva), diseño trimless con
    5% de margen de span (tuning.json absorbe hasta la no-conformidad del
    expo, que un trimmer no arregla), VREF unica de 2.5 V para DAC y
    osciladores (los errores escalan juntos y se cancelan), co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
2026-08-16 Puerta de stock v2: silicio ultra y pasivos criticos contra LCSC
    Task 3: LT3045 (C514420, DFN-10-EP 3x3, 3618u) y LT3094 (C670492,
    WDFN-12-EP 3x3, 1475u) confirmados en stock real en LCSC -> GO. DFN
    elegido sin caer al fallback MSOP (regla del Step 2, ambos con stock).
    Pasivos criticos (shunt 20mR, 22uF/10uF X7R, SMAJ15A, SS14) y THT
    (LM2941CT/NOPB, LM2991T/NOPB, trimmer 3296W-1-102) verificados con
    C-codes/distribuidor y fecha de consulta. Gap documentado: R_SET
    121k 0.1%/25ppm sin C-code confirmado en LCSC (limite de herramienta,
    no evidencia de falta de stock) - fallback 120k 1% verificado y
    accion concreta dejada para Task 4/9.
    Clau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
2026-08-16 Modulo 3 VCO: BOM completa y libreria de simbolos (SSI2130 + AD5686RBRUZ)
    BOM sustituye la version vieja del VCO (CEM3340) por el diseno real con
    SSI2130 x4: DACs, referencia, buffers, reguladores locales, sensor de
    temperatura, EEPROM de identidad, redes pasivas del datasheet y conectores.
    Libreria nueva con el simbolo SSI2130 (QFN-32+EP, 33 pines) construido pin a
    pin contra el datasheet -- el orden de los pines 9-13 del mezclador
    (TRI/SAW/PULSE/AUX1/AUX2), que el brief marcaba como pendiente de verificar,
    se confirmo visualmente contra la Figure 1 del datasheet y coincide con lo ya
    escrito. El bloque AD5686RBRUZ se copio identico (diff programatico) desde el
    modulo 2, sin tocarlo.
    Dos am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
2026-08-16 Fix round 1 Task 3: columnas básica/extendida+fecha en tabla silicio, R_SET a 120 kOhm
    F1: tabla de variantes LT (§2.1) le faltaban las columnas básica/extendida
    y fecha por fila que ya tienen pasivos/THT; se movieron desde la prosa. La
    fila LT3045HDD#PBF (stock/precio no verificados) ahora dice "no verificado"
    en vez de "-" ambiguo.
    F2: el documento habia adoptado 121 kOhm como valor de diseno de R_SET
    citando la Table 1 del DS (redondeo E96 de ADI), pero el objetivo real es
    12.000 V = 100 uA x 120 kOhm - 121 kOhm da 12.100 V, 100 mV fuera de blanco.
    Se invirtio el encuadre en §1.3/§1.4 (calculos de fuga recalculados a
    120 kOhm) y en §2.4 (SKU objetivo pasa a RT0805BRD07120KL, marcad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
2026-08-16 El plan incorpora las lecciones de vectorizer: relectura DXF y cupon anti-circular
    Destilado por reasonix flash (USD 0.024, 774K tokens leidos) de
    projects/vectorizer y vina/docs/research; juicio de aplicabilidad propio:
    - Task 6 gana case/check_dxf.py: relee cada DXF exportado con ezdxf y
    aserta entidades, cierre de contornos y bbox dentro de sobre por pieza
    (la clase de bug x25.4 y los paths abiertos fallan en silencio; se
    valida el artefacto releido, no el generador). Enganchado a export.ps1
    como puerta posterior. El budget ademas imprime el kerf aplicado y
    aserta su rango fisico.
    - Task 6 hornea el quoting escapado de PowerShell 5.1 (ruling del T3).
    - Task 9: el cupon gana la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
2026-08-16 Fix modulo 3: EP del SSI2130 no lleva red electrica, y quantity de TP*
    El brief traia el pad termico del SSI2130 conectado a GNDA; el datasheet
    (pag.6, "Exposed Thermal Pad") dice lo contrario -- si el land existe, "it
    MUST NOT have any PCB electrical or ground connection". Pin 33 pasa de
    power_in a no_connect en sam17.kicad_sym y la Description deja de decir
    "-> AGND", citando la pagina del datasheet.
    De paso, TP* en bom.csv decia quantity 14 pero la nota enumera 15 puntos de
    prueba; ajustado a 15.
    Claude-Session: https://claude.ai/code/session_01TtD4jRd4wyRdkyuChqdVe2
2026-08-16 BOM v2: contrato completo de la cascada pre-reg + LT en paralelo
    34 filas heredadas de la v1 (etapas de red/rectificacion/bulk/+5V/crowbar/
    LED de riel que sobreviven) + 34 filas nuevas (pre-reg LM2941/LM2991,
    parejas LT3045/LT3094 en paralelo, R_SET/R_ILIM/C_SET, ballast, TVS,
    Schottky, JP1, TP7/TP8, J7), todas con valores resueltos contra las puertas
    de datasheet de design-notes.md §1/§2 — ninguna referencia queda como
    "segun §X" sin resolver. Rojo esperado verificado: check_bom.py lanza
    FileNotFoundError porque la hoja de v2 todavia no existe (Tasks 5-6).
    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
2026-08-16 Modulo 3 VCO: esqueleto, alimentacion local y referencia unica
    Tarea 2 del epic modulo-3-vco. build_schematic.py copia la estructura del
    modulo 2 (helpers de escritura s-expr, vertice exacto <0.01mm por pin,
    schcheck) y dibuja J1 (bus +12/G/G/-12), los dos reguladores locales
    (78L05->+5V_LOC, LD1117->+3V3_LOC) y la referencia unica (ADR4525->VREF_2V5)
    que alimentara los tres DAC y los cuatro SSI2130 sin que cada uno derive por
    su cuenta. +5V_LOC/+3V3_LOC/VREF_2V5 no tienen simbolo de potencia de
    fabrica: se resuelve pidiendo prestada la forma de un riel estandar y
    pisandole el Value, la tecnica normal de KiCad para nombrar un riel propio.
    Deja tambien los 15 test points de la tabla maestra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
2026-08-16 Modulo 3 VCO: fix de revision, Value de U8 lleva el grado (ADR4525BRZ)
    El "OJO: es ADR4525" del contexto de despacho corregia el lib_id del
    simbolo, no el Value. El Value es donde el repo registra la pieza exacta a
    comprar, y el grado importa: el spec dice que el grado A revienta el
    presupuesto de afinacion. Mismo precedente que modulo 2 (AD5686RBRUZ,
    TL074H conservan su sufijo en Value aunque el lib_id sea generico).
    lib_id sin tocar (Reference_Voltage:ADR4525, resuelve bien el simbolo).
    Guardias verdes, ERC identico: 0 errores, 8 avisos esperados
    (isolated_pin_label en los TP huerfanos de CV_PITCH/MIXO).
    Claude-Session: https://claud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
2026-08-16 Modulo 3 VCO: bloque digital -- cadena de 3 DAC, 74HC14, telemetria I2C y J2
    Tarea 3: extiende build_schematic.py (no lo reescribe) con bloque_digital()
    -- bloque_dac() (U5-U7 AD5686R en cadena soldada DCEN, GAIN=x1/LDAC/RSTSEL
    igual que el modulo 2, RESET atado a +3V3_LOC por no haber GPIO de reset en
    esta placa), bloque_hc14() (U10, Schmitt trigger multi-unidad para
    TUNE_OUT_1..4), bloque_telemetria() (U13 TMP1075 direccion 0, U14 EEPROM,
    pullups I2C) y bloque_mazo() (J2 IDC 2x6 con el contrato del enlace, dejado
    tambien como tabla comentada J2_PINOUT para los modulos 5-7).
    Fix de paso: el pin 5 de la EEPROM (24AA02E-OT) es no_connect en el propio
    simbolo -- igual que el EP del SSI2130 en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
2026-08-16 Fix revision Tarea 3: desacoplos faltantes del bloque digital (C12-C20)
    Finding Important de la revision: bom.csv reserva C_DEC* ("desacoplo
    pegado a cada chip") como contrato y el bloque digital dejaba 6 chips sin
    ninguno. Anade _desacoplo() (helper nuevo, solo usado en codigo nuevo) y 9
    capacitores de 100nF:
    - C12-C17 (U5-U7, en bloque_dac()): VDD y VLOGIC de cada DAC, retorno a
    GNDA -- mismo esquema que el DAC unico del modulo 2.
    - C18/C19/C20 (U10/U13/U14, en bloque_hc14()/bloque_telemetria()):
    +3V3_LOC -> GNDD cada uno, su propia masa.
    ERC identico violacion por violacion al de antes del fix (20: 4 errores
    pin_not_driven en SQ_1..4 + 16 avisos esperados) -- los 9 capacitores
    caen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
2026-08-16 el esqueleto deja de chocar: pieles voladas, rail reubicado, railes rotados y guardas de solape
    Ronda de fix sobre revision de Task 5 (5 reglas del controller, R1-R5):
    - R1: pieles y zocalo pasan de recortados hacia dentro a VOLADOS sobre
    standoffs M4, gap_sombra por FUERA del cuerpo. Alto/ancho de cada uno
    sale ahora de las centrelineas de sus dos railes limite (filas de
    agujero a ras), no de un inset fijo sobre el perfil. zocalo adopta el
    mismo esquema de 4 esquinas M4 que las pieles (antes 1 fila M3).
    - R2: nuevo parametro holgura_rail=4 (params.scad). El rail "entrepiso
    delantero" se reubica detras del rail de panel cara-superior que
    invadia (17.6x12.6 mm de solape verificad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
2026-08-16 sexto larguero de repisa y el escalon se abre a 25
    Ronda de revision 2 (2 reglas del controller, R6-R7). El controller
    identifico su propio error en R1: anclar piel_superior a "entrepiso
    trasero" (rail del plano del piso INFERIOR, X=340) en vez de un rail del
    plano del piso SUPERIOR (X=250) — por eso la piel invadia la bandeja de
    entrepiso (5x5x474 mm, tolerado en la ronda 1).
    - R6: sexto larguero "repisa" en centros_esqueleto(), centro
    (prof_superior-rail/2, P3.y+15) = (240, 250.85) — 5 mm por encima del
    tope de bandeja_entrepiso, verificado sin tocarla. piel_superior se
    reancla aqui (antes: entrepiso trasero): fila de agujero inferior a
    ras de esta centrelinea, outline = filas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
2026-08-16 Modulo 3 VCO: dibuja las 4 voces (SSI2130 x4 + I/V + jacks), ERC a 0 errores
    dibujar_voz(n, origen) llamada 4 veces: cablea los 32 pines de cada
    SSI2130 (redes reales del DAC/mezclador + nodos internos para la red del
    seno, EXPO FREQ, TCAP y BW COMP), el I/V compartido (unidad n de U9,
    TL074, virtual a masa + R_IV 10k hasta VOICE_OUT_n) y los jacks J_CV/J_OUT
    por voz. El pin 33 (EP) se salta del bucle a proposito: es no_connect de
    fabrica y ponerle la cruz produce "no_connect_dangling" (mismo caso que
    el pin 5 del EEPROM en la Tarea 3).
    Corrige un error del brief contra el datasheet: la Figure 1 (verificada
    en imagen renderizada a 400 DPI) y el texto de la pagina 6 atan PWM- (31)
    al triangu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
2026-08-16 Esquematico v2: herencia v1 + pre-reguladores ajustables con TVS
    Cirugia de herencia sobre build_schematic.py v1: fuera LM2940/LM2990 y sus
    pasivos directos; entrada 230V, rectificacion, bulk, 7805, crowbar, LED de
    riel, J2/J6, TP1-TP6 y check_footprints() sobreviven intactos. Nuevo: U1
    LM2941CT (+13.1V) y U2 LM2991T (-12.9V) con simbolo local de 5 pines
    (pinera verificada contra datasheet TI primario), divisores R5+RV2/R6 y
    R7+RV3/R8 a GND, C17/C18/C27/C28, D12/D13 out->in, TVS D8/D9, TP7/TP8 y J7
    (derivacion 230V hacia la SMPS digital, entre F1+RV1 y NT1). Nets nuevos
    +13V1/-12V9; el bus +12V/-12V heredado de v1 queda isla electrica (PWR_FLAG
    propio) hasta que Task 6 lo cuelgue de la parej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
2026-08-16 Modulo 3 VCO: fix de revision -- LIN FREQ, MIX AUX2, desacoplo V-/bulk, ERC 0/0
    Corrige 3 findings reales de la revision contra el datasheet (misma clase
    de error que el PWM ya cazado: manda la Figure 1 + el texto de aplicacion,
    no el borrador del brief):
    - LIN FREQ (pin 21) ya no queda NC: sin ~5uA ahi el oscilador SE PARA (ds
    pag.5 y pag.9, "0 current in equals 0 frequency out"). R_LIN{n} 499k
    desde VREF_2V5 en cada voz.
    - MIX AUX2 (pin 13) deja de ir a masa directa: el datasheet (pag.8) lo
    prohibe explicitamente para canales de mezcla sin usar ("Do not connect
    control inputs directly to ground"). Pasa a NC, igual que su otro
    extremo (AUX2 IN, pin 5).
    - Desacoplo de 100nF en V-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
2026-08-16 export reproducible: DXF de corte y STL de render con puerta de budget
    - export.ps1: orquesta todas las exportaciones con gates de budget y relectura
    * budget corre primero (Principio III)
    * check_dxf valida unidades, sobres y cierre de contornos
    * exit 0 solo si TODO pasa (budget VERDE + check_dxf VERDE)
    - check_dxf.py: valida DXF exportados con ezdxf
    * detecta INSUNITS no estándar (OpenSCAD 2021.01 emite 6)
    * verifica sobres con margen de ±15mm (tripwire de escala 25.4×)
    * reporta entidades sin cerrar y contornos abiertos (silencio en OpenSCAD)
    - clearance_budget.py: eco de kerf + aserción de rango [-0.5, +0.5] mm
    - Artefactos: 8 DXF de corte (2D) + 2 STL de render (3D) + c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
2026-08-16 Modulo 3 VCO: check_netlist.py y check_bom.py (Tarea 5)
    check_netlist.py cubre las 9 aserciones del brief (masas separadas,
    VREF_2V5 cerrada, cadena SPI en orden, VLOGIC/V+ en el riel local
    correcto, las 4 voces sin cruzar CV de pitch, TN a GNDA, SQ->TUNE_OUT
    bien pareado incluyendo la unidad 4 invertida del 74HC14, I2C con
    pullups) mas la #10: EP y MIX AUX2 de U1-U4 salen unconnected-*.
    check_bom.py resuelve los tres formatos de refs del bom.csv (rangos
    "U1-U4", rangos cortos "C_TCAP1-4", comodines "R_MIX*") contra
    sam17-vco.net en ambos sentidos, con cantidades.
    Al cruzar aparecieron 4 discrepancias reales en bom.csv, corregidas
    (el BOM se ajusta a la hoja, no al reves):
    - RED_SINE* y RE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
2026-08-16 Fix round 1 Task 5: worksheet I2t de F1 + UUIDs deterministas
    F1 (Important): design-notes.md v2 SS3.0 sumaba el valor de F1 (1.6A T)
    sin cuantificar el arranque en frio ni el trade-off de proteccion. Se
    agregan SS3.0.1 (worksheet de I2t con supuestos declarados: NT1 limita
    el pico a ~65A, ~26.5 A2s estimados en los primeros ~20ms, contra un I2t
    de fusion tipico de 10-30 A2s en un 5x20 de 1.6A) y SS3.0.2 (subir F1
    6.4x deja una ventana de falla sostenida ~0.4-2A sin cubrir, mitigada por
    RV1/portafusible cerrado/fusible termico del TR1). bom.csv v2: nota de
    F1 ajustada (no duplicada) con el ítem de verificar I2t contra el
    datasheet real; nota de TR1 con el item de compra del fusible termico.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
2026-08-16 Plan de implementacion del modulo 3, con las correcciones regladas en ejecucion
    Se committea con las enmiendas que los reviews forzaron contra datasheet:
    EP aislado (no GNDA), LIN FREQ con sus 5uA (no NC), pin 13 flotante
    (no masa directa), y la asercion de VREF ampliada con las R_LIN.
    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
2026-08-16 raices de INSUNITS: fix_dxf_units.py reescribe 6 a 4; puertas restauradas
    Fixes: (1) OpenSCAD 2021.01 estampa INSUNITS=6 (metros) con contenido mm; fix_dxf_units reescribe post-export. (2) export.ps1 restauradas puertas LASTEXITCODE en piezas/coupon/STL; limpieza previa evita stale files. (3) check_dxf estricto (0,4).
2026-08-16 El DXF no declara unidades: dejamos de fingir que las arreglamos
    fix_dxf_units.py era un no-op que jamas convergia: primera pasada imprime
    "INSUNITS 6 -> 4", segunda pasada imprime "0 -> 4", y el valor nunca
    persiste. Habria cantado un arreglo en cada corrida, para siempre.
    La causa medida: OpenSCAD 2021.01 emite DXF R12 (AC1009) SIN seccion
    HEADER — la cadena $INSUNITS aparece CERO veces en el archivo. El 6 no
    era de OpenSCAD: es el default que ezdxf SINTETIZA al leer un archivo sin
    header. No habia header mentiroso que corregir; hay un archivo que
    sencillamente no declara unidades, que es lo normal en R12.
    Consecuencia que el commit anterior no vio: los artefactos de a7179d8 NO
    pasaban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
2026-08-16 plantilla de panel de aluminio: el artefacto es el script
    Task 7. build_template.py genera panel-template.kicad_pcb con pcbnew de
    KiCad 10 (10.0.3, verificado: import pcbnew, CreateEmptyBoard, PCB_SHAPE,
    FOOTPRINT/PAD con PAD_ATTRIB_NPTH, PCB_TEXT, SaveBoard existen tal cual en
    esta version). Contorno rectangular en Edge.Cuts, 4 taladros M3 NPTH en
    los centros de rail, rotulo en F.Silkscreen. --ancho sigue siendo
    argumento de linea de comandos (lo unico que varia por modulo).
    El brief hardcodeaba ALTO=190, INSET=5 y taladro 3.2 (y ese 3.2 ya
    contradecia params.scad, que dice d_M3_paso=3.4). Eso duplica la fuente de
    verdad y se desincroniza en silencio, asi que build_template.py lee
    alto_pan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
2026-08-16 Esquematico v2 completo: LT3045/LT3094 en paralelo con SET compartida e isla GNDREF
    Etapa ultra sobre simbolos estandar (Regulator_Linear:LT3045xDD/LT3094xDD,
    sin simbolo local): U4/U5 en paralelo sobre +13V1->+12V, U6/U7 en paralelo
    sobre -12V9->-12V, SET compartido por riel (R9/C15, R10/C16) a GNDREF, ILIM
    por chip (R11-R14) con Kelvin a la masa propia, ballast 20mOhm (R15-R18),
    Schottkys D10/D11 (D11 espejo negativo de D10, mismo patron que D12/D13),
    JP1 como unico puente GNDREF<->GND. Divisores de U1/U2 (R6/R8) movidos de
    GND a GNDREF. Isla +12V/-12V heredada de v1 reconectada de verdad al
    ballast/OUTS. Hoja a A2 (hacia falta mas ancho).
    check_bom.py: OK cuadre total (0/0/0, 81 en hoja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
2026-08-16 plantilla de panel: puente minimo entre taladros, espesor real y kicad_pro trackeado
    Fix round 1 sobre el review de Task 7 (spec OK, calidad aprobada, 0
    bloqueantes, 0 importantes). Cuatro cosas:
    FIX 1 (el que importa): inset_tornillo posiciona los 4 taladros M3 en LOS
    DOS ejes (X e Y), pero solo la guarda de alto (Ruling A) existia. Con un
    --ancho chico (2HP Eurorack = 10.16mm, inset=5, d_M3_paso=3.4) los dos
    agujeros de una misma cara quedaban a 0.16 mm de separacion entre centros
    con taladro de 3.4mm -- superpuestos, y el script los generaba sin avisar
    (fallo invisible hasta fabricacion, Principio V). verificar_ancho_minimo()
    exige ahora que ancho - 2*inset_tornillo >= d_M3_paso + 2.0mm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
2026-08-16 render headless del conjunto en Blender
    Encuadre calculado desde el bbox real de las mallas importadas (no una
    posicion de camara fija): el angulo tres cuartos es la unica constante
    estetica, la distancia sale del tamano real del ensamblado via el FOV
    que Blender calcula para 1600x1200. Si params.scad cambia de tamano el
    render se sigue encuadrando solo.
    El chequeo de "PNG > 100kb" del brief es un proxy comodo que un render
    vacio o fuera de cuadro pasa igual (pesa de sobra por el ruido de
    Cycles). Tras escribir el PNG el script lo relee con
    bpy.data.images.load y mide que fraccion de pixeles no es fondo; por
    debajo del umbral sale con codigo != 0 y un mensaje ROJO. Umbral
    comentado con el n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
2026-08-16 Fix round 1 Task 6: R9/C15 y R10/C16 en paralelo (estaban en serie)
    CRITICAL del task review: el wire "R9->C15 gap" unia la pata inferior de
    R9 con la superior de C15 -- SET->R9->nodo->C15->GNDREF en serie, lo que
    le corta a I_SET (100uA, pin SET) el camino DC a masa (el cap bloquea DC).
    Los 4 chips no habrian regulado.
    Fix: nueva columna X_RCSET2=238.76 (sin colision con las wires ADJ U1/ADJ
    U2 en x=232.41, verificado antes de mover nada), C15/C16 al lado de R9/R10
    (mismo Y de ancla, ya no apiladas una encima de la otra) y taps via rail()
    de 2/3 puntos en vez del wire serie. Espejo identico para R10/C16.
    Verificado yo mismo en el netlist exportado, no de memoria: R9.1/C15.1 y
    R10.1/C16.1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
2026-08-16 Modulo 3 VCO: build_pcb.py -- colocacion y ruteo parcial (Tarea 6, BLOCKED en Step 3)
    Placa 240x172 mm, 2 capas, GNDA en plano con isla GNDD minima en la
    esquina de J2 (frontera 2D, no lineal como el modulo 2: aqui el dominio
    digital de verdad son 9 componentes). Colocacion verificada contra las
    5 reglas del brief: U5 (DAC de CV_PITCH) centrado en el racimo, U13
    adyacente a el desde la isla, desacoplos <2mm, U8 entre DAC y SSI2130,
    jacks/J1-J2 en bordes opuestos. EP de cada SSI2130 aislado (sin via, sin
    red) en las 14 corridas de prueba.
    DRC = 0 infracciones sobre el cobre existente (dos bugs reales de mi
    propio router, documentados en el script: netclass no seguia
    m_MinClearance, y GetSize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
2026-08-16 render: relleno GI desacoplado del fondo, vista trasera, gate de brillo
    Fix round 1 sobre la Task 8 (coordinador ya juzgo el render a ojo,
    Ruling D):
    FIX 1 -- el render estaba subexpuesto de verdad, no solo a ojo: el fondo
    oscuro (0.02 lineal) era tambien la unica fuente de luz de entorno, asi
    que el metal/acrilico en sombra o visto a traves de la transmision
    rendeaba casi del color del fondo (medido: brillo 0.0509). Diagnostico
    por eliminacion antes de tocar nada: subir la energia de las 2 luces de
    area x4 casi no movio el brillo (0.052->0.061); el view transform (AgX
    vs Standard) es una palanca secundaria (~9%). La palanca real era la luz
    de entorno. Se desacopla el fondo VISIBLE (oscuro,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
2026-08-16 documentacion del case: cupon, BOM, ensamblaje y sustitucion del modulo 8
    case/README.md se reescribe entero para el case de acrilico de dos pisos
    (spec 2026-08-15-case-design.md rev.3): formato propio vs. Eurorack ya
    resuelto (alto_panel=190mm), numeros reales de clearance_budget.py y de
    PART="bom" tomados de la corrida de hoy, ancho minimo de panel (15.40mm,
    guarda de build_template.py) y las dos vistas de render (frontal + trasera
    con las ranuras de ventilacion en onda).
    El cambio que importa es el de bonding de tierra: el requisito de modulo 1
    (un cable verde/amarillo por panel al espargo M4 unico) se mantiene, pero
    su justificacion vieja murio con la madera. Se corrige a "cuerpo acrili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
2026-08-16 case: corrige dimensiones stale del README raiz, cierra el pendiente de Eurorack en modulo 8
    README.md raiz decia "950 x 440 x 100-200mm" (cajon de madera de la tesis)
    13 lineas debajo de la fila de la tabla ya corregida a acrilico/aluminio,
    autocontradiccion en la misma pantalla. Reemplazado con numeros reales de
    params.scad y de la salida de clearance_budget.py/_cajas_solidas(): ancho
    500mm, alto 50-391.5mm (zocalo frontal a punto mas alto), fondo 350mm de
    cuerpo o 370mm bulto real contando zocalo y piel inferior voladas.
    docs/modules/08-case-panels.md marcaba como mejora futura "migrar a
    Eurorack" cuando esa decision ya se tomo en contra (formato propio,
    alto_panel=190). Se deja el texto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
2026-08-16 case: cierre de tanda -- regeneracion verificada por clase, plan marcado
    Task 10 (cierre). Regenerado el case dos veces desde artefactos borrados
    (export.ps1 exit 0 las dos veces, clearance_budget.py y check_dxf.py en
    verde). El Step 1 del plan pedia identidad byte a byte y eso es falso
    para dos de las tres clases de artefacto, medido de verdad en esta
    tanda: los 8 DXF SI dieron el mismo SHA-256 en 3 corridas (commiteado +
    2 regeneraciones); los 2 STL mantuvieron tamano pero
    assembly_aluminio.stl cambio de hash en las 2 regeneraciones (CGAL no
    ordena facetas de forma estable); panel-template.kicad_pcb mantuvo el
    mismo conjunto de 17 bloques top-level una vez se descartan los uuid
    (KiCad los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
2026-08-16 PCB v2: placement por islas con checks de referencia, diagonal y una cara
    Task 7 del plan psu-v2-goat: build_pcb.py de la v2, placement completo por
    islas (banda 230V, lazo de rectificacion+bulk, muralla TO-220, isla ultra +
    GNDREF), todavia sin rutas (Task 8). Anade revisar_smd_cara,
    revisar_isla_referencia, revisar_diagonal y revisar_borde_ceramicos; corrige
    un bug de unidades en el snippet de revisar_diagonal (distancia_bbox ya
    devuelve mm) y dos bugs de datos (pads solo-pasta del EP de los DFN sin red,
    texto de Value sin ocultar inflando GetBoundingBox() sin argumentos).
    Claude-Session: https://claude.ai/code/session_01Xqa4XDcufx4pt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
2026-08-16 Ajuste de placement: R8/RV3 (nodo ADJ) al canal libre junto a U2
    Review de Tarea 7: la fila R7/RV3/R8 dejaba el nodo de ajuste de U2
    (Net-(U2-ADJ): RV3.1/R8.2/U2.1) a ~87 mm cruzando la placa -- alta
    impedancia, sin guarda. R8/RV3 se reespejan al canal vertical libre
    entre el disipador de U2 (x=143) y el margen de placa (x=147), girados
    90 grados; R8.2(ADJ) queda a 28.67 mm de U2.1(ADJ). R8.1 (GNDREF) sigue
    dentro de ISLA_REF, ensanchada en x2 de 139 a 147 para alcanzarlo. R7
    (la pata de -12V9, riel de baja impedancia, no la red sensible) vuelve
    al hueco que R8 dejo libre junto a R6 -- no necesitaba reespejarse.
    Checks de build_pcb.py en cero con el placement nuevo.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
2026-08-16 la bandeja base vuelve a apoyar, y ahora hay quien lo verifique
    bandeja_base_2d nunca se re-derivo en las rondas de arreglo: seguia con la
    formula original (plancha de prof_inferior-2*rail-4 colocada en x=rail)
    mientras bandeja_entrepiso si paso a derivarse de centros_esqueleto(). El
    resultado medido: filas de agujeros a +18.00 y -24.00 mm de las centerlines
    de sus dos largueros, y el canto trasero de la plancha a 4 mm de tocar
    siquiera el rail trasero. La bandeja que carga el transformador del PSU
    (spec §5) no apoyaba atras. Ahora x0 y fondo salen de ce[0] y ce[1], y la
    colocacion usa ese mismo x0.
    Lo que importa mas que el caso: nadie podia verlo. solapes() verifica
    disyuncion, y una pla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
2026-08-16 el cupon deja de ser un poligono: $fn se muda a params
    Los agujeros del cupon salian PENTAGONOS. sam17_case.scad fijaba $fn = 48
    pero coupon.scad solo incluye params.scad, que no lo traia, asi que sus
    circulos se teselaban con los defaults ($fa=12/$fs=2). Medido en el DXF
    committeado: el peldano "2.5" era un pentagono de 5 segmentos de
    2.261 x 2.378 mm -- 0.24 mm por debajo de su propio nominal y 0.117 fuera
    de redondo, contra peldanos de escalera de 0.1 mm.
    La consecuencia no era cosmetica. El cupon es la pieza con la que se MIDE
    el kerf antes de cortar las planchas. Con agujeros poligonales, el tornillo
    entra por el circulo inscrito, la formula del README devuelve un kerf
    errado en signo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
2026-08-16 PCB v2 ruteada (parcial): isla GNDREF, Kelvin fisico, granjas termicas -- DRC NO en cero
    Rutea TRACKS/VIAS completos sobre el placement de la Tarea 7 mas el ajuste
    de R7/RV3/R8: potencia THT, +12V/-12V >=1.5mm a J2, red SET fina con
    retorno solo por zona GNDREF, granjas termicas 3x3 bajo EP de U4/U5,
    verificacion de EP de U6/U7 en /-12V9, y zona de cobre GNDREF limitada a
    ISLA_REF (antes ausente).
    build_pcb.py: 8/10 checks propios en 0 (placement, GNDREF, lazo
    rectificador, ceramicos, bucles de masa). `cruces` (26) y `pistas encima de
    un pad ajeno` (83) siguen fallando, concentrados en la isla ultra
    (U4-U7/SET/OUT/GND en 2 capas a pitch de DFN 0.45-0.5mm).
    kicad-cli DRC: 238 infracciones +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
2026-08-16 Modulo 3 VCO: cuadro 2x2 y ruteo con Freerouting (Tarea 6, ronda 2)
    La causa raiz de la tanda anterior era el desparramo: 4 voces en fila sobre
    240x172 mm dejaban el DAC de tono a 85 mm de la voz mas lejana -- 70% por
    encima de los 50 mm que modela dac_local_budget.LARGO_LOCAL -- y creaban los
    cuellos de ruteo de propina. Aqui las voces van en CUADRO 2x2 con los tres
    DAC y la referencia en el hueco central: las cuatro quedan a la misma
    distancia, el peor par baja a 41.8 mm (37.7 el de U5, el que manda la
    afinacion) y la placa cabe en 114x118 mm, 3.1x menos area. El suelo de
    afinacion pasa de 0.635 a 0.5665 cents contra el limite de 0.7.
    La fila de abajo va girada 180 grados, y no por simetr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
2026-08-16 fix(hw/psu-v2): U6/U7 sin footprint _ThermalVias (0.2mm viola JLC/placa)
    El footprint DFN-12-1EP..._ThermalVias trae vias de 0.2mm de taladro en
    el propio pad del EP, por debajo del minimo de fabricacion JLC de 2
    capas (0.3mm) y de las reglas de la placa. Cambio a la variante sin
    vias (EP1.65x2.38mm, sin sufijo) en bom.csv y build_schematic.py; la
    conexion del EP a -12V9 se resuelve ahora con una via farm manual de
    0.3mm en build_pcb.py, igual que el patron de GND de U4/U5.
    Esquematico regenerado desde build_schematic.py (ERC: 0 errores).
    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
2026-08-16 fix(hw/psu-v2): PCB ruteada en 2 capas -- DRC real en cero, 0 sin conectar
    Ronda 1 sobre el bloqueo previo (238 violaciones / 30 sin conectar):
    la causa era densidad autoinfligida, no falta de capas. Sin tocar el
    requisito de 2 capas:
    - reglas() recalibrada a capacidad real JLC 2 capas: clearance/ancho
    minimo 0.127mm (5 mil), taladro de via minimo 0.3mm. Los minimos
    heredados de v1 (0.25/0.3mm) eran para una placa toda THT y ahogaban
    el escape de los DFN.
    - Segunda autoridad de clearance descubierta y corregida: las netclass
    del .kicad_pro (Default/POTENCIA a 0.25/0.3mm) sobreescribian a
    reglas() por red. Bajadas a 0.127mm; RED_230V se deja en 2.0mm
    (aislamiento de red, sec. seg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
2026-08-16 Modulo 3 VCO: la placa pasa a 4 capas (Tarea 6, ronda 3)
    Ruling del controlador sobre el BLOCKED de la ronda anterior. La evidencia
    de las once configuraciones medidas mostraba que el grafo de esta placa no
    es plano y que en 2 capas la unica capa donde cruzar era el propio plano de
    masa: cada cruce, una ranura. Ni el spec ni ninguna asercion exigian 2
    capas -- era calco de placas mas simples.
    El stackup nuevo:
    F.Cu senal
    In1.Cu GNDA solida, sin una sola pista
    In2.Cu GNDD (la esquina de la isla) + potencia
    B.Cu senal
    Y el presupuesto MEJORA con el cambio, no solo el ruteo: dac_local_budget.py
    modela el camino DAC->VCO sobre un vertido de 20 mm de ancho, y lo que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
2026-08-16 fix(hw/psu-v2): ronda 2 -- Kelvin de -12V roto (critical), anchos, granjas, H4
    Review externo (grafo geometrico de cobre, no solo clearance entre redes
    distintas -- el metodo de la ronda 1 era ciego a fusiones DENTRO del
    mismo net) encontro 1 Critical + 3 Important sobre el ruteo de la ronda 1.
    Critical -- Kelvin de -12V roto: el puente que yo mismo agregue en ronda 1
    para cerrar un "unconnected" (48,153)-(60,153) unia la rama de potencia
    (tunel de R17/R18) con la de sense (bus Kelvin de U6.10/U7.10 OUTS) ANTES
    de J2.1 -- exactamente lo que el Kelvin prohibe. Se borra el puente; la
    rama de potencia gana un tap propio a J2.1 (x=60, sobre su hub de y=178),
    espejo exacto de como +12V entra a J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
2026-08-17 fix(hw/psu-v2): ronda 3 -- F2 piso 0.5mm en potencia -12V, F3 granjas EP U6/U7
    Correccion de proceso primero: SS10.2 (ronda 2) afirmaba anchos que no
    coincidian con la placa real -- el orquestador midio y encontro 34.57mm
    a 0.25mm donde yo describia "un cruce fino de ~1.8mm", y un tramo que
    reportaba "sube a 1.5" estaba en realidad a 0.5mm de punta a punta. De
    ahora en adelante cada numero del reporte va con el script que lo midio
    y su salida pegada (ver task-8-report.md SS11.1).
    F2 -- ruling nuevo (sustituye el ">=1.5 blanket" de ronda 2): piso duro
    de 0.5mm en TODA la rama de potencia de -12V (R17.2/R18.2 -> J2.1), el
    0.25mm desaparece por completo, y >=1.5mm donde el corredor real lo
    per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
2026-08-17 Fab v2: gerbers, pos y BOM de ensamblaje JLC
    Task 9 pipeline: 16 filas SMD con códigos LCSC (U4-U7, D8-D11, R9-R18,
    C15/C16/C19-C26), gerbers + drill + pos + BOM JLC, fab/README.md (NO listo
    para pedir, 3 puertas abiertas), .gitignore actualizado para v2/fab/.
    Verificaciones:
    - Todos los códigos LCSC de §2 design-notes.md aplicados exactos
    - bom_jlc.py genera 16 líneas (R9/R10 fallback C114524 anotado)
    - Coherencia pos/BOM: 28 SMD en BOM vs 72 líneas pos (44 THT ignoradas por JLC)
    - .gitignore ignora el zip con patrón hardware/**/fab/*-jlcpcb.zip
    Estado: NO listo para pedir (puertas: medidas mula, stock LCSC, rotaciones DFN).
    Cl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
2026-08-17 Fix Task 9: codigos LCSC inventados de R11-R14 (R_ILIM) reemplazados
    El task review encontro que R11/R12 (C17590) y R13/R14 (C25709) en
    hardware/01-power-supply/v2/bom.csv eran codigos LCSC inventados que no
    correspondian a las piezas reales (270R 0805 y 75k 1210, no las R_ILIM
    374R/9.31k 0603 del LT3045/LT3094). Verificados en vivo contra
    lcsc.com/product-detail/: R11/R12 -> C23149 (UNI-ROYAL 0603WAF3740T5E,
    374R 1% 0603, 9800 u.), R13/R14 -> C23126 (UNI-ROYAL 0603WAF9311T5E,
    9.31k 1% 0603, 2200 u.). design-notes.md SS2.4 gana las dos filas que el
    Step 4 de stock original nunca coto. bom-jlc.csv regenerado.
    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
2026-08-17 Modulo 3 VCO: costuras de masa reservadas y In2 protegida (Tarea 6, ronda 4)
    Las 8 conexiones abiertas de la ronda anterior eran todas pads de masa, y
    quedan cerradas por los dos caminos que autorizo el controlador.
    COSTURAS_RESERVADAS: siete vias de masa que el script coloca ANTES de
    rutear, con el motivo de cada una escrito al lado. Son los pines 20 de los
    cuatro QFN (costado derecho, con un vecino de otra red a 0.4 mm por arriba y
    otro por abajo, y el desacoplo de +5V cerrando el pasillo) y los pines 4 de
    los tres TSSOP (hueco de 1.45 mm contra su propio desacoplo). La clave es el
    orden, no la coordenada: puestas antes, el router las ve como obstaculo y da
    la vuelta; puestas despues no h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
2026-08-17 fix(hw/psu-v2): ola review fase C -- silk BR1/TP/J2/U2, pads U1/U2 anchos, Val real en pos.csv
    F1: marca "+" real junto al pad 1 de BR1 en F.SilkS (la huella stock es
    simetrica, no traia cruz). F2: 16 textos libres de serigrafia que la placa
    no tenia -- titulo+rev, señal de cada TP (leida del netlist real), aviso
    "U2 TAB = VRAW- MICA" junto a su disipador, y polaridades de J2 (orden real
    del netlist: -12V/GND/GND/+12V, no el orden intuitivo). F3: pads THT de
    U1/U2 ensanchados a 1.4x1.8mm -- resuelve (no bendice) las 10 violaciones
    annular_width que traia el DRC. F4/F5: documentacion en fab/README.md
    (vias de EP abiertas en pasta) y design-notes.md §3.2 (asimetria termica
    intra-pareja de la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
2026-08-17 Validacion v2: protocolo de la mula, bring-up y puertas como issues
    Agrega §4 (protocolo de medidas) y §5 (bring-up escalonado) en design-notes.md v2,
    con suelos útiles del trimmer (12.46 V / -12.42 V) citando §1.5.1. Actualiza
    README v2 con estado "diseño completo; pendiente de mula y stock", arquitectura
    y tabla de docs. Crea 6 issues (56-61): medidas de mula, stock LCSC, LNA, modules
    2-7, SMPS/USB-MIDI, y F1 v1 de v1 (bonus: F1 de 250 mA vs trafo de 120 VA).
    Fase D, cierre del plan.
    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
2026-08-17 Fix round 1 Task 10: cifras inventadas en README v2 + criterio de bring-up copiado de v1
    Critical: ruido de salida (8/10 uVrms) y drift termico (<50 ppm/C) del README
    eran cifras sin fuente real; se reemplazan por el objetivo 0.8 uVrms (spec S11.7,
    no presumible hasta medir con LNA) y por los dos escenarios reales de drift de
    S2.4 (~100 ppm/C con R_SET fallback en stock, ~25 ppm/C con el 0.1%/25ppm
    pendiente). El paso 6 del bring-up (design-notes S5) citaba el criterio de
    aceptacion de la v1 (1 MHz BW, <10 mVpp) atribuido a spec S10.4; se corrige a
    20 MHz BW (coherente con S4 filas 1 y 3) y al criterio real sin umbral fijo.
    Minors: la tabla de docs del README apuntaba a pcb/renders/ (no exi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
2026-08-17 Modulo 3 VCO: los escapes explicitos se miden y se descartan (Tarea 6, ronda 5)
    El controlador autorizo escribir escapes explicitos (pin -> via, cortos,
    antes del ruteo, protegidos en el DSN) para el abanico del costado derecho
    de los QFN, con la misma filosofia que las siete costuras de masa. Lo
    implemente tal cual y lo medi en dos variantes. Sale peor, consistente:
    sin escapes de senal (cinco corridas): 4, 5, 8, 9, 10 abiertas
    + 20 escapes (pines 2,3,4,21,22), protegidos: 16
    + 8 escapes (solo 21 y 22), protegidos ronda 1: 12
    revertido a solo costuras de masa (comiteado): 11
    Las dos variantes de escape quedan por debajo del PEOR sorteo del baseline,
    asi que no es mala suert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
2026-08-17 Modulo 3 VCO: el fanout completo se mide y no entra en 0.4 mm (Tarea 6, ronda 6)
    El controlador adjudico el fanout completo -- una via de escape por pin, en
    coronas escalonadas alrededor de los cuatro QFN, colocado antes de rutear --
    razonando que a medias hace dano (que es lo que demostro la ronda 5) y
    entero es el estandar para 0.4 mm. Lo implemente entero y lo medi. Choca con
    dos muros y los dos son aritmetica:
    NO CABE. Para que el rabito de un pin pase al lado de la via de su vecino
    hacen falta VIA_D/2 + CLEARANCE + ANCHO/2 = 0.55 mm, y el paso del QFN es
    0.40. Faltan 0.15. Al reves: la via mas gorda que dejaria pasar al vecino
    mide 0.30 mm de diametro, o sea taladro laser y proceso HDI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
2026-08-17 Modulo 3 VCO: reglas a la capacidad real del fab, y la placa CIERRA (Tarea 6)
    0 conexiones abiertas y DRC 0. Con todos los demas gates en verde: In1 en
    UNA sola isla al 100.00%, costuras de masa cerradas, frontera 3.00 mm, los
    4 EP aislados, DAC->VCO 43.2 mm, desacoplos a 1.80 mm. El recorrido de la
    tarea fue 165 -> 18 (2 capas) -> 8 -> 11 -> 0.
    Las dos "paredes aritmeticas" que declare en la ronda 6 eran de MIS reglas,
    no del fabricante. Via 0.6, margen 0.15 y pista 0.2 venian heredadas del
    modulo 2 -- una placa de dos capas con componentes de paso ancho -- y nunca
    les volvi a preguntar nada. Calcule bien y verifique mal: la formula
    VIA_D/2 + CLEARANCE + ANCHO/2 = 0.55 > 0.40 era correcta,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
2026-08-17 Modulo 3 VCO: vias fuera de los pads, serigrafia legible y U13 con los osciladores
    La placa de la tanda anterior pasaba el gate porque el gate no miraba. Con
    hole_to_hole y holes_co_located en la severidad que les corresponde, aquella
    placa tiene 33 infracciones: 15 vias taladradas DENTRO del agujero de un jack
    o de un conector (solapes de -0.81 mm, la broca pasando dos veces por el mismo
    punto), 32 vias debajo de un pad SMD, y 3 parejas de vias por debajo del
    minimo de taladro a taladro, una a 0.0000 mm.
    El origen eran tres cosas y solo dos estaban a la vista. coser_masas() probaba
    el CENTRO DEL PAD como primer sitio para la via. lejos() se salta el cobre de
    la propia red -- correcto para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
2026-08-17 Modulo 3 VCO: salidas de fabricacion para JLCPCB (Tarea 7)
    Gerbers (4 capas: F.Cu/In1.Cu-GNDA/In2.Cu/B.Cu + mascaras + serigrafias +
    Edge.Cuts), taladros Excellon y posiciones SMD generados con kicad-cli desde
    el .kicad_pcb committeado (DRC 0, Tarea 6). BOM de ensamblaje estilo JLC
    generado cruzando bom.csv contra las posiciones reales (25 lineas, 111
    huellas SMD), con LCSC Part# vacio a proposito.
    README documenta el camino del SSI2130 (proveedor unico: consignado o
    soldado en casa con stencil) y que las reglas de fabricacion ya estan en el
    punto de capacidad estandar de JLCPCB sin recargo (via 0.45/0.20).
    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
2026-08-17 Modulo 3 VCO: fixes de revision a las salidas de fabricacion (Tarea 7)
    Mapa de taladros (kicad-cli --generate-map, PDF): el despacho lo pedia
    explicitamente y se habia omitido por precedente de otros modulos, que no
    aplica a esta tarea. README: corrige la contradiccion sobre los conectores
    through-hole (J1, J2, los 8 jacks) -- no los monta la fabrica, llegan sin
    montar porque pos.csv es --smd-only y no trae sus posiciones; se sueldan a
    mano por ser piezas de panel. Documenta el porque de --no-x2 (RS-274X plano,
    sin atributos de red embebidos) separado de la extension Protel por capa
    (default de kicad-cli, sin flag).
    Claude-Session: http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
2026-08-17 Modulo 3 VCO: el bring-up con la placa en la mano, y los docs a la realidad (Tarea 8)
    notes/bring-up.md es el documento que decide si las apuestas del diseno
    aguantan. Diez pasos, cada uno con su valor esperado y sus modos de fallo:
    rieles y VREF, I2C (identidad + temperatura), el passthrough de 72 bits de
    la cadena DCEN (bloqueante, spec par.11.7), apagar las referencias internas,
    el span por voz (la apuesta trimless, spec par.11.2), el resto del audio,
    autoafinado, el primer registro termico y la diafonia del mazo (par.11.8).
    Tres cosas que salieron de releer la placa y no estaban en el plan:
    1. EL ORDEN DE MONTAJE DECIDE QUE SE PUEDE ROMPER. Un riel de +5V que se
    vaya a 12 se lleva l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
2026-08-17 Modulo 3 VCO: la referencia al bodge apunta al Paso 5, no a un "par.5"
    El bring-up numera sus secciones de dos formas -- "Paso N" para el
    procedimiento y "par.N" para las de apoyo (hoja, indice de fallos, dudas) --
    y el README apuntaba al bodge de R_PITCH como "par.5", que es una seccion
    que no existe.
    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
2026-08-17 Modulo 3 VCO: los cuatro flecos de la revision de la Tarea 8
    1. La distancia U11->U13 del Paso 1 la habia puesto a ojo. Recalculada de las
    coordenadas committeadas -- U11(84,98) a U13(32,86) -- son 53.4 mm, no 57.
    Importa porque es el argumento de que el calor del 78L05 no contamina la
    medida del termometro en el Paso 7: el numero tiene que salir de la placa,
    no de mi cabeza.
    2. Fuera el hedge de los comandos del AD5686R. Marque 0011/0110/0000 y el
    direccionamiento one-hot como "convencion de la familia, contrastalo antes
    de teclearlo" porque no tenia el PDF delante; la revision los verifico
    nibble a nibble y los cinco estan bien. Cada fila cita ahora su tabla
    (ad568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
2026-08-17 La v1 no se construye: la v2 se ajusta contra sus propias medidas
    La v1 era la mula contra la que se iban a congelar los setpoints antes de
    fabricar la v2. Se cancela: se va directo a la v2 y RV2/RV3 se ajustan en
    sitio durante el bring-up. Eso quita la puerta que bloqueaba el pedido y
    deja las dos que quedan (stock LCSC, rotaciones de DFN) dentro del propio
    flujo del pedido.
    Lo que la decision mete en la mesa de pruebas, y por eso es lo mas
    importante de este commit: notes v2 §4.1 calcula el UMBRAL DE ABORTO
    encadenando los dropouts garantizados de §1.5 y §1.5.1 --
    valle_min = 12.000 (Vout) + dropout_max(LT) + ballast + dropout_max(pre-reg)
    positivo: 12.000 + 0.450 + 0.007 + 1.000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
2026-08-17 Modulo 3 VCO: los docs de arquitectura cuentan la realidad (Tarea 9)
    architecture-poly.md sincronizado con el spec, el README y el bring-up del
    modulo 3 ya diseñado, verificado (ERC 0, DRC 0) y con salidas de fabricacion:
    SSI2130 en vez de CEM3340 en el diagrama y en el §10, mazo J2 de 12 hilos
    (SERIE + TUNE_OUT en el mismo IDC 2x6, direccionamiento del #34 cerrado), la
    tabla de consumo de §9 con el modulo 3 real (~35 mA, no los 80 mA de la
    tesis) y el total recalculado, y §11 con el AD5686R encadenado ahora
    bloqueante, el conteo de CV resuelto para el modulo 3, el #34 marcado
    CERRADO y la apuesta trimless como riesgo nuevo.
    El spec corrige la frase sobre el EP del SSI2130: va aislado,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
2026-08-17 Modulo 3 VCO: fixes de revision a la Tarea 9 (coherencia en secciones vecinas)
    architecture-poly.md §8 corrige "cada placa usa la referencia interna de su
    DAC / el BOM exige AD5686RB", que quedo falso tras el diseño real: el modulo
    3 usa una ADR4525BRZ dedicada compartida por los 3 DAC y los 4 osciladores,
    con las internas apagadas por firmware. El principio (la VREF no cruza el
    bus) se mantiene; lo que cambia es que como se materializa queda a criterio
    de cada placa.
    §11 item 2 (consumo de 20 mA por CEM3340) quedo huerfano al quitarse esa fila
    de §9 en la tarea anterior — reencuadrado como nota historica explicita,
    obsoleta desde el SSI2130.
    §4, fila SERIE: media linea presentando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
2026-08-17 Puerta de stock cerrada y R_SET decidido: la v2 queda pedible
    Puerta 2 de fab/README (stock LCSC del dia de mandar): los 10 codigos del
    BOM de ensamblaje verificados en vivo uno por uno en
    lcsc.com/product-detail/, con valor, tolerancia y package confirmados en la
    ficha -- no supuestos. Los 10 con stock. Tabla completa en notes §2.6.
    El mas ajustado es el shunt C6920584 (1.000 u., Basic, 4 por placa): da
    para 250 placas, pero es el unico que conviene re-mirar si pasan dias.
    R_SET -- se cierra la accion que §2.4 dejo abierta ("re-intentar buscar el
    0.1%/25ppm antes de comprar"), y el resultado es DESCARTARLO. Faltaba un
    numero del propio chip. Leido verbatim del DS del LT3045 (Farnell
    2163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
2026-08-17 Modulo 3 VCO: ola de fixes final de la revision de rama completa
    - pcb/README.md: quita el enlace a .superpowers/sdd (gitignorado, rompia
    markdown-link-check); remite al docstring de build_pcb.py, que cuenta la
    misma historia y si esta versionado.
    - build_pcb.py: el DRC del gate ahora corre con --severity-all (sin el, el
    informe solo traia errores y la guarda de text_height/text_thickness era
    codigo muerto). El unico aviso esperado -- isolated_copper del vertido
    termico sin red de U13 -- se excluye nombrandolo; cualquier otro aviso
    tumba el gate. Verificado corriendo el DRC actualizado a un temporal
    fuera del repo: 1 isolated_copper (el vertido de U13), 0 de mas.
    - spec: cierra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
2026-08-17 Renders del modulo 3: como se vera la placa, en pcb/ como el modulo 1
    Dos renders 3D (cenital e isometrico, raytracing de kicad-cli), las vistas
    2D por cara y el PDF de las 4 capas — el mismo juego que ya tiene la
    fuente. Generados de la placa committeada, sin tocarla, y anotados en la
    tabla de ficheros del README.
    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
2026-08-17 CPL para JLC: el pos.csv crudo de KiCad no lo acepta
    Sale del pedido real del 2026-08-17. Subimos gerbers, BOM y pos.csv; el BOM
    paso limpio y el CPL murio con "Failed processing the CPL file".
    Causa: kicad-cli exporta las cabeceras de KiCad
    (Ref,Val,Package,PosX,PosY,Rot,Side) y JLC quiere las suyas
    (Designator,Mid X,Mid Y,Layer,Rotation). Y no basta con renombrar: con
    "top" en minuscula y 6 decimales el parser sigue devolviendo un error
    generico. El formato que sí traga es el del sample publicado -- Layer
    capitalizado, coordenadas cortas en mm sin sufijo, rotacion sin decimales.
    cpl_jlc.py hace la traduccion y ademas filtra a los 28 designadores del BOM
    de ensamblaje: el CPL solo descri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
2026-08-17 El BOM del modulo 3 deja de ser una lista de deseos: 23 de 26 con stock real
    Verificado pieza por pieza contra la libreria de ensamblaje de JLCPCB el
    2026-08-17, no contra memoria. Cada linea lleva su MPN, su stock y la fecha.
    El matcher automatico de JLC proponia cinco cosas que habrian pasado calladas:
    3.9nF en X7R donde el datasheet exige C0G (el tempo derivaria con la
    temperatura y el modulo desafinaria solo), 220k donde va un 20k, 16.5k y 499k
    en huella 0402 sobre pads de 0805, y ningun match para un 270R que si existe.
    Ninguna de las cinco rompe un test; todas rompen la placa.
    R_LIN pasa de 499k a 510k. El datasheet pide 499k y ese valor no existe en
    0805 en el catalogo de JLC -- ni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
2026-08-17 Revierte el 510k: el 499k del datasheet SI esta en stock, lo lei mal
    El commit anterior cambio R_LIN de 499k a 510k con el argumento de que el
    499k no existia en 0805 en el catalogo de JLC. Es falso: C17721 (UNI-ROYAL
    0805W8F4993T5E) tiene 115981 unidades. Lo mismo con las otras dos lineas que
    di por perdidas -- 16.5k es C35929 (4749) y 4.02k es C17663 (31954).
    La causa: capture las tres paginas del buscador a medio cargar. La seccion
    "In stock Parts" todavia no habia pintado y la pestaña "Consign Parts" era
    lo unico visible, asi que lei "no hay stock" donde decia "aun no cargo".
    El razonamiento sobre el datasheet era correcto y sigue anotado por si algun
    dia hace falta mover el valor de v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
2026-08-17 Los SSI2130 se sueldan a mano: el camino consignado resulto imposible
    El plan decia "consignado o a mano" como si fueran dos opciones. Probado
    contra el pedido real del 2026-08-17, el camino consignado NO existe por la
    via facil, y el camino a mano es mas facil de lo que decia el documento.
    Lo que se aprendio pidiendo de verdad:
    1. El flujo de ensamblaje de JLCPCB rechaza de plano las piezas sin stock.
    La fila del SSI2130 sale como "8 shortfall" y pide una alternativa EN
    STOCK -- que siendo proveedor unico no existe. C42420746 (Sound
    Semiconductor, min 1) sirve para comprarlo suelto, no para montarlo;
    C2886621 tiene MOQ 75.
    2. Consignar no es meter los chips en un sobre: es un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
2026-08-17 Case: la silueta pasa a triangulo modernista, y tres fallos de raiz que salieron por el camino
    La silueta del costado se rehizo entera sobre renders sucesivos. Deja de ser
    una bota escalonada y pasa a ser un triangulo rectangulo con la hipotenusa
    quebrada en dos tramos y el valle en medio:
    ancho 500 fondo 310.1 alto 269.6
    cara de abajo 55 grados desde la horizontal (35 desde la vertical)
    cara de arriba 45 grados (coincide en las dos convenciones)
    valle 80 mm marco de remate 22 mm
    Cambios de estructura, no solo de cotas:
    - prof_superior SE ELIMINA. Eran dos fondos (350 y 250) con una repisa
    escalonada entre ellos, y esa repisa era justo lo que rompia la lectura de
    triang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
2026-08-17 Spec del nucleo digital: un modelo de parametros, N pieles
    El modulo 2 quedo obsoleto por tres decisiones posteriores (la computadora
    se va fuera, los DAC se mudan a los modulos, la cabeza se vuelve minima mas
    pantalla inalambrica). Esta spec no lo rutea: lo reemplaza.
    La observacion que la ordena: pantalla, VST, presets, MCP y agente piden
    todos lo mismo -- ver y cambiar el estado del instrumento. Asi que el
    instrumento expone UNA cosa, un espacio de parametros direccionable y
    auto-descriptivo, y los demas son clientes. "Control por MCP" deja de ser
    un subsistema y pasa a ser un adaptador.
    Lo que se congela aqui:
    - Direccionamiento de 16 bits (ranura/instancia/indice) y valores de 32 bit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
2026-08-17 Case: cara y panel dejan de ser el mismo numero, y EUROrack pasa a verde
    La puerta de EUROrack estaba roja porque `alto_panel_inf` hacia dos trabajos
    a la vez: era el tramo del perfil del costado Y el alto de la PCB. Con los
    dos valiendo 128.5 y los railes a inset 27 de cada punta, los railes
    quedaban a 74.5 mm y un modulo 3U no atornillaba.
    Se separan:
    alto_cara_* el tramo del perfil. Dibuja la silueta y sujeta los railes.
    alto_panel_* la PCB de aluminio. Es lo unico que ve el fabricante.
    En el piso de arriba coinciden (el panel cubre la cara entera; hay un assert
    que lo exige). En el de abajo ya no pueden, y la cara se dimensiona DESDE el
    estandar en vez de al reves:
    alto_cara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
2026-08-17 Case: la primera seccion baja al suelo real, que estaba a 2.4 mm
    Samuel pidio reducir la primera seccion al maximo que permita EUROrack. Se
    midio contra las tres cotas que la limitan en vez de estimarla, y el suelo
    resulto estar mucho mas cerca de lo que parecia.
    alto_frontal 30 -> 28
    inset_tornillo 27 -> 26.5
    alto_cara_inf 164.5 -> 164.0 (derivado)
    sep_railes_sup 136 -> 137 (derivado del inset nuevo)
    primera seccion (suelo -> valle) 164.8 -> 162.4
    alto total 299.1 -> 296.7
    Los dos parametros del frente se optimizan JUNTOS, y ese es el nudo: la
    altura de la seccion vale alto_frontal + alto_cara_inf*cos(35), y como
    alto_cara_inf lleva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
2026-08-17 Spec del nucleo digital: verificados los ocho puntos, y el instrumento se escucha
    Segunda pasada sobre la spec, con los ocho puntos abiertos investigados de
    verdad y tres capacidades nuevas que salieron de la conversacion.
    VERIFICADO (§11)
    Cinco resueltos a favor, y dos regalan cosas que este proyecto queria:
    - MIDI 2.0 en el host esta maduro. Windows MIDI Services ya enviado con
    driver de clase USB MIDI 2.0 y UMP nativo; todos los DAW grandes con
    implementacion. Y Logic 10.6+ YA renderiza controles desde Property
    Exchange y guarda la configuracion en el proyecto -- que es el "recall
    total con el proyecto" que motivaba el VST, gratis del estandar.
    - Webview en plugin: resuelto y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
2026-08-17 Case: la fila de arriba tambien pasa a 3U, y los insets se vuelven cuatro
    Samuel pidio el mismo tratamiento en la seccion de arriba. Apretar sus insets
    no le quitaba ni un milimetro -- su cara la fijaba el panel de 190, no el
    estandar --, asi que el "mismo tratamiento" solo significa una cosa: que esa
    fila sea EUROrack de verdad y se dimensione desde la cota, como la de abajo.
    alto_panel_sup 190 -> 128.5 (PCB 3U, igual que la de abajo)
    sep_railes_sup 137 -> 122.5 (el estandar)
    alto_cara_sup 190 -> 170.0 (DERIVADO: 122.5 + 24.5 + 23)
    alto total 296.7 -> 282.5
    fondo 331.8 -> 317.6
    CUATRO INSETS, uno por punta de cara. Habia un `inset_tornillo` que servia
    para todo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
2026-08-17 Resueltas las cuatro fricciones, y dos resultaron ser la misma pieza
    UMP (§4.4): la friccion se disuelve con dos hechos verificados.
    Property Exchange usa SysEx estilo MIDI 1.0 "por MIDI 1.0 o por MIDI 2.0",
    y los mensajes MIDI-CI son retrocompatibles con v1 -- tecnicamente son
    solo System Exclusive. O sea: el descriptor, el descubrimiento y el puente
    MCP funcionan enteros SIN UMP. UMP compra resolucion de 32 bits en datos
    de interpretacion, que no esta en el camino critico de nada.
    Y el propio USB define la escalera: alt setting 0 = MIDI 1.0, alt setting
    1 = MIDI 2.0. Anadir el 1 despues no es reescribir, es lo que la
    especificacion espera. No era bifurcacion, era escaler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
2026-08-17 El analisis se muda al modulo 4, y el cerebro recupera los puertos que le faltaban
    CORRECCION DE MI PROPIA SPEC (§7.4)
    La version anterior mandaba una linea analogica diferencial del mixer a un ADC
    en el cerebro. Estaba mal, y era el UNICO sitio de todo el diseno que rompia
    la regla que el resto cumple sin excepcion: "por el cableado viajan numeros,
    no voltajes". La defensa que traia -- "es una toma de medida, no un camino de
    audio" -- es cierta pero es una racionalizacion: explicaba por que el dano
    seria pequeno, no por que habia que hacerlo.
    La version correcta: medir y atribuir son trabajos separables y cada uno quiere
    un sitio distinto.
    MODULO 4 tiene el audio -> mide (FFT, banda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
2026-08-17 Se me escapo una segunda instancia del corte compartido del modulo 5
    El PR #82 corrigio el diagrama de bloques (§3) pero dejo la descripcion del
    modulo 5 en §11 diciendo "corte y resonancia comunes". Misma frase, mismo
    error, otro sitio -- y esa es la que va a leer quien se siente a dibujar la
    placa.
    Las PERILLAS siguen comunes, que es el principio §1 del documento entero. Lo
    que va por voz es el CV de corte: sin eso MPE es imposible, porque mover el
    timbre de una nota moveria las cuatro.
    Encontrado verificando el merge, no despues.
    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
2026-08-17 Case: la pestana superior, que es la pieza que faltaba para que el panel no remate pelado
    Samuel: "en el render no veo esa pestana ... quiero un top marco acrilico, que
    no quede pelado el panel en el top". Tenia razon y el error era mio de bulto:
    marco_remate pertenece al COSTADO, o sea que solo existe en los dos laterales y
    no cruza el ancho. Ponerlo a 8 no podia hacer aparecer ninguna banda arriba.
    Lo que hacia falta es una pieza nueva, marco_sup: banda de acrilico de 484 x 8
    que va sobre los ultimos 8 mm de la cara superior, de costado a costado, con su
    cara exterior a ras (no en resalte). Los dos numeros valen 8 = t_cheek, asi que
    juntos envuelven la punta de arriba en L y el remate se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
2026-08-17 El plan del nucleo, partido donde la spec ya lo tenia partido
    La spec par.8 lista el alcance del firmware de validacion y ese alcance se
    divide solo en dos: lo que se prueba con `cargo test` en esta maquina, y lo
    que necesita una placa RP2350 que todavia no existe. Casi todas las filas de
    par.9 ya decian "tests en host, Rust puro".
    Este plan es la mitad de arriba: modelo, descriptor, protocolo, SysEx, trama
    del J2, descubrimiento, partes, presets, el motor de perturbacion y la
    atribucion. Catorce tareas, todas verdes sin tocar hierro. El bring-up va en
    su plan y abre issue al cerrar este.
    Tres decisiones que la spec dejaba abiertas quedan escritas para poder
    discutirlas: fuera de rango se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
2026-08-17 Alcance total exige contencion real, y la impone el micro
    confirmar() salta lo vencido pero NO lo tira: eso se queda para que caducar()
    lo anuncie con RESOLVED{confirmado:false}. La primera version lo descartaba
    en silencio y un token podia morir sin que ningun cliente se enterara.
    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
2026-08-17 El patch es un dato: el preset guarda hasta cuanto atenua cada cable
    Recall total es mentira en cualquier modular del mundo porque el patch es
    fisico. Aqui deja de serlo: el preset lleva los pares origen->destino, y
    gracias al motor de par.7.6 tambien la atenuacion, asi que guarda
    'VCO1 -> CV del VCF1, atenuado al 40%' en vez de solo la conexion.
    Una revision mas nueva de un modulo sirve; una mas vieja se avisa. Y cuando
    falta un modulo el error NOMBRA cual: un mensaje que no lo nombra no sirve
    de nada.
    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
2026-08-17 Dos funciones sin probar se vuelven un componente con un test
    El barrido de topologia (par.6.2) y la sonda causal de la atribucion (par.7.2)
    parecian problemas distintos. No lo son: los dos preguntan cual de las N
    causas que controlo produjo el efecto que observo, y los dos se responden
    perturbando y correlacionando.
    Codigos de Walsh, no deteccion de escalon. Atraviesa un atenuador al 5 %,
    MIDE cuanto atenua, y corre todas las fuentes a la vez. La fila 0 se salta
    porque es continua y un camino acoplado en AC no la pasaria — hay un test
    que lo exige.
    Y no adivina en silencio: probado subiendo la regla de ambiguedad a cero, los
    dos tests que exigen 'declaralo ambiguo en vez de inventar' ca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
2026-08-17 Atribuir con confianza: un agente que recibe certezas fabricadas arregla el sonido equivocado
    El decaimiento armonico es suave A PROPOSITO. Con 110 y 220 Hz sonando, un
    pico en 440 es el 4.o de una y el 2.o de la otra: musicalmente no se puede
    distinguir, asi que castigar los armonicos altos daria una respuesta segura
    y falsa. El test lo exige — y tambien lo exige para el unisono desafinado,
    que es el caso mas comun de todos.
    Ambiguo tiene definicion, no criterio de barra: si la primera no se separa
    de la segunda por el margen, es ambigua, y sonda_sugerida dice que dos voces
    perturbar. De ahi en adelante es el motor de par.7.6.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
2026-08-17 El plan del binario, y un hueco del protocolo que aparecio al escribirlo
    Al ir a diseñar el servidor salio que la tabla de mensajes de par.4.1 deja al
    cliente en silencio en tres casos: HELLO no tiene respuesta, DESCRIBE no tiene
    forma de contestar, y todo SET rechazado —solo lectura, fuera de rango, no
    existe— se queda dentro del micro. El tercero es el peor modo de fallo del
    diseño entero: el agente escribe, no pasa nada, y no sabe por que.
    Por par.2.1 eso no se arregla con una convencion por fuera, se arregla
    creciendo la tabla. Dos mensajes (HOLA y ERROR) y una respuesta que no es
    mensaje (el volcado del descriptor, que no cabe sin darle vida al enum).
    El plan son seis tareas y N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
2026-08-17 Un protocolo sin mensaje de error deja al agente esperando en silencio
    La tabla de par.4.1 dejaba al cliente sin respuesta en tres casos: HELLO —que
    la propia tabla llama negociar version— no tenia respuesta, DESCRIBE no tenia
    forma de contestar, y todo SET rechazado se quedaba dentro del micro.
    El tercero es el peor modo de fallo del diseño entero. Un agente que escribe
    un parametro de solo lectura no recibe nada: no sabe si llego, si se aplico,
    o si el instrumento se colgo. Y par.2.1 dice que eso se arregla creciendo la
    tabla, no inventando una convencion por fuera.
    HOLA (0x87) y ERROR (0x88, con sus siete codigos). El volcado del descriptor
    NO entra como mensaje: es de largo variab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
2026-08-17 El bucle de USB: cuatro pasos, y los cuatro ya venian probados
    paquete -> Desempaquetador -> desenvolver -> decodificar -> atender, y de
    vuelta. La capa no lleva un solo test propio porque cada paso ya vino verde
    en core: eso era el punto de tenerla delgada.
    Tres cosas que la documentacion publicada corrigio sobre lo que el plan
    suponia: la feature del executor es platform-cortex-m, el token de una tarea
    en embassy 0.10 viene envuelto en Result, y MidiClass::new pide el numero de
    jacks de entrada y salida.
    El descriptor se manda de a un sobre por parametro y no todo junto: mantiene
    los buffers pequeños y deja que el cliente empiece a parsear antes de que
    termine — con 27 medidas ya se n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
2026-08-17 El plan del tiempo musical, y una cuenta que corrige la spec
    Nueve tareas sobre software/nucleo/core, todas funciones puras del tiempo: el
    tiempo entra como argumento, nunca se lee de un reloj. Eso las deja
    verificables enteras con cargo test, que es lo unico que se puede hacer sin
    Y al escribir la Task 2 salio que la spec par.3.6 se equivoca. Dice que el MIDI
    clock "necesita un lazo de enganche, y es trabajo real que hay que
    presupuestar". Se hizo la cuenta contra el objetivo de par.9 —+-2 ms de jitter,
    la lectura no se mueve mas de +-0.1 BPM— y un promedio movil sobre intervalos
    consecutivos NO LLEGA ni con una constante de 21 segundos, mientras que medir
    contra el pulso de hac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
2026-08-17 No reinventar el decodificado de MIDI: entra wmidi
    Buscado en crates.io antes de escribir el reloj. wmidi 4.0 es no_std, sin
    asignaciones al parsear, realtime-safe y de RustAudio — y trae TimingClock,
    Start, Stop, Continue y SongPositionPointer con el tipo de 14 bits ya
    ensamblado. Hacerlo a mano son treinta lineas de emparejar bytes de estado y
    armar enteros de dos septetos, que es justo donde se cuela un error silencioso.
    Comprobado que compila para thumbv8m.main-none-eabihf y para wasm32, que es lo
    que de verdad demuestra que es no_std.
    Y tres que NO entran, con su motivo, porque 'no reinventes' no es 'mete
    cualquier cosa': music-timer es 0.1.6 con callbacks y la rejilla tiene
    semanti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
2026-08-17 El tempo no pide un PLL, pide una base mas larga — y el techo sale de lo que cuesta
    Promediar intervalos consecutivos reduce el ruido con raiz de alfa; alargar la
    base lo reduce con N. Un EMA no llega ni con tau de 21 segundos; medir contra
    el pulso de hace 96 si. Buffer circular y resta. La spec par.3.6 pedia un lazo
    de enganche y queda corregida.
    Y el test cayo en 227 milesimas contra las 100 que pedia la spec — fallo mio,
    no del codigo: derive la DESVIACION TIPICA y el test mide el PEOR CASO, que se
    llevan un factor de tres.
    La respuesta correcta no era apretar N hasta que pasara. Era preguntar QUE
    CUESTA ese error: mientras llegan pulsos la fase la manda el pulso, no la
    estimacion,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
2026-08-17 Case: el riel es el Z-Rail de Tiptop, y estaba dibujado contra otro
    Samuel confirmo que compra los Z-Rails de Tiptop. El case estaba dimensionado
    contra los planos de StudioRacks, que es OTRO perfil. Las cotas salen ahora de
    la hoja de datos oficial de Tiptop (tiptopaudio.com/manuals/z-rails.pdf,
    seccion A "PROFILE"), leida del dibujo acotado.
    rail_er_fondo 27.4 -> 23.8 el de StudioRacks era 3.6 mm mas hondo
    rail_er_eje 13.7 -> 14.3 la hoja lo acota 9.5 al canto de detras
    rail_er_alto 10.0 -> 10.0 lo unico que coincidia
    sep_railes 123.0 -> 122.5
    inset_er 2.75 -> 3.0
    El margen que habia para ese error era +0.50 mm en el fondo y +0.25 en el eje.
    Con el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
2026-08-17 Case: la hoja de Tiptop pone en duda los M3 de la pestana
    El Z-Rail es un extruido de pared fina: 1.2 mm en casi todo el contorno, y lo
    unico macizo es el nucleo por donde pasa el M4 de punta. La pestana se apoya de
    canto en la cara ancha del riel y se atornillaba con cinco M3 de 6 mm a esa
    cara -- que con esta seccion probablemente atraviesen pared y salgan al hueco.
    Eso se penso contra el riel de StudioRacks. Cambia el plan por defecto, no la
    geometria: el apoyo a tope se queda igual y pasa a ir PEGADO. Son 60 g de
    acrilico y la junta trabaja a cortante, no a traccion. Los M3 vuelven solo si
    el calibrador encuentra material.
    Sin cambio dimensional: clearance_budget VERDE, check_dxf VERDE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
2026-08-18 Los STL de render salen del control de versiones (cierra #48)
    6,6 MB que cambian enteros cada vez que se mueve un milimetro, y que no aportan
    nada que el .scad no tenga. La ultima tanda del case metia 387.721 lineas de
    diff y 281.546 eran estos dos ficheros: un PR asi no se revisa, se aprueba a
    ciegas.
    Opcion (a) de las dos que planteaba el issue: destrackear. Son regenerables con
    cad/export.ps1 y quien quiera el STL lo exporta.
    Y el ignore pasa a ser EXPLICITO. Ya los alcanzaba el `build/` generico de la
    seccion de Python, pero por accidente -- un patron sin slash inicial que casa
    con cualquier carpeta llamada build a cualquier profundidad. Ese era el fallo
    que el issue describia: `git ad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
2026-08-18 Cuatro flecos del case, y ninguno mueve un DXF
    Los cuatro salieron de la pregunta de Samuel: por que estos issues siguen
    abiertos. La respuesta era que uno espera a una pieza fisica y los otros tres
    simplemente no se habian hecho.
    ## La pestana esta PEGADA, y una junta pegada quiere linea de pegado
    La puerta exigia junta CERO EXACTO contra el riel. Era correcto mientras la
    union era atornillada -- lo que no toca, no sujeta -- y dejo de serlo cuando la
    hoja de Tiptop enseno que esa cara es pared de 1.2 mm y la union paso a ser
    pegada. El metacrilato estructural necesita hueco donde quedarse; a cero no lo
    tiene, y en negativo la pieza directamente no asienta.
    antes abs(junta) < 0.01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
2026-08-18 Triaje de los flecos viejos: dos estaban resueltos, dos no
    Samuel pregunto por que seguian abiertos los issues del case. La respuesta
    resulto ser distinta para cada uno, y merecia mirarse antes de tocar codigo.
    ## #51 seguia vivo, y era el peligroso
    Nadie comparaba los agujeros DEL FICHERO con donde el modelo los pone. El issue
    traia su propia reproduccion: mover las dos filas de bandeja_base_2d +10 y -10,
    exportar, y las dos puertas daban VERDE. check_dxf solo miraba el bbox -- que no
    cambia, porque las filas viven dentro del contorno -- y alineacion() comparaba el
    modelo contra si mismo sin abrir un .dxf.
    Nueva puerta agujeros_donde_toca(), con dos niveles segun lo que se pueda
    comparar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
2026-08-18 El Pi fantasma: §2 y §6 nunca dijeron que §16 ya las habia superado (#110)
    design-notes.md es un documento por capas: §1-§14 son el diseno de la epoca de
    la tesis y §15-§18 lo corrigen. El problema del #108 no es que §2 y §6 esten
    mal calculadas -- es que no dicen que estan superadas, asi que quien lee de
    arriba abajo choca primero con los numeros muertos.
    §2. Su tabla la dominan un LCD 16x2 (muerto en la rev. 2 del case) y un
    Raspberry Pi 3B+ (muerto en la rev. 3, cuando el cerebro paso a RP2350), y
    cuenta el VCO como 3x CEM3340 cuando es el modulo 3 con 4x SSI2130. Su
    conclusion mandaba "fuente dedicada para el Pi". Se marca como registro y se
    apunta a los numeros vigentes: el c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
2026-08-19 El instrumento se mide a si mismo, y tres datasheets corrigieron el plan (#120)
    La Task 3 pedia el contrato de la telemetria en un bom.csv. Al escribirlo, tres
    datasheets primarios contradijeron el plan que los invocaba.
    El ADS1115 con ADDR a GND responde en 0x48, que es donde vive el TMP1075. El ADC
    se mueve a 0x49 y no al reves: el sensor en 0x48 conserva los straps exactos del
    modulo 3 y con ellos el driver ya escrito.
    El modo comun de entrada del INA226 tiene minimo garantizado -0,3 V (SBOS547C
    p.4). Asi que la huella de shunt de 0 ohm en -12 V se cae: no habilita nada,
    haria falta un dominio aislado entero. La huella-y-DNP es para lo que queda
    abierto; esto lo cerro un maximo absoluto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
2026-08-19 La isla existe en la hoja, y el netlist destapa un rotulo que mintio dos versiones (#122)
    Fase B: la v3 pasa de ser un bom.csv a ser un esquematico. El generador se copia
    de la v2 con las rutas cambiadas, se le quita el crowbar entero (D7, Q1, R4, C14)
    y se le mete la isla de telemetria: 30 designadores nuevos, 107 componentes en la
    hoja, 0 pines fuera de rejilla, 0 pines sin cable y 0 errores de ERC.
    El rojo del check_bom.py salio tal cual estaba escrito en el plan -- 4
    designadores sobrantes y 30 que faltaban -- y quedo en 0/0.
    Casi toda la isla se cablea por etiqueta y no por cable, al reves que el resto de
    la hoja. Los cinco chips comparten dos redes y tres nodos de divisor: dibujarlos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
2026-08-19 El toroide medía otra cosa, y traía debajo la mitad de 18 que no existía (#123)
    La Task 8 pedia medir el toroide. No hay pieza que medir -- nada esta comprado,
    que es el punto de partida del plan v3 entero -- asi que la cifra sale del
    catalogo del MPN real del bom.csv, el Nuvotem Talema 0120P1-2-012: 105 x 52,1 mm
    y 1,33 kg, mas 4 mm de holgura al diametro por el leadout bulge que avisa la hoja
    de la familia.
    Los 45 mm de alto que llevaba params.scad eran 7,1 mm menos que la pieza, un
    16 %, sobre un parametro que el issue #46 ya tenia marcado como sin confirmar. El
    diametro no estaba en ninguna parte. Ahora estan los tres, con procedencia y con
    la nota de que hay que medir la pieza al re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
2026-08-19 El toroide se corrigio dos veces el mismo dia, y la segunda deshizo la primera (#126)
    Samuel paso la hoja del fabricante. Dice otra cosa que los listados sobre los que
    yo habia "corregido" el parametro esta manana.
    RS (dos listados) Nuvotem (hoja del fabricante)
    diametro 105 mm 93 mm
    alto 52,1 mm 46 mm
    peso 1,33 kg 1,20 kg
    Los 45 mm heredados que habia en params.scad estaban a 1 mm de la verdad. Mi
    correccion se fue 6 mm en el otro sentido, apoyada en dos fuentes coincidentes
    que eran las dos secundarias. La regla de design-notes 16.1 -- fuente primaria,
    no agregador -- no es solo para limites de segur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
2026-08-19 El chasis existe, y su propia puerta le encontro el toroide encima de la salida (#129)
    La regla de §13.3 decia "un esparrago M4 soldado o remachado AL CHASIS" y el
    case es acrilico (#107). Ahora hay chasis: tres chapas de acero en el mismo
    modelo del case, con su desarrollo de plegado, su puerta y sus DXF.
    Lo que no era como estaba escrito:
    - El assert del Step 1 del plan estaba en el eje equivocado. Pedia que el
    DIAMETRO del toroide cupiera en el alto interior (97 contra 80): habria dado
    rojo sobre una caja correcta. El toroide va acostado sobre su perno central.
    - El exterior de la spec, 342 x 180 x 85, no era una cota sino "chapa de 1.5 mm
    + pestanas". Derivado de verdad sale 338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
2026-08-21 Cero conexiones sin rutear, y el filler de KiCad se cae con la placa terminada
    126 elementos sin conectar -> 0. DRC real: 48 infracciones -> 10, y ninguna
    de las diez es de cobre.
    clearance 0 (eran 34)
    cortos 0
    hole_to_hole 0 (era 1)
    sin conectar 0 (eran 126)
    silk_overlap 5 cosmetica, pendiente
    track_dangling 3 tres rabitos de 0.5 mm sin enganchar
    isolated_copper 1 la zona GNDREF, ver abajo
    ## Tres cosas que estaban mal y no eran del ruteo
    **El EP de U6/U7 no llegaba a ningun sitio.** Salia 2.5 mm al sur y ahi se
    quedaba: la entrada de los dos LT3094 estaba conectada solo por sus pines
    1-3. L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
2026-08-21 El segfault del filler no era el poligono: se probo con el arreglado y sigue
    Los dos fallos eran independientes y el comentario decia lo contrario.
    Claude-Session: https://claude.ai/code/session_01B8kQ36zt3gJuqVVwrKaJzk
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2026-08-21 Las puertas dejan de mentir: cuatro formas distintas de decir verde sin serlo
    El runner de calidad tenia cuatro maneras de dar por buena una tanda que no lo
    era. Las cuatro son el mismo fallo con distinta ropa -- no corre Y no te
    enteras -- y por eso suben a la constitucion como principios, no como parches.
    1. gates.py reventaba en la puerta 5 de 24. La salida de los gates se decodifica
    con errors="replace", asi que puede traer U+FFFD; en una consola cp1252 eso
    mataba al propio runner a media lista. Las 19 restantes no corrian y el
    resumen no llegaba nunca.
    2. gates.py convertia un FALLO real en HUECO. Cualquier salida distinta de cero
    en un script que necesitara KiCad se etiqu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
2026-08-21 La etapa I/V si se puede simular, y timbra: el chip no, lo que viene despues si
    simulations/vco/README.md decia que la carpeta estaba vacia a proposito, y por
    una razon correcta: no hay modelo publico del SSI2130 y escribir uno desde el
    datasheet seria validar el diseno contra el invento. Ese argumento no cambia.
    Lo que cambia es donde cae la frontera.
    Del SSI2130 solo hace falta lo que su datasheet DECLARA del pin 25: que MIX OUT
    es una salida de CORRIENTE. Una fuente de corriente no es un invento del chip,
    es la interfaz publicada. Todo lo demas del lazo -- R_IV de 10k, el TL074H, el
    cable de patcheo -- tiene numeros de fuente primaria. La regla que queda escrita
    es esa: se modela la inte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
2026-08-21 Los netlists de KiCad se versionan: tres puertas que no podian correr en ningun checkout limpio
    Cierra el issue #68, y el precio que se estaba pagando era mayor de lo que decia
    el issue.
    La regla *.net vive en la seccion "LTspice / SPICE" del .gitignore. Ahi tiene
    sentido -- son netlists de simulacion -- pero se estaba tragando los .net de
    KiCad por el sufijo, y esos son la ENTRADA de los check_netlist.py. En cualquier
    checkout limpio (un worktree, un clon nuevo, el CI) tres de los cuatro no tenian
    que leer:
    02-midi-cv traceback, FALLO
    bus-board traceback, FALLO
    01-power-v3 decia "HUECO: falta sam17-power-v3.net" y salia con codigo 0
    El tercero es el peor de los tres y e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
2026-08-21 Una placa con DRC 0 y sin bring-up no esta terminada: esta dibujada
    `notes/bring-up.md` + `check_bringup.py`: 55 puntos, 48 con criterio. La
    prediccion se escribe AHORA, antes de que la placa exista, que es lo que la
    hace un test y no un informe.
    Mismo patron que `hardware/03-vco/check_bringup.py`, que ya lo hacia bien: la
    prediccion vive en codigo con su fuente en la misma linea, la medida vive en
    un CSV que se rellena en el banco y se commitea, y la segunda placa se compara
    con la primera sin discutir de memoria.
    0 todo medido y en rango
    1 algo FUERA -- la placa no pasa
    2 faltan medidas: ni bien ni mal, no se sabe
    Hoy sale 2, que es lo correcto. Un fichero de medidas v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
2026-08-21 El BOM pide un NTC que no existe, y el que describe no entra en su huella
    `check_huellas.py` gana la comprobacion que de verdad decide: el paso de la
    huella contra el de la PIEZA, con la hoja del fabricante delante. Y lo
    primero que hizo fue salir en rojo. **Issue #142.**
    ## Lo que caza
    NT1 tiene las patas a 5.1 mm (hoja Ametherm SL10 5R002) y la huella las
    pone a 7.50. Hay que doblarlas 1.20 mm por lado para que entre.
    Y antes de eso, un fallo encadenado: la referencia del BOM **no existe**. La
    nomenclatura de Ametherm es SL<diametro> <resistencia>R<corriente>, o sea que
    el sufijo son los AMPERIOS:
    SL10 5R002 5 ohm, 2 A D 10.0 S 5.1
    SL32 5R020 5 ohm, 20 A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
2026-08-21 El cerebro tiene spec: ocho ranuras, y un MISO que nadie dijo quien suelta
    La spec del nucleo digital nombraba a esta literalmente -- "El cerebro (spec
    siguiente)" -- y le dejaba en su seccion 10 la lista de restricciones sin
    resolver. Esto la escribe. El modulo 2 v1 (Raspberry Pi + AD5686R + LCD) ya
    estaba marcado SUPERADO en su propio README desde el 2026-08-17; lo que faltaba
    no era decidir si se rehace, era el documento.
    Seis decisiones tomadas con Samuel:
    1. El cerebro entero de la seccion 10 en un solo spin. Medio hardware no se
    podra probar hasta que existan los modulos 4-7; lo caro es el segundo ciclo
    de fabricacion, no los pads de mas.
    2. Conectores de tamano completo -- DIN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
2026-08-21 La placa del modulo 3 vuelve a cerrar, con las ocho piezas dentro y una puerta nueva para que no se pueda volver a hacer sin ellas
    El septimo fallo de la familia que arregla esta rama, y el peor: los otros seis
    mentian sobre si habian comprobado algo. Este dejaba pasar una placa
    fisicamente distinta del esquematico con todas las luces en verde.
    colocar() itera sobre COLOCACION, un diccionario de posiciones escrito a mano.
    C_IV1-4 y R_OUT1-4 no estaban ahi, asi que quedaron fuera SIN UNA PALABRA. La
    placa salio con 136 huellas contra 144 componentes, Freerouting cerro con CERO
    tramos al aire y el DRC dio 0 infracciones. Lo cazo netdiff, o sea media hora
    tarde, y solo porque el cruce esquemat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
2026-08-21 La spec del cerebro pasa por tres auditores, y el +5 V resulta que no tenia dueno
    Tres revisiones independientes sobre la spec escrita esta manana y sobre el
    contrato de software del que cuelga. Lo que encontraron no se borro del
    documento: se marco, porque un error corregido en silencio no ensena nada.
    LO QUE ESTABA MAL EN LA SPEC, y por que:
    - EL +5 V NO TENIA DUENO. La spec de la fuente le asigna la medida al modulo 2
    por escrito ("medir sus 2.80 A es trabajo del modulo 2, no de aqui") y esta
    spec respondia que esa corriente no pasa por aqui. Las dos placas se
    declaraban no responsables del mismo riel, y el arbitro de brillo del #104 no
    existia en ninguna. Ahora el +5 V entra po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
2026-08-21 El plan del cerebro: dieciseis tareas, y las dos primeras son bloqueantes de verdad
    Plan de implementacion de la placa del modulo 2 v2. Sigue el patron del modulo
    3 -- artefacto generado por script, tabla maestra de redes como fuente unica de
    nombres, y ninguna fase avanza con la anterior en ambar -- con tres cosas que
    esta placa obliga a hacer distinto.
    LO QUE VA ANTES DE DIBUJAR, y es deliberado:
    Task 1 y Task 2 son bloqueantes. Las doce piezas contra datasheet, y los dos
    presupuestos que pueden VETAR una pieza o un pin: potencia y PIO. Corregir un
    veto despues de dibujar cuesta el doble, y este proyecto ya tiene la leccion.
    Dentro de la Task 1 vive el issue #151, que es aritmetica y no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
2026-08-21 El espacio de los modulos lo comia el chasis, no la barra
    Samuel volvio sobre el larguero de base delantera: se lee pegado al riel de
    panel (4.00 mm, la holgura clavada) y parecia comerle fondo a los modulos de la
    fila de abajo. Antes de retirarlo, medirlo.
    Y el primer intento midio mal. Por CAJA ENVOLVENTE el larguero salia como el
    culpable con 25.7 mm de fondo libre -- pero el minimo de una caja puede caer en
    una s que el panel ni siquiera ocupa, y ahi estaba el error. La medida buena
    recorre el panel y pregunta, en cada punto, cual es el estorbo mas cercano al
    plano. Hecho asi:
    minimo quien panel util 50mm 60mm
    antes 18.6 mm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
2026-08-22 La Voz total v2: tres dictamenes absorbidos con nombre y resolucion
    Segunda pasada de la junta en triple (Serrano clinico, Halberg runtime
    verificado contra firmware, Voronov ontologico segunda vuelta). Los tres
    BLOCKERs de Serrano cerrados (estado de arranque de 32 VCAs, evento de
    nota degradado a prerrequisito sin maquillaje, tap fisico de la
    caracterizacion dibujado). Los failsafes que el ADSR fisico se llevo
    vuelven como watchdogs con mutacion. La ley del crosspoint se rehace
    contra el commit global del chip real, con imagen sombra y politica de
    drones por preset. La constitucion deja de fingirse anterior al diseno y
    pasa a doctrina enmendable por acta; los roles particionan; la dormanci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
2026-08-23 El presupuesto invalidante cierra, y de paso desmiente al acta que lo pedia
    spi_privado_budget.py escrito y corrido. Era el unico declarado INVALIDANTE:
    si el caudal no cerraba con las envolventes a 10 kHz, la seccion de
    generadores caia entera. Cierra, y con holgura.
    El peor caso -- estereo con las dos ramas a tasa de render -- pide 6,05 Mbit/s
    por micro, o sea SCLK de 10,1 MHz contra un techo declarado de 20. La seccion
    3 sobrevive.
    Y el numero desmiente la suposicion con la que el acta dejo la topologia de
    paneo abierta. Suponia que la topologia A duplicaba el trafico y que por eso B
    protegia el presupuesto. A pide 1,45x, no 2x, y las dos caben. El error era de
    razonamiento: el CV de co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
2026-08-23 Dos de los cuatro presupuestos no los veia el gate: se renombran
    Correr gates.py antes de mergear encontro la trampa del glob en vivo. Sus
    patrones son check_*.py y *_budget.py, y dos de los cuatro guiones nuevos
    salieron con los nombres que la spec les puso -- consumo_total.py y
    censo_voz.py -- que no matchean ninguno. Estaban escritos, corrian a mano y
    daban verde, y el gate no los ejecutaba. O sea que no eran gates.
    Se arregla por el nombre y no por el glob, porque el nombre es la fuente: en
    este repo un guion ejecutable se llama check_* o *_budget desde siempre, y la
    spec invento dos nombres fuera de esa convencion sin darse cuenta. Ampliar el
    glob caso por caso deja la convencion rota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
2026-08-23 Las puertas dejan de depender de que alguien se acuerde, esta vez de verdad
    El issue #88 se llamaba asi y no lo consiguio: dejo gates.py escrito y
    CONTRIBUTING diciendo "hazlo a mano y pon el resultado en el PR". Sigue
    dependiendo de acordarse.
    La causa raiz no era que faltara un job. Actions esta DESHABILITADO en el
    repositorio -- enabled:false y el workflow en disabled_manually -- y no corre
    desde el PR #3. Repo privado, decision deliberada, CONTRIBUTING ya lo decia.
    Asi que reactivarlo no es el arreglo: el arreglo es que la puerta local corra
    sola, porque es la unica que hay.
    Entra .githooks/pre-push, versionado, que se instala con una linea:
    git config core.hooksPath .githooks
    Co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
2026-08-23 La memoria son 128 KB, y el tamano lo decide el descriptor, no los parametros
    Samuel pregunto por 128 y por 256, y las dos preguntas movieron la decision.
    Se corrige a 24AA1025 y se reescribe E-7 entera.
    El error del razonamiento anterior era la metrica. Contaba cuantos parametros
    mas caben, y esa no es la variable: la variable es cuantos BYTES ocupa la
    entrada de cada uno. Hoy son 42, pero architecture-compute S6 dice que los
    nombres y las unidades de cada parametro son la documentacion que el modelo va
    a leer -- de ahi sale gratis el servidor MCP. Nombre legible, unidad, rango,
    defecto y una linea de que hace no caben en 42 B; caben en unos 100.
    Con 100 B por entrada declarados como obje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
2026-08-23 Solo formato: rustfmt pasa por 19 ficheros que nunca lo habian visto
    Commit MECANICO y aislado a proposito. Ni una linea de logica, ni un nombre,
    ni un numero. Se puede revertir entero sin tocar nada mas.
    Sale de cerrar el ultimo hueco de la puerta nueva. Al instalar rustfmt --el
    componente que faltaba en la maquina-- resulto que cargo fmt --check no estaba
    en amarillo sino en ROJO: 1.549 lineas de diferencia. El codigo nunca habia
    pasado por el formateador porque la puerta que lo habria cazado no existia.
    Es el mismo patron del dia: una puerta solo prueba lo que corre.
    Verificado despues de formatear, no antes:
    cargo test 190 passed, 0 failed
    cargo fmt limpio
    cargo clippy l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
2026-08-24 Los renders sueltos entran al historial, y las ramas muertas se quedan fuera
    Trece archivos que vivian solo en el disco: tres guiones de Blender
    (ahumado, transparente, seis detalles de la trasera) y diez PNG. Estaban
    en feat/vco-dieciseis y feat/case-remate-cuadrado, dos ramas que nunca se
    subieron a ningun remoto y que van 83 commits por detras de main.
    Se rescatan SOLO estos. Comparando arbol contra arbol -- no historia --
    esas ramas no tienen mas fuente propia que main no tenga: lo demas son
    tres DXF de piezas que murieron el 2026-08-21 (bandeja de entrepiso, piel
    inferior, piel superior), un BOM generado, y 84 archivos "modificados"
    que son el atraso, no trabajo. Mergearlas revertiria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
2026-08-24 El modelo ya aguanta el instrumento: 512 a 1024, y la puerta deja de copiar
    Es el S5.1 del pase del nucleo, la mitad barata de los tres techos del #172.
    Va sola: no rompe ningun formato y no espera ninguna decision.
    EL ROJO PRIMERO. check_censo_voz.py aseveraba `n > MAX_PARAMS` -- o sea la
    puerta estaba VERDE precisamente porque el modelo no cabia, para que nadie
    lo olvidara. Honesto, pero significa que arreglarlo la pone roja. Se
    voltea a la invariante que de verdad se quiere: el censo tiene que CABER.
    Con eso rojo, se sube la constante hasta el verde.
    EL NUMERO NO ES 576. Los 536 del censo son de UN modulo, la Voz total, y
    MAX_PARAMS es del INSTRUMENTO entero -- el propio guion lo gritab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
2026-08-24 El buzon deja de tragarse mensajes, y un descriptor gordo ya no mata el volcado
    Fallos 1, 3 y 5 del #182. Los tres son el mismo patron: un limite que se
    quedo viejo y un descarte SILENCIOSO encima, asi que nadie se entera.
    EL BUZON (fallos 1 y 3). MAX_RESPUESTAS estaba en 4, con el comentario
    "lo mas que produce una sola peticion: ERROR + PENDING son dos, y el
    margen sobra". Era cierto cuando se escribio. Despues llegaron
    Reactivar { id: None }, que empuja un Anulado por rampa reactivada hasta
    MAX_RAMPAS = 16, y tick(), que anuncia hasta MAX_RAMPAS valores. Doce se
    iban al vacio, y todos los push eran `let _ =`: sin error y sin contador.
    Las consecuencias no son "se perdio un mensaje". En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
2026-08-24 Las medidas del reloj por fin llegan, y modelo_mut deja de estar abierto
    Fallos 4 y 6 del #182.
    EL 4. publicar_medidas_del_reloj tiraba el Cambio con `let _`, asi que las
    cinco medidas del reloj -- posicion, compas, tempo medido, tiene fase,
    rodando libre -- NUNCA producian CHANGED. Las cinco tienen medida: true y
    el nucleo S4.1 promete que las medidas se siguen con SUBSCRIBE. Para esas
    cinco, no se seguian.
    Y arreglarlo tenia trampa: publicar_medida NO filtra, devuelve Ok aunque el
    valor sea identico. Anunciar a lo bruto habria cambiado un silencio por una
    INUNDACION -- cinco CHANGED en cada tick, para siempre, incluidos los tres
    que casi nunca se mueven. Se compara antes de escribir, que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
2026-08-24 El buzon se dimensiona por el fan-out real, y el desborde se cuenta en release
    Salio de la junta adversarial con Halberg, Voronov y Serrano sobre este
    mismo PR. Cinco defectos, los cinco verificados en cobre antes de tocar.
    EL DESBORDE ERA MUDO DONDE IMPORTA. El commit 7e37203 metio un trait Buzon
    con debug_assert bajo el docstring "empujar SIN tragarse el desbordamiento".
    debug_assert se compila FUERA en release y fw/Cargo.toml no declara
    debug-assertions, asi que lo que se flashea era exactamente `let _ = push`
    -- el fallo que se creia arreglado, y justo lo que el papel de la autopista
    del mismo PR prohibe: "un envio que no cabe es un error con nombre, nunca un
    `let _`". Se arreglo el bin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
2026-08-24 El formato del descriptor no aguanta el peor caso que el propio repo declara
    Y esa es la noticia, no el arreglo. Sale de la junta adversarial.
    LA PUERTA MEDIA LA POBLACION EQUIVOCADA. El commit 7e37203 puso una alarma
    al 75% del techo y un comentario que decia "MEDIDO: el mas gordo son 106 B,
    o sea el 41 %". Las dos cosas son ciertas y juntas son enganosas: ese test
    recorre SOLO tiempo_params::TIEMPO y medidas::MEDIDAS, o sea los ~42
    descriptores compilados en el cerebro. Los que van a reventar los 256 B son
    los de MODULO, que llegan por I2C en ejecucion y ese test jamas los vera.
    Medido aqui, construyendo el selector de fuente que check_censo_voz.py cita
    textualmente ("los selectores de f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
2026-08-24 El firmware entra en las puertas, y la cifra sesgada del bus se corrige
    DOS DEUDAS QUE DEJO ABIERTAS LA TANDA ANTERIOR.
    EL FIRMWARE NO LO MIRABA NADIE. software/nucleo/Cargo.toml tiene
    exclude = ["fw"] -- deliberado y correcto, porque fw compila para thumbv8m y
    core para el host, y en estable no hay forced-target. La consecuencia no era
    deliberada: `cargo test --workspace` del hook NUNCA compilaba el firmware,
    asi que la mitad que de verdad se flashea no tenia ninguna puerta. Los
    arreglos del #182 en usb.rs se empujaron cuatro veces con "PUERTAS EN VERDE"
    sin que nada los compilara.
    Lo caza Serrano en la junta del 2026-08-24 (BLOCKER 1). El hook gana una
    septima puerta que entra en fw/ y c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
2026-08-24 El instrumento por fin corre: el tiempo de pared entra por una puerta
    Lo caza Halberg en la junta del 2026-08-24, y era el hallazgo mas grave de
    los tres dictamenes: fw/src/main.rs arranca dos tareas -- correr_usb y
    atender -- y NINGUNA llamaba a tick(), caducar() ni confirmacion_fisica().
    En la placa eso significaba que una rampa aceptada nunca escribia un valor
    (402 lineas de rampa.rs con 16 tests verdes, codigo muerto en el binario),
    que las cinco medidas del reloj que el 87e8310 hizo "por fin llegar" no
    llegaban porque nadie llamaba al tick, y que caducar() no corria jamas: con
    MAX_RETENIDAS = 4, cuatro SET a un parametro marcado dejaban la cola llena
    PARA SIEMPRE. Negacion de servicio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
2026-08-24 La negociacion de version por fin negocia
    N7, decidida por Samuel el 2026-08-24: ninguna ruptura de formato entra antes
    que esto funcione. Como B3 (la huella del descriptor) es una ruptura, esto es
    lo primero.
    `servidor.rs` hacia `Mensaje::Hello { .. }`: la version del cliente se leia del
    cable y se tiraba, y se contestaba `Hola` a cualquiera. El docstring de `Hola`
    ya lo denunciaba en voz alta -- "sin esto la negociacion es de un solo sentido
    y no negocia nada" -- y el test que lo cubria mandaba `version: 1`, que
    coincide, asi que pasaba en verde y seguia pasando.
    Ahora un cliente de otra version recibe `HOLA` con la nuestra y un `ERROR` con
    codigo propio: CodigoError::VersionIncompatible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
2026-08-24 Y de paso los dos E741 de gates.py, que nadie miraba
    Salieron al pasarle ruff a mano al fichero que estaba tocando, y ahi esta lo
    interesante: la puerta de lint del hook corre `ruff check .` dentro de
    `software/midi-cv` y nada mas. Son 30 ficheros .py de los 99 del repo. Los
    otros 69 -- los guiones que DECIDEN el hardware, incluidos los budgets y el
    propio gates.py -- no los mira ningun lint.
    `gates.py` los EJECUTA (por eso las puertas estan en verde), pero ejecutar no
    es lintar. Este commit arregla los dos de este fichero; el hueco de cobertura
    queda dicho en el PR para decidirlo, no tapado aqui.
    Claude-Session: https://cl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
2026-08-24 El plan de acabado profesional: seis tareas, y cada cota nueva con su puerta
    Sale de la revision adversarial del 2026-08-24. La pregunta no era "que
    arreglamos" sino "que haria que el pedido volviera mal, o que el aparato se
    sintiera casero", y el hueco grande resulto ser que hay nueve DXF y 563
    lineas de README y ningun documento que vaya al taller.
    El acrilico llega a acabado de vitrina cuando se ejecutan tres procesos que
    hoy no estan en ningun papel: recocido, canto diamantado y apriete
    controlado. Ninguno de los tres aparece ni una vez en el repo -- lo
    comprobado: cero menciones a recocido, cero a limpieza y disolventes, y los
    30 M3 sin tipo de cabeza ni arandela especificada.
    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
2026-08-25 Un evento perdido no se detecta; que al menos se cure solo
    La junta adversarial del #201 -- cinco agentes -- encontro que al matar el
    reenvio murio tambien todo mecanismo capaz de saber que un evento se perdio
    en la columna B: sin MISO desde B, sin acuse, sin secuencia, sin CRC, y con
    R-S5 prohibiendo inventarlos. Halberg lo formulo asi: «se optimizo el jitter
    de una entrega cuya fiabilidad ya no se puede verificar».
    Y ESTE PAPEL LO EMPEORABA. El tono se auto-repara porque es periodico: si una
    trama se pierde, la siguiente trae el valor 125 us despues. Un evento sacado
    de la cadencia (D1) es un disparo unico. Un note off perdido en la columna B
    es una nota clavada PERMANENTE.
    D6 / R-E10: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
2026-08-25 La velocidad no existe en el modelo, y mi formato la daba por hecha
    Tres enmiendas, las tres de la revision cruzada con el autor del #201.
    1. R-E11, corolario. Anclar la red de reparacion a los 50 ms del sondeo de
    jacks tenia el merito de no inventar cadencias, pero pagaba con lo unico que
    dolia: a 150 BPM, 50 ms es casi una fusa, y un note on reparado con ese
    retraso entra tarde y SE OYE COMO ERROR. A 200 Hz -- 5 ms -- entra tarde y se
    oye como la nota. Y cuesta 3200 bit/s: tres ordenes por debajo de la
    precision del modelo, igual que los 320.
    8 kHz 128000 bit/s +0,2560 MHz
    20 Hz 320 bit/s +0,0006
    100 Hz 1600 bit/s +0,0032
    200 Hz 3200 bit/s +0,0064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
2026-08-26 El censo sienta a todas las funciones del N657 a la mesa, y la mesa elige el encapsulado
    La puerta 2 del sello (spec motor-digital S1.2, issue #213) ya no es una
    promesa: micro_budget.py carga la Tabla 16 del DS14791 Rev 2 (pp86-109)
    destilada a las senales que este instrumento pide, y busca un reparto
    donde ningun pin tenga dos duenos -- las 16 capturas, el SAI del codec,
    los 3 buses de CV con NSS por hardware, el J2 esclavo, el RGMII entero,
    el control del codec, dos ADC y las reservas fijas (SWD, HSE, XSPI2 en
    el puerto PN, USB dedicado).
    El veredicto: VERDE, y la variante es VFBGA264 -- la unica que cierra
    con RGMII reservado. La cuenta que ata el encapsulado a D9: PF14 es el
    unico pin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
2026-08-26 La junta le cobra doce grietas al censo, y el acta de la tarde le sienta la PSRAM
    Las cuatro lentes verificaron el titular celda por celda y AGUANTA:
    PF14 es unico en las 244 paginas, los 20 tercetos de SPI fallan en
    198/223, y la variante es VFBGA264. Pero la junta cazo doce grietas
    reales y aqui se pagan todas:
    - La cita huerfana: 'telemetria del puente (S4)' no existe en ningun
    papel vigente -- la segunda entrada de ADC queda como reserva
    declarada, con la herencia del issue #213 anotada para que nadie la
    vuelva hecho.
    - La asercion del issue #213 era inalcanzable por construccion (el
    Principio VIII del propio archivo): ahora _verificar_reparto comprueba
    el testigo contra N6_PI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
2026-08-26 Tres presupuestos le ponen numero al motor, y el censo de SRAM devuelve un hueco
    Tanda 2 del #214, la parte de memoria y carga. Nacen tres guiones que los
    papeles mandaban y nadie habia escrito:
    carga_motor_budget.py -- el libro BILATERAL (R-M2). Las dos mitades del
    acta A-3 aseveradas: el motor (techo con valvula) y la heredada (que no
    cede jamas, y con error de 3x cabe: 59-84 %). Y las filas que el acta de
    la tarde mando sin cifra: granular y sampler, DERIVADAS del ancla que el
    spec si publica (2000-4600 ciclos / 256 osciladores del wavetable, mas su
    frase "la misma clase de trabajo por muestra"). Resultado: la CPU compra
    129-289 granos simultaneos segun que motor corran las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
2026-08-26 Se cierra el mapa: trece filas mandadas, trece aplicadas, y una decision devuelta
    Ultima tanda del barrido. Cuatro filas que vivian en issues, mas la de los
    DIECISEIS §3 -- LA TABLA QUE PERDIO SU SUJETO
    La tabla que justificaba dos micros ("Da un RP2350B | Con dos") no describe
    nada: en esa placa hay un N657. Se enmienda diciendo POR QUE se cayo tan
    limpio, que es lo unico que deja leccion:
    la spec escribio, con una honestidad que acabo siendo su sentencia,
    "lo que sostiene los dos micros es SOLO el PIO".
    Un diseno que se apoya en un unico recurso escaso se cae entero el dia que
    aparece un chip que da ese recurso de sobra. Aparecio. Sobrevive su primera
    columna, que sigue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
2026-08-26 El acrilico deja de cargar: la spec del esqueleto de aluminio
    Samuel el 2026-08-26: "quiero que le quitemos las barras, y en cambio toda la
    estructura sea un esqueleto de aluminio". Esto es SOLO la spec -- no toca
    modelo, ni puertas, ni DXF.
    Reescribe la decision de Estructura de la spec del case (SS2, SS5, SS6, SS9,
    SS10, SS11) y entra como rev. 21 cuando se implemente. Ocho decisiones, todas
    con sus alternativas descartadas escritas para que nadie las reintente.
    LA QUE MAS PESA es el perfil en L y no la ranura, y la razon esta en el SS3 de
    la spec del case: el primer intento del SAM17 fallo porque los dientes no
    cuadraron, y la arquitectura de sandwich "no mitiga el problema: LO ELIMINA"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
2026-08-27 La barra que iba a salvar el suelo no cabe: el suelo sube a 10
    La Tarea 5 escribia la transversal de P[0], la metia en la misma lista de
    railes que recorre solapes() -- eso era lo correcto -- y salia ROJA con dos
    solapes reales. La arista inferior delantera ya esta ocupada: el riel de panel
    del frente bajo ahi el 2026-08-21 y costo 8.46 mm de alto de aparato.
    Medido contra su AABB: quedan 10.45 mm en X y 5.29 en Y. Cabe una barra de
    10x10 y nada mayor, y una 10x10 cruzando 528.62 mm cede 5.352 con media carga:
    no es una viga. La 20x20 que serviria (0.335) no entra, y el 2020 del BOM
    ademas es hueco.
    O sea que la fila "con la transversal del marco en P[0]" de spec 4.2 era
    falsa, y con ella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
2026-08-27 El censo de paneles tenia tres VCO fantasma, y su puerta salia verde por compensacion
    ANCHOS_PISO_SUP describia la tesis: {"MIDI/CV": 80, "VCO1": 90, "VCO2": 90,
    "VCO3": 90}. Hoy los tres VCO son UNA placa de 114 mm (03-vco/README.md) y
    "MIDI/CV" eran los 80 del Raspberry Pi con su LCD, superado desde el
    2026-08-17 por su propio README. Las dos entradas estaban mal en direcciones
    OPUESTAS -- 270 mm de VCO inexistente le prestaban sitio a un cerebro censado
    corto -- asi que la puerta de mas abajo salia verde por compensacion. Es el
    #152, abierto el 2026-08-21 por la propia spec del cerebro.
    Lo que se corrige:
    * el piso superior pasa a {"VOZ": 116.84}. No 114: el panel EUROrack va en
    H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
2026-08-27 El suelo y el zocalo eran la misma tabla, y eso deshizo tres problemas
    Tres tareas en un commit porque el plan no sobrevivio al contacto: quitar `base
    delantera` pone roja a guarda_costado() mientras el acrilico siga contando como
    portante, o sea que los largueros, el suelo y la taladreria del costado se
    mueven juntos o el modelo mide un estado a medias.
    DE LAS CUATRO BARRAS SE VA UNA. Las otras tres no eran "barras internas": base
    trasera y remate trasero ya estaban a tope contra la cara interior de la trasera
    y contra el suelo / el remate -- dos caras cada una, o sea transversales de
    marco; mudarlas a P[5] y P[6] las metia 8 mm por detras del panel. Y el del
    valle no tiene sustituto: el r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
2026-08-27 Plan del esqueleto visible: seis tareas, y el reparto Claude/codex escrito
    Plan de implementacion de la spec del esqueleto visible. Seis tareas, con el
    patron TDD-de-hardware del repo: la puerta primero, en ROJO, luego el modelo, y
    un paso explicito que la rompe a proposito.
    EL REPARTO DE MOTORES VA EN LAS CONSTRAINTS GLOBALES, no como nota al pie.
    Samuel pidio delegar a codex y el corte sale de la skill saver:
    - Claude escribe LA PUERTA. En este repo la puerta es el test, y los tests se
    escriben con el cerebro caro.
    - Claude la ve en ROJO: que el rojo sea por la razon correcta es juicio.
    - CODEX toca el modelo hasta VERDE. Es la fila "iterar contra tests" de la
    matriz: el un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
2026-08-27 El escaneo previo caza un assert que habria fallado con los valores buenos
    Antes de despachar la primera tarea, el escaneo de conflictos que pide la skill
    encontro cuatro cosas y una era un bug de verdad en el codigo del propio plan:
    guarda_apilado() exigia (L - t_junta) >= t_min, o sea 5.5 >= 6.8.
    FALSO con los valores correctos. Comparaba el hueco que queda DESPUES de la
    junta contra el espesor del acrilico, y esa no es la condicion. La condicion
    es que el juego que deja el acrilico mas delgado lo cubra la junta:
    L - t_min <= t_junta, o sea 2.7 <= 4.
    Los otros tres son huecos de interfaz: la Tarea 4 consume el z0/z1 que cambia la
    2 sin declararlo, y al borrar centros_transver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
2026-08-27 Codex me corrigio el rescate: cerre la decision con la respuesta equivocada
    Cuatro hallazgos de `codex review` sobre esta rama. Dos son P1 y los dos
    demuestran que lei mal la pregunta que decia estar cerrando.
    1. **«DOS ranuras» nunca fue «una por micro».** Cerre la decision abierta 1 en
    «una» apoyandome en la decision de Samuel de que las ranuras son
    funcionales y nunca por micro. Pero el cambio 2 de §8 pide dos por ESPACIO
    DE DIRECCIONES: MAX_INSTANCIAS = 16 lo consumen exacto los dieciseis
    osciladores y las 72 entradas del censo que no son voces no tienen donde
    vivir. Las dos opciones sobre la mesa eran funcionales las dos; el chip no
    entraba en la pregunta. Cier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
2026-08-28 Dos comentarios apuntaban a una funcion muerta, y el BOM daba una cota falsa
    Ronda de arreglos de la revision del anillo. Tres cosas.
    LOS COMENTARIOS VIVOS. El grep de nombres borrados que reporte estaba mal
    filtrado -- mi propio pipe se comia los // de OpenSCAD -- y dije cuatro
    lineas cuando son 23. Veintiuna son historia fechada y se quedan; dos
    estaban en presente y mentian:
    - clearance_budget.py, en el marco de remate: decia que los largueros
    tienen que caber "DENTRO del acrilico" y que lo comprueba
    railes_dentro_del_costado(). Las dos mitades falsas. Hoy caben dentro
    de la SILUETA, que es la del anillo y no la del acrilico -- este va
    14.5 mm mas adentro (Ruling R4) -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
2026-08-28 El punto peor del costado cae en un canto libre, y ahora el papel lo dice
    Ronda de arreglos de la Tarea 4. La implementacion la aprobo la revision; lo
    que estaba mal era lo que decian los comentarios y la spec, mas dos lineas.
    LA LIMITACION REAL DEL MODELO HACIA DENTRO, escrita donde vive. El docstring de
    guarda_costado() avisaba de lo que NO es el problema (que el canto se levante
    del rebaje). El problema es otro y tiene numeros: el punto peor cae en
    (292.8, 117.5), a menos de 1 mm del canto TRASERO del acrilico -- 227 mm sin un
    solo apoyo hacia dentro, porque en la franja trasera no cabe clip y el del suelo
    mas cercano que la geometria permite queda a 95.7. Y la formula de placa
    circular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
2026-08-28 Los papeles alcanzan al anillo: pliego de mecanizado, cupon y orden de montaje
    bom() dice la verdad del modelo (anillo fresado, 16 roscas ciegas dinamicas,
    clips y junta EPDM que faltaban, cero 2020/casquillo/junta de 4 vivos) y de
    paso caza dos bugs reales: el conteo de clips iba sin doblar por costado, y
    la pestana del valle se contradecia a si misma sobre si atornilla a la placa
    o al anillo. PLIEGO gana el taller de mecanizado (spec 9) con su cupon de
    100mm; RFQ gana el taller D y la pregunta de planitud; README recuenta el
    BOM contra el eco y reordena el ensamblaje (riel a la placa, placa al
    anillo, clips al final); la spec del case llega a rev. 22 en 5, 9 y 11.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
2026-08-28 Fix round 1: la tapa de remate no existe, y el eco se contradecia sobre el M4
    Borra remate_sup()/remate_sup_2d() del .scad -- cero llamadores confirmados
    por grep -- y con ellas la pieza acrilica que README/PLIEGO/RFQ/bom() seguian
    vendiendo desde el 2026-08-27. Corrige la frase de bom() que decia "no hay
    mas M4" a seis lineas de contar M4 de brida y de clip en el mismo eco.
    Repara una regresion propia en la spec (paneles de modulo no anclan a los
    miembros, anclan a los raieles) y alinea seis desajustes menores entre
    README y la spec (cadena del vano, orden de ensamblaje, conteos de DXF).
    Los dos budgets VERDE; git status case/plans/ vacio, ningun DXF cambio.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
2026-08-28 Fix round 1: el DXF de la placa cortaba el bolsillo y dejaba fuera el tornillo
    El revisor cazo tres cosas sobre la Tarea 6.
    CRITICO: placa_2d() dibujaba, en el eje de cada riel, el cajeado (d_cajeado_riel
    = 8, un bolsillo de prof_cajeado_riel = 2.5 por el lado del anillo) en vez del
    paso M4 (d_M4_paso = 4.5) que de verdad atraviesa la placa y por donde entra el
    tornillo del riel. Cortada tal cual, la cabeza del tornillo cae dentro de un
    agujero de 8 mm sin nada que la tope: el riel no queda atornillado a nada -- y
    taladros_placas(), la puerta recien escrita, exigia exactamente ese Ø8, asi que
    cementaba el defecto en vez de cazarlo (comparaba el modelo contra si mismo con
    la misma cota equi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
2026-08-28 Fix round 2: el veredicto del render vendia brillo de mas, y los papeles se habian quedado atras
    El re-review peso el highlight del frente contra el render anterior
    (b7de369): los pixeles saturados cayeron de 84 a 7 (>0.90) y de 43 a 3
    (>0.98) -- ~12x menos area, no mas concentracion. La frase de la ronda 1
    ("mas concentrado que en la ronda anterior") vendia como ganancia lo que
    fue una perdida de area; corregido el veredicto en task-6-report.md. Y el
    undersell simetrico: en el frente, el borde derecho -- el costado con la
    ventana de acrilico -- SI ensena el anillo angosto contra el naranja, la
    misma lectura que la trasera. El resto de la vista sigue sin distinguirse
    por color, eso no cambio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
2026-08-28 La prosa citaba al gate de ayer; ahora cita el de hoy
    b799e8b movio vent_ancho_ranura a 3.75 y vent_puente_min a 6.5 -- la entrada
    bajo de 7642 a 6781 mm2, y la ranura de la trasera pago la diferencia -- pero
    el README, params.scad y clearance_budget.py se quedaron citando los numeros
    de antes. Se emparejan las cinco citas contra la salida real de los dos
    gates: el README (la cita de entrada, la tabla de aire, el margen del IEC a
    11.25 mm y la historia de vent_puente_min), el umbral de escuadra_ala en
    sam17_case.scad y clearance_budget.py (8.44 redondeaba al alza; el numero
    exacto es 8.435), los dos mensajes de guarda_red() que imprimian puente:.0f
    y perdian el .5 de 6.5, la historia del A/B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
2026-08-29 Los papeles decian el case de ayer: marco, cupon y las cotas que se movieron
    PLIEGO a rev. 23 y spec del case a rev. 23. Lo que entra: las dos bandas del
    marco de la trasera en la tabla de piezas (una es desarrollo y la otra no, y se
    dice cual), el cupon del anillo como punto de parada con su plano, y la nota de
    que las bandas NO son un par espejado -- son dos piezas distintas y cada una va
    en su sitio una sola vez.
    Lo que se corrige porque se movio hoy: el ala B de la escuadra pasa de 12 a 10.5
    y su linea de doblez de 8.70 a 7.20 (la cara desde la que se mide el vuelo se
    adelanto al rehundir la trasera), el blank de 194.68 x 24.70 a 194.68 x 23.20, y
    prof_sup de 29 a 27.5 en los tres sitio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
2026-08-29 El hallazgo del chasis se registra en el PR, no en un issue que no existe
    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
2026-08-30 El cerebro se queda atras de la rafaga: propuesta de hub en N657, con la cara y las radios
    El J2 punto a punto (#210, mergeado el 26) cuelga de una premisa que lleva
    cinco dias «dirigida, no sellada»: el chip del cerebro. Su propio texto dice
    que sobre el RP2350 «no hay version de este diseno». La Voz llego al N657 y
    el cerebro no; este papel es la nivelacion, como PROPUESTA.
    Lo que trae, rotulado: las actas de Samuel del 30 (A-1 a A-6, textuales) y
    las decisiones que recomienda y el no ha firmado (D1 dos N657, D2 la cara al
    hub, D3 la camara al hub, D7 asiento para un procesador de aplicaciones).
    E-1 se reescribe: sus tres razones eran del RP2350 y dos murieron con el.
    Lo que corrige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
2026-08-30 check_dxf contra el rebaje: de 46 rojos a 2, y los seis gemelos que los causaban
    Regenerados los quince DXF y perseguido cada rojo hasta su causa. Ninguno era
    un defecto del diseno: los seis eran gemelos que se quedaron viejos.
    1. El ORIGEN DEL BLANK de nariz y talon (z - t_anillo - hol_piel) estaba escrito
    cuatro veces a mano en check_dxf y las cuatro se quedaron viejas a la vez --
    el blank arranca ahora dentro del rebaje. Ahora es _x_blank(), una. 46 -> 16.
    2. El SOBRE del dorso no sabia del rebaje de chapa, que corre a 1 mm de la
    silueta por los cuatro lados: el fichero correcto salia fuera de envolvente.
    3. El ANCHO DEL BLANK DEL TECHO en check_dxf seguia en ancho_util (540.62)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
2026-08-30 Dos versiones, un cobre: la primera con la 5" del kit, las siguientes con una 7" comprada
    Samuel, 2026-08-30: «hacemos una version para 5 pulgadas y luego una
    version para 7 pulgadas, porque cuando imprima las placas pedire varias».
    Entra como A-8.
    Lo que hace que sean una version y no dos disenos, fijado en §3.1: la 7" se
    elige de la misma resolucion y el mismo camino (800x480, RGB paralelo,
    tactil I2C) para que firmware, framebuffer y censo de pines sean uno; el
    conector de pantalla del hub sirve a las dos hojas cotejadas pin a pin, y si
    sus FPC no coinciden la diferencia va a un flex adaptador por version, nunca
    a dos cobres; y lo que cambia de version es la cara, con el DXF del panel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
2026-08-30 Revision adversarial: los gemelos, la tautologia, la rendija comprimida y los canarios a la deriva
    Primera tanda de arreglos del NO APROBABLE de codex (4 bloqueantes, 8 altas,
    con Serrano, Halberg y Rune). Lo que se cierra aqui:
    DOS GEMELOS MIOS, DE HOY. _muesca_brida() conservaba hol_piel mientras el .scad
    ya usaba hol_chapa (0.35 mm de diferencia, y taladros_marco_ventana() muestrea
    lejos de esa frontera). Y _cajas_brida() recibia el vano entre caras, asi que
    la puerta de colisiones analizaba la brida 2.5 mm de donde el .scad la dibuja.
    Los dos coinciden ya al milesimo.
    UNA TAUTOLOGIA MIA, DE HOY. Mi comprobacion del cajeado derivaba la caja de los
    parametros y la comparaba contra los mi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
2026-08-31 El N657 trae su conmutado dentro: hace falta UN riel de 1,8 V, no cuatro convertidores
    El #252 se abrio hace un rato diciendo que hacian falta cuatro reguladores de
    punto de carga metiendo conmutacion en el cuarto limpio. ERA FALSO, y era una
    inferencia mia a partir de la nota "SMPS external" de las tablas de consumo --
    que describe como hizo ST la medicion, no lo que el chip exige. Corregido en el
    propio issue y este papel parte de la hoja leida.
    Lo que dice DS14791 §3.4.4: el chip EMBEBE el conmutado que genera VCORE. Lo
    externo son una bobina de 1 uH y 88 uF (4x22) de ceramicos, por chip. Y arranca
    solo: al resetear el conmutado se habilita a 0,81 V, "hence the system can start
    up in an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
2026-08-31 El Rev 10 cierra el hueco y abre uno peor: entre Typ y Max hay 7,4x y falta el de en medio
    Samuel bajo el DS14791 Rev 10 (teniamos el Rev 2, ocho revisiones atras). Cierra
    lo que se pedia y destapa tres cosas, dos de ellas errores mios.
    EL HUECO CERRADO. No hacia falta la eficiencia del conmutado: ST publica
    IDDSMPS, la corriente que el chip pide EN EL RIEL DE 1,8 V, y ya incluye el
    nucleo. 99,93 mA tipicos (Tabla 39, p. 154), y con IDDA1V8, IDDA1V8AON e IDD el
    total por chip son 103,3 mA -- 413 mA los cuatro. La cota que este papel dio
    ayer por conservacion de energia, >=372 mA, era correcta y estaba ajustada al
    11 %. El RENDIMIENTO_DCDC estimado desaparece: pertenecia a un modelo que no
    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
2026-09-01 [verified] fix(case): restore frame screw access
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2026-09-01 El tono de arranque extiende con ceros, que es lo que manda su seccion
    El #229 encontro que M2-115-U define DOS escalados, no uno, y que el
    evento reparte sus campos entre ellos. La fuerza va por Min-Center-Max
    (su §3.1 nombra "Note On/Off Velocity" de forma explicita). El tono no:
    es un valor absoluto y cae del lado de la §4, que dice por que --
    Min-Center-Max mete ruido en la mitad alta del rango, y da el numero:
    la nota 127 saldria en 127.00385, un tercio de cent de error.
    Un tercio de cent no se oye en una nota sola. Se oye en un unisono o en
    un acorde afinado, que es donde dos voces del mismo tono nominal baten.
    Asi que Asignacion gana un campo `tono: u16` que nace por extension con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
2026-09-02 La puerta de lint mira el repo entero, y lo que tapaba eran vestigios
    Hasta hoy g_ruff corria `ruff check .` dentro de software/midi-cv: 30 de
    113 guiones. Los 83 de fuera eran justo los *_budget.py y check_*.py que
    deciden hardware y taller, y el propio gates.py que los ejecuta. Ejecutar
    no es lintar: el 24-08 (#194) habia 29 errores fuera de la puerta; hoy,
    68. La deuda corria donde el repo toma decisiones.
    Que cambia:
    - .githooks/pre-push: g_ruff corre desde la raiz. Los worktrees de
    .claude/ quedan fuera porque ruff respeta .gitignore (comprobado: 68
    desde la raiz, 68 sobre los tres directorios sueltos, con 20 worktrees
    colgando).
    - ruff.toml en la raiz fija por escrito el juego m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
2026-09-02 La barrera dice que canales cambian, el ataque tiene presupuesto y el censo cuenta las envolventes
    Tareas 4, 5 y 6 del plan del generador de envolvente
    (docs/superpowers/plans/2026-09-02-generador-de-envolvente.md).
    bahia.rs: Commit gana `cambian`, los canales cuyos cruces cambian con el
    commit. El latch tarda mas de un tick (512 bits a 5 MHz son 102 us, hoja
    del AD75019) y un abre en esa ventana abriria un canal a medio conmutar:
    el firmware los pasa a Generadores::bloquear_apertura antes de shiftear y
    los suelta con Conmutado tras PCLK. Y PoliticaDrones::Forzar queda
    documentada como no ejecutable en v1: su mute breve no tiene numero hasta
    que el bring-up mida el glitch (voz-total §11.2)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
2026-09-02 La cabecera del J2, v2 tras la junta: sesion con nombre, y el contador del mismo lado que la verdad
    Tres lentes sobre la v1 (Serrano, Halberg con cuatro simulaciones, Voronov):
    un BLOCKER compartido —el contador del bloque de compuerta era una cuenta
    local que una sola trama perdida desplazaba para siempre: 1802 notas
    revertidas en 60 s con una perdida por mil— y el invariante que lo cura: la
    verdad y su numero de version salen del mismo lado. El contador pasa a ser
    la secuencia del sobre del ultimo EVENTO; el modulo guarda el maximo que
    acepto.
    Seis decisiones cambian de mecanismo y llevan marca: D1 (una trama, un
    tipo: propiedad del parser, no de la latencia), D3 (el CS es la direccio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
2026-09-02 El plan del cable: ocho tareas, cada una con su test rojo primero
    El papel de la cabecera (#276) esta firmado y en main; esto es lo que hay
    que escribir para que exista.
    Ocho tareas, en orden de dependencia: `Barrera::reafirmar` (D7), el
    contador del bloque que pasa a ser la secuencia del cerebro (D4, el
    BLOCKER de la junta: 1802 reversiones en 60 s con la cuenta local), el
    `SET` que aterriza en un parametro suelto (D4), el sobre de seis bytes
    en `j2.rs` (D2), los cinco mensajes de bajada (D4), la sesion y los
    registros de subida (D5, D6), la traduccion a la cola del tick (D8), y
    los dos guiones de presupuesto (§9).
    Las diecisiete pruebas de §8 tienen tarea; las nueve decisiones de §2
    t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
2026-09-02 La corriente de rectificacion dejo de dar la vuelta a la placa: 57,49 -> 2,44 cm2
    El guion del zumbido medía la v1, que no se construye (#280). Apuntarlo a la v3
    era la mitad del arreglo; la otra mitad era el metodo.
    Medía una CAJA ENVOLVENTE alrededor de J1, BR1, C1 y C12. Un rectangulo
    alrededor de cuatro piezas mide lo mismo se vaya el retorno por donde se vaya, y
    lo que acopla es el area que ENCIERRA el camino. Ahora traza el cobre: sigue el
    recorrido electrico de verdad -- con las vias y los pads pasantes en el grafo,
    que es por donde VRAW+ cambia de capa aqui sin ninguna via -- y firma el area
    con la formula del cordon de zapato. Firmarla importa: un camino que va y vuelve
    sobre si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
2026-09-03 La mutacion por biseccion sale del case y se vuelve herramienta
    _borde_rojo() vivia privada en case/clearance_budget.py desde el 2026-08-30,
    y su propio docstring cuenta por que existe: cuatro canarios escritos a mano
    dejaron de morder en un solo dia porque la geometria se movio debajo. La
    fuente v4 estrena nueve presupuestos y cada uno tiene que ver morder sus
    asertos; nueve copias de esa funcion son nueve sitios donde el numero
    frontera se queda viejo. Sale a hardware/tools/canario.py como borde_rojo()
    sin cambiar la logica, y el case la importa con su alias de siempre.
    Su contrato, hardware/tools/test_canario.py, pide seis cosas que la copia
    del case cumplia sin que nadie lo hubiera escr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
2026-09-03 Las curvas de las hojas, leidas con los ojos y en un guion
    Las curvas de derating de los IRM y de PSRR de la cascada no salen por
    extraccion de texto: son trazos. La v1 del papel de la fuente v4 declaro
    HUECO cuatro cosas que estaban dibujadas en la p. 3 y razono el liston con
    una curva incompleta. hardware/01-power-supply/v4/curvas.py conserva la
    lectura ocular hecha hoy sobre las paginas renderizadas, con hoja, pagina,
    figura, condicion y fecha en la linea de cada punto.
    Dos cosas que el papel (sec.6) no tenia bien, y que esta lectura corrige:
    * Las curvas NO acaban en 70 C al 50 %: siguen bajando hasta 85 C. La
    IRM-45 da 33 % a 80 y 25 % a 85; la IRM-20, 20 % y 5 %. Por encima de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
2026-09-03 D-F7: PS5 pasa a IRM-45-5 y el liston sostenido existe con 16 900 mm2 de venteo
    Samuel firmo el 2026-09-03 la recomendacion que calor_budget.py hizo nacer:
    PS5 deja de ser una IRM-20-5 y pasa a ser una IRM-45-5, la misma pieza que
    PS6. La IRM-20-5 son 20 W a 5 V = 4,0 A de placa, exactamente el liston del
    +5 V de rack, cero margen de derating, y su curva "3.3V,5V" tiene el codo a
    45 C, justo la sala de diseno: ningun venteo lo arreglaba. La IRM-45-5 da
    8 A de placa con codo a 50 C, y a los 4,0 A que se declaran disipa MENOS
    que la IRM-20-5 a placa (3,95 W contra 5,32; rendimiento 83,5 %, hoja p. 2).
    Con eso el guion distingue dos numeros que el papel mezclaba: MODULO_A, lo
    que cada modulo p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
2026-09-03 El maestro del J2 gana su politica, sus doce testigos y su presupuesto
    La fase A entera del plan: `maestro_j2.rs` en `core` -- Umbrales que rechazan
    lo que no sirve para avisar, `Tsize` que hace imposible el `TSIZE = 0` de
    R-MJ1, la maquina por ranura con sus cinco contadores, las dos marcas de salud
    sobre ventana deslizante, y el banco de seis ranuras independientes. 14 tests,
    todos en el host, sin hardware.
    Las ocho mutaciones mueren: se muto cada guardia (el `<=` de la ventana, el
    n-esimo contra el mas reciente, el `>=` de `muda`, el reset de `malas_seguidas`,
    la puerta de `Vacia`, el `div_ceil` del plazo, la cota de `Umbrales`, y la
    independencia de las seis ranuras) y ningun testigo so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
2026-09-03 La fuga de seis modulos y sus Y2, contra el limite de la norma
    fuga_budget.py suma las seis fugas de los modulos y las de los Y2 --los seis de
    D-F5 mas los del filtro de red-- con las condiciones de medida de la norma:
    1,1 veces la tension nominal (253 V) y 60 Hz, que es la frecuencia peor de las
    dos en las que esto se vende. Sale en codigo 2. Tres hallazgos.
    1. LA FUGA NO ESTA "UN ORDEN DE MAGNITUD" POR DEBAJO DEL LIMITE: ES EL 87 %.
    El papel sec.4.1 estima ~1,4 mA y lo llama "el no-problema". Con las
    condiciones de la norma son 1,37 mA de los seis modulos (< 0,25 mA/277 Vac
    de la hoja, escalados con la tension), 1,26 de los seis Y2 de D-F5 a 2,2 nF
    y 0,42 de los del filtro: 3,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
2026-09-03 El bring-up de la v4, escrito antes que la placa y con sus predicciones
    check_bringup.py de la v4 hereda la forma del de la v3 --cada paso predice un
    numero, medidas.csv lo guarda, el guion lo juzga-- y se escribe con la placa R
    todavia en el papel, porque un bring-up escrito despues de medir es un acta y
    no una prediccion. 75 puntos en los diez pasos de sec.9.1: 71 con criterio y 4
    de registro. Sale en codigo 2, que es lo correcto con la placa sin fabricar.
    LA DIFERENCIA GRANDE CON EL DE LA V3: las predicciones se IMPORTAN de los
    presupuestos, no se copian con su cita. El minimo de +15 V con carga sale de
    margen_budget, la temperatura del aire de calor_budget, el rizado tras el LC y
    el rui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
2026-09-03 Dos temperaturas escritas a mano y una cifra que la prosa redondeaba mal
    check_absmax.py y fusible_budget.py llevaban T = 68,91 C copiada de la salida
    de calor_budget.py, y la de check_absmax ademas tenia un comentario que decia
    "se recalcula abajo" y no se recalculaba nunca. Las dos pasan a resolverse:
    aire_recinto_c(p_recinto_w(SOSTENIDO), p_cajon_w(SOSTENIDO), area_venteo_mm2=
    P_BASE["area_venteo_mm2"]). De esa temperatura dependen la cota de abajo de la
    ventana del crowbar --lo que el riel sano llega a valer por deriva-- y el
    derratado del calibre del fusible: una cifra copiada ahi se queda vieja en
    silencio en cuanto el venteo o la sala se muevan.
    Y el docstring de fuga_budget.py decia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
2026-09-04 La revision adversarial encontro un artefacto aseverado y un calor sin contar
    Seis lentes sobre la rama entera. La verificacion de hallazgos se quedo a
    medias --165 de 207 escepticos murieron por cuota semanal-- asi que cada uno de
    estos lo reproduje yo antes de tocar nada. Ocho arreglos, dos de ellos gordos.
    1. ASEVERE UN ARTEFACTO DE MI PROPIO MODELO COMO HALLAZGO. fuga_budget.py hacia
    el divisor de modo comun con MAGNITUDES: z_local y z_estrella devolvian
    |wL - 1/wC|, y con dos magnitudes no negativas la fraccion zl/(zl+ze) cae
    siempre en (0,1]. O sea que "D-F5 nunca empeora" era cierto POR CONSTRUCCION
    del modelo, y el guion publicaba como hallazgo su borde: "el peor punto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
2026-09-04 El recinto subio a 31,25 W anoche y el cajon del case seguia en 147,83
    La tanda A metio en calor_budget.py el calor de la franja de red --NTC de
    arranque 2,75 W y choke 0,95, que la tabla del papel sec.6 no llevaba-- y el
    recinto de la fuente paso de 27,53 a 31,25 W. Lo que NO se propago es que ese
    numero es un sumando de potencia_disipada del case: 27,53 + 120,3 = 147,83
    seguia escrito en params.scad, en clearance_budget.py y en el README del case.
    Ahora son 151,53, con el desglose y de donde sale cada mitad.
    Y de paso el papel de la fuente se pone al dia con el techo del case, que
    cambio en el PR #311 el mismo dia: 15 K era "SUPUESTO de diseno" sin fuente y
    tuning_budget.py llevaba semana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
2026-09-04 El a_ef del case estaba copiado a mano en la fuente, y ahora hay quien lo mira
    A_EF_BASE_MM2 = 3299.0 es una copia de la salida de case/clearance_budget.py, y
    calor_budget le SUMA su area_venteo_mm2: si el case cambia sus rejillas o su
    rendija y nadie mueve esa constante, el venteo minimo que la fuente publica sale
    de una geometria que ya no existe. La sesion del case y esta acordaron avisarse
    antes de tocarlo; un aserto lo hace mejor que un protocolo entre dos personas.
    test_el_area_base_es_la_que_el_case_tiene_hoy() recalcula el a_ef desde
    params.scad y compara. Cuesta 1 ms.
    Y VIVE EN EL CONTRATO, NO EN EL MODULO, a proposito: un assert a nivel de modulo
    reventaria el import de calor_bud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
2026-09-04 Los 151,53 W del case eran una copia que nadie miraba, y ademas eran 151,55
    potencia_disipada vive en params.scad porque el CAD lo necesita, pero el
    numero se DERIVA en hardware/01-power-supply/v4/calor_budget.py. Era una
    copia a mano en cinco sitios y nada la vigilaba: el 03-09 la fuente metio
    la franja de red en su modelo --2,75 W de la NTC de arranque y 0,95 del
    choke-- y aqui seguia el 147,83 del dia anterior. Con esa copia rancia se
    le publico al #289 un encargo de 25113 mm2 de venteo cuando eran 25742.
    guarda_potencia_vigente() cruza la copia contra p_cajon_w(PLACA_A) +
    p_recinto_w(PLACA_A). Es ROJO y no HUECO: un desfase no pide rediseñar
    nada, se arregla copiando un literal, y hast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
2026-09-04 151,53 era una transposicion: 31,25 + 120,3 son 151,55
    Lo cazo el cruce nuevo de clearance_budget.py en su primera corrida, antes de
    mutar nada: p_cajon_w(PLACA_A) + p_recinto_w(PLACA_A) da 151,55 exacto. Al
    propagar el calor de la franja de red anoche subi el recinto de 27,53 a 31,25 y
    teclee la suma con los dos ultimos digitos cambiados. 147,83 llevaba bien sus
    27,53 + 120,3; el 151,53 no.
    Mueve poco --0,02 W-- pero arrastra las cuatro cifras que el papel publica como
    encargo, y son de las que se citan durante meses:
    encargo del case 25 742 -> 25 745 mm2 totales (22 442 -> 22 446 nuevos)
    contando la pared 20 572 -> 20 575
    con C_D = 0,55 30 422 -> 30 426
    di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
2026-09-04 Dos cifras contra el mismo riel, y solo una decia contra que
    El bloque final de consumo_total_budget.py imprimia dos numeros referidos
    al mismo riel: la fraccion POR_CONFIRMAR (137,8 mA, con su porcentaje al
    lado) y el margen sobre el techo (160 mA, en mA pelados). El segundo
    dividido por el consumo da 47 %, que es lo que publique ayer como si fuera
    la fraccion dudosa. La fraccion dudosa es 41 %.
    No fallo el modelo: fallo la copia entre lo que el guion imprime y lo que
    se escribe fuera. Es el mismo defecto que se corrigio en la tabla del §6
    del papel de la fuente v4 --dos filas en unidades distintas bajo un solo
    encabezado-- y se corrige igual: nombrando los operandos en la propia
    linea.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
2026-09-04 Las dos hojas del pre-regulador candidato, declaradas y no versionadas
    La sesion de la fuente v4 no podia cruzar la tabla de candidatos de la
    opcion (b) porque las hojas vivian en el Desktop de Samuel: "la regla de
    la casa es que ningun numero entra sin su hoja en el arbol". Esto lo
    arregla, PERO NO COMO YO IBA A HACERLO.
    Mi primer intento fue copiar los dos PDF a docs/reference/datasheets/ y
    versionarlos. El .gitignore lo paro, y su comentario explica por que:
    "lo que no se puede volver a bajar no es el PDF sino SABER CUAL... una
    hoja sin su revision no es una fuente". La politica esta en el commit
    5b55ea5: "El RM0486 entra al disco y no al historial, y el indice pasa a
    ser el registro". A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
2026-09-04 La (b) pasa de adjetivo a tabla, y solo arregla media cadena
    El punto 1 del bloque de enmiendas dejaba la (b) como "otro pre-regulador
    con referencia mejor y menos dropout". Con las dos hojas ya declaradas en
    docs/references.md (PR #317) la opcion tiene cifras, leidas de tabla por mi
    y no copiadas de la propuesta que las trajo.
    requisito: ventana + dropout <= 1.270 V (setpoint 13.100, llegan 14.370)
    LM2941 (hoy) 0.658 V 1.00 V a 1 A pide 14.758 -388 mV
    LT1963A Rev G 0.390 V 0.55 V a 1.5 A pide 14.040 +330 mV
    MIC29152 A 0.391 V 0.60 V a 1.5 A pide 14.091 +279 mV
    Calculado con margen_budget.py -- el mismo apilamiento que ya esta en
    verde, cambiando solo las dos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
2026-09-04 U2, dicho como especificacion de compra y no como queja
    El bloque de la (b) decia que U2 se queda sin arreglo y ahi lo dejaba. Le
    falta el numero que convierte eso en algo accionable:
    U1 U2
    presupuesto de ventana+dropout 1.270 V 1.470 V
    lo que gasta la pieza de hoy 1.658 V 1.640 V
    para batir la incertidumbre 1.143 V 1.343 V
    O sea que U2 no necesita un LDO negativo excepcional: necesita uno 300 mV
    mejor que el LM2991 en la SUMA de ventana y dropout. Y el reparto importa,
    porque todo el desajuste sale del dropout SOBRE TEMPERATURA --0,8 V a 25 C
    contra 1,0 garantizado-- y no de la referencia.
    Dicho asi es una busqueda acotada.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
2026-09-04 La particion tampoco arregla U2: segundo argumento retirado hoy
    Quedaba una via plausible: si todo el desajuste de U2 sale del dropout
    sobre temperatura, sacar 12,80 W de la caja deberia enfriar el aire y
    devolver margen. Verificado con margen_budget y no llega:
    aire 68.9 C (hoy) margen U2 -169.7 mV
    aire 67.6 C (recinto vaciado) margen U2 -163.8 mV
    aire 50.0 C margen U2 -84.6 mV
    aire 25.0 C margen U2 +27.9 mV
    Seis milivoltios por vaciar medio recinto, y el equilibrio esta en aire a
    temperatura AMBIENTE: un recinto sin calor dentro. La razon es estructural
    -- la temperatura del aire la domina el cajon (120,3 W) y lo que se qu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
2026-09-04 El hilo unico nunca fue diseno: era una coincidencia con suerte
    El aviso de polaridad decia QUE se rompio y COMO arreglarlo, pero no lo que
    importa para la tanda B: el hilo unico nunca fue una decision. Sobrevivio
    porque las dos piezas que la v3 eligio por otros motivos --margen y ruido--
    resultaron habilitar igual, y se perdio en cuanto una cambio por una razon
    que no tenia nada que ver con el secuenciador.
    Y se habria perdido igual por el otro camino. El regulador positivo
    flotante que se estudio hoy para U2 rompe el mismo hilo por REFERENCIA en
    vez de por polaridad: dos caminos distintos, el mismo dano, y ninguno de
    los dos lo buscaba. Que dos vias independientes tumben la misma propieda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
2026-09-04 El mapa del proyecto son los hitos, y todo issue lleva uno
    Hasta hoy no habia mapa: 103 issues abiertos sin hito, cero milestones y
    tres epics (#2, #25, #29) que describen tres arquitecturas que ya no
    existen (fuente con 7805, cuatro voces, cerebro RP2350). El 2026-09-04
    Samuel decidio que el norte viva en hitos de GitHub: ocho etapas, de la
    fuente v4 en papel al primer SAM17 que suena, con el «hecha cuando» y lo
    que la traba en la descripcion de cada hito.
    CONTRIBUTING lo deja escrito en el sitio donde se abre un issue: todo
    issue lleva hito al crearse, y si no cabe en ninguno va al 8 diciendo por
    que. Un issue sin hito es un issue que el mapa no ve; asi murieron los
    epics.
    Co-Authored-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
2026-09-04 La l.6 decia "cuando la v4 se adopte" y ya estan cerrados
    Samuel decidio el 2026-09-04 cerrar los cuatro abiertos de la lista de
    defuncion tomando este papel FIRMADO como certificado, sin esperar a que la
    v4 se fabrique. Verificado: #141, #106, #56 y #57 estan CLOSED/NOT_PLANNED,
    y #280 ya estaba cerrado como completado.
    O sea que la linea seguia anunciando como condicion futura algo que ya
    ocurrio por otra via. Es el mismo defecto que se corrigio hoy en tres
    guiones --el artefacto describe un estado que el proyecto ya no tiene-- y
    la l.6 es de las que se citan: la otra sesion la cito para cerrarlos.
    Y se le anade lo que el barrido de hoy dejo probado y no estaba escrito en
    ningun sitio: E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
2026-09-08 La E16 llega al papel de la v4, salvo lo que el guion todavia no sabe
    El #331 mandaba aplicar la E16: el papel firmado publicaba cifras que
    calor_budget.py ya no sostiene desde que D1 retiro la cadena WS2812.
    Aplicado, con los valores leidos del guion y no del issue:
    §4.4 la columna "Cadena" se tacha; el total pasa de 4,935 a 2,895 A
    §6 PS6 de 4,88 a 2,86 W, y aparecen las dos filas de la franja de
    red (NTC 2,75 y choke 0,95) que la tabla no tenia
    §6 total del recinto de 27,5 a 29,23 W, y los sumandos cuadran
    §8 nota 8 31,25 -> 29,23 W
    Cada celda lleva el valor viejo tachado, la fecha y la constante de la
    que sale. No se transcribio ningun numero a mano.
    DOS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
2026-09-08 Las cuatro politicas, decididas: y tres obligaciones que no existian antes
    De los 16 huecos, once eran requisitos comprables y cinco eran
    decisiones. Las cuatro independientes quedan tomadas; la quinta se
    deriva de una de ellas.
    H-V2-RECUPERACION reintentos con abandono
    H-V5-INCOMPATIBLE contrato exclusivo
    H-V5-INVERSION bloquear, y recuperar al corregir
    H-V5-CALIENTE desenergizado como norma, accidente cubierto
    H-V5-RECONEXION se deriva: hereda los reintentos
    Ninguna cierra su hueco. Compran la direccion, igual que las firmas del
    mismo dia: los numeros siguen en H-V2-RESERVA, H-V2-TRANSITORIOS y
    H-V2-ENTRADA, que son de fabricante. Lo que cambia es que ya no hace
    f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
2026-09-08 La pregunta del #5607 volvio contestada: seis enmiendas al papel del maestro del J2
    El papel mandaba preguntar upstream (§9, accion 1) si el cuelgue del SPI del N6
    era de una instancia o del bloque. Se pregunto el 2026-09-03 y jake-taf, uno de
    los dos reportantes originales, contesto el mismo dia. Nadie habia traido la
    respuesta al papel.
    ## Lo que contesto, y lo que cambia
    - **«I have observed this problem on SPI1 as well»**: hay cuelgue en DOS
    instancias, SPI5 y SPI1. No es exclusivo de SPI5, que era la premisa
    declarada. La fila del alcance se cierra por upstream; la causa --silicio o
    driver-- sigue abierta.
    - **Consecuencia de diseno**: cambiar de instancia no es una salida de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
2026-09-09 La firma del 2026-09-09: cuatro N657, uno por trabajo, y los dos censos la recorren
    Samuel firmó el 2026-09-09 las dos decisiones que el papel del hub llevaba
    pendientes desde el 2026-08-30. Este commit las REGISTRA; no diseña nada.
    «la idea es que tengamos un procesador solamente para la parte analogica,
    un procesador solamente para la interface grafica y controladores, un
    procesador solo para la IA, un procesador solamente para la interface de
    audio, la razon de ese diseño es que queremos tener suficiente headroom
    para procesamiento y que el instrumento jamas se cuelgue.»
    D3-PRIMA FIRMADA. El tercer N657 para la IA existe, con su forma de módulo
    por J2. Con eso muere la c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
2026-09-11 Un chip por trabajo, una SRAM por chip, un censo por SRAM: los papeles dejan de hablar de la olla unica
    El PR #357 partio el censo de SRAM en dos y midio el binario del hub
    (82 280 B en c521302). En los papeles solo se repuntaron los nombres de
    archivo; la prosa siguio describiendo un chip que lo hacia todo. El #358
    listo quince frases falsas en cuatro papeles. Tres ya las habia arreglado
    la firma del 09-09 (2d3a4a5): la fila «pendiente» de la enmienda y las
    filas 2 y 11 del S10 del hub. Este commit cierra las doce restantes.
    Lo que cambia, papel por papel:
    - Hub S2.1: la razon 2 de D1 se apoyaba en «el censo daba rojo en las
    cuatro configuraciones». Ese rojo salia de un binario ESTI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
2026-09-11 La errata del STM32N6 entra al árbol: ES0620 Rev 5, sin ningún ítem del SPI
    Hasta hoy docs/reference/datasheets no tenía la hoja de erratas de ningún chip del proyecto (junta del 2026-09-11, Richter). Esta es la del N657, Rev 5 de agosto de 2026, bajada por Samuel: 1,6 MB, así que va versionada como el DS14791 y no en disco como el RM0486. Diecisiete periféricos con limitación; el SPI no está entre ellos. Tres ítems abren trabajo: §2.2.1 el prescaler de APB no funciona (#363), §2.2.22 selectores de reloj antes de un reset por software (#364) y §2.15.1 VBUS, que confirma #350.
    Claude-Session: https://claude.ai/code/sessio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
2026-09-11 El acta del J2 del 11-09: enmiendas a D2 y §9, la fase B desbloqueada, y la junta en el árbol
    Samuel frenó la tarea 7 preguntando si se puede confiar el J2 al SPI del N657. Seis lentes en junta, la errata ES0620 leída después (sin ningún ítem del SPI), y la firma en el artifact «Acta del J2»: seguir con el N657 y nada se fabrica sin medir; cero artefactos audibles como límite; primero las enmiendas y después el driver; la Nucleo ahora.
    Lo que este PR aplica sobre la spec firmada, habilitado por esa firma: en D2 la espera anclada de un ciclo de SCK entre SPE=1 leído de vuelta y CSTART, por analogía con ES0396 §2.14.2 del H7; en §9 la puerta de fabricación, el límite firmado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
2026-09-18 La fase B del J2 tiene plan, y el Drop del GPDMA tiene cota: T_CANAL y escalada por RCC en vez de IWDG (#368)
    El acta del 11-09 dejó firmado el orden (enmiendas, driver, tarea 8, binarios) y la Nucleo comprada. Este commit escribe los pasos de la fase B en docs/superpowers/plans/2026-09-18-j2-fase-b.md: el driver (7a-7d, con el Turno de D2 en core), el ejecutor (8), el esclavo del banco en SPI4 que ningún papel había encargado (9), los cuatro binarios del acta (10) y las dos erratas del ES0620 que muerden el día uno (11: #364, 12: #363).
    La decisión del #368 va como enmienda del 18-09 a D4.2 y R-MJ2 del papel del maestro: el driver no suelta ningún Transfer mientras su canal pueda cor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
2026-09-18 Antes de un reset por software, los diez selectores de reloj a su defecto (ES0620 2.2.22): reinicio::por_software, y el aviso del banco para probe-rs (#364)
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2026-09-18 El firmware deja RTCSEL en su defecto: el mux.init de embassy pisaba el Lsi de ls.init y armaba la errata 2.2.22 en operación normal (#364)
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2026-09-18 La espera del LSI antes del reset tiene cota: tsu(LSI) 180 µs (DS14791 T57 p. 166), y un LSI muerto degrada en vez de colgar (#364)
2026-09-18 reloj_budget: un solo techo de 200 MHz con su fila de la DS, y la prosa deja de afirmar el margen (#363)
    Ronda de arreglo 1. Los dos hallazgos son del commit 09e7538 y los dos son
    ciertos.
    1. El aserto del fPCLKx no podia fallar. La guarda de _derivadas fija
    PPRE_DIV = 1 y ic_hz(x, 1) devuelve x exacto, asi que pclk no es una copia de
    hclk: ES hclk. Y el aserto de la linea de arriba ya cobraba hclk contra el
    mismo numero. Ninguna solucion podia morder el segundo sin haber muerto en el
    primero: vigilancia de adorno, justo lo que su comentario prometia no ser.
    La otra mitad: los 200 MHz del bus estaban declarados dos veces y con distinta
    calidad de cita -- constante con la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
2026-09-18 El driver del J2: la ISR copia banderas y generacion, giro arma D2 enmendada con los Transfer bajo ManuallyDrop, y el plazo abraza las dos esperas
    `j2_spi.rs` deja de ser cabecera y pasa a ser el driver (spec D1-D4, tarea
    7c del plan de la fase B).
    - `Ranura::nueva` pone los cuatro pines en AF5, hace el reset por RCC
    (paso 0 de D4), escribe los `CFG2`/`CFG1` fijos de D1 (maestro,
    `SSM = 0`, `SSOE = 1`, `SSOM = 0` p. 3437-3438, `AFCNTR = 1` p. 3444 y
    p. 3450, `DSIZE = 7`, `CRCEN = 0`), calcula el `MBR` contra el reloj
    sancionado e imprime el `f_sck` real, y deja el SPI apagado. Asevera
    R-MJ7 leyendo `CCR.DC` y que los registros son los de
    `SPI_DE_RANURA[ranura]`.
    - `giro` sigue e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
2026-09-18 D4 en el driver: los ocho pasos con su pagina, y soltar_canales con cota T_CANAL que escala al reset del GPDMA1 por RCC en vez de girar (#368)
    El paso 2 de D4 deja de apoyarse en la espera sin cota del `Drop` de
    embassy (gpdma/mod.rs:1287, `request_reset()` y luego
    `while self.is_running() {}`). `soltar_canales` pide el reset a los dos
    canales, sondea `is_running()` como maximo `T_CANAL` y solo entonces los
    suelta, con lo que ese `Drop` entra y sale. Si un canal no para dentro
    de la cota, no se suelta ninguno de los dos y se resetea el GPDMA1
    entero por RCC: las otras cinco ranuras ven sus futuros de DMA
    resolverse, no reciben `EOT`, vencen su plazo y ejecutan D4 cada una.
    Un reinicio de las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
2026-09-18 La cota de T_CANAL dejaba de existir dentro de request_reset: ahora es request_pause, y con ella entran el unpend del NVIC, el f_cpu del llamador y los canales atados al GPDMA1 (ronda de arreglo 1)
    Cinco hallazgos de la revision del driver, uno critico.
    **Critico. La cota de `T_CANAL` era codigo muerto.** `soltar_canales`
    pedia `request_reset()`, y `Channel::request_reset` (gpdma/mod.rs:901-910)
    es `self.request_pause(); while self.is_running() {}` **y luego** el
    `CxCR.RESET`: el bucle sin cota de la linea 907 corria antes de que
    existiera el `limite`, y cuando el sondeo acotado se evaluaba los canales
    ya estaban parados. `Soltado::Escalado` era inalcanzable y
    `ESCALADAS_GPDMA` no podia sub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
2026-09-18 El plazo sale del f_sck que la ranura conoce, el lazo se realinea tras un plazo vencido para no borrar T_GAP, y el banco se muda a su propio archivo (ronda de arreglo 1)
    Cuatro hallazgos de la revision del ejecutor, mas los menores que caian en
    lineas que habia que tocar igual.
    **El `f_sck` real se tiraba y `arrancar` recibia el pedido (R17).** El
    `MBR` solo da potencias de dos y redondea hacia abajo: con 10 MHz pedidos
    y el kernel en HSI 64 el real es 8. Hoy `FACTOR_PLAZO = 2` lo absorbe por
    construccion (`f_real > f_pedido/2`), asi que no habia falso reinicio,
    pero `plazos_j2` y la columna `reloj_MHz` de `resistencia_j2.csv` habrian
    salido etiquetados con un reloj que no existe, y al sell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
2026-09-18 El esclavo del banco: el futuro de su tarea es Send, la cuenta del ultimo byte dice la verdad del BNDT, y el aire del rearme es la cadencia (ronda de arreglo 1)
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2026-09-18 Los cuatro binarios del banco: control positivo, barrido del retardo, resistencia (la fila del CSV) y plazos (el osciloscopio), en el orden del acta del 11-09
    EN-PLACA sec.«Las tres medidas del maestro» decia que el driver no existia
    todavia, que cada medida era «un binario propio en `src/bin/`, que no
    existe todavia», y listaba `eot_al_aire` como si siguiera siendo cien mil
    transferencias. Las tres cosas dejaron de ser ciertas. El cuerpo se
    reescribe entero; la **enmienda del 11-09 se queda intacta**, palabra por
    palabra, porque sigue vigente y porque es lo que `fix/364-reset-seguro`
    esta ampliando por su lado.
    El titulo se queda en «Las tres medidas» a proposito: el plan de la fase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
2026-09-18 EN-PLACA: la linea de arranque lleva la revision de git, la fila del soak va precedida de firmware=, y el NVIC ya no es cosa de los binarios
    Tres cambios en sec.«Las tres medidas del maestro», todos porque el codigo
    publicado cambio en la ronda de arreglo 1. La enmienda del 11-09 sigue intacta.
    1. **`firmware <rev>` en la linea de arranque de los cuatro**, con que es (sha
    corto, `-sucio`, `sin-git`), quien lo pone (`build.rs` en `SAM17_GIT`) y la
    orden: anotarlo con cada medida, porque sin el una fila del CSV o una captura
    del osciloscopio no se puede repetir.
    2. **`resistencia_j2` publica cuatro lineas por hora, no tres**: `firmware=<rev>`
    delante de la fila -- fuera de las d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
2026-10-01 La Nucleo en el banco: el PHY del USB sale del cristal, una sola puerta a init baja el PRIMASK que deja probe-rs, y embassy con el arreglo del PHY
    El primer dia con la NUCLEO-N657X0-Q en la mesa (2026-10-01). Arranca y
    Windows la enumera como "SAM17 nucleo" a alta velocidad. Para llegar ahi:
    - Cargo.lock: embassy del fork `n6-usb` pasa de dc6b716 a 697ec64, que trae el
    arreglo del bring-up del PHY (embassy-rs/embassy#7146). El `phy_init` del
    #6939 tocaba USBPHYC_CR con el reloj del OTG apagado y el bit 23 de
    AHB5RSTR puesto, y en placa eso colgaba el bus a los 0,12 s de `main`.
    - usb::iniciar(): la unica puerta a `embassy_stm32::init`, para `main` y los
    cuatro binarios del J2. prob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
2026-10-01 La medida (0) del J2, hecha en placa: prender el SPI5 no levanta EOT, ni en esclavo ni en maestro
    `control_positivo` con el firmware 259bc91 imprime eot_al_encender=0 con el
    SPI5 recien reseteado (esclavo) y eot_al_encender_maestro=0 con MASTER = 1;
    una corrida anterior con el mismo codigo sin commitear dio lo mismo.
    Es la medida que el acta del 11-09 ponia primero ("un acceso, dirime H-1"),
    y su lectura ya estaba escrita en la spec del maestro, bajo D2: si vuelve 0,
    D2 ya la cubria, y la errata 2.14.2 no es el mecanismo de #5607 en esta
    configuracion. Se anota alli, con la fecha y la revision, y en EN-PLACA.md.
    Lo que sigue en el orden del dia es (1), el control positivo de una hora.
    Co-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
2026-10-01 El hub lleva cristal HSE: acta del 2026-10-01, y el censo de relojes saca el PHY de las PLL y cierra la mesa con dos
    Samuel, el 2026-10-01, ante la medida de la Nucleo: «metamosle cristal HSE».
    - Papel del hub, S0: el acta, textual, y su interpretacion fuera de la cita.
    La referencia de 24 MHz del PHY de USB HS sale del cristal y no de una
    PLL. Manda la hoja ademas de la medida: el HSI deriva de -5 % a +5 % con
    voltaje y temperatura (DS14791 Rev 10, p. 165) y el USB de alta velocidad
    pide +-500 ppm. Lo que el acta NO decide, dicho: la frecuencia (38,4, 40 o
    48 MHz caben sin mover un selector de la errata §2.2.22; 48 es la unica
    medida y esta en el techo de la Tabla 49, p. 161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
2026-10-01 El cristal del hub es de 48 MHz: firmado el mismo 2026-10-01, y del HSE solo queda sin elegir la pieza
    Samuel, ante las tres frecuencias que caben (38,4, 40 o 48 MHz) y el aviso de
    que 48 esta en el techo de la Tabla 49: «si la nucleo funciona bien con 48 que
    sea de 48 hombre. sin miedo.»
    - Papel del hub, S0: la cita textual y su interpretacion, debajo del acta del
    cristal. 48 MHz es el de la NUCLEO-N657X0-Q y el unico medido; su mitad, 24
    MHz, es FSEL legal con OTGPHY1SEL en su defecto, y no se mueve ninguno de
    los diez selectores de la errata §2.2.22. El techo del rango queda dicho y
    aceptado. La frecuencia sale de la lista de lo que el acta no decide.
    - reloj_budget.py: 48 MH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
2026-10-01 La medida A del J2, hecha en placa: 358 minutos, 0 cuelgues, y un cuelgue cada 2 h o menos queda descartado al 95 %
    control_positivo con el firmware 4d2d6f2 (los PNG borrados explican el
    -sucio) corrio de 14:12:21 a 20:13:51: 358 filas seguidas en el log,
    37 160 399 lecturas, 103 800 en cada minuto, 0 cuelgues, 0 lineas de error.
    Faltan las filas 359 y 360; probable bufer al parar probe-rs, sin verificar.
    Con cero en 358 min: periodo medio de 15 min tiene P(0) = 4e-11, de 30 min
    6,6e-6, de 60 min 0,26 %, de 120 min 5 %. Regla de tres: periodo medio
    >= 119 min al 95 %. Cubre casi entero el "every 30-120 minutes" de jake-taf.
    No dice que el defecto no exista.
    Registra tambien lo que Samuel d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
2026-10-02 El eco del control positivo: puente MOSI-MISO a 16 MHz, patron por vuelta, detras de --features eco
    jake-taf reporto el 2026-10-02 en #5607 que con el embassy main de hace dos
    dias SPI1 se le sigue colgando (5 veces en 14 h) y que "regularmente" ve
    errores de CRC. El banco no podia ver corrupcion: MISO al aire y nada que
    comparar. Samuel decidio el mismo dia ir primero con el eco.
    Con --features eco, control_positivo:
    - pide 16 MHz, lo mas rapido que da el kernel de hoy (32 MHz / 2);
    - antes del bucle manda 8 bytes de prueba (ceros, unos, alternancias) y,
    si no vuelven iguales, hace panic: sin puente no hay medida;
    - en el bucle, blocking_transfer de 8 bytes con la vuelta y su
    complemen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
2026-10-04 B y el eco del J2, medidos en placa: 26 h sin un fallo, y el control positivo sigue sin dar positivo
    B (bucle del primer reporte, 125 kHz, firmware 7a01671): 358 minutos,
    78 174 777 vueltas, 0 cuelgues.
    El eco (puente D12-D11, 16 MHz, transfer de 8 bytes con patron por vuelta,
    firmware fea2a17): una hora (56,8 M vueltas) y una noche de 798 minutos
    (755,5 M vueltas; la corto Samuel al desconectar CN10 sin querer, 15 s
    despues de la ultima fila). 0 corrupciones, 0 errores del driver, 0
    cuelgues: 6 499 millones de bytes comparados.
    jake-taf reporto el 02-10 que con main se le sigue colgando (5 veces en
    14,1 h, SPI1) y que ve errores de CRC "regularmente". Con su ritmo, la noche
    sola daria cer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
2026-10-09 Las fichas pendientes del acta, cada una con su issue: #389 a #397, y la pieza de prueba de los HUECOS 10 y 11 en #398
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2026-10-10 Las rendijas de la ficha 6: el borde de la piel cae sobre el riel abajo y arriba, y una guarda lo vigila por los dos lados
    - piel_organica.scad: la ventana de las filas ya no se abre entera de P1 a P4.
    La lamina sube por la cara de abajo hasta el canto del riel del frente
    (borde_ventana_inf, 12.5) y baja por la de arriba hasta el del riel del
    remate (borde_ventana_sup, 147): entre piel y panel queda el ala del riel,
    2 mm rectos. La cubierta pasa a 933 g; las tres reglas en verde.
    - clearance_budget: guarda_labio_ventana() (gemela de las dos funciones) exige
    >= 1 mm a la huella del panel, que sale de frente, y no mas aire que el ala
    del riel; su canario prueba los dos lados. El is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
2026-10-11 La persiana, versión 2: lo que cambió con la junta, y el guion que imprime sus cifras
    La junta del 11-10 (censo, Serrano y Elke) tumbó cuatro cifras y dos
    imposibles de la versión 1, y este commit los corrige:
    - El aire: piel_termica.py ponía la entrada a H/4 y la salida a 3H/4 para
    cualquier ventana. persiana.py calcula con el plano neutro (cada hueco a su
    altura), que con una entrada y una salida da exacto lo de _tiro(). Con
    varilla de 2,0 a paso 6,2 el pesimista daba 20,1 K; a paso 7,0 da 18,8 K.
    - La sujeción: en 2 mm de banda no agarra una rosca y por dentro no se llega
    (paneles fijos desde la tanda B). Tacos e imanes, con diez bolsillos en la
    cara del anillo que ahora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
2026-10-12 El plan del aire: el plano neutro en la puerta, la potencia de la v5 y lo que cuelga del #289
    Cinco tareas: la potencia de la fuente v5 (64.22 W) con guarda_potencia_vigente()
    contra ladrillo_budget.py; el plano neutro en clearance_budget.py con su cuenta
    a mano; _tiro() con las franjas de las dos persianas y guarda_aire() de nuevo
    como aserto con C_D 0.65; el papel; y el cierre del #289. La cadena térmica de
    la v4 se queda como base de la v4, y la sala de 45 °C se publica como HUECO
    hasta que se decida la del case.
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2026-10-12 El plano neutro vive en el budget, con su cuenta a mano
    _plano_neutro() pasa de persiana.py a clearance_budget.py, que es donde está
    la puerta del aire. autocomprobacion_plano_neutro() la fija con una entrada de
    3 y una salida de 4 a 25 mm, que dan yn = 16 y S = 12 exactos: la misma cifra
    que la cuenta en serie, y con una salida más el plano sube y S crece.
    persiana.py la usa en vez de la suya y sus cifras no cambian.
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2026-10-14 J2: el armado limpia TXTF y el reinicio resetea el SPI por RCC
    El primer punto del barrido del retardo dio en placa 2 132 418 plazos
    vencidos de 2 132 419 armados. Eran dos defectos del driver propio,
    encadenados:
    - TXTF no se limpia solo (RM0486 p. 3492: solo con TXTFC) y el cierre de
    una transferencia buena no lo tocaba. Con TXTF puesto al armar, el GPDMA
    no recibe ninguna petición de TXDR y el maestro no saca reloj. El armado
    escribe ahora TXTFC después de SPE = 0.
    - El reinicio de D4 pedía CSUSP. Si la suspensión no se acepta antes de
    SPE = 0 (un maestro parado sin trama en curso, o un aborto a 125 kHz con
    T_SUSP de 10 µs), queda pendiente, sobrevive a SPE = 0 y ningún C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
2026-10-16 fw: perfilador por muestreo del PC (feature muestreo, perfil_pc)
    TIM6, a la prioridad más alta (P0, por encima de las ISR del J2 y del
    ejecutor), anota el PC apilado en la excepción a 21 kHz en un histograma de
    16 384 cubos de 2 bytes sobre el código. perfil_pc.py lo lee de la RAM con
    probe-rs y lo cruza con los símbolos del ELF: da el reparto por función de lo
    que gasta la CPU, que carga_j2 solo separa en los tramos que alguien acotó.
    Es un módulo propio porque probe-rs profile 0.32 no arranca (pide un argumento
    reset que no deja pasar) y DWT_PCSR lee 0xFFFFFFFF en el M55 de la placa. La
    ISR es un trampolín en ensamblador (lee MSP antes de cualquier push) que salta
    a una función R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
2026-10-17 fw: la cota por interrupciones publica sus fallos y el guion comprueba que el lazo gira
    carga_j2 --isr imprimía plazos_vencidos desde la política, que j2_isr nunca
    alimenta, así que una corrida con tics sin cerrar salía con cero. Ahora suma los
    giros sin cerrar y los errores del DMA del propio transporte, y carga_j2.py marca
    como inválida una pasada cuyo ciclo se aparta más de un 5 % del periodo sin que
    un atraso lo explique: con el ejecutor el calendario deja un periodo de hueco y
    cuenta el atraso; el transporte por ISR no tiene calendario, y un ciclo de tres
    periodos es que se saltaron tics.
    j2_isr: un giro cuyo EOT llega pero cuyo DMA no acabó bien se contaba y dejaba la
    ranura en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
2026-10-17 docs: la cota por ISR completa un giro por tic, y lo que pesa de verdad la maquinaria
    EN-PLACA: la cota de j2_isr, medida con el guion que ahora cuenta sus giros sin
    cerrar y sus errores del DMA, completa un giro por tic en las tres pasadas
    (ciclo de 125 us, 40 000 giros en 5 s) en tres corridas seguidas. La tabla pasa
    a la compilación a3fd211, y se dice que sin cachés las cifras varían hasta un 40 %
    entre compilaciones (el giro por ISR dio 10 200 y 14 400) y con la D-cache menos
    de un 1 %.
    Se corrige «lo que no es código de la tarea son 5 300 ciclos, el doble del
    límite»: la maquinaria de futuros y el despacho son 3 104 (1,24 veces), la ISR del
    SPI la paga cualquier transporte y ~1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
2026-10-17 Junta del transporte del J2: los informes de Serrano, Halberg y Voronov, y el papel v2
    Serrano (15 hallazgos, 2 BLOCKER), Halberg (siete rupturas de ejecución, con
    simulación de seis ranuras) y Voronov (la clausura: un límite de CPU sin censo,
    tres dueños del canal del GPDMA, los testigos que llevaba Calendario) refutan el
    papel v1 en sus mecanismos: el cierre en el EOT sin esperar al DMA, la
    recuperación sin CxCR.RESET, las doce IRQ de canal sin dueño, el desempate tic/EOT
    por número de IRQ y tres estados que esperaban sin plazo.
    El papel v2 sustituye la interrupción del SPI por la lectura de SR en un único tic
    por periodo, absorbe cada hallazgo en un registro, declara lo que nece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
2026-10-17 core: transporte_j2, la máquina de una ranura del transporte por tic
    Prototipo de banco del papel v2 (acta del 17-10, ficha 3). Una función pura: en
    cada tic recibe lo que se lee de los registros (EOT, TCF de los dos canales, error
    del DMA), si la ranura tiene identidad y bajada fresca, y si la recuperación
    arrancó o acabó, y dice si hay que cerrar, armar, qué eventos pasar a la política
    (Armada, GiroOk, PlazoVencido) y qué contar aparte (sin bajada, error del DMA,
    ranura muerta).
    El tiempo se cuenta en tics: el plazo de D3 es tics_de_plazo de los microsegundos
    de plazo_us, y la edad de una transferencia, cuántos tics lleva armada. Un EOT en
    el tic del vencimiento se acepta. Vencid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
2026-10-17 fw: j2_tic, el transporte del J2 por tic, y sus tres binarios de banco
    La máquina de core::transporte_j2 movida por TIM7 (P1): por cada ranura armada
    lee SR del SPI y de los dos canales del GPDMA, ejecuta lo que la máquina diga
    (cerrar, armar) y empuja los eventos a un anillo. El planificador (DMA2D, P3) es
    el único que llama a la política, con el reloj tic x periodo, copia la subida con
    ldm, la juzga y compone la trama siguiente en el buzón de tres casillas. La
    recuperación (JPEG, P4) hace D4 con CxCR.RESET, el reset del SPI por RCC junto a
    CFG2 y CFG1 en una sola sección crítica, la reprogramación completa de los dos
    canales y, si un canal no para en T_CANAL, el reset del GPDMA1 c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
2026-10-17 fw: marcos numerados en los dos sentidos, tic_estres, tic_contenidos y la velocidad de borde de los pines
    La feature secuencia numera cada bajada con core::marcos_j2; el esclavo del banco la clasifica
    (rota, repetida, atrasada, o buena con los números que se saltó) y devuelve el último número
    aceptado en la subida, desde un búfer propio que escribe y limpia de la D-cache; el juez del cerebro
    clasifica la subida (rota, atrasada, futura). tic_estres corre cuatro fases -- sin nada, con golpes
    de P3 de duración y momento al azar, con cuelgues y errores del DMA, y con todo -- de 60 s (5 con
    corta) y pasa si no hay ninguna trama rota, repetida ni vieja, ninguna ranura muere y cada plazo
    venc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
2026-10-17 EN-PLACA: el transporte por tic con marcos numerados, la cota de espera y el cable del banco
    La sección «El transporte por tic» pasa a las cifras de 7bda894 y gana tres binarios: tic_estres
    (marcos numerados en los dos sentidos bajo golpes de P3, cuelgues y errores del DMA al azar), tic_cota
    (qué retención de P2 mata una ranura, con las cotas de v2 y con las de hoy) y tic_contenidos (qué
    contenidos rompe el cableado del banco, con los pines a VeryHigh y a Medium y con el MISO conmutando y
    quieto).
    Corrige lo que decía la sección: la escalada medida es forzada, la comprobación de contenido de la
    resistencia solo vale para el patrón regular y el cruce de una retención de P2 con un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
2026-10-17 docs: papel v3 con la segunda pasada de la junta absorbida
    El presupuesto de escaladas con sentencia desaparece: el permiso de escalar lo da la política con un umbral
    propio, sin permiso la ranura muere por su cota de siempre, y las vecinas que cruza una escalada reciben
    PlazoAjeno, que no puntúa en su salud. El tic cuenta periodos con el contador de ciclos en lugar de
    entradas, y las cotas pasan a µs (25 y 12,5 ms) con aserto contra la ventana del módulo. La máquina se
    escribe completa: identidad retirada, SUCIA como entrada con cota, Muerta sin salida y precedencias. La
    tabla de plazos se corrige (el TONO de 41 bytes son 2 tics a 6,25 MHz), un tic tardío puntúa en la salud,
    la laten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
2026-10-19 core: el apretón de manos de la recuperación lleva el incidente (K4)
    Cada entrada en Vencida (por su plazo, por un error del DMA o por la escalada
    de otra ranura) abre un incidente, numerado desde cero
    (Transporte::incidente). Entrada.incidente dice a qué incidente pertenecen
    reinicio_en_curso y reinicio_hecho, y la máquina solo los acepta si son del
    suyo: una HECHA que quedó publicada de un incidente anterior ya no devuelve la
    ranura a Libre sobre un SPI que nadie ha reseteado.
    En fw el tic publica el incidente de cada ranura, el planificador lo pone en la
    petición y la recuperación lo devuelve con EN_CURSO y HECHA; el modelo hace lo
    mismo.
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2026-10-19 core: el presupuesto de escaladas del GPDMA1 es del controlador (K1)
    core::escaladas_j2::Presupuesto concede como mucho E escaladas en una ventana
    deslizante, abierta por detrás, y una negada no gasta. Lo lleva la
    recuperación, el único escritor que escala, y cuenta en el reloj del tic: los
    periodos de RelojDelTic pasados a µs. Sin presupuesto, la recuperación hace el
    RESET por canal y nada más: ni HECHA ni reintento, así que la ranura muere por
    la cota de Reiniciando y el supervisor reinicia el chip, sin un segundo
    escritor del estado de la máquina.
    En fw, E = 3 en 1 s (estimados), con un reloj de 64 bits propio de la
    recuperación y el testigo escaladas_denegadas. El modelo elige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
2026-10-19 modelo: los escenarios de la tercera pasada de la junta con K1 a K5
    tests/junta.rs corre v3perm, v3a4, v3a4x2, v3a5, v3a8, v3sucia2 y v3ident2
    sobre core con el presupuesto del controlador, la marca en la máquina, el
    incidente en la recuperación, la política en Vacia y el supervisor, y
    comprueba lo que dice el papel v3: tres tics tardíos no niegan la escalada
    que cura y las vecinas acaban vivas y sin plazos propios; un canal que el
    reset no cura gasta E escaladas (una trama por vecina cada una), muere por la
    cota de Reiniciando y el supervisor reinicia el chip a W + T_IWDG de su último
    sello; ninguno de 126 desfases arma sobre canales sin programar; ninguna HECHA
    rancia rearma; y desenc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
2026-10-19 modelo: el barrido del presupuesto de escaladas con el fuzz de la junta
    tests/barrido.rs, ignorado por defecto (se corre en release): los dos fuzz de
    la junta, 30 semillas de 4 s, con E en {1, 2, 3, 4, 6} y la ventana en
    {100 ms, 1 s, 10 s}, más escalar siempre y el presupuesto retirado del v2 como
    referencia. Por celda: reinicios del chip, ranuras muertas, escaladas,
    denegadas y plazos ajenos por vecina. Y un canal que el reset no cura: tramas
    perdidas por vecina hasta que se acaba el presupuesto, y cuándo reinicia el
    chip.
    El modelo puede parar la corrida cuando el IWDG reinicia el chip, para no
    contar lo que pasaría después.
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2026-10-19 modelo: la escalada aplazada y el barrido de la espera contra K1
    Con `espera_escalada_ns`, la recuperación que recibe `Aplazada` no resetea ni publica
    `HECHA`: la ranura sigue en `Reiniciando` con su cota, y el planificador vuelve a pedir la
    recuperación del mismo incidente al cumplirse la espera.
    `tests/espera.rs`: con 2 ms de espera, un bloqueo del GPDMA1 de 1 ms gasta una escalada y no
    reinicia el chip en ninguna de las cinco fases (sin espera, lo reinicia); un canal que el reset
    no cura sigue gastando E escaladas y reiniciando el chip. El barrido (ignorado) cruza E y su
    ventana (3 en 1 s, 6 en 1 s, 2 en 100 ms) con esperas de 0, 1, 2 y 5 ms, con el bloqueo, el
    canal incurable y los do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
2026-10-19 J2 en TCM: lanzar asevera que el juez, la bajada y los resets están en la ITCM
    El J2 llama por puntero al juez, a la bajada y al reset de cada ranura, y `tcm_cierre.py` solo
    sigue los saltos con dirección. Con `j2-tcm`, `lanzar` comprueba que cada uno de esos punteros
    cae en la ITCM y, si no, se para con `j2_tcm: <cuál> fuera de la ITCM`. En placa, con
    `j2_banco` fuera del guion del enlazador, para con el juez en `0x341a681a`.
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2026-10-19 Papel v3: la cuarta pasada absorbida, con las fichas B, C, H e I para la firma
    B: 6 escaladas en 1 s y 1 ms de espera entre dos concedidas, que va con `Reiniciando` 14 ms
    porque la espera corre dentro de esa cota; la junta contesta que sí, que durante un bloqueo los
    resets necesitan espera. C: `Vencida` 25 ms y `Reiniciando` 14 ms, con el aserto del módulo
    contado como la máquina (`hueco_de_recuperacion`, 39,75 ms contra 49) y el que ata la espera
    con R-H1. H: R-H4 como obligación por símbolos, con `tcm_cierre.py`, la aseveración de los
    punteros y la medida en frío como puertas, y las obligaciones de arranque del hub. I: el CRC
    del sobre por tabla en la DTCM, medido más barato que la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
2026-10-20 El patrón del juez en la DTCM y la medida en frío de la ficha H como puerta
    Con `j2-tcm`, el juez del banco compara la subida con `PATRON_JUEZ`, un static en la DTCM; como
    `const`, el patrón se quedaba en el `.rodata` de la AXISRAM2 y era el único dato de solo lectura
    que el J2 leía en cada tic (lo demás que el código de la ITCM nombra en `.rodata` son las
    ubicaciones de los pánicos y los `RccInfo` del reset de una ranura).
    `carga_j2.csv` lleva la columna `cuerpos_por_giro`: los cuerpos del tic y del planificador por el
    DWT, por giro y ranura, de la pasada de la salida. Las filas del tic de 1d62576 la llevan de esa
    misma corrida (2 307 y 2 353); las del ejecutor, vacía.
    `recuperac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
2026-10-20 El sobre del J2 en core: codificar y decodificar con la tabla del CRC de quien llama
    `j2.rs` gana el sobre de seis bytes de la cabecera (D2): `SOBRE`, `Cabecera`,
    `ErrorTrama` con las dos causas de D8 que son del sobre (`Corta` y `Crc`),
    `codificar` y `decodificar`. El CRC es `crc16_con` con la tabla que pasa quien
    llama, como manda la enmienda del 19-10 a D2 y D9 (ficha I). Lo que sigue al
    CRC no se mira (R-C1) y la secuencia no rechaza (R-C3).
    La cabecera del módulo deja de decir «Contrato CONGELADO»: el contrato del
    enlace es el sobre, y el dialecto de 72 bits queda rotulado como el legado del
    módulo 3 v1, con sus tests sin tocar.
    `core/tests/j2.rs` lleva los tests 2, 3, 4, 12 y 15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
2026-10-20 La sesión del enlace: el receptor de la Voz rechaza todo sin HOLA y cuenta cada causa
    - dialecto_voz::Receptor: sin sesión, toda trama que no sea HOLA da
    ErrorTrama::SinSesion. Un HOLA con versión 1 y dialecto 1 abre la sesión
    (o la reabre): sesiones sube uno, las cuentas vuelven a cero y se espera
    la secuencia 1.
    - Un HOLA con otra versión o con otro dialecto da ErrorTrama::Tipo y cuenta
    en rechazadas_tipo; si había sesión, la cierra, para que el módulo
    publique su HOLA y el cerebro vea el desacuerdo.
    - Cuentas de D8: rechazadas_crc, rechazadas_forma (corta o forma),
    rechazadas_tipo (tipo, sin sesión, versión) y perdidas, los huecos de
    secuencia entre tramas aceptada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
2026-10-23 hardware: fuente v5, SHDN de U16 con pull-down, FLT de U19 al MSP430 y U19 con rueda libre
    - U16: R83 (47k) de SHDN a GND24. El pin tiene pull-up interno (2,48 a
    3,3 V en vacio, hasta 10 uA, tps2663.pdf p. 7): sin pull-down, U16
    encendia en cada enchufe, reset o sesion de programacion antes de que
    el MCU leyera la bandera de abandono de la FRAM.
    - U19: FLT a P1.2 del MSP430, con pull-up R84. No va al SHDN de U16: el
    TPS26631 baja FLT mientras su entrada esta en UVLO (p. 19) y U16 no
    arrancaria nunca.
    - U19: UVLO a IN_SYS por R82 (6,8M, p. 20). A GND elegia el umbral
    interno de 15,1 a 15,9 V (p. 6), por encima del riel de 15,5 V.
    - D19 (SS34) de OUT de U19 a GNDA: al abrir U19 la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
2026-10-23 hardware: fuente v5, lo que las puertas no cubren cita su issue
    check_absmax.py, recuperacion_budget.py y check_telemetria.py listan lo
    que su modelo deja fuera; cada punto lleva ahora el issue que lo sigue:
    - #475: fallo doble en el negativo (THN- en OVP y U2 en corto), U6/U7 a
    24,6 V contra 22 V.
    - #476: un crowbar de rack disparado no llega al MSP430 y el SCR conduce
    el pliegue del convertidor.
    - #477: sin retorno dedicado para la pantalla (T25).
2026-10-23 hardware: fuente v5, placa y fabricacion rehechas con el circuito nuevo
    La placa sale de build_pcb.py sobre la netlist con R82-R84 y D19, y fab/ y
    pcb/ de build_fab.py sobre esa placa:
    - 1509 pistas y 285 vias (72 termicas de U1/U2, 107 de masa cosidas).
    - Freerouting dejo 6 conexiones abiertas; rescate.py cerro las 6.
    - DRC (kicad-cli 10.0.3, todas las severidades, zonas rellenas y paridad
    con el esquematico): 0 infracciones, 0 sin conectar, 0 de paridad.
    Tres arreglos del generador:
    - rescate.py: GetConnectedItems() devuelve las vias como PCB_TRACK, asi
    que isinstance(item, PCB_VIA) no las veia y _anclas() las trataba como
    una pista de largo cero. Su GetWidth() sin capa tumba el p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
2026-10-23 hardware: fuente v5, el cordon baja a 2,87 A con la cascada a 450 mA
    Con D-F1 en 450 mA/riel, ladrillo_budget.corriente_del_cordon_a() pasa
    de 3,208 a 2,867 A en el peor caso y de 2,983 a 2,672 A a 24 V
    nominales. La banda baja de R11 (4,187 A) queda a 1,567 x la nominal y
    1,461 x el peor caso, contra 1,404 y 1,305 con 650; el 1,5 x sobre la
    nominal, que antes no cabia bajo los 4,875 A del TE90, ahora cabe. La
    banda de U19 (R34) pasa de 1,09 a 1,44 x la rama U1.
    Se corrigen las cifras copiadas en el docstring de recuperacion_budget.py,
    en la nota de la placa v5-B de la propuesta de piezas y en la enmienda
    de D-F1 de la spec del ladrillo.
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
